wecallemjazzyfact/TinyTapeout-BGR-LDO/docs/analog-specs.md

---
title: Analog Specs :: Quicker, easier and cheaper to make your own chip!
source: https://tinytapeout.com/specs/analog/
snapshot: 2026-07-10
---

[Tiny Tapeout](/) > [Tech specs](/specs/) > Analog Specs

# Analog Specs

## PDK

Tiny Tapeout shuttles use the sky130A, ihp-sg13g2, and gfmcu180D open source PDKs. Make sure you simulate with the correct PDK for your shuttle.

## Analog pins

The analog pins are labeled `ua[0]` through `ua[5]` (ua stands for “user analog”). The number of pins that will actually be connected to pads depends on the number of analog pins that you defined in the `pinout` section in info.yaml (and paid for).

For example, if you purchased two analog pins, only `ua[0]` and `ua[1]` will be connected to the pads. The remaining pins will **not be connected**.

You must use the pins in order, starting from 0.

Even though there are 8 pins in the templates, you can only use the first 6.

If you end up with pins which are not being driven and are floating, please either connect them to GND or use
[`conb`](https://skywater-pdk.readthedocs.io/en/main/contents/libraries/sky130_fd_sc_hd/cells/conb/README.html) cells -
see our guide on [laying out standard cells with Magic](/guides/laying-standard-cells-with-magic/).

## Specifications and limitations - sky130A

The path between the analog pads and your project (the ua pins) is expected to have the following properties:

* Resistance: < 500 ohm
* Capacitance: < 5 pf
* Max current: 4 mA

You are not allowed to use the **metal 5** layer in your design, as it’s used by Tiny Tapeout’s power grid.

## Pin locations

The pin locations must match one of the [Tiny Tapeout templates](https://github.com/TinyTapeout/tt-support-tools/tree/tt10/def/analog). The templates are available in DEF format, which is compatible with the [Magic VLSI layout tool](http://opencircuitdesign.com/magic/).

The templates include all the eight analog pins, but only the pins that you paid for will be connected to the pads. In addition, the templates also include all the [standard digital pins](/specs/gpio/).

**Important**: Do not leave any floating digital output pins in your design. Connect any unused `uo_out`, `uio_out` and `uio_oe` pins to GND.

## Area - sky130A

* 1x2 tiles = 160x225um
* 2x2 tiles = 334x225um

Note that these are approximate. 3.3v designs are slightly narrower as an additional power FET is required. Make sure to use our templates linked above.

## Power pins

The following power pins are available:

* VGND: Ground rail
* VDPWR: 1.8V digital core voltage
* VAPWR: 3.3V analog supply rail (optional, requires a different template)
* A draw of around 20mA from the power supply will result in a 0.1V drop through the PDN.

Power pins need to be vertical stripes on met4 layer and must adhere to the following rules:

1. Start within the bottom 10 µm of the module and extend at least to the top 10 µm of the module.
2. Minimum width of 1.2 um.
3. Projects utilizing the 3.3V rail MUST use the `tt_analog_*_3v3.def` templates and set `uses_3v3: true` in `info.yaml`.
4. Multiple power pins of each type can be used with varying dimensions as long as the above constraints are met.
5. The actual metal area can be larger or have a different shape, but the area defined as a pin must comply with these constraints.

## Pricing - sky130A

Projects with analog pins must be two tiles high. This means that the minimum price for the area of the project is 140€ (each tile is 70€).

In addition, there is a cost for each analog pin attributable to a given customer (rather than project) on a given shuttle. The price for analog pins is 40€ per pin for the first 2 pins you need on the Tiny Tapeout shuttle, and 100€ per pin for additional pins.

Example:

* You submit a design requiring 1x2 tiles and 2 analog pins. This costs you 220€ (140€ for the tiles, and 80€ for the analog pins).
* You then submit another design on the same shuttle, itself requiring 2x2 tiles and 3 analog pins. This would cost you 580€ (280€ for the tiles, and 300€ for the analog pins).
* i.e. as a customer you are using a total of **5** analog pins on the shuttle.

This price is only for including the design in the shuttle, and does not include the cost of the ASIC, PCB, or shipping.

For more information on pricing, check the [calculator](https://app.tinytapeout.com/calculator?tiles=2&pcbs=1&analog-pins=2).

---

# Instructions for creating and submitting an analog design

These instructions assume you are using the [Magic VLSI tool](http://opencircuitdesign.com/magic/), but you can do the same with Klayout or proprietary tools.

Make sure the version of Magic matches the PDK.

## Create the repository

Start your design from one of the following analog templates - make sure to select the appropriate template for the shuttle you’re targeting:

* [SKY](https://github.com/TinyTapeout/ttsky-analog-template)
* [IHP](https://github.com/TinyTapeout/ttihp-analog-template)

Click on the green “Use this template” button on the top of the page, and select “Create a new repository”.

## Decide on the size of your design

Tiny Tapeout provides templates for custom GDS submissions. These templates include all the required pins on the metal 4 layer. Do not change the pin sizes or positions.

Select your target shuttle below and download a template to use as a starting point for your design.

SKY
IHP

Download: [github.com/TinyTapeout/tt-support-tools/tree/main/tech/sky130A/def/analog](https://github.com/TinyTapeout/tt-support-tools/tree/main/tech/sky130A/def/analog)

The table below shows the available templates:

| Tile size | Filename | Available power supplies | |
| --- | --- | --- | --- |
| 1.8V (VDPWR) | 3.3V (VAPWR) |
| 1x2 | `tt_analog_1x2.def` | ✅ | ❌ |
| `tt_analog_1x2_3v3.def` | ✅ | ✅ |
| 2x2 | `tt_analog_2x2.def` | ✅ | ❌ |
| `tt_analog_2x2_3v3.def` | ✅ | ✅ |

Download: [github.com/TinyTapeout/tt-support-tools/tree/main/tech/ihp-sg13g2/def/analog](https://github.com/TinyTapeout/tt-support-tools/tree/main/tech/ihp-sg13g2/def/analog)

The table below shows the available templates:

| Tile size | Filename | Available power supplies | |
| --- | --- | --- | --- |
| 1.8V (VDPWR) | 3.3V (VAPWR) |
| 1x2 | `tt_analog_1x2.def` | ✅ | ❌ |
| 2x2 | `tt_analog_2x2.def` | ✅ | ❌ |

Larger tiles are not shown in these tables but may be available via the provided link. They follow the same
pattern as the ones mentioned above (i.e. a `_3v3` suffix denotes that VAPWR is available).

An analog project can either be 1x2 or 2x2 tiles large. If you require additional space, you will be
charged as if you had submitted multiple 1x2/2x2 projects separately. Read our [FAQ item](/faq/#what-is-an-analog-slot)
for more info.

## Edit the info.yaml file

It’s important that you are consistent with your naming. The name of the project must match the final GDS and LEF files.

Decide on a name for your module (top cell). The top level module name must start with ’tt\_um\_’, and it must be unique on the shuttle, so we suggest including your github username, e.g. tt\_um\_username\_amazing\_adc.

Edit the `info.yaml` files and the the following properties:

* `top_module` - the name of your top module
* `tiles` - should match your selected template size (1x2 or 2x2)
* `analog_pins` - the number of analog pins you use
* `pinout` - describe the function of each digital / analog pin you use, leave the others empty ("")
* Also fill in the title, author and description fields.

## Edit the verilog stub

This file is used to ‘blackbox’ your design when we integrate it into the Tiny Tapeout shuttle.

Edit `src/project.v` and replace `tt_um_example` with the actual name of your top module.

## Documentation

Edit `docs/info.md` and add a description of your project.

## Draw the rest of the owl

Use your preferred analog flow to design, simulate, layout, extract, LVS and post layout simulate.

A quick way to get started is to use this [tcl script](https://github.com/TinyTapeout/tt-support-tools/blob/tt10/def/analog/magic_init_project.tcl) to draw and label the power ports.

* Download the script
* Edit it to change the module name and configure the pin template and power stripes
* Start Magic and in the tcl command window, write `source magic_init_project.tcl`

## Resources

* Matt’s [Zero to ASIC analog course](https://zerotoasiccourse.com/analog)
* [Drawing an inverter with Magic by Ryan Ridley, Teo Ene, and James E. Stine](https://docs.google.com/document/d/1hSLKsz9xcEJgAMmYYer5cDwvPqas9_JGRUAgEORx1Yw/edit#heading=h.j6gtadx04fb6)
* [Magic cheatsheet by Harald Pretl](https://github.com/iic-jku/osic-multitool/blob/main/magic-cheatsheet/magic_cheatsheet.pdf)
* [Circuit designers etiquette by Harald Pretl](https://github.com/iic-jku/Circuit-Designers-Etiquette)
* [Xschem tutorial by Stefan Schippers (video)](https://www.youtube.com/watch?v=q3ZcpSkVVuc)
* [Analog tutorials by Carsten Wulff (video)](https://www.youtube.com/playlist?list=PLybHXZ9FyEhZfwQTKrLhm6ZZm4IDfGGla)
* [Analog design flow by Carsten Wulff](https://analogicus.com/rply_ex0_sky130nm/tutorial)
* [Analog tutorials by BMinch (video)](https://www.youtube.com/watch?v=iLY49tnKbz4)
* [Magic layout demonstration by Tim Edwards (video)](https://youtu.be/XvBpqKwzrFY?si=AyL0Wr3V4gb954yx)

## Export the GDS and LEF files

Save the resulting GDS file in the `gds` folder, and the LEF file in the `lef` folder. The file names must match your `top_module` property (e.g. `gds/tt_um_example.gds`).

If you use Magic to create your design, make sure to export the LEF file with the “-pinonly” option, e.g.:

```
lef write ../lef/tt_um_project_name.lef -pinonly
```

Export the GDS by running:

```
gds write ../gds/tt_um_project_name.gds
```

If you’re using Magic - do not flatten the .mag file, leave it hierarchical to avoid weird DRC issues.

## Submit your design

Go to [app.tinytapeout.com](https://app.tinytapeout.com) to submit your design.
