wecallemjazzyfact/TinyTapeout-BGR-LDO/designs/bgr_ldo/NOTES.md

# TinyTapeout 아날로그 (BGR + LDO) 제출 하드 제약 사항 및 프로젝트 고정 사양

이 문서는 TinyTapeout 아날로그 프로젝트 규격 문서 및 제출 템플릿에 명시된 하드웨어적/설정상 제약 규칙을 원문 그대로 인용하여 정리하고, 우리 BGR+LDO 프로젝트의 고정 설계 사양을 명시합니다.

---

## 📋 1. 아날로그 제출 하드 제약 사항 표 (원문 인용)

| 제약 사항 구분 | 공식 규격 및 규칙 내용 (원문 그대로 인용) | 출처 파일명 |
| :--- | :--- | :--- |
| **사용 가능 아날로그 핀 `ua[]` 개수 및 순서** | <ul><li>`Even though there are 8 pins in the templates, you can only use the first 6.`</li><li>`You must use the pins in order, starting from 0.`</li><li>`only ua[5:0] can be used`</li><li>`The number of pins that will actually be connected to pads depends on the number of analog pins that you defined in the pinout section in info.yaml (and paid for). For example, if you purchased two analog pins, only ua[0] and ua[1] will be connected to the pads. The remaining pins will not be connected.`</li><li>`If you end up with pins which are not being driven and are floating, please either connect them to GND or use conb cells`</li><li>`Resistance: < 500 ohm`</li><li>`Capacitance: < 5 pf`</li><li>`Max current: 4 mA`</li></ul> | `analog-specs.md`<br>`project.v` |
| **파워 핀 (VDD/VAPWR/VGND) 규칙** | <ul><li>`VGND: Ground rail`</li><li>`VDPWR: 1.8V digital core voltage`</li><li>`VAPWR: 3.3V analog supply rail (optional, requires a different template)`</li><li>`A draw of around 20mA from the power supply will result in a 0.1V drop through the PDN.`</li><li>`Power pins need to be vertical stripes on met4 layer and must adhere to the following rules:`<br>`1. Start within the bottom 10 µm of the module and extend at least to the top 10 µm of the module.`<br>`2. Minimum width of 1.2 um.`<br>`5. The actual metal area can be larger or have a different shape, but the area defined as a pin must comply with these constraints.`</li><li>**[누락 주의]** 원문 규격의 met4 3번, 4번 규칙이 현재 표 인용에서 누락되었으므로, 레이아웃 진입 전에 공식 원문 문서를 파악하여 전체 규칙(1~5번)을 재확보 및 검증해야 함.</li></ul> | `analog-specs.md` |
| **3.3V 레일 사용 조건** | <ul><li>`3. Projects utilizing the 3.3V rail MUST use the tt_analog_*_3v3.def templates and set uses_3v3: true in info.yaml.`</li><li>`uses_vapwr: false # Set to true if your project uses second analog power supply (VAPWR) in addition to 1.8V (VDPWR)`</li><li>**[잠정 결론]** `uses_vapwr: true`로 설정하고 `_3v3.def` 템플릿을 사용함. 공식 문서(`analog-specs.md`)의 `uses_3v3: true` 표기는 구버전 양식으로 추정됨.</li></ul> | `analog-specs.md`<br>`info.yaml` |
| **금지 메탈층 및 파워핀 메탈층** | <ul><li>금지 레이어: `You are not allowed to use the metal 5 layer in your design, as it’s used by Tiny Tapeout’s power grid.`</li><li>파워핀 레이어: `Power pins need to be vertical stripes on met4 layer`</li></ul> | `analog-specs.md` |
| **아날로그 타일 크기** | <ul><li>`An analog project can either be 1x2 or 2x2 tiles large.`</li><li>`Projects with analog pins must be two tiles high.`</li><li>`1x2 tiles = 160x225um`</li><li>`2x2 tiles = 334x225um`</li><li>`3.3v designs are slightly narrower as an additional power FET is required. Make sure to use our templates linked above.`</li><li>**[설계 메모]** 3.3V 전원 사용 시 power FET 레이아웃으로 인해 1x2 타일 가용폭이 $160\,\text{µm}$보다 좁아집니다. 만약 1x2 타일에 아날로그 회로가 전부 올라가지 않는 경우, 2x2 타일 크기 ($334\times225\,\text{µm}$) 사용을 고려해야 합니다.</li></ul> | `analog-specs.md` |
| **디지털 핀 규칙 및 플로팅 방지** | <ul><li>디지털 포트 구성: `input wire [7:0] ui_in`, `output wire [7:0] uo_out`, `input wire [7:0] uio_in`, `output wire [7:0] uio_out`, `output wire [7:0] uio_oe`</li><li>디지털 핀 제약: `Drive strength (source/sink) | 4 mA`, `Maximum output frequency | 33 MHz`, `Maximum input frequency | 66 MHz`, `IO supply voltage * | 1.71V - 5.5V` (`* The demo board provides 3.3V IO supply voltage. The input pins are not 5V tolerant.`)</li><li>플로팅 방지 규칙: `Important: Do not leave any floating digital output pins in your design. Connect any unused uo_out, uio_out and uio_oe pins to GND.`</li></ul> | `analog-specs.md`<br>`project.v`<br>`gpio.md` |
| **info.yaml 필수 키 및 주석 의미** | <ul><li>`title: "" # Project title`</li><li>`author: "" # Your name`</li><li>`description: "" # One line description of what your project does`</li><li>`language: "Analog" # other examples include Verilog, Amaranth, VHDL, etc`</li><li>`clock_hz: 0 # Clock frequency in Hz (or 0 if not applicable)`</li><li>`tiles: "1x2" # Valid values for analog projects: 1x2, 2x2`</li><li>`analog_pins: 2 # Valid values: 0 to 6`</li><li>`uses_vapwr: false # Set to true if your project uses second analog power supply (VAPWR) in addition to 1.8V (VDPWR)`</li><li>`top_module: "tt_um_example" # Your top module name must start with "tt_um_". Make it unique by including your github username:`</li><li>`source_files: # List your project's source files here. Source files must be in ./src and you must list each source file separately, one per line:`</li><li>`pinout: # The pinout of your project. Leave unused pins blank. DO NOT delete or add any pins.`</li><li>`yaml_version: 6 # Do not change!`</li></ul> | `info.yaml` |

---

## 🎯 2. 우리 프로젝트 고정 사양 (Project Specifications)

우리 BGR + LDO 통합 아날로그 IP 프로젝트의 고정 하드웨어 설계 명세입니다.

### 2.1. 1단계/2단계 공정 산포 대응 전략 (2-Stage Variation Mitigation)
* **1차 대응 (Layout Matching):** Common-centroid 매칭 배치, Dummy 소자 가드, Guard-ring 분리 및 웰 격리를 통해 기생 성분 및 레이아웃 불일치를 근본적으로 최소화하는 것을 우선으로 함.
* **2차 대응 (Digital Trimming):** 공정 코너 산포($ss/ff$) 및 오차 증폭기의 정적 입력 오프셋(Input Offset)으로 인한 출력 편차를 제거하기 위해 디지털 트림 회로를 내장함.
* **제어 방식:** 3.3V 아날로그 블록의 면적과 패드 제한을 고려하여 외부 디지털 입력 핀(`ui_in`)을 사용하되, 입력단에 Level Shifter를 추가 장착하여 아날로그 전용 핀 소모를 방지하고 제어함.

### 2.2. BGR (Bandgap Reference)
* **목표 기준 전압 ($V_{ref}$):** $1.2\,\text{V}$ 고정.
* **BGR 코어 정합 저항비:** $R_2 = 2 \cdot R_1$ 준수.
* **최소 동작 전원 전압 ($V_{min}$ 실측):** tt/27 $2.190\,\text{V}$ / ss−40 $2.380\,\text{V}$ / ff125 $2.050\,\text{V}$ ($V_{ref}$ 95% 유지 하한). 내림($3.3 \rightarrow 1.5\,\text{V}$) 및 올림($1.5 \rightarrow 3.3\,\text{V}$) 스윕이 100% 동일하여 히스테리시스 창 없음 (DC 영역에 축퇴 함정 두 안정해 공존 구간 미존재 증명). 최악 코너(ss/−40) 기준 $VAPWR = 3.0\,\text{V}$ 대비 마진 **`+620 mV`** 확보.

#### BGR 설계 목표 스펙
| 스펙 | 목표 | 근거/비고 |
| :--- | :--- | :--- |
| $V_{ref}$ | $1.2\,\text{V}$ | LDO 분압 $R_2=2R_1$ (→ $1.8\,\text{V}$)과 일관 |
| TC ($-40\sim125^\circ\text{C}$) | $< 50\,\text{ppm}/^\circ\text{C}$ (전 코너) | tt: 7.5 ppm/°C, ss: 8.6 ppm/°C, ff: 9.0 ppm/°C (전 코너 균일화 완료) |
| Line regulation | $< 0.5\,\%\text{/V}$ | 0.0834 %/V (실측치, VAPWR 3.0~3.6V) |
| PSRR @DC | $< -40\,\text{dB}$ | cascode + 후단 LDO |
| $I_Q$ (BGR only) | $< 60\,\text{µA}$ | 59.71 µA @tt/27 (실측치, 탭 제외 코어 기준) [1] |
| Startup time | $< \text{수 µs}$, 확정 기동 | 축퇴점 회피 ($V_{min}$ tt 2.190V / ss-40 2.380V) |
| Area (BGR only) | $\le 3000\,\text{µm}^2$ | 1x2에 여유 (미스매치 감축을 위한 면적 4배 스케일링 반영) [2] |

`[1] 개정 사유: TC 최적화 분석 결과 브랜치당 ~10µA의 바이어스 전류가 요구됨에 따라 코어2+출력1+bias1 분기 합산 55µA 소모에, Line Reg 개선을 위한 cascode bias 신규 분기(+1.2µA) 및 core 면적 스케일링에 따른 기생 증가(+3.53µA)가 추가되어 총 59.71µA가 소모됨 (소비전력 197.0µW @3.3V). IB_EA 탭 전류 2.564 µA는 EA 계정으로 이관되며 BGR 블록의 물리 총소모 전류는 62.27 µA.`
`[2] 개정 사유: 몬테카를로 분석 결과 로컬 미스매치(MM)의 분산 기여도가 91.5%로 지배적임을 판명하고, Pelgrom 법칙에 근거해 핵심 트랜지스터(XM_top*, XM3/XM4)들의 면적을 4배(W, L 각각 2배씩) 확장하여 약 +960 µm² 면적이 추가 가산됨.`

#### BGR 설계 결정 사항
* **검증 조건:** 27°C 단일 온도 분석에 그치지 않고, **$-40 / 27 / 125^\circ\text{C} \times \text{코너(ss/tt/ff)}$** 조합 전체로 검증 수행.
* **소자 선택 (Devices):** BGR 코어 mirror는 저전압 고이득 매칭을 위해 **1.8V 소자(`nfet_01v8` / `pfet_01v8_lvt`)**를 사용하고, 3.3V(`VAPWR`)가 직접 인가되는 노드만 thick-oxide인 **`_g5v0d10v5`** 소자 사용.
* **Mirror 설계:** 고정밀 정합 및 미러 계수 안정성을 위해 **$V_{ov} \approx 120\sim150\,\text{mV}$ (저속/고정밀)**, **$L = 0.5\sim1.0\,\text{µm}$**로 설정하여 출력 저항($r_o$) 및 정합성을 개선하고, $W$는 pygmid(gm/Id 툴)를 사용해 역산하여 설계.
* **저항 소자:** 온도 보상 및 정밀도 정합을 위해 BGR 내부 저항($R_1$, $R_6$, $R_7$, $R_L$)은 모두 **`sky130_fd_pr__res_high_po`** 소자로 통일.
* **PNP BJT:** **`pnp_05v5_W0p68L0p68`** 사용. $Q_1 (m=1)$ / $Q_2 (m=8)$ 구조로 배치하며 에미터가 위쪽 노드이고 베이스와 컬렉터는 `VGND`에 접지.
* **참고 문헌/교재:** Razavi (기본 이론 및 원리) + Baker Ch. 20 (구현 및 레이아웃 매칭 기법)

### 2.2.1. BGR TRIM 극성 및 소프트웨어 코드 반전 폐기 (LDO top 하드웨어 반전)
★ **소프트웨어 코드 반전 지시 취소** (REPLY_LDO_TO_BGR_STARTUP_CLAMP §5).
LDO top 에 인버터 4쌍(thin-ox nfet W2/L0.15 + pfet W4/L0.15, VDPWR 급전)이 들어가 하드웨어로 반전합니다. 소프트웨어에서 추가 반전 금지 — 이중 반전 시 ui_in=0000 이 다시 최대 전압이 되어 위험합니다.

* **사유**: TT 멀티플렉서 기본값이 ui_in=0 이고, BGR 극성상 code0 = V_out 최대라 트림 전 기본 상태가 정상상태로 1.95V 초과(ff/27 1.994V). 과도가 아니라 지속 상태이므로 소프트웨어 규약으로 방어 불가 → 하드웨어 반전 채택.
* **확정 매핑** (LDO top 기준, 직관과 일치):
  * ui_in[3:0] = 0000 → gr_core TRIM = 1111 → {out}$ 최소 (1.671 V, 안전 기본값)
  * ui_in[3:0] = 1111 → gr_core TRIM = 0000 → {out}$ 최대 (1.929 V)
  * $
ightarrow$ ui_in 값이 커질수록 {out}$ 증가. 측정 스크립트는 ui_in 0→15 단조 증가 확인.
* **BGR 내부 극성 불변**: gr_core 는 TRIM=1 → 세그먼트 단락 → $ 감소 → {out}$ 감소.

### 2.3. LDO (Low-Dropout Regulator)
* **입력 전압 ($V_{in}$ / $VAPWR$):** $3.3\,\text{V}$ (3.3V analog supply rail).
* **출력 전압 ($V_{out}$):** $1.8\,\text{V}$ 고정.
* **LDO 트림 불요 판정 근거:**
  * BGR $V_{ref}$의 3-sigma 산포($\pm 7.1\%$)가 전체 오프셋을 지배하며, 폐루프 게인 $1.5$를 거쳐 $V_{out}$으로 그대로 전달되므로 BGR의 5-bit 트림이 $V_{ref}$와 $V_{out}$을 동시에 보정합니다.
  * LDO 고유 오차(분압 저항 미스매치 ~$\pm 0.5\%$, EA 정적 오프셋 ~$\pm 1\%$)는 BGR 트림 후 잔여 오차($\pm 0.24\%$)와 RSS 합산 시 약 $\pm 1.2\%$ 수준으로 통상 $\pm 2.0\%$ 스펙 범위에 여유 있게 수용됩니다.
  * 만약 향후 LDO 전용 독립 트림이 요구되더라도, `uio[1:7]` 7개 디지털 IO 핀이 미사용 예비 상태로 보존되어 있어 하드웨어적 유연성을 확보했습니다.
* **최대 부하 전류 ($I_{load, max}$):** $4\,\text{mA}$ (하드웨어 제약 및 패드 와이어 한계 준수).
* **소모 전류 ($I_Q$, LDO 자체):** $\le 10\,\mu\text{A}$ 목표.

#### LDO 설계 목표 스펙 및 물리적 근거

| 파라미터 | 목표 스펙 | 설계 근거 / 비고 |
| :--- | :---: | :--- |
| **Dropout 전압 ($V_{drop}$)** | $\le 200\,\text{mV}$ | 실구동 조건은 $V_{SD} = 1.5\,\text{V}$로 충분한 Saturation 마진 확보 가능. |
| **Line Regulation** | $\le 2.0\,\text{mV/V}$ | $VAPWR = 3.0\text{V} \sim 3.6\text{V}$ 스윕 기준. EA의 높은 DC Gain으로 억제. |
| **Load Regulation** | $\le 2.0\,\text{mV/mA}$ | $I_{load} = 0 \sim 4\text{mA}$ 기준. 전체 전압 변동 $\Delta V_{out} \le 8\,\text{mV}$ 목표. |
| **PSRR @DC / 1kHz / 100kHz** | $\le -60\,\text{dB} / -50\,\text{dB} / -30\,\text{dB}$ | BGR 출력을 1차 필터링하고 EA 루프 이득 및 Compensation 대역 설계로 제거. |
| **위상 마진 (Phase Margin)** | $\ge 60^\circ$ | 무부하($I_{load}=0$)부터 최대 부하($4\,\text{mA}$) 전 구간 루프 안정성 보장. |
| **Transient Response** | Overshoot/Undershoot $\le 100\,\text{mV}$ | $0 \leftrightarrow 4\,\text{mA}$ Step (엣지 $100\,\text{ns}$), $C_L = 100\,\text{pF}$ 및 복구 시간 $< 5\,\mu\text{s}$. |

#### 2.3.1. Pass Device (PMOS) 사이징 및 기생 커패시턴스 분석
* **소자 종류:** Thick-oxide PMOS (`pfet_g5v0d10v5`)
* **사이징 확정:** **`W = 400 µm / L = 0.5 µm`** (Aspect Ratio $W/L = 800$, Multiplier $M = 20$, Finger $W_f = 20\,\mu\text{m}$)
* **물리적 계산 검증:**
  * Saturation 전류 수식: $I_D = \frac{1}{2} \mu_p C_{ox} \frac{W}{L} V_{ov}^2$
  * $\mu_p C_{ox} \approx 30\,\mu\text{A/V}^2$ 대입 시 $I_{load} = 4\,\text{mA}$ 구동에 필요한 Overdrive 전압:
    $$4000\,\mu\text{A} = \frac{1}{2} \times 30\,\mu\text{A/V}^2 \times 800 \times V_{ov}^2 \implies V_{ov} \approx \mathbf{0.577 V}$$
  * 따라서 최대 부하 시 필요한 게이트 바이어스 전압은 $V_G = V_{APWR} - |V_{thp}| - V_{ov} \approx 3.3 - 0.9 - 0.58 = \mathbf{1.82 V}$로, 3.3V 구동 오차 증폭기의 전압 출력 스윙 범위 내에 여유롭게 들어옵니다.
* **게이트 입력 커패시턴스 ($C_{gg}$) 추정:**
  * 산화막 커패시턴스 $C_{ox} \approx 2.3\,\text{fF/\mu m}^2$ (Gate oxide $t_{ox} \approx 15\,\text{nm}$)
  * 채널 면적 $A_g = W \times L = 400 \times 0.5 = 200\,\mu\text{m}^2$
  * 게이트 커패시턴스: $C_{gg, body} = A_g \times C_{ox} \approx 460\,\text{fF}$
  * 기생 오버랩 및 배선 커패시턴스 합산 시 실효 부하 커패시턴스 **$C_{gg, total} \approx \mathbf{0.5\sim0.6\,\text{pF}}$** (EA의 지배적 출력 극점을 형성).

### 2.4. 오차 증폭기 (Error Amplifier - EA) 설계 방침
* **급전 전압:** $VAPWR$ ($3.3\,\text{V}$).
* **구조 제안:** **PMOS 입력 Folded-Cascode 증폭기**
* **입력 공통모드 범위(ICMR) 검증:**
  * $V_{ref} = 1.2076\,\text{V}$에서 입력 PMOS의 소스 노드 전위는 $V_S = V_G + V_{SG} \approx 1.2 + 0.9 + 0.2 = 2.3\,\text{V}$로 바이어스됩니다.
  * 테일 전류원(Tail current source)에 걸리는 전압은 $V_{APWR} - V_S = 3.3 - 2.3 = 1.0\,\text{V}$로, 테일 소자가 포화 영역에 머물기 위한 전압($V_{ov,tail} \approx 0.2\text{V}$) 대비 5배의 전압 헤드룸을 가집니다. 따라서 PMOS 입력단 설계는 지극히 타당합니다.
* **필요 DC 이득 ($A_{EA}$) 계산:**
  * 목표 Load Regulation 사양인 $\le 2\,\Omega$ ($8\text{mV}/4\text{mA}$) 충족을 위해 필요한 Closed-loop 출력 저항 유도:
    $$R_{out, cl} = \frac{R_{out, ol}}{1 + T} \approx \frac{r_{ds, pass}}{T} \le 2\,\Omega$$
  * Pass 소자의 출력 저항 $r_{ds, pass} \approx 2.5\,\text{k}\Omega$ ($I_D = 4\text{mA}, \lambda \approx 0.1\text{V}^{-1}$) 대입 시 필요한 최소 루프 이득:
    $$T \ge \frac{2500\,\Omega}{2\,\Omega} = 1250\ (\approx \mathbf{62\,\text{dB}})$$
  * 루프 이득 수식 $T = A_{EA} \times A_{pass} \times \beta$ 에서 $A_{pass} = g_{m,pass} r_{ds,pass} \approx 14\text{mS} \times 2.5\text{k}\Omega = 35$ ($31\,\text{dB}$), 피드백 계수 $\beta \approx 0.67$ 대입:
    $$A_{EA} = \frac{1250}{35 \times 0.67} \approx 53.4\ (\approx \mathbf{35.6\,\text{dB}})$$
  * Folded-cascode 토폴로지는 통상 **$60\sim80\,\text{dB}$**의 이득을 제공하므로 스펙 마진을 매우 넉넉하게 만족합니다.

### 2.5. 안정도 및 주파수 보상 사전 분석 (Stability & Compensation)
* **극점 (Poles) 이동 분석 ($C_{load} = 100\,\text{pF}$ 기준):**
  1. **무부하 상태 ($I_{load} \rightarrow 0$):** 피드백 전류 $5\,\mu\text{A}$만 흐를 때, $r_{ds,pass} \approx 2\,\text{M}\Omega$.
     * 출력 저항 $R_{out} \approx 2\,\text{M}\Omega \parallel 360\,\text{k}\Omega \approx 305\,\text{k}\Omega$.
     * 출력 극점 $p_{out, noload} = \frac{1}{2\pi R_{out} C_{load}} \approx \mathbf{5.2\,\text{kHz}}$
  2. **최대 부하 상태 ($I_{load} = 4\,\text{mA}$):** 부하 저항 $R_{load} = 450\,\Omega$.
     * 출력 저항 $R_{out} \approx 450\,\Omega \parallel 2.5\,\text{k}\Omega \approx 380\,\Omega$.
     * 출력 극점 $p_{out, fullload} = \frac{1}{2\pi R_{out} C_{load}} \approx \mathbf{4.19\,\text{MHz}}$ (부하 변동에 의해 극점이 **800배 이상 이동**).
  3. **EA 출력 극점:** $p_{EA} = \frac{1}{2\pi R_{out,EA} C_{gg,pass}} \approx \mathbf{16\,\text{kHz}}$ ($R_{out,EA} \approx 20\,\text{M}\Omega, C_{gg} \approx 0.5\text{pF}$).
* **주파수 보상망 제안 (밀러 보상):**
  * 두 극점($p_{out}, p_{EA}$)이 모두 저주파 대역에 인접해 있어 무보상 시 발진이 불가피합니다.
  * Pass 소자의 게이트-드레인 사이에 밀러 커패시터 $C_c$ 및 우반평면 영점(RHP Zero) 제거용 직렬 영점 저항 $R_z$를 삽입합니다.
  * **밀러 캡 크기 ($C_c$):** **`Cc = 12.8 pF`** (대역폭 확보 및 상온 안정성 마진 극대화).
  * **영점 저항 ($R_z$):** 가벼운 부하 조건에서의 위상 지연을 방지하기 위해 $R_z \approx 1/g_{m,pass} \approx 1\sim5\,\text{k}\Omega$ 수준의 가변 또는 고정 Poly 저항을 배치하여 LHP(Left-Half-Plane)로 영점을 이동 및 보상합니다.

### 2.6. 제어 및 모니터링 인터페이스 (PG / EN)
* **EN (LDO Enable 신호):** 외부 디지털 핀 `ui_in[]`을 사용하여 컨트롤. (Level Shifter를 경유하여 3.3V EA 구동부 EN 게이트 전달)
* **PG (Power Good 신호):** LDO 출력이 안정 영역에 도달했음을 알리는 디지털 핀 `uo_out[]`을 통해 전송.

---

## 🛠️ 3. Verification & Layout Lessons Learned (레이아웃 및 검증 교훈)

### 3.1 레이아웃 크기 및 경계 (Boundary) 제약
* **물리적 크기 제약 (3.3V Analog):** 
  * TinyTapeout의 precheck (KLayout Checks 및 Pin check)를 통과하려면 GDS 레이아웃 경계가 DEF 템플릿의 정확한 다이 영역 크기와 일치해야 합니다.
  * 3.3V 아날로그 1x2 타일의 경우, 파워 트랜지스터(Power FET) 배치 공간으로 인해 폭이 다소 좁아져 **정확히 가로 $145.36\,\text{µm}$ (145360 DEF units), 세로 $225.76\,\text{µm}$ (225760 DEF units)** 크기로 맞춰야 합니다.
  * 따라서 레이아웃을 시작할 때 반드시 `tt_analog_1x2_3v3.def` 파일을 Magic으로 읽어(`def read tt_analog_1x2_3v3.def`) 경계(Boundary), Met4 파워 스트라이프 및 핀 위치 프레임을 생성하고 그 내부에서 레이아웃을 수행해야 합니다.

### 3.2 컨테이너 기반 LVS/DRC 검증 실행법
컨테이너 내에서 JKU 제공 레이아웃 검증 도구(`iic-drc.sh`, `iic-lvs.sh`) 및 TinyTapeout `precheck.py`를 실행할 때는, 환경 변수(`$PDK`, `$PDKPATH`)와 실행 파일 경로가 꼬이지 않도록 **반드시 로그인 쉘(`bash -l -c`) 옵션**과 함께 아래의 포맷으로 명령어를 전달해야 합니다.

* **TinyTapeout Precheck 실행 명령어:**
  `precheck.py`는 내부에서 `magic_drc.tcl` 등의 상대 경로 파일을 호출하므로 반드시 `tt/precheck` 폴더로 이동한 후 실행해야 하며, GDS 경로는 절대 경로를 사용하는 것이 안전합니다.
  ```bash
  docker exec -i iic-osic-tools_xvnc_uid_1000 bash -l -c "cd /foss/designs/tt-analog/repos/ttsky-analog-template/tt/precheck && export PDK=sky130A && python3 precheck.py --gds /foss/designs/tt-analog/repos/ttsky-analog-template/gds/tt_um_example.gds --tech sky130A"
  ```

* **JKU DRC (`iic-drc.sh`) 실행 명령어:**
  Magic과 KLayout DRC를 동시에 가동합니다.
  ```bash
  docker exec -i iic-osic-tools_xvnc_uid_1000 bash -l -c "export PDK=sky130A && export PDKPATH=/foss/pdks/sky130A && iic-drc.sh -b -w /foss/designs/designs/bgr_ldo/work /foss/designs/designs/bgr_ldo/layout/tt_um_bgr_ldo.gds"
  ```

* **JKU LVS (`iic-lvs.sh`) 실행 명령어:**
  xschem 회로도(`.sch` 또는 사전 추출된 `.spice`)와 layout GDS를 대조하여 핀 정합성을 확인합니다.
  ```bash
  docker exec -i iic-osic-tools_xvnc_uid_1000 bash -l -c "export PDK=sky130A && export PDKPATH=/foss/pdks/sky130A && iic-lvs.sh -w /foss/designs/designs/bgr_ldo/work -s /foss/designs/designs/bgr_ldo/src/tt_um_bgr_ldo.sch -l /foss/designs/designs/bgr_ldo/layout/tt_um_bgr_ldo.gds -c tt_um_bgr_ldo"
  ```

---

### 3.3 레이아웃 인계 (LVS 결과 및 더미 최종값)

* **LVS 결과**: **Circuits match uniquely** (44/44 소자, 32/32 넷)
* **더미 저항 최종 L (magic 추출값 반영)**:
  * XXDUM_RA1, XXDUM_RA2 : **L=31.49** (구 30.23)
  * XXDUM_RB1, XXDUM_RB2 : **L=58.41** (구 57.15)
* **정정 사유**: 더미는 X Repeat=2(굴곡 1개)인데 N=8 보정식을 쓴 초기값이라 굴곡 고정항 +1.26 µm 가 누락됐다. 실소자는 N=8 보정식이 이미 맞아 무관.
* **전기적 무영향 실측**: 정정 전후 V_ref/IB_EA/I_Q 6자리 불변.

## 📊 4. BGR PNP Core Simulation Results

BGR 설계의 핵심 요소인 BJT 코어 단일 소자의 $V_{BE}$ 전압 특성 및 $1:8$ 소자쌍의 $\Delta V_{BE}$ 전압 특성을 시뮬레이션으로 검증한 실측 결과 기록입니다.

### 4.1. Testbench 1: 단일 PNP $V_{BE}$ 특성 (`pnp_vbe`)
* **시뮬레이션 조건 (Simulation Setup):**
  * **대상 소자 (DUT):** `sky130_fd_pr__pnp_05v5_W0p68L0p68` ($m=1$)
  * **결선 형태:** 다이오드 연결 (Collector와 Base를 모두 `VGND`(= 전역 접지 `0`)에 연결, Emitter를 능동 노드로 활용)
  * **바이어스 공급:** 3.3V DC 전원원($V_1$)을 급전하여, 이상 전류원($I_0$)을 통해 Emitter 단자에 전류를 주입
  * **시뮬레이션 타입:** DC 전류 스윕 (`.dc I0 1u 10u 0.1u`) 및 온도 고정 ($27^\circ\text{C}$)
* **검증 및 측정 결과:**
  * **바이어스 동작점:** 브랜치당 설계 목표 바이어스 전류인 **$I_0 = 3.0\,\text{µA}$**에서 에미터-베이스 다이오드 전압 $V_{BE}$ 측정
  * **측정 전압 ($vbe\_val$):** **$774.05\,\text{mV}$** ($0.774052\,\text{V}$)
* **물리적 의미:**
  * 본 설계의 CTAT(Complementary to Absolute Temperature) 브랜치의 기준 $V_{BE}$ 기저 동작 수준을 정의합니다.

### 4.2. Testbench 2: $1:8$ 매칭 $\Delta V_{BE}$ 특성 (`delta_vbe`)
* **시뮬레이션 조건 (Simulation Setup):**
  * **대상 소자 (DUT):** 
    * `QA` ($m=1$): `pnp_05v5_W0p68L0p68`
    * `QB` ($m=8$): `pnp_05v5_W0p68L0p68`
  * **바이어스 공급:** 각 BJT의 에미터에 독립적인 동일 스펙의 이상 전류원($I_0 = 3\,\text{µA}$, $I_1 = 3\,\text{µA}$)을 배치하여 정전류 공급
  * **시뮬레이션 타입:** 온도 스윕 (`.dc temp -40 125 5`)
  * **수식 정의:** $\Delta V_{BE} = V_{BE1} (m=1) - V_{BE8} (m=8)$
* **검증 및 측정 결과:**
  * **측정 전압 ($dvbe\_27$):** **$53.02\,\text{mV}$** ($5.30196 \times 10^{-2}\,\text{V}$) @ $27^\circ\text{C}$ ($300.15\,\text{K}$)
  * **이론 수식 대조:**
    $$\Delta V_{BE} = V_T \ln(N) = \frac{k T}{q} \ln(8)$$
    $T = 27^\circ\text{C}$ ($300.15\,\text{K}$) 조건 하에:
    $$\Delta V_{BE, \text{이론}} = 25.865\,\text{mV} \times \ln(8) \approx 25.865\,\text{mV} \times 2.07944 \approx 53.78\,\text{mV}$$
    * **오차율:** 실측 시뮬레이션 값($53.02\,\text{mV}$)은 이상 이론 수식 값($53.78\,\text{mV}$) 대비 **$-1.4\%$ 오차** 수준에서 매우 잘 부합합니다.
    * **실효 면적비 ($N_{eff}$):** 
      에미터 주변부 효과(periphery effects) 등으로 인해 실효적으로 결합된 면적비는 **$N_{eff} \approx 7.77$**로 수렴합니다. 따라서 향후 BGR 코어 저항 $R_1$ 계산 등 수식 계산 단계에서는 이론치 대신 **실측 시뮬레이션 값($53.02\,\text{mV}$)**을 사용합니다.
  * **온도 의존성 (PTAT 계수):**
    * 온도 스윕 결과 선형적으로 비례하여 상승하는 PTAT 특성을 보였으며, 시뮬레이션상의 실측 **PTAT 온도 계수는 $+0.176\,\text{mV}/^\circ\text{C}$**로 산출되었습니다. (이론 계수인 $\frac{k}{q}\ln(8) \approx 0.179\,\text{mV}/^\circ\text{C}$와 고도로 부합)

---

## 🛠️ 5. BGR Core TC Optimization Simulation (sim/bgr_core_tb.sch)

* **시뮬레이션 파일:** [sim/bgr_core_tb.sch](file:///c:/Users/aa/Desktop/school/TinyTapeout/designs/bgr_ldo/sim/bgr_core_tb.sch)
* **목표:** PTAT 전류 분지와 CTAT 전류 분지의 합전류($I_{total}$) 온도 계수(TC)의 최소점을 찾아 최적의 온도 보상 저항값($R_6 = R_7$) 확정

### 5.1. 테스트벤치 회로 구성
1. **BGR 코어 코어 루프:**
   * PNP 코어 구성 ($QA (m=1)$ / $QB (m=8)$). Emitter를 위로, Base/Collector를 `VGND`에 접지.
   * $R_1$ 저항 (두 Emitter 노드 사이에 직렬 브릿지로 결선, 값 $17.7\,\text{k}\Omega$ 고정).
   * $R_6, R_7$ 저항 (이상적 SPICE 저항 소자 `res.sym` 사용, 값은 파라미터 `{R7_val}`로 정의).
2. **전류 매칭:**
   * 두 브랜치에 이상적인 독립 전류원 $I_0 = 3\,\text{µA}$, $I_1 = 3\,\text{µA}$를 공급하여 각 브랜치 전류를 강제 매칭함.

### 5.2. 측정 및 스윕 파라미터 조건
* **스윕 파라미터:** 저항 파라미터 $R_{val}$을 **$120\,\text{k}\Omega$ (`dc1`)부터 $240\,\text{k}\Omega$ (`dc7`)까지 $20\,\text{k}\Omega$ 간격**으로 스윕.
* **측정 타겟:** $I_{total} = I_{PTAT} + I_{CTAT} = I(R_1) + I(R_6)$ 
* **분석 종류:** 온도 스윕 (`.dc temp -40 125 5`) 연동 루프 시뮬레이션

### 5.3. 시뮬레이션 결과 및 최적 저항값 선정
* **파형 관찰 분석:**
  * 저항값($R_7$)이 증가할수록 CTAT 전류 성분($I_{CTAT} = \frac{V_{BE1}}{R_6}$)의 기여도가 작아집니다. 이에 따라 온도에 비례해 상승하는 PTAT 전류 성분이 전체 전류를 지배하게 되어, $I_{total}$ 파형이 강한 우상향(Positive Slope) 곡선으로 변하는 것을 확인했습니다 (`dc7` 방향).
  * **`dc1` ($R_6 = R_7 = 120\,\text{k}\Omega$) 결과:**
    * 스윕 범위($-40\sim125^\circ\text{C}$) 전체에서 $I_{total}$의 변화량이 단 **$20\,\text{nA}$** ($3.00\,\text{µA} \sim 3.02\,\text{µA}$)에 불과하여 **가장 평탄한 최적의 온도 보상 파형**을 나타내었습니다.
    * 이는 온도 계수(TC) **$\approx 40\,\text{ppm}/^\circ\text{C}$** 수준의 매우 우수한 성능입니다.
* **최적 설계 결정:**
  * BGR Core의 CTAT 저항값은 **$R_6 = R_7 = 120\,\text{k}\Omega$** 부근에서 최적의 TC 특성을 갖습니다.
  * **추가 정밀 튜닝:** 추후 완벽한 포물선 형태의 극점(turnaround point) 매칭을 위해 $100\,\text{k}\Omega \sim 130\,\text{k}\Omega$ 구간에 대해 미세 스윕(Fine Sweep)을 수행하여 더 세밀한 값을 결정할 수 있습니다.

---

## 🛠️ 6. Banba Current-Mode BGR Self-Bias Loop Setup & Verification

* **테스트벤치 파일:** [sim/bgr_core_tb.sch](file:///c:/Users/aa/Desktop/school/TinyTapeout/designs/bgr_ldo/sim/bgr_core_tb.sch)
* **목표:** 이상 전류원이나 외부 강제 소자 없이, 실제 밴드갭처럼 루프 피드백을 형성하여 자율 바이어스(Self-bias) 상태에서 동작 전압 및 전류 매칭을 검증.

### 6.1. 자율 바이어스 이상적 피드백 구성
1. **단방향 PMOS 거울 모사 (Behavioral B-Source):**
   * 양방향 전류 싱크가 가능한 VCCS 대신, 단방향 동작 수식을 갖는 B-source (`B1`, `B2`, `bsource.sym`)을 배치하여 역방향 전류 유입(Degenerate point 고착 원인)을 원천 차단함.
   * `FUNC = "10u * V(V_ctrl) * u(V(V_ctrl))"`
2. **에러 증폭기 피드백 (VCVS):**
   * VCVS (`E1`, `vcvs.sym`)의 증폭도(Gain)를 `1e5`로 상향하여 미세 오차 제거.
   * 입력단으로 `VBE1` 노드와 `net1` 노드의 차전압을 감지하여 출력으로 `V_ctrl` 노드 전압을 자율 조율하게 결선.
3. **스타트업 초기치 설정:**
   * 시뮬레이터가 0V degenerate state(축퇴해)에 수렴하는 현상을 방지하기 위해 `.nodeset v(vbe1)=0.75 v(net1)=0.75 v(v_ctrl)=1.0`을 복원.

### 6.2. 27°C 단일 동작점 (op) 시뮬레이션 결과 검증
* **전압 및 전류 측정 결과:**
  * $V(VBE1) = 777.16\,\text{mV}$ (QA 에미터 전압)
  * $V(net1) = 777.15\,\text{mV}$ (QB 에미터 위 노드 전압)
  * $\Delta V = V(VBE1) - V(net1) = \mathbf{7.64\,\text{µV}}$ (Virtually 0V, 완벽한 전압 매칭 확인)
  * $V(V\_ctrl) = 763.91\,\text{mV}$ ➜ 총 브랜치 공급 전류는 **$7.639\,\text{µA}$**
* **내부 분지 전류 계산:**
  * $I(R_6)$ CTAT 전류: $777.16\,\text{mV} / 180\,\text{k}\Omega \approx \mathbf{4.32\,\text{µA}}$
  * $I(R_1)$ PTAT 전류: $(777.15\,\text{mV} - V_{BE8}(718.36\,\text{mV})) / 17.7\,\text{k}\Omega \approx \mathbf{3.32\,\text{µA}}$
  * 합산 전류: $I_{total} = I(R_1) + I(R_6) \approx \mathbf{7.64\,\text{µA}}$
* **결론:** 합산 전류와 피드백이 공급하는 전류가 완벽히 $7.64\,\text{µA}$로 일치하며, 0V 축퇴 상태를 탈출하여 정상적인 Banba current-mode 활성 영역 동작점에 완벽히 수렴하였습니다.

### 6.3. 자율 바이어스 루프 미세 튜닝 (Fine Sweep) 결과
* **스윕 조건:** $110\,\text{k}\Omega \sim 130\,\text{k}\Omega$ 범위에서 $3\,\text{k}\Omega$ 간격으로 미세 스윕 수행.
* **측정 결과:**
  * **`dc5` ($R_6 = R_7 = 122\,\text{k}\Omega$):** 전체 온도 영역($-40\sim125^\circ\text{C}$)에 걸쳐 합산 전류 $I_{total} \approx 9.68\,\text{µA}$ 선상에서 가장 완벽한 수평(Zero-TC) 곡선 형성.
  * `dc1`~`dc4` ($110\text{k}\sim119\text{k}$): 약한 CTAT 성분(우하향 곡선) 잔존.
  * `dc6`~`dc7` ($125\text{k}\sim128\text{k}$): 약한 PTAT 성분(우상향 곡선) 발현.
* **최종 설계 타겟 확정:**
  * 이상적인 자율 바이어스 루프 상태에서의 최적의 $R_6, R_7$ 값은 **$122\,\text{k}\Omega$** 입니다.
  * **설계 실무 반영:** 실제 Active Cascode PMOS Mirror 소자(`pfet_01v8_lvt`)의 채널 길이 변조 효과 및 레이아웃 상의 **단위 저항(Unit Resistor, e.g. $20\,\text{k}\Omega$ 단위)** 정수배 정합 제약을 고려하여, 이상 소자 상태의 미세 스윕은 본 단계에서 성공적으로 마무리하고 해당 값을 Typical Baseline으로 확정합니다.

### 6.4. 확정 회로 상태 (Confirmed Circuit State)
Milestone 10 완료 시점 기준, 검증을 통과한 Startup 회로, BGR 코어 및 IB_EA 탭의 확정 소자 사양입니다.

* **BGR 코어 핵심 능동 소자 (미스매치 억제를 위한 4배 스케일링):**
  * `XM_top1/2/5` (PMOS 전류 거울): `pfet_g5v0d10v5` $W = 20.0\,\mu\text{m} / L = 4.0\,\mu\text{m}$ ($mult = 4$)
  * `XM3/XM4` (NMOS 등화쌍): `nfet_g5v0d10v5` $W = 20.0\,\mu\text{m} / L = 4.0\,\mu\text{m}$ ($mult = 2$, 벌크: `VGND` 포트)
* **BGR 코어 Active Mirror Cascode 및 Bias 회로:**
  * 등화쌍 차폐 Cascode (`XM3c/XM4c`): `nfet_g5v0d10v5` $W = 10.0\,\mu\text{m} / L = 2.0\,\mu\text{m}$ ($mult = 2$, 벌크: `VGND` 포트)
  * Cascode Gate Bias 브랜치:
    * `XM_cn_mir` (상단 PMOS 미러): `pfet_g5v0d10v5` $W = 10.0\,\mu\text{m} / L = 2.0\,\mu\text{m}$ ($mult = 1$, 게이트: `V_gate_top`)
    * `XM_cn_d2/d1` (NMOS diode 2단): `nfet_g5v0d10v5` $W = 2.0\,\mu\text{m} / L = 2.0\,\mu\text{m}$ ($mult = 1$, **벌크: `VGND` 정정 완료**)
    * `R_cn` (GND 기준 저항): `res_high_po_0p69` $L = 91.5\,\mu\text{m}$ (실효 저항값 $\approx 45.7\,\text{k}\Omega$)
* **EA 바이어스 탭 소자 (`IB_EA`):**
  * `XXM_tap_top`: `pfet_g5v0d10v5` $W = 20.0\,\mu\text{m} / L = 4.0\,\mu\text{m}$ ($n_f=1, m=1$, 게이트: `V_gate_top`, 소스/벌크: `VAPWR`)
  * `XXM_tap_casc`: `pfet_g5v0d10v5` $W = 10.0\,\mu\text{m} / L = 2.0\,\mu\text{m}$ ($n_f=1, m=1$, 게이트: `V_bias_p`, 소스: `net_tap`, 벌크: `VAPWR`)
* **Startup 회로 (4소자 최종 사이징):**
  * PMOS 감지단 (`XM_su1a/b/c`): `pfet_g5v0d10v5` $W = 0.42\,\mu\text{m} / L = 20.0\,\mu\text{m}$ 3개 직렬 스택 (게이트: `V_bias_n`, 소스/벌크: `VAPWR`)
  * NMOS 풀다운 (`XM_pd`): `nfet_g5v0d10v5` $W = 12.0\,\mu\text{m} / L = 2.0\,\mu\text{m}$ 단일 소자 (게이트: `VBE1` — 감지점)
  * 기동 NMOS 스위치 (`XM_su_n1`): `nfet_g5v0d10v5` $W = 1.0\,\mu\text{m} / L = 2.0\,\mu\text{m}$ (게이트: `sense_out`)
  * 전류 제한 NMOS 다이오드 (`XM_su_n2`): `nfet_g5v0d10v5` $W = 1.0\,\mu\text{m} / L = 2.0\,\mu\text{m}$ (다이오드 결선)
* **스키매틱-레이아웃 이원화 설계 방침:**
  * **방침:** "스키매틱 = 단일 심볼(보정 L), 레이아웃 = 2.95k 유닛 (W0.69/L2.79) 어레이, LVS 는 저항값 매칭"
  * **보정 L 계산 수식:**
    * $W = 0.69\,\mu\text{m}$ 기준 ($R_{sheet} = 491.36\,\Omega/\mu\text{m}$, $R_{con} = 389.90\,\Omega$, $L_{unit} = 4.416\,\mu\text{m}$):
      $$L_{total} = N \times 4.416 + (2N - 2) \times 0.79351\,\text{[µm]}$$
    * **$R_1$** (PTAT, 6 유닛): $L_{total} = \mathbf{34.431\,\mu\text{m}}$ ($17.70\,\text{k}\Omega$)
    * **$R_6, R_7$** (CTAT, 41 유닛 - **N=41 최적화**): $L_{total} = \mathbf{244.537\,\mu\text{m}}$ ($120.95\,\text{k}\Omega$)
    * **$R_2$** (Output, 41 유닛): $L_{total} = \mathbf{244.537\,\mu\text{m}}$ ($120.95\,\text{k}\Omega$)
  * **스위치 단락 제약:** 직렬 트림 스택 단락 오차 1% 미만 조건 충족을 위해 스위치 $\frac{W}{L} \ge 860$ ($W = 430\,\mu\text{m} / L = 0.5\,\mu\text{m}$) 설계 적용.

### BGR MC 5회 종합 및 Pooled $\sigma$ 유지 근거

BGR MC 5회 실측 결과 (전부 $n=100$, MM+PR, tt/27°C):
- 면적 스케일링 후: $\sigma = 2.21\%$
- IB_EA 탭 추가 후: $\sigma = 2.38\%$
- 벌크 수정 후: $\sigma = 2.06\%$
- 트림 스위치 적용 후: $\sigma = 2.38\%$
- **R6/R7 2분할 후**: **$\sigma = 2.02\%$**

★ **분석 판정**: 다섯 회차 전부 동일 분포입니다. $n=100$에서 $\sigma$ 추정량의 표준오차가 $\pm 0.16\%p$이며 $2.02 \sim 2.38\%$는 그 표준오차 범위 안입니다. **분할이 $\sigma$를 개선한 것이 아닙니다** — 랜덤 미스매치는 총 면적에 의존하고, 분할은 면적 합을 바꾸지 않습니다. 분할이 개선하는 것은 계통 구배(공통중심 배치)뿐입니다.
$
ightarrow$ 설계 기준 **pooled $\sigma = 2.22\%$, $\pm 3\sigma = \pm 6.66\%$**를 유지합니다. 트림 창 $\pm 7.2\%$가 커버합니다.

### 6.5. 몬테카를로 분석 및 트림 사양 재검증 (Monte Carlo & Trim Spec)

| 회로 상태 | 측정 $N$ | $\sigma(V_{ref})$ | MC Mean ($V_{ref}$) | 비고 |
| :--- | :---: | :---: | :---: | :--- |
| **1. 면적 스케일링 직후** | $100$ | `2.21 %` | `1.19197 V` | $W\cdot L$ 4배 스케일업 반영 |
| **2. IB_EA 탭 추가 후** | $100$ | `2.38 %` | `1.19237 V` | $\sigma(IB\_EA) = 2.53\%$, $\text{corr} = +0.772$ |
| **3. 벌크 결선 수정 후** | $100$ | `2.06 %` | `1.19678 V` | `cn_d1/d2` 벌크 $\rightarrow$ `VGND` 정정 |
| **종합 통계 판정** | **Pooled** | **`2.22 %`** | **`1.1937 V`** | **$\pm 3\sigma = \pm 6.66\%$** |

* **통계 판정 각주**:
  * $N=100$에서 $\sigma$의 표준오차(SE)는 $\sigma \times 7.1\% \approx 0.16\%p$입니다. 3회 측정치($2.21\%, 2.38\%, 2.06\%$)는 평균 $2.22\%$ 주위 $\pm 0.16\%p$ ($1\,\text{SE}$) 이내에 위치하므로 통계적으로 동일한 분포이며, 탭 추가 및 벌크 정정 등의 회로 변경이 $\sigma$에 유의미한 변동을 주지 않았음(F-검정 기각 불가)을 입증했습니다. 따라서 설계 기준은 **pooled $\sigma = 2.22\%$ ($\pm 3\sigma = \pm 6.66\%$)**를 적용합니다.
  * MC Mean($1.1937\,\text{V}$)이 공칭 실측치($1.186591\,\text{V}$)보다 약 $+0.6\%$ 높게 형성되는 현상은 회로 비선형 응답에 따른 자율 표류로, 디지털 트림 튜닝 중심점은 공칭이 아닌 **MC Mean ($1.1937\,\text{V}$)**에 맞춰 정렬해야 합니다.

---

### 2.5. 폐기 수치 명시 (인용 금지 목록)

아래 항목들은 설계 검증 과정에서 폐기된 수치들이므로 향후 문서 작성 및 계산 시 인용을 엄금합니다.

1. **유닛 직렬 TC 탐색 결과 전체** (8:55 $7.0\,	ext{ppm/°C}$ / 10:69 $11.2\,	ext{ppm/°C}$ / 블록 $14.8\,	ext{ppm/°C}$ 등):
   - 유닛 셀 어레이 전제였으나 서펜타인 배치를 채택함에 따라 무효화됨.
2. **초기 직렬 시뮬레이션 $99 \sim 147\,	ext{ppm/°C}$**:
   - 노드 충돌 버그에 의한 실측 아티팩트이므로 절대 인용 금지.
3. **"유닛 실효 면적 $5.85\,\mu	ext{m}^2$"**:
   - 레이아웃 측 폐기 통보 (정정 실효 면적 $6.129\,\mu	ext{m}^2$).
4. **폴리 TC1 단독값 $+514\,	ext{ppm/°C}$**:
   - 컨택 헤드가 혼입된 실효값이었으므로, 헤드와 몸통을 분리한 **2성분 모델**(몸통 $545.3\,	ext{ppm/°C}$, 헤드 $120.6\,	ext{ppm/°C}$)로 대체됨.

## 📝 7. To-Do / Open Issues (확인필요 사항)

* [x] **[Step 2.7] 실저항 소자 교체 및 특성 재스윕:**
  * 실물 저항 교체 및 $N=41$ 최적화로 $6.1\,\text{ppm}/^\circ\text{C}$ 확보 완료.
* [x] **[Step 2.8] BGR 몬테카를로 재실행 및 트림 설계 확정:**
  * 면적 스케일업 및 IB_EA 탭 적용 후 몬테카를로 산포 재실측 완료 ($\sigma = 2.22\%$, $\pm 3\sigma = \pm 6.66\%$).
  * MC Mean $1.1937\,\text{V}$를 중심 코드에서 $1.200\,\text{V}$로 이동하기 위해 $R_2$ 중심치 = $41 \times (1.2 / 1.1937) = \mathbf{41.22\,\text{유닛}}$ 설정.
  * $\pm 3\sigma = \pm 6.66\%$ 커버 필요 범위 = $R_2$ $38.65 \sim 44.16\,\text{유닛}$ (전체 스팬 $5.51\,\text{유닛}$).
  * **★ 트림 사양 정정 확정 (저항 정정 모델 반영):**
    * $R_2$ 중심치 = **$116,308\,\Omega$** (MC mean $1.1937 \rightarrow 1.200\,\text{V}$ 보정), 스팬 $= \mathbf{15,492\,\Omega}$ ($\pm 6.66\% = \text{MC } 3\sigma$).
    * **5-bit 단순 분할**: $\text{LSB} = 15,492 / 31 = 499.7\,\Omega < \text{하한 } 525.70\,\Omega$ (2헤드 기생) $\rightarrow$ 구현 불가능 판정 유효 (정정 모델로도 4.9% 부족).
    * **4-bit 0p69 확정**: $\text{LSB} = 15,492 / 15 = 1032.8\,\Omega = \text{헤드 } 525.7 + \text{본체 } 507.1\,\Omega$ ($L=1.077\,\mu\text{m}$, 실측 $1032.94\,\Omega$ 확인).
      * $V_{ref}$ LSB $= 0.89\%$ ($10.6\,\text{mV}$), $V_{out}$ LSB $= 16.0\,\text{mV}$.
      * 전코드 $V_{out}$ 범위: $1.7306 \sim 1.8694\,\text{V}$, 트림 후 잔여 오차 $\pm 0.45\%$ ($V_{out} \pm 8.0\,\text{mV}$)로 $\pm 2.0\%$ 스펙 완벽 수용.
      * 헤드 비중 51% 우려 철회: 컨택 공정 변동 $\pm 5\%$ ($3\sigma$) $\rightarrow$ LSB $\pm 2.5\%$ $\rightarrow V_{ref}$ 오차 $0.022\%$로 무시 가능.
      * 광폭 폴리(`2p85`/`5p73`) 미사용: 메인 $R_2$와 TC·산포 특성이 달라 비율 제어가 악화되므로 단일 `0p69` 통일 확정.
  * **[신규 Open Item] 레이아웃 양자화 발산 (D12):**
    * 스키매틱 저항 치수($R_1 = 6.425\,\mu\text{m} / R_2 = 44.405\,\mu\text{m}$)가 정정 유닛($2605.5\,\Omega$) 기준 비정수임. 정수 체인 시 물리 저항비 $6.8333$ vs 스키매틱 $6.911 \rightarrow -1.12\%$ 편차 발생하여 TC 미검증 지점 이동.
    * 3가지 안(1안: 정수 체인 + N 재스윕, 2안: $R_2/R_6/R_7$ 3벌 + $R_1$ 단일, 3안: 유닛 재정의) 비교 후 트림 태스크에서 판정. 현 스키매틱 동결.

* [ ] **[Step 2.9] LDO 오차 증폭기(EA) 연동 및 보상망 설계:**
  * PMOS 입력 Folded-Cascode 증폭기 및 Miller 보상 커패시터($C_c = 2.72\,\text{pF}$), 영점 제거 저항($R_z$) 상세 설계.

---

## 🔌 8. Task 6 통합 인터페이스 (LDO와 동결 확정)

* **`bgr_core` 핀 포트 (8핀 확정):**
  * 포트 구성: `.subckt bgr_core VAPWR VREF_LOW IB_EA TRIM0 TRIM1 TRIM2 TRIM3 VGND`
  * ★ `VGND`가 맨 뒤로 이동함 (이전 임시 구성 `...VGND TRIM0...`에서 확정 포트로 변경).
  * 계층 심볼: `bgr/bgr_core.sym` (8핀), 신규 `bgr/trim_sw.sym` (13핀, `nfet_01v8` 4개).
  * 핀 매핑: `TRIM[3:0]` ↔ `ui_in[3:0]`, `ua[1]` = VDDC ($V_{out}=1.800\,\text{V}$) 트림 기준.
* **E6 게이트 클램프 회로 (C안 확정):**
  * LDO가 $V_{NB1}$ 전위($> \approx 0.9\,\text{V}$)를 자체 판정하여 thick-oxide 다이오드 2단으로 클램프 구현.
  * A안(`sense_out` 재사용) 기각 — 극성 반대, 판정 시점 이름 불일치, 고임피던스 문제.
  * `sense_out` 노드 개명 안 함 (정의 명시로 대체: startup kick enable, 미기동 시 HIGH).
* **`VREF_LOW` 순수 출력 노드 무섭동 보증:**
  * `XXM_bot5` 드레인 + `XR2`만 연결된 순수 출력 노드로 피드백 경로 없음 $\rightarrow$ $565.3\,\text{fF}$ 부하 인가 시에도 BGR 루프 안정도 영향 무.
  * 통합 사전 검증: LDO 실부하(nfet W10/L20 다이오드 + $565.3\,\text{fF}$) 인가 시 $V_{NB1} = 1.11196\,\text{V}$로 LDO 실측치($1.111965\,\text{V}$)와 6자리 일치. startup 및 $V_{alive}$ 불변.
* **$I_Q$ 전류 회계 통합 단권화:**
  * BGR 코어($59.71\,\mu\text{A}$, 탭 제외) + LDO EA($33.33\,\mu\text{A}$, 탭 1q 포함) + 분압기($46.06\,\mu\text{A}$) = **`139.10 µA`**.
  * Power-Good (PG) 1q 추가 시 `141.66 µA` (상한 $150\,\mu\text{A}$ 대비 마진 $8.34\,\mu\text{A}$).
  * *(주: $IB\_EA$ 탭 전류 $2.564\,\mu\text{A}$는 EA 다이오드로 흐르므로 EA 계정에 정산하며 중복 계상 없음).*
* **$V_{out}$ 출력 이원화 기준 정립:**
  * 트림 전: **`1.780 V (±5 mV)`** (통합 #1 정상 수렴 기준: $V_{ref} 1.18659\,\text{V} \times 1.5$).
  * 트림 후: **`1.800 V (±8 mV)`** (LSB $16.0\,\text{mV}$).
* **최상위 통합 (Top Ownership) 및 모델 정정 무결성:**
  * 최상위 칩 통합 소유권은 **LDO**가 담당.
  * 저항 모델 정정은 문서 장부상 교체이며 넷리스트는 기존 그대로 유효하므로 기존 통합 결과 무효화 없음.
* **Power-Good (PG) 모듈 구조:**
  * $VDPWR$ ($1.8\,\text{V}$) 전원 구동, 11유닛 탭 문턱전압 $1.6364\,\text{V}$, $V_{NB1}$ 미러 1q 바이어스.
  * E3 부하 슬루 제약 ($\ge 1\,\mu\text{s}$)이 PG 오검출을 전파 억제함.
* **Soft-Start 불채택:**
  * 인러시 전하량이 $54\,\text{pC}$에 불과하며, 출력 램프 하강/상승은 $V_{ref}$ 기동 시간이 구조적으로 제공함.
* **$C_{byp}$ 기동 상호작용 확인 완료:**
  * `VREF_LOW` 노드에 $C_{byp} = 2.045\,\text{pF}$ ($m=3$) 부하를 직접 연결해도 BGR staircase 기동 파형(`tt` / `ss-40`)이 골든 파형과 100% 일치하며 $V_{alive}$ 3점이 전혀 변하지 않음.
  * 기동 램프 지연 시간상수 $\tau = R_{out} C_{byp} \approx 121\,\text{k}\Omega \times 2.045\,\text{pF} = 248\,\text{ns}$는 BGR 기동 시간축($\mu\text{s}$ 대역) 대비 현저히 작아 기동 루프에 영향을 주지 않음을 확증함.
* **Task 6 통합 최종 실측 성과:**
  * 24개 통합 조건 (코너 $\times$ 온도 $\times$ 부하) 전 영역에서 최악 PM **`59.3°`** (`ll` / 125 °C / $I_{min}$), 최악 GM **`10.1 dB`** (`hh` / −40 °C / 2 mA) 달성.
  * 트림 전 출력 전압 $V_{out} = \mathbf{1.780\,\text{V}}$, 오차 증폭기 하단 바이어스 전위 $V_{NB1} = \mathbf{1.111989\,\text{V}}$로 정합 수렴 완료.

---

## 🎨 9. 트림 레이아웃 고려사항 (Magic 단계)

* **저항 그룹 배치:**
  * $R_1$ ($34.4\,\mu\text{m}$) + $R_6$ + $R_7$ ($244.5 \times 2\,\mu\text{m}$) + $R_2$ 5개 세그먼트를 하나의 서펜타인(serpentine) 어레이로 공통 중심(common-centroid) 배치.
  * $R_6 = R_7 = R_{2,total}$ 1:1:1 매칭이 곡률 보상을 유지하므로, 작은 세그먼트($b_0 \sim b_3$)를 저항 어레이 중앙에 배치하여 에칭 균일도를 확보.
* **미세 세그먼트 유닛 매칭:**
  * $b_0$ ($L = 1.27\,\mu\text{m}$)를 고정부 $XR2fix$ ($L = 229\,\mu\text{m}$)와 동일한 폭 및 방향 유닛의 일부로 그려야 공정 매칭이 유지됨.
* **트림 스위치 (`trim_sw`) 레이아웃:**
  * `trim_sw` (thin-ox)는 저항 어레이 바깥 별도 확산 영역에 배치하며, 공통 substrate tap은 `VGND`에 결합.
  * `n_b0` ~ `n_b3` 스위치 배선은 met1을 사용하여 최대한 짧게 직결 (기생 저항이 LSB 저항에 직접 가산되는 것 방지).
* **레이아웃 양자화 고려:**
  * 스키매틱 저항 치수($R_1 / R_2$ 6.4 / 44.4u)가 정수 유닛이 아님. 정수 체인 구현 시 비율 오차 $-1.12\%$ 발생으로 TC 재검증 필요. $R_2 : R_6 : R_7$ 3벌 동일 + $R_1$ 단일 방식 검토 (트림 창 재계산 필요).

---

## 🛠️ 10. PEX 직접 스윕 기법 (Direct PEX Parameter Sweep Technique)

레이아웃 파라미터를 바꿔 회로를 최적화할 때, 스키매틱 모델로 스윕하면 PEX 추출 후 최적점이 이동하여 레이아웃을 두 번 수정하게 되는 문제가 발생한다. PEX 넷리스트에서 해당 소자의 파라미터를 직접 스윕하면 이러한 재작업을 방지할 수 있다.

### 10.1. 전제 조건
Magic `ext2spice` 추출 시 PDK 소자가 서브회로 인스턴스로 유지되는 경우
(예: `X67 net1_t1 VBE8 VGND_t67 sky130_fd_pr__res_high_po_0p69 l=34.45`)
$\rightarrow$ 이 `l` 값만 변경하면 컨택 저항(Contact R), 배선 저항, 기생 용량(C)은 실제 추출된 수치 그대로 유지된다.

### 10.2. 실행 절차
1. **대상 소자 인스턴스 검색**: PEX 넷리스트에서 변경할 대상 소자를 식별 (`grep '^X.*모델명'`)
2. **PEX 사본 생성**: 해당 `l` / `w` 값만 치환한 PEX 넷리스트 사본을 N개 생성
3. **시뮬레이션 수행**: 각 사본에 래퍼(Wrapper)와 Testbench(TB)를 결합하여 시뮬레이션 실행
4. **★ 실측 검증**: 기존 PEX 결과가 원본 값에서 정확히 재현되는지 먼저 확인

### 10.3. 실적 (R1 TC 최적화 사례)
* **스키매틱 + 컨택 모델 예측**: $12.05\,\text{ppm}/^\circ\text{C}$ (PEX 실측 $10.9\,\text{ppm}$, 오차 $1.15\,\text{ppm}$)
* **PEX 직접 스윕**: 원본 값에서 $10.85\,\text{ppm}/^\circ\text{C}$로 PEX 실측을 정확히 재현.
* **최적점 확정**: $L=34.25\,\mu\text{m}$에서 최소점 $\mathbf{6.13\,\text{ppm}/^\circ\text{C}}$ 확정 $\rightarrow$ 레이아웃 재작업 **1회로 종료**.

### 10.4. 한계 및 고려 사항
* 소자 치수 변경에 따른 배선 길이의 미세 변화(수십 $\text{m}\Omega$)는 반영되지 않으나, 영향이 미미하여 무시 가능하다.
* 소자가 기본 저항(`R`)으로 완전 분해(Flatten)된 경우, 소자 몸통 성분만 선별하여 스케일링해야 하므로 가공 방식이 복잡해진다.

---

## 📐 11. 레이아웃 인계 규율 (LVS / 더미 / DRC / PEX)

### 11.1. LVS 골든 넷리스트 생성 규율
* **`mult=1` 자동 제거 필수**: xschem에서 "top level is a .subckt" 체크 후 추출 시, 아래 `sed` 명령을 실행하여 `mult=1` 속성을 전면 제거해야 한다:
  ```bash
  sed 's/\(res_high_po_[0-9]*p[0-9]* L=[0-9.]*\) mult=1/\1/g' bgr_core.spice > bgr_core_lvs.spice
  ```
  * **이유**: Netgen이 "No property mult found" property error를 낸다. xschem 심볼 템플릿에 `mult=1`이 고정되어 있어 인스턴스에서 삭제해도 재추출 시 복원됨.
  * ★ 넷리스트 재생성 시 반드시 `sed` 명령을 재실행할 것.
  * ★ TB(Testbench) 파일은 `.subckt` 체크 해제, 서브회로 셀 파일은 체크하여 목적에 맞게 추출.
  * ★ Netgen의 property cutoff 오차 허용 한계는 **1%**이다. 1% 미만의 치수 차이(예: $R_1$ $34.45\,\mu\text{m}$ vs $34.29\,\mu\text{m} = 0.46\%$ 차이)는 LVS를 그냥 통과하므로, **LVS 통과가 시뮬레이션 일치를 보장하지 않는다.** 스케매틱 변경 시 골든 넷리스트를 반드시 갱신해야 한다.

### 11.2. 더미 소자(Dummy Devices) 배치 규율
* **전위차 0 보장**: 더미 소자의 전 단자를 동일 전원/접지에 단락시켜 전위차를 0으로 만든다 ➔ 전류 소모 및 접합 용량 기여가 수학적으로 0임이 보장된다 (실측: 더미 추가 전후 $V_{ref}, I_Q, IB_{EA}$ 6자리 동일).
* **스키매틱 명시 목적**: 더미 개수를 정량 문서화하고, LVS에서 구조를 검증하며, PEX 추출 시의 넷리스트 불일치를 방지함.
* **규약**: `XDUM_` 접두사 사용 / 더미 저항은 양단을 `VGND`에 단락 (플로팅 엄금) / 개수가 많을 경우 `m=N` 단일 인스턴스로 작성 가능 (Netgen 병렬 자동 병합).

### 11.3. MOS `nf` (Fingers) 제약
* `nf >= 2` 배치는 물리적으로 불가능하다 (확산 스트립 폭 $0.23\,\mu\text{m} < \text{via1 } 0.26\,\mu\text{m}$, 게이트 컨택 이격 여유 $0.025\,\mu\text{m} < \text{met1.2 } 0.14\,\mu\text{m}$).
* **규율**: `m=N` 사양은 **`nf=1` 유닛 소자 N개를 개별로 배치**하는 방식을 적용하며, 스키매틱에서도 `nf=1, m=N` 형태를 엄격히 유지한다.

### 11.4. Magic DRC 모드 규율
* ★ 반드시 **`drc style drc(full)` + `drc euclidean on`** 모드로 검증한다.
* 기본 모드인 `drc(fast)`에서는 Latch-up(`LU.2`, `LU.3`), `diff/tap.18,20`, `rpm.1a` 등이 검출되지 않는다. TT 공식 Precheck는 KLayout FEOL 기준이며 예외 웨이버가 없다.
* *실측 사례*: `fast` 모드에서 clean 판정을 받았던 BGR 코어에서 `full` 모드 전환 후 `LU.2` 88건, `LU.3` 32건 등이 검출되어 전면 수정을 수행함.

### 11.5. PEX 추출 및 산출물 처리 주의 사항
1. **노드명 치환 시 저항/용량 값 필드 보호**: 점 노드 치환 스크립트 실행 시 저항/용량 값 필드를 절대 건드리면 안 된다 (`10079.4 -> 10079_4` 치환 시 회로 특성 전면 파괴).
   * *실측 사고*: $I_Q$가 정상의 3배($190.5\,\mu\text{A}$)로 튐. 검증 명령 `grep -cE '^[RC][0-9]+ [^ ]+ [^ ]+ [0-9]+_[0-9]'` 실행 결과가 0이어야 함.
2. **$I_Q$ 1차 관문 검증**: PEX 넷리스트 정상 여부의 가장 빠른 검증 지표는 소모 전류 $I_Q$이다. 스키매틱 대비 $\pm 10\%$ 범위를 벗어나면 PEX 넷리스트 구성을 의심해야 한다.
3. **★ 래퍼 포트 순서 수동/자동 대조**: PEX 재추출 시 `.subckt` 라인의 핀 순서가 변경될 수 있다. 순서가 어긋나도 ngspice 시뮬레이션은 에러 없이 오동작 결과만 낸다 (실측 사례: `IB_EA` 핀이 4번째에서 맨 뒤로 이동했는데 래퍼가 옛 순서를 유지하여 결선이 한 칸씩 밀림 ➔ $V_{ref}=1.112\,\text{V}$, $i(vload)=0$ 산출).
4. **Flatten 필수**: 계층(Hierarchical) 상태에서의 R+C 추출은 의미 있는 결과를 보장하지 않으므로 R+C 추출 시 `flatten` 작업이 필수적이다 (Magic 개발자 확인).
5. **Xschem 심볼 캐시 방지**: 하위 셀 수정 후 상위 디렉터리에서 스키매틱을 열면 이전 심볼이 로드될 수 있으므로, Xschem을 완전히 종료 후 재기동하거나 하위 셀 디렉터리에서 먼저 오픈한다.

---

## 🚫 12. 절대 인용 금지 목록 (Obsolete & Invalid Data Ledger)

아래 항목들은 과거 잘못된 전제, 노드 충돌 버그, 파싱 오류로 산출된 폐기 수치들이므로 **이후 문서 및 설계 판단 시 절대 인용을 금지**합니다.

1. **유닛 직렬 TC 탐색 결과 전체** (`8:55` 7.0 ppm, `10:69` 11.2 ppm, 블록 14.8 ppm 등): 유닛 셀 어레이 배치를 전제로 수행되었으나, 최종 레이아웃이 서펜타인(serpentine) 구조로 확정됨에 따라 전면 무효화됨.
2. **초기 직렬 시뮬레이션 TC 수치 ($99 \sim 147\,\text{ppm}/^\circ\text{C}$)**: 스파이스 연속행 파싱 실패에 따른 노드 충돌 버그 산물.
3. **손상된 PEX 시뮬레이션 결과** ($I_Q = 190.5\,\mu\text{A}$, $\text{TC} = 170.7\,\text{ppm}/^\circ\text{C}$, $V_{ref} = 1.219814\,\text{V}$): 점 노드 치환 스크립트가 저항/용량 값의 소수점까지 밑줄로 바꾼 버그의 결과.
4. **"유닛 실효 면적 $5.85\,\mu\text{m}^2$"**: 레이아웃 실측 폐기 통보 수치 (실측 정정치: $6.129\,\mu\text{m}^2$).
5. **폴리 TC1 단독값 $+514\,\text{ppm}/^\circ\text{C}$**: 헤드 저항 성분이 혼입된 실효값임. 2성분 모델($\text{TC}_{\text{body}}=545.3$, $\text{TC}_{\text{head}}=120.6$)로 대체함.
6. **코너 증분 1차 수식 ($l = N \cdot L + (N-1) \times 0.1927\,\mu\text{m}$)**: N에 따라 굴곡 증분의 부호가 변동함이 밝혀져 폐기함.
7. **해석적 배선 저항 예측값** (P1 27.24 Ω, P2 12.53 Ω 등): 폴리 컨택 저항($50.67\,\Omega$/단자)이 누락되어 과소평가된 수치임. PEX `extresist` 추출값이 정본임.
8. **BGR 면적 출처 불분명 언급** ("$60 \times 90 = 5,400\,\mu\text{m}^2$", "$\sim 4,300\,\mu\text{m}^2$"): 출처 미상의 수치임. Bottom-up 실측 견적치($6,600 \sim 7,400\,\mu\text{m}^2$)가 정본임.
9. **$R_1 = 34.45\,\mu\text{m}$ 시절 측정값 전체** ($\text{TC} = 10.85\,\text{ppm}/^\circ\text{C}$, $V_{ref} = 1.20471\,\text{V}$ 등): $L = 34.29\,\mu\text{m}$ PEX 최적화 수치($\text{TC} = 6.70\,\text{ppm}/^\circ\text{C}$, $V_{ref} = 1.20682\,\text{V}$)로 전면 대체됨.
