wecallemjazzyfact/TinyTapeout-BGR-LDO/designs/bgr_ldo/REFERENCE_NOTES.md

# REFERENCE_NOTES - Reference Project Analysis

This document summarizes the analysis of three reference TinyTapeout analog projects, highlighting their device selection, passive component sizes, and submission configurations.

---

## 1. Reference Projects Overview & Metadata

| Project / Author | Repository URL | Source Files |
| :--- | :--- | :--- |
| **Current-Mode Bandgap Reference**<br>Author: Christoph Weiser | [github.com/christoph-weiser/tt10-vref](https://github.com/christoph-weiser/tt10-vref) | - Layout: `gds/tt_um_cw_vref.gds`<br>- Verilog Top: `src/project.v`<br>- Configuration: `info.yaml` |
| **LDO BG IREF OSC**<br>Author: Lukas Baumann | [github.com/devstdin/tt08-ldo-bg-ref-osc](https://github.com/devstdin/tt08-ldo-bg-ref-osc) | - LDO: `tt08/ip/ldo/xschem/ldo.sch` / `ldoota.sch`<br>- BG Ref: `tt08/ip/vthref_tt/xschem/vthref.sch`<br>- Ring Osc: `tt08/ip/riosc/xschem/riosc.sch`<br>- Configuration: `info.yaml` |
| **Analog 8-bit 3.3V R2R DAC**<br>Author: Matt Venn | [github.com/mattvenn/tt08-analog-r2r-dac-3v3](https://github.com/mattvenn/tt08-analog-r2r-dac-3v3) | - R2R: `xschem/r2r.sch`<br>- Driver: `xschem/dac_drive.sch`<br>- Configuration: `info.yaml` |

---

## 2. Analysis Table: Device, Passives & Submission Configuration

| Project | 1) Device Selection (소자 선택) | 2) Passive Component Sizes (수동소자 규격) | 3) Submission & Pin Mapping (제출 및 핀 구성) |
| :--- | :--- | :--- | :--- |
| **tt_um_cw_vref**<br>*(Current-Mode BGR)* | <ul><li>**Thick-Oxide Devices:** Powered directly from `VAPWR` (3.3V). Extracted subcells include `sky130_fd_pr__pfet_g5v0d10v5` (models like `_2E4VHC`, `_KV9UWT`) and `sky130_fd_pr__nfet_g5v0d10v5` (model `_R9GJ5X`) for the analog core and level shifters.</li><li>**BJTs:** Uses the native `sky130_fd_pr__pnp_05v5_W0p68L0p68` BJT (0.68µm x 0.68µm emitter area) in the bandgap core.</li><li>**Control Logic:** Uses 1.8V standard cell digital gates (`sky130_fd_sc_hd` library like `nor2_2`, `buf_1`, etc.) for SPI control.</li></ul><br>*Source: `gds/tt_um_cw_vref.gds` (extracted)* | <ul><li>**Capacitors:** MIM Capacitors (`sky130_fd_pr__cap_mim_m3_1`) with dimensions `w=2000 l=2000` (in lambda units, corresponding to **$10\,\text{µm} \times 10\,\text{µm}$**).</li><li>**Resistors (Core):** `sky130_fd_pr__res_high_po_0p69` with `w=0.69µm` and length `l=3368` lambda (**$16.84\,\text{µm}$**).</li><li>**Resistors (Trim):** `sky130_fd_pr__res_xhigh_po_0p69` with `w=0.69µm` and length `l=618` lambda (**$3.09\,\text{µm}$**) used in `bg_trim_res` ladder.</li></ul><br>*Source: `gds/tt_um_cw_vref.gds` (extracted)* | <ul><li>**info.yaml Config:**</li><ul><li>`tiles: "2x2"`</li><li>`analog_pins: 3`</li><li>`uses_3v3: true`</li></ul><li>**Pin Mappings:**</li><ul><li>`ua[0]`: Buffered output voltage or reference current</li><li>`ua[1]`: External test input voltage</li><li>`ua[2]`: Testbuffer bias current (~5uA)</li><li>`ui[7:0]`: `trim 7` to `trim 0`</li><li>`uo[7:0]`: `muxout 0` to `muxout 7`</li><li>`uio[0]`: Select Vext or Vbg</li><li>`uio[1]`: Select Vbuf or Iout</li><li>`uio[2]`: Enable bandgap core</li><li>`uio[3:6]`: SPI interface (mosi, miso, cs, sclk)</li></ul></ul><br>*Source: `info.yaml`* |
| **tt_um_devstdin_LDO_OSC**<br>*(LDO BG IREF OSC)* | <ul><li>**LDO/OTA (`ldoota.sch`):** Powered from `VAPWR` (3.3V). Uses thick-oxide devices `pfet_g5v0d10v5` (e.g., `MMIRL3` with `W=10 L=2`) and `nfet_g5v0d10v5` (e.g., `MMIR1` with `W=20 L=2`).</li><li>**Bandgap Core (`vthref.sch`):** Uses thick-oxide `pfet_g5v0d10v5` and `nfet_g5v0d10v5` for high-voltage nodes, and standard 1.8V `nfet_01v8` for low-voltage nodes.</li><li>**BJTs:** Uses parasitic `diode_pd2nw_11v0` (p-diff to n-well diode, `area=1e+12` p-cells) in `vthref.sch`.</li><li>**Oscillator:** Uses 1.8V devices `nfet_01v8` and `pfet_01v8`.</li></ul><br>*Source: `tt08/ip/ldo/xschem/` / `tt08/ip/vthref_tt/xschem/`* | <ul><li>**Capacitors:** MIM Capacitor `C1` (`cap_mim_m3_1`) in the OTA has dimensions **$W=20\,\text{µm}$**, **$L=20\,\text{µm}$** with multiplier **$MF=16$** (16 capacitors in parallel).</li><li>**Resistors (LDO Feedback Divider):**</li><ul><li>`RT`: `res_xhigh_po_1p41` with **$W=1.41\,\text{µm}$**, **$L=40\,\text{µm}$**.</li><li>`RB`: `res_xhigh_po_1p41` with **$W=1.41\,\text{µm}$**, **$L=85\,\text{µm}$**.</li></ul><li>**Resistors (Bandgap):**</li><ul><li>`RSU`: `res_xhigh_po_0p69` with **$W=0.69\,\text{µm}$**, **$L=140\,\text{µm}$**.</li><li>`RREF1`: `res_xhigh_po_1p41` with **$W=1.41\,\text{µm}$**, **$L=40\,\text{µm}$**.</li></ul></ul><br>*Source: `tt08/ip/ldo/xschem/ldo.sch` / `ldoota.sch` / `vthref.sch`* | <ul><li>**info.yaml Config:**</li><ul><li>`tiles: "1x2"`</li><li>`analog_pins: 1`</li><li>`uses_3v3: true`</li></ul><li>**Pin Mappings:**</li><ul><li>`ua[0]`: `LDO_OUT`</li><li>`ui[0]`: `OSC_EN`</li><li>`ui[1]`: `OSC_RESET`</li><li>`uo[0]`: `OSC_OUT`</li></ul></ul><br>*Source: `info.yaml`* |
| **tt_um_mattvenn_r2r_dac_3v3**<br>*(Analog 8-bit DAC)* | <ul><li>**DAC Driver (`dac_drive.sch`):** Uses standard 1.8V devices (`pfet_01v8_hvt` and `nfet_01v8`) for input signal path, and thick-oxide devices (`pfet_g5v0d10v5` and `nfet_g5v0d10v5`) for the 3.3V output stage driver.</li><li>**Supply:** Dual supply; connected to `VDPWR` (1.8V) and `VAPWR` (3.3V).</li></ul><br>*Source: `xschem/dac_drive.sch`* | <ul><li>**Capacitors:** None used.</li><li>**Resistors:** Uses regular precision high-poly resistors `res_high_po_1p41` (not high-res poly). All resistors in the R2R ladder (`R2`-`R27`) have override dimensions of **$W=1.41\,\text{µm}$** and **$L=45\,\text{µm}$**.</li></ul><br>*Source: `xschem/r2r.sch` | <ul><li>**info.yaml Config:**</li><ul><li>`tiles: "1x2"`</li><li>`analog_pins: 1`</li><li>`uses_3v3: true`</li></ul><li>**Pin Mappings:**</li><ul><li>`ua[0]`: `DAC output`</li><li>`ui[7:0]`: `bit 0` to `bit 7` (digital DAC inputs)</li><li>`uo[0]`: `count zero`</li><li>`uio[0]`: `external data`</li><li>`uio[1]`: `load divider`</li></ul></ul><br>*Source: `info.yaml`* |
