wecallemjazzyfact/TinyTapeout-BGR-LDO/designs/bgr_ldo/ldo/BOOKKEEPING.md

# BOOKKEEPING.md — gm/Id 예측 ↔ 회로 실측 대조 기록

위치: `designs/bgr_ldo/ldo/BOOKKEEPING.md`
목적: **이중 기장법(double bookkeeping)** — LUT 손계산과 회로 시뮬을 매 단계 대조한
기록. 이 표가 "Spice Monkey가 아니라 체계적 설계였다"는 **유일한 증거**다.

> **기재 규칙**
> 1. 예측·실측·조건(코너/온도/바이어스/geometry/추출법)을 항상 **셋 다** 적는다.
> 2. 예측이 틀렸으면 **틀린 채로 남기고** 원인을 적는다. 지우지 않는다.
> 3. 조건 없는 수치는 기재하지 않는다.
> 4. 행 번호는 추가만 하고 재사용하지 않는다.

---

## 1. 대조표 (누적)

### 1.1 소자 단위 — LUT vs `.op`

| # | 항목 | LUT 예측 | 회로 실측 | 오차 | 조건 |
| :---: | :--- | ---: | ---: | ---: | :--- |
| 1 | `VNB1` 다이오드 $V_{GS}$ | 1.1121 V | **1.111965 V** | **0.14 mV** | nfet W10/L20, 2.564228 µA, tt/27 |
| 2 | $V_{th}$ nfet L=8 | 0.7932 | 0.7932713 | 4자리 일치 | tt/27, VSB≈0 |
| 3 | $V_{th}$ nfet L=20 | 0.7925 | 0.7924804 | 4자리 일치 | 동일 |
| 4 | $V_{th}$ pfet L=2 | 1.02434 | 1.024314 | 5자리 일치 | tt/27 (A3 앵커) |
| 5 | 미러비 M4/tap | 5.000 | **4.980** | −0.40% | L8 m2 : L20 m1 |
| 6 | tail $I_D$ | 10.253 µA | 9.921 | −3.3% | CLM (M3 $V_{SD}$ 0.306 vs 다이오드 1.244) |
| 7 | 폴딩 $I_D$ | 12.816 | 12.773 | −0.34% | |
| 8 | $g_m$(M1) | 94.2 µS | **90.25 µS** | −4.2% | #6의 전류 부족이 그대로 전파 |
| 23 | res_high_po_0p69 시트 | 491 Ω/µm (HANDOFF 문서) | 470.976 | −4.1% | tt/27, 3점 피팅 L=22.424/46.435/16.421, 1 V, 잔차 0.00 Ω |
| 24 | res_high_po_0p69 헤드(단자당) | 390 Ω (문서) | 262.85 | −32.6% | 동일. 2헤드 = 525.70 Ω |
| 25 | res_high_po_0p69 1유닛(L=4.416) | 2948 Ω (문서) | 2605.5 | −11.6% | 동일 |
| 26 | cap_mim_m3_1 30 pF | 30.000 pF | 29.98046 | −0.065% | tt/27, W=L=122.2846, AC 1 kHz |
| 27 | cap_mim_m3_1 2.72 pF | 2.720 pF | 2.714180 | −0.214% | tt/27, W=L=36.6887 |
| 28 | cap_mim_m3_1 유닛 | 681.82 fF | 678.9244 | −0.42% | tt/27, W=L=18.2745 (에지 바이어스 미보정 시) |
| 29 | C_gg(M1, m=24) | — | 565.3 fF | — | tt/27, 폐루프 동작점, .op cgg |
| 30 | pass g_m (I_min=46.06 µA) | — | 0.8224 mS | — | tt/27, 실소자 분압 5:10 |
| 31 | pass g_m (I_D=4.046 mA) | — | 16.236 mS | — | tt/27 |
| 48 | C_gs2 (M2, Vinn측 입력) | — | 357.9 fF | — | tt/27, .op [cgs]. M1=357.9(대칭). 전하보존 Cgs+Cgd+Cgb=565.3=Cgg 검산통과 |
| 49 | Vinn 노드 임피던스 @2.33MHz (no cap) | — | 163 kohm | — | tt/27, Iznode AC주입. Rout 121k보다 큼(M2 소스팔로워 부트스트랩) |
| 50 | Vinn 노드 임피던스 @2.33MHz (Cbyp 3u) | — | 31.2 kohm | — | tt/27. no cap 대비 5.2배 감소 |
| 51 | tail->Cgs2->Vinn 결합비 (no cap) | — | 0.49 | — | 고주파 점근. 신호 절반이 Vinn으로 결합 |
| 52 | tail->Cgs2->Vinn 결합비 (Cbyp 3u) | — | 0.149 | — | Cgs2/(Cgs2+Cbyp). -16.5 dB. PM 41->63 복구 근거 |
| 56 | RO 인버터 Isat (LUT) | nfet W0.42 + pfet W1, L=0.15 | 153.6 uA | tt/27 VGS=1.8 VDS=0.9 | LUT 조회. 실효 구동전류를 1.6배 과대평가함(행 57 참조) |
| 57 | RO 실효 구동전류 | 동일 | 95.07 uA | tt/27, 링 실측 역산 | I_avg=NCVf 로 역산. Isat 대비 0.61배 |
| 58 | RO 노드 용량 | 부하캡 4.27um + 고유 | 42.8 fF | tt/27, 실측 역산 | 설계 38.8 대비 +10%. 배선·접합 추정 과소 |
| 59 | 싱크 스위치 Ron (VDDC 버퍼) | nfet_01v8 W10 L0.15 m4 | 23.04 ohm | tt/27 VGS=1.78 VDS=45.4mV geometry명시 | secant. VDPWR판 22.88 대비 +0.7% |
| 62 | 클램프 PMOS ON 전류 | pfet_g5v0d10v5 W10 L2 m1, VSG=3.3 VSD=0.9 | 250.3 uA | tt/27, LUT(기준폭 10um) | startup 시 pass 게이트 구동 |
| 63 | 클램프 게이트 1.8V 시 전류 | 동일, VSG=1.5 | 21.67 uA | tt/27, LUT | EA pull-down 12.8 uA 대비 1.7배 -> 1.8V 직결 불가 근거 |
| 64 | inv1 관통 전류 | pfet_g5v0d10v5 W1 L20 / nfet W10 L2, VREF=1.194 | 0.9446 uA | tt/27, .op 실측 | I_Q 추가분 전부 |
| 65 | 클램프 OFF 누설 | pfet_g5v0d10v5 W10 L2, VSG=0 | 1.39e-17 A | tt/27, .op 실측 | 정상 동작 무간섭 |
| 66 | VREF_LOW 부하(클램프 게이트) | nfet W10L2 42.5 + pfet W1L20 41.9 fF | 84.4 fF | tt/27, LUT CGG | Cbyp 2045 fF 의 4.1% |
| 84 | RO 발진 주파수 (5단) | NAND1+INV4, 부하캡 5x(W=L=4.27), VDDC 1.79075 | 243.97 MHz | tt/27, ui_in=0111, tran 20p 3u, 2~3us 구간 | 11단 110.89 대비 x2.200 (이론 11/5=2.2) |
| 85 | RO 전류 (5단) | 동일 조건, i(VSENSE) 차분 (RO_EN 1.8 vs 0) | 96.60 uA | tt/27 | 11단 95.07 대비 +1.6% |
| 86 | 분주기 최고 동작 주파수 | dfxbp_1 x4 리플, VDPWR 1.8, 입력 엣지 90p | 356 MHz 통과 | ss/125 (최악 코너), ratio 2.0000 x4단 | TSPC 불필요 근거 |
| 87 | 표준셀 사용 레이어 | sky130_fd_sc_hd__dfxbp_1 .mag 전층 덤프 | locali/metal1/poly/diff/well/viali | met2·met3·met4 **0건** | div16을 MiM 뱅크 아래 배치 가능 |

### 1.2 증폭기 · 루프 — 예측 vs `.ac`

| # | 항목 | 예측 | 실측 | 오차 | 조건 |
| :---: | :--- | ---: | ---: | ---: | :--- |
| 9 | $A_{EA}$ | 71.3 dB | **72.05 dB** | +0.75 dB | tt/27, $C_L$=3.1 pF. gds ±10~20% 전제 안 |
| 10 | $R_{out,EA}$ | 39.2 MΩ | 44.2 MΩ | +13% | $A/g_m$ 역산 |
| 11 | UGF (EA 단독) | — | 4.522 MHz | — | 지배극 1128.5 Hz × $A$ 3990 = 4.52 ✓ |
| 12 | PM (단위이득) | — | 81.3° | — | ★ `vp()`는 **라디안** (−1.72327 = −98.7°) |
| 13 | 폴딩극 | 364 MHz | ≥ 281 MHz | — | 무부하 UGF에서 하한 |
| 32 | 루프 GM @2 mA (단일주입) | — | 21.7 dB | 무효 | tt/27, 직렬 전압주입. HF 아티팩트 위에서 읽음 |
| 33 | 루프 GM @2 mA (이중주입) | — | 10.5 dB | 정본 | tt/27, Middlebrook 이중주입 |
| 34 | 루프 T_dc @I_min (두 방법) | 95.21 dB | 95.11 dB | 0.10 dB | tt/27. 저주파는 두 방법 모두 유효 — 무결성 검증 |
| 35 | Z_out 피크 @I_min | — | 1160.44 Ω @ 3.91211 MHz | — | tt/27, 실소자, Iprobe 구동점 측정 |
| 36 | Z_out 피크 @2 mA | — | 170.310 Ω @ 35.1058 MHz | — | 동일 |

### 1.3 폐루프 DC

| # | 항목 | LUT 예측 | 실측 | 오차 | 조건 |
| :---: | :--- | ---: | ---: | ---: | :--- |
| 14 | $g_m$($I_{min}$) | 0.910 mS | **0.9022 mS** | −0.9% | m=40×W10 L0.5, $I_D$=50.87 µA, 이상 분압 4:8 |
| 15 | $g_m$(4 mA) | 16.25 mS | **16.243 mS** | **−0.04%** | $I_D$=4.0509 mA, 이상 분압 |
| 16 | $V_{out}$ | 1.800 V | 1.799811 | −0.01% | 이상 분압 1:2 |
| 17 | DC load reg | < 5 mV (스펙) | **0.119 mV** | 42배 여유 | 50.8 µA → 4.05 mA, 이상 분압 |

### 1.4 ★ 예측이 틀린 것 (원인 포함)

> **이 절의 행은 이동·삭제하지 않는다.** 틀린 예측이 방법론의 증거다.

| # | 항목 | 예측 | 실측 | 원인 |
| :---: | :--- | ---: | ---: | :--- |
| 18 | 루프 UGF | 5.3 MHz | **2.77 MHz** | **$\beta$=2/3 누락.** UGF=$\beta g_m/(2\pi C_c)$ |
| 19 | 드룹 @100 µA | 189 mV | **31.6 mV** | **$C_c$ 고속 피드포워드 클램프 미고려.** $C_c/(C_c{+}C_{gg})$=0.847가 $R_zC_c$=23 ns 만에 게이트로 결합 |
| 20 | $C_{gd}$(pass) | 2.3 fF | **80 fF** | **LUT 캡은 intrinsic 전용.** 오버랩 `cgdo`=0.194171 fF/µm 별도 가산 (D6) |
| 21 | 최악 코너 | `sf` (오버랩 +31.6%) | **`ss`** (GM 14.9) | 메커니즘은 맞으나 정량 영향 무시 수준 — $C_{gg}$ 49 fF 증가가 $C_c$ 2720 fF에 묻힘 |
| 22 | $C_{out}$ 코너 민감도 | cap_low가 최악 | 무의미 | 비MiM 분율 = $C_{db}$ 136 fF / 30 pF = **0.45%** (D7) |
| 37 | 분압 비 (4:8 유닛) | 2.00000 | 2.02000 | 합성-L 공식 오류. L=6.0028N−1.587 → 5.5322N−1.1162로 정정 |
| 38 | MiM 병렬 배수 | MF=N이 곱한다 | MF 무효, m=N이 곱함 | FET mult와 동일 함정. MF=1과 MF=4 모두 678.9244 fF |
| 39 | MiM 용량 공식 | C = 2.0WL + 0.19·2(W+L) | 에지 바이어스 0.040 µm 필요 | 두 치수에서 0.0399/0.0390으로 일치 추출. W_eff = W − 0.040 |
| 40 | MiM 최대 치수 | (미고려) | DRC capm.6 = 20 µm | 122.2846 µm 단일 플레이트는 6배 위반. **DRC를 소자 치수 계산에 선행시켜야 했다** |
| 41 | 비율계량의 적용 범위 | 온도·산포 모두 불변 | **공정 산포 한정** | 온도에서는 g_m/I_D ∝ 1/V_T 인자가 pass·EA에 동일하게 걸려 비에서 이미 상쇄. 판 A 9.11% = 판 B 9.11% |
| 42 | 최악 코너 (R/C) | — | 온도가 R/C 코너보다 2배 크다 | 온도 기여 PM 5.7°/GM 2.9 dB vs R/C 2.9°/0.5 dB |
| 43 | 넷리스트 동기화 | — | ea_fc_tb.spice가 stale | xschem에서 하위 셀 수정 후 상위 TB를 재넷리스트해야 반영. 추출은 ldo_core_tb.spice 기준으로 통일 |
| 53 | 기준경로극 영향 | Vinn 전방경로라 루프 밖 무해 | 루프 안 영향 (PM 21도 손실) | HANDOFF §2.2의 "무해" 서술 오류. 실제: tail->Cgs2->Vinn 용량결합이 차동입력 상쇄. 단독검증은 Vinn 이상전압원(임피던스0)이라 가려짐 |
| 54 | Cbyp 초기 가설 | Cbyp 새 극점이 위상 먹어 나빠짐 | 반대로 PM 개선 | Vref->Vinn 경로(극점 낮춤)를 신호경로로 혼동. 실제 신호는 tail->Cgs2 경로이며 Cbyp가 그 결합을 용량분배로 억제 |
| 55 | Ron 직렬성분 귀속 | secant 실측 - LUT(1/gds) 차이(6.01옴) 전부가 nrd/nrs 직렬성분 | 실제로는 직렬성분 3.3옴 + secant/tangent 원리적 괴리 2.7옴으로 분해됨 | BGR 회신(REPLY_BGR_RON_GEO) A/B 대조(geometry 생략/명시)로 순수 분리. 1/gds(접선)와 secant(할선)는 직렬저항 0이어도 다르다는 01_BGR_최종스펙 §6.3 기존 규율을 놓쳤던 것이 원인 |
| 60 | RO 주파수 예측 | Isat=153.6uA 기준 f=200MHz | 실측 110.89 MHz | Isat(포화 최대전류)이 실효 구동전류를 1.6배 과대평가. 전이 중 소자가 포화를 벗어나 삼극관 진입(alpha-power 보정 0.6~0.7). C도 +10% 과소추정. 두 오차 합성이 f=200x0.61/1.10=111 로 실측과 일치 |
| 61 | 분주기 방식 | 200MHz 전제로 첫 2단 TSPC 커스텀 필요 | 표준셀 DFF로 전 단 충분 | 실측 f_osc가 110.9 MHz로 낮아 표준셀이 여유롭게 받음. 커스텀 회로 1건 제거 |
| 67 | 기동 오버슈트 원인 | EA UGB(2.5MHz) 부족으로 루프가 못 따라감 | UGB 무관. VAPWR 도달 시점과 VREF 확립 시점의 타이밍 경쟁 | UGB 문제면 램프 속도와 무관해야 하는데 100us 램프에서 오버슈트가 사라짐(2.383 -> 1.794 V). VREF=0 동안은 EA가 증폭할 기준 자체가 없어 UGB를 올려도 무효 |
| 68 | 클램프 게이트 구동 방식 | VREF_LOW 를 클램프 게이트에 직결하면 기동 중 ON / 정상 시 OFF | 정상 시 VSG=2.1V로 계속 ON. peak 억제와 final 훼손이 동반(peak -128mV 시 final -82mV)되어 양립 불가 | 클램프는 전압 감지가 아니라 full-swing 디지털 신호로 구동해야 함. 인버터 2단으로 해결 |
| 69 | 클램프만으로 빠른 램프 대응 | 클램프가 VREF 감지형이므로 램프 속도 무관 | 10ns 램프에서 2.325V 실패. t=0에 n_cl1=0이면 inv2 pfet이 ON이라 CLAMP_GATE가 VAPWR 따라 올라가 클램프가 꺼진 상태로 출발 | inv1 약한 pfet(3.3uA)의 n_cl1 충전에 ~5ns 소요. XC_boost 50fF 용량결합으로 해결 |
| 88 | RO 단수 축소의 부하 영향 | 단수를 절반 이하로 줄이면 I_RO 도 크게 변할 것 | 1.6% 이내 불변 (95.07 -> 96.60 uA) | I_RO = N*C*V*f 이고 f ∝ 1/N 이므로 N 이 소거된다. 남은 1.6%는 탭 버퍼 몫 — 버퍼 노드 용량은 그대로인데 f 가 2.2배라 버퍼 전류가 그만큼 늘었다(계산 +0.7 uA, 실측 +1.5 uA로 같은 크기). 이는 RO 설계 초기 직교성 주장의 2차 실증이다(1차는 5 fF 추가 실험, 예측 0.998 vs 실측 0.99 uA) |
| 89 | 표준셀 DFF 의 속도 한계 | 244 MHz 이상은 표준셀 DFF 로 어렵고 TSPC 가 필요할 것 | ss/125 최악 코너에서 356 MHz 까지 ratio 2.0000 통과 | GHz 급이라면 TSPC 가 필요하나 여기는 MHz 대역이고 356 MHz 주기가 2.81 ns 로 dfxbp_1 의 clk-to-Q 가 충분히 들어온다. TSPC 설계·검증 비용을 쓰지 않는 것이 옳았다 |
| 90 | Trim0b~Trim3b 의 소비처 | bgr_core 포트 목록에 TRIM0~3 만 있고 Trim*b 가 없으므로 인버터 출력이 부유 노드일 것 | x_bgr 인스턴스 줄이 Trim0b~Trim3b 를 bgr_core 의 TRIM0~3 포트에 연결한다. 부유 아님 | 서브서킷 **포트 이름**과 **연결 넷 이름**은 별개다. `.subckt` 정의만 보고 판단하면 안 되고 인스턴스 줄의 위치 대응을 봐야 한다. 인버터를 뺐다면 극성이 뒤집혀 ui_in=0000 이 V_out 최대(ff 1.994 V, 정상상태 1.95 초과)가 됐을 것 |

---

## 2. 확정 파라미터

> 별도 표기가 없으면 **실소자**(폴리 저항 · MiM) + **폴리 기준 바이어스** 구성이다.

### 2.1 pass device

`sky130_fd_pr__pfet_g5v0d10v5`, **m=40 × W=10 µm, nf=1, L=0.5 µm**, 벌크 VAPWR

| 양 | 값 | 조건 |
| :--- | ---: | :--- |
| $g_m$ | **0.8224 mS** / 16.236 mS | tt/27, $I_D$ = 46.06 µA / 4.046 mA (실소자 5:10 분압) |
| $g_m$ (구 구성) | 0.9022 mS / 16.243 mS | tt/27, $I_D$ = 50.87 µA / 4.0509 mA (이상 4:8 분압) |
| $C_{gg}$ | 374 fF / 492 fF | intrinsic + 오버랩 155.3 fF |
| $C_{gd}$ | 80 fF | 대부분 오버랩 |
| $C_{db}$ | 136 fF | $V_r$=1.5 V, `ad`=116 µm² |
| dropout | 261 mV | 4.05 mA, $V_{EA}$ floor 0.5 V |

**W 상한을 정한 것은 dropout·누설·EA 천장이 아니라 $I_Q$였다** (m ≤ 60).

### 2.2 EA (PMOS 입력 folded cascode)

전부 `g5v0d10v5` thick-ox, nf=1, W=10 µm 유닛. **M1/M2 벌크 = `V_tail`** (바디효과 회피)

| 소자 | L [µm] | m | $g_m/I_D$ | 역할 |
| :--- | ---: | ---: | ---: | :--- |
| M1/M2 | 2 | **24** | 18.4 | 입력쌍 (짝수 m = 공통중심) |
| M3/M3c | 4 | 4 | 8.2 | tail + 캐스코드 |
| M4/M5 | **8** | **2** | 5.8 | 폴딩 싱크 (W/L 2.5 보존, ΔVth 0.7 mV) |
| M6/M7 | 1 | 1 | 14.9 | N 캐스코드 |
| M8/M9 | 1 | **4** | 16.0 | P 캐스코드 |
| M10/M11 | 2 | **4** | 11.8 | wide-swing 미러 |

**바이어스 3계통** (각 1q = 2.564228 µA): `VNB1`(nfet W10/L20 다이오드, `IB_EA` 직결) /
`VPB1` / `VNB2`. **VPB2 삭제** — rev2에서 VPB1과 9 mV 차로 합쳐짐.
캐스코드 바이어스는 VPB1 가지의 **폴리 저항 탭**으로 만든다(추가 전류 0):

| 저항 | 유닛 | L [µm] | 역할 |
| :--- | ---: | ---: | :--- |
| `XR_pb2` | 16 | **87.3990** | VPB1 → VPB2 (M8/M9 게이트) |
| `XR_pb1c` | 44 | **242.3006** | VPB2 → VPB1c (M3c 게이트) |
| `XR_nb2` | 55 | **303.1548** | VNB2 다이오드 소스 → VGND ($V_{fold}$ 결정) |

> $V_{drop} = I_{tap}R = (V_{bg}/R_{BGR})R = V_{bg}(R/R_{BGR})$ 이므로 폴리/폴리 비만
> 남아 절대 산포와 TC1이 소거된다. 캐스코드 바이어스를 저항으로 만든 것이 비율계량의 실례.

**`.op` 실측** (tt/27, ideal 2.564228 µA, $V_{EA}$ 2.156 V 강제):

| 노드 | V | | 포화 마진 $\lvert V_{DS}\rvert - v_{dsat}$ | mV |
| :--- | ---: | :--- | :--- | ---: |
| VPB1 | 2.055405 | | M3 | 95.4 |
| VPB2 | 1.948320 | | M4 | 138.2 |
| VPB1c | 1.653836 | | M6 | 1648.7 |
| VNB2 | 1.432049 | | M8 | 827.7 |
| `n_nb2` | 0.372526 | | **M10** | **77.0** |
| $V_{fold}$ | 0.402785 | | **천장** | **2.9855 V** (요구 2.80) |

$g_m$(M1) = **90.258 µS** (목표 90), 불평형 전류 2.65e−11 A, $A_{EA}$ = 72.05 dB,
출력창 [0.54, 3.01] V.

### 2.3 보상망 + 부하 (Task 4 확정, 실소자)

| 소자 | 값 | 구현 | 근거 |
| :--- | ---: | :--- | :--- |
| $C_c$ | 2.7273 pF | MiM W=L=18.3147 µm, **m=4** | GM이 하한 — 2.2 pF 이하는 중부하 GM < 5 dB |
| $C_{out}$ | 30.000 pF | MiM 동일 유닛, **m=44** | $I_Q$ 안에서 과도 만족하는 최소. 비 정확히 11.000 |
| $R_z$ | 3유닛 | `res_high_po_0p69` L = 15.4804 µm | 전 부하에서 GM이 정의되는 값 |
| 분압 | 5:10 유닛 | L = 26.5447 / 54.2057 µm | $I_Q$ (4:8이면 150.61 µA로 초과) |
| $C_{byp}$ | 2.045 pF | MiM 동일유닛 m=3, VREF_LOW-GND | 기준노드 AC임피던스 억제. NR/BYP 핀과 동일. 최적값(스윕) |
| $R_{snk}$ | 880.3 Ω | res_high_po_5p73, L=29.80, m=2 | 싱크 부하저항. 실측 설계값 일치 |
| $M_{snk}$ | Ron 22.88 Ω(실측) | nfet_01v8 W10 L0.15 m4 | secant, geometry명시. D21 앵커 |
| $R_{slew}$ | 295.0 kΩ | res_high_po_0p69, L=625.26 | 슬루 RC |
| $C_{slew}$ | 2.727 pF | MiM 동일유닛 m=4 (Cc와 동일구성) | 슬루 RC. tau=0.805us |
| $I_{div}$ | 46.06 µA | — | 최소부하 겸용 |
| $I_Q$ | **139.10 µA** | — | < 150 ✓ 마진 10.9 |

### Startup 클램프 (기동 오버슈트 방어)

| 소자 | 값 | 조건 |
| :--- | :--- | :--- |
| XM_i1n | nfet_g5v0d10v5 W=10 L=2 m=1 | inv1 pull-down, 게이트 VREF_LOW |
| XM_i1p | pfet_g5v0d10v5 W=1 L=20 m=1 | inv1 pull-up, 관통 0.9446 uA |
| XM_i2n | nfet_g5v0d10v5 W=1 L=1 m=1 | inv2 |
| XM_i2p | pfet_g5v0d10v5 W=3 L=1 m=1 | inv2 |
| XM_clamp | pfet_g5v0d10v5 W=10 L=2 m=1 | D=PASS_GATE S=VAPWR, ON 250.3 uA |
| XC_boost | cap_mim_m3_1 W=L=5 um (50 fF) | VAPWR-n_cl1 결합 |
| 릴리즈 시각 | 2.42 ~ 3.00 us (코너별) | VREF 확립에 자동 연동 |
| 트립점 | VREF 약 0.85 V | inv1 nfet Vth 근처 |

### TRIM 극성 반전 인버터

| 소자 | 값 | 조건 |
| :--- | :--- | :--- |
| XM_tin0~3 | nfet_01v8 W=2 L=0.15 m=1 | VDPWR 급전 |
| XM_tip0~3 | pfet_01v8 W=4 L=0.15 m=1 | 〃 |
| 결선 | ui_in[3:0] -> TRIM -> 인버터 -> Trim[3:0]b -> bgr_core | 반전은 top에서만 |

MiM 총계 갱신: 링 부하캡 포함 약 18,649 µm² + **XC_boost 25 µm²** = 약 **18,674 µm²**. (타일 대비 약 57%, 변화 미미)

### RO + 분주기 (5단)

| 항목 | 값 | 조건 |
| :--- | :--- | :--- |
| 구성 | NAND 1 + 인버터 4 = **5단** + 탭 버퍼 2 | ro_nand / ro_inv |
| 인버터 | nfet_01v8 W=0.42 L=0.15 / pfet_01v8 W=1 L=0.15 | m=1 |
| NAND | nfet W=1 L=0.15 x2 직렬 / pfet W=1 L=0.15 x2 병렬 | A=링 피드백(출력측), B=RO_EN(소스측) |
| 부하캡 | cap_mim_m3_1 W=L=**4.27** x **5** (전부 동일, 4.17 폐지) | 하판 VGND |
| $f_{osc}$ | **243.97 MHz** | tt/27, VDDC 1.79075 |
| $I_{RO}$ | **96.60 uA** | 〃 |
| 분주기 | dfxbp_1 x4 리플, VDPWR 급전 | ÷16 |
| DIV_OUT | **15.248 MHz** | 분주비 16.00 |

NAND 직렬 NMOS 순서 주의: 스위칭하는 링 노드가 출력측(XMN1), 정적인 RO_EN 이
소스측(XMN2). 반대면 매 사이클 중간 노드를 충방전해 지연이 늘고 불균일해진다.

**폐루프 실측** (실소자, 폴리 기준 바이어스, Middlebrook 이중주입, tt/27 °C)

| | $I_{min}$ | 0.5 mA | 2 mA | 4 mA |
| :--- | ---: | ---: | ---: | ---: |
| $T_{dc}$ [dB] | 95.11 | 101.34 | 100.37 | 98.66 |
| UGF [MHz] | 2.773 | 3.571 | 3.558 | 3.509 |
| PM [°] | **62.6** | 95.8 | 99.5 | 100.2 |
| GM [dB] | 22.4 | 11.6 | **10.5** | 10.6 |

**코너 × 온도 최악값**

| | 통합 (BGR+Cbyp) | 단독 (이상 Vref, 참고) | 요구 | 마진 |
| :--- | ---: | ---: | ---: | ---: |
| 최악 PM | **59.3°** (ll/125/Imin) | 58.3° | 45° | 14.3° |
| 최악 GM | **10.1 dB** (hh/−40/2mA) | 9.1 dB | 8 dB | 2.1 dB |

주석: 통합이 단독보다 개선 — Cbyp가 기준노드 안정화로 GM 최악점 여유까지 넓힘.
MOSFET 코너(tt/ss/ff/sf, 27 °C) 스프레드: PM 0.2°, GM 0.0 dB.

### 2.4 과도 (실소자, 폴리 기준 바이어스)

| 케이스 | 조건 | 결과 |
| :--- | :--- | ---: |
| 0→100 µA 스텝 (100 ns) | tt/27 | 드룹 **31.6 mV**, 오버슈트 32.1 mV |
| 0→100 µA 스텝 (100 ns) | `ll`/125 | 드룹 **40.6 mV** |
| 0→2 mA 스텝 (100 ns) | `hh`/−40 | 드룹 130.0 mV, **회복 중 오버슈트 0** |
| 2 mA release (100 ns) | `hh`/−40 | 1.9487 V (아슬 통과) |
| 2 mA release (100 ns) | tt/27 | **1.9713 V ✗** |
| 2 mA release (100 ns) | `ll`/125 | **2.0093 V ✗** |
| 2 mA release (1 µs) | `ll`/125 | 1.8652 V ✓ 마진 85 mV |
| 4 mA release (1 µs) | `ll`/125 | 1.8960 V ✓ 마진 54 mV |
| 4 mA release (1.5 µs) | `ll`/125 | 1.8768 V ✓ 마진 73 mV |

**$Z_{out}$ ↔ 과도 교량**: $Z_{peak}\times I_{step}$ = 116.0 mV(상한) → ×0.586(2차
스텝응답) → ×0.767(100 ns 엣지 sinc) = 52.1 mV vs 실측 31.6 mV. **경험적 인수 0.27**
(100 ns 엣지, 본 설계 한정). $Z_{out}$은 진단용, 스펙 판정은 과도가 정본.

**제약**: 부하 스위치 엣지 ≥ **1.5 µs 설계목표 / 1.0 µs 하드 하한**, **양방향**,
$I_{step}$ ≥ 1 mA인 싱크에 적용. 100 µA급(RO enable)은 제외.

**슬루 드라이버 검증(tt/27, ll/125)**: 엣지 1.85us 양방향(비대칭 0.69%), release Vmax 1.821/1.846V(마진 129/104mV), 인가 Vmin 1.719/1.705V (PG문턱 대비 여유 82.5/104mV), 로드레귤레이션 92uV@2mA, 폐루프AC 무간섭(PM 63.4/-0.1, GM 23.8/불변).

### EA (ea_fc) LVS — 통과

레이아웃 실측 vs 스키매틱 골든(ea_fc_lvs.spice), netgen sky130A_setup.tcl:

  Circuits match uniquely. 23/23 소자, 18/18 넷. Property error 0
  (mklvs.sh 적용 후. 미적용 시 매칭은 되나 W/L property error 동반).

MOS 101유닛(38 인스턴스, 더미 18 포함) + 저항 3, 레이아웃 실측 셀 개수와
7개 그룹 전부 일치 (pfet L2 62 / L4 12 / L1 10, nfet L8 6 / L1 4 / L20 4 / L4 3).

### Startup 검증 (클램프 + XC_boost + TRIM 반전)

전 코너 21점 (ui_in=0000 기본값, VAPWR 1 us 램프, .ic v(VDDC)=0 v(VREF_LOW)=0):
  peak 범위 1.758 ~ 1.861 V, 최악 ff/27 1.8605 (마진 89.5 mV), 1.95 초과 0/21.

정상 트림 조건 (DC ceiling 1.790 적용):
  ff/27 code13: final 1.7800, peak 1.8920 (마진 58.0 mV)
  ll/27 code9 : final 1.7807, peak 1.9249 (마진 25.1 mV) <- 최악

램프 무의존성 (ui_in=0000):
  1 ns: ll 1.8126 / ff 1.8597
  10 ns: ll 1.8124 / ff 1.8592
  100 ns: ll 1.8129 / ff 1.8599
  -> 램프 100배 변화에 편차 0.5 mV.

폐루프 AC 무간섭 (이중주입, tt/27, 무부하, code8):
  Tdc 95.09 dB(기준 95.1) / UGF 2.4887 MHz(2.50) / PM 63.42 deg(63.4) / GM 23.76 dB(23.8)
  -> VREF_LOW 부하 84.4 fF 추가에도 Cbyp 3유닛 최적점 유지.

XC_boost 정상동작 부작용 없음 (line transient VAPWR 3.0->3.6V, 100ns 엣지, tt/27):
  Cboost 없음 VDDC max 2.08771 / 50 fF 2.08772 / 98 fF 2.08774 (차이 0.01 mV)
  CLAMP_GATE 최저 3.00000 V, n_cl1 최고 6.77 mV -> 클램프 미동작 확인.

### 2.6 비율계량 (ratiometric biasing) — 적용 범위

같은 회로를 두 판으로 만들어 비교했다.
**판 A** = 이상 전류원 2.564228 µA 고정(대조군), **판 B** = 폴리 기준 전류원
(178유닛, L = 983.6154 µm, $I = V_{bg}/R_{poly}$). 판 B가 Task 6의 실제 구성이다.

**통합(실제 BGR 탭) 실측**: 트림 전 $g_{m,pass}/g_{m,EA}$ 스프레드 3.9% ($V_{ref}$가 ff에서 +4%로 $V_{out}$에 실림), 트림 후 ~0% (트림이 $V_{ref}$를 1.2 V로 고정 → 분자 소거 → 1.5×폴리비, $R_{poly}$는 `corner_factor` 공유로 소거). 거동원($F_{ref}$) 검증의 1.29%는 이상 $V_{bg}$ 고정 가정이라 트림 후 상태에 해당. 저항성분은 PDK 모델레벨(`corner_factor`)에서, 밴드갭 정확도성분은 트림이 소거 — 두 메커니즘 직교.

**① 공정(R/C 코너, 27 °C) — 작동한다**

$p_2/\text{UGF}$를 정하는 비 $g_{m,pass}/g_{m,EA}$:

| 판 | `ll` | `tt` | `hh` | 스프레드 |
| :--- | ---: | ---: | ---: | ---: |
| A | 10.53 | 9.12 | 8.13 | **29.60%** |
| **B** | 9.08 | 9.14 | 9.19 | **1.29%** (23배↓) |

추종 오차: `ll`/`tt`에서 $I_{div}$ ×1.1728 대 $g_{m,EA}$ ×1.1525 (**−0.2%**),
`hh`/`tt`에서 ×0.8785 대 ×0.8900 (**+0.0%**).

| 스프레드 | 판 A | 판 B | 감소 |
| :--- | :--- | :--- | :--- |
| GM @2 mA | 2.80 dB | **0.54** | 5.2배 |
| GM @4 mA | 2.86 | **0.44** | 6.5배 |
| PM @$I_{min}$ | 6.32° | **3.57** | 1.8배 |

최악값도 개선: GM 9.3 dB(판 A) → **10.3 dB**(판 B).

**② 온도(−40/27/125 °C) — 듣지 않는다**

| 스프레드 | 판 A | 판 B |
| :--- | :--- | :--- |
| PM @$I_{min}$ | 7.03° | 5.77 (1.2배) |
| PM @2 mA | 5.12° | **6.23 (악화)** |
| $g_{m,pass}/g_{m,EA}$ | **9.11%** | **9.11%** (동일) |

**원인**: $g_m = I_D(g_m/I_D)$이고 $(g_m/I_D) \approx 1/(nV_T)$는 절대온도 지배다.

| T | $V_T$ | $g_m/I_D$ (M1) |
| ---: | ---: | ---: |
| −40 °C | 20.091 mV | 20.18 |
| 27 | 25.865 | 17.60 |
| 125 | 34.310 | **14.46** |

이상 전류원인데도 $g_{m,EA}$가 ±20% 움직인다. 그런데 이 인자는 pass에도 동일하게
걸리므로 **비에서 이미 상쇄된다**: $g_{m,pass}/g_{m,EA} = I_{div}/I_{EA}$.
온도에서는 $R_{poly}$가 ±5%밖에 안 움직여 판 A조차 9.11%뿐이고, 판 B가 그것을 0으로
만들어도 PM은 거의 안 변한다.

**온도에서 실제로 움직이는 것은 $R_z$ 영점의 상대 위치다:**

| T | $R_z$ | $1/g_{m,pass}$ | 영점 $z$ | UGF | **$z$/UGF** |
| ---: | ---: | ---: | ---: | ---: | ---: |
| −40 | 7,548 Ω | 1,069 | 9.008 MHz | 3.318 | **2.71** |
| 27 | 7,817 | 1,261 | 8.903 | 2.773 | 3.21 |
| 125 | 8,211 | 1,628 | 8.866 | 2.160 | **4.10** |

$R_z$ 상승과 $1/g_m$ 상승이 상쇄되어 영점은 온도에 거의 불변인데 UGF만 54% 움직인다.
$z/\text{UGF} \propto 1/(g_{m,EA}R_z) \propto 1/(g_m/I_D) \propto T_{abs}$ — **남은 것은
절대온도 그 자체이며 비율계량으로는 잡을 수 없다.**

**③ 확정 서술** (문서 인용 시 이 문장을 쓴다)

> $I_{EA}/I_{div}$는 폴리/폴리 비라 **공정 산포에 불변**하며, 이것이
> $g_{m,pass}/g_{m,EA}$ 스프레드를 29.60% → 1.29%(23배)로, 중부하 GM 스프레드를
> 2.80 → 0.54 dB(5.2배)로 줄인다. **온도에는 적용되지 않는다** — 온도에서는
> $g_m/I_D \propto 1/V_T$ 인자가 pass·EA 양쪽에 동일하게 걸려 비에서 이미 상쇄되며,
> 잔여 PM 변동은 $R_z$ 영점이 UGF를 따라가지 못하는 데서 온다
> ($z/\text{UGF} \propto T_{abs}$, −40~125 °C에서 2.71 → 4.10).

**택하지 않은 대안**: $g_{m,EA}$를 온도 평탄하게 하려면 PTAT 전류가 필요하다
($g_m \propto I/V_T$이므로 $I \propto T$). BGR에 PTAT 가지가 있어 탭은 가능하지만,
그러면 $I_{EA}/I_{div}$ 비가 깨져 공정 산포 이득을 잃는다. **공정 대 온도의 교환**이며,
산포가 더 큰 축이므로 공정을 택했다.

### 2.7 측정 방법론 — 루프이득 (확정)

**Middlebrook 이중주입.** 궤환 루프의 한 점(분압 탭 ↔ EA 입력)에 0 V 전압원을 삽입해
DC는 닫아 둔 채, 전압과 전류를 각각 한 번씩 주입해 합성한다.

$$\frac{1}{1+T} = \frac{1}{1+T_v} + \frac{1}{1+T_i} \quad\Longleftrightarrow\quad T = \frac{T_vT_i-1}{T_v+T_i+2}$$

```
ntap ──[Vprb1 0V]── mid ──[Vprb2 0V]── nfb(EA 입력)
                      │
                    [Iprb]
                      │
                     GND
run 1: Vprb1 AC=1, Iprb AC=0 → T_v = -v(ntap)/v(nfb)
run 2: Vprb1 AC=0, Iprb AC=1 → T_i = -i(Vprb1)/i(Vprb2)
```

$Z_b/Z_f = k$일 때 $T_v = |A|+k$, $T_i = (1{+}|A|)/k$로 각각은 오염되지만 합성하면
정확히 $|A|/(1{+}k)$가 나온다($k$ 전 범위 오차 0, 수치 검증 완료).
Cadence `stb`(Tian/Kundert)와 같은 계열이며, Tian은 여기에 역방향 전달까지 포함한다.
전압원 극성이 반대여도 두 반전이 상쇄되어 식은 그대로 성립한다.

### netgen 단위 접미사 규약

xschem이 뽑은 넷리스트는 W/L에 단위 접미사가 없다(`L=2 W=10`). ngspice는
`.subckt` 스케일 규약으로 µm 해석하지만, netgen은 그 문맥이 없어 SI 기본
단위(미터)로 읽어 레이아웃 추출값과 10^6배 차이의 property error가 난다.

해결: LVS 골든 생성 시 W/L에 `u` 접미사를 강제한다(`L=2u W=10u`). 저항
`mult` 제거(§2.7 기존 규약)와 함께 `mklvs.sh`로 일괄 처리한다.

경로: `/foss/designs/designs/bgr_ldo/ldo/mklvs.sh`
사용: `./mklvs.sh <원본.spice> [출력.spice]`
처리: ① 저항 mult=N 제거, ② X[MRC] 인스턴스의 W/L에 u 접미사

실측 확인(ea_fc): 미적용 시 "Circuits match uniquely"에도 property error
동반, 적용 후 property error 0. 앞으로 넷리스트 재생성마다 mklvs.sh를
다시 실행할 것 — 잊으면 조용히 옛 파일로 LVS가 돈다(BGR 규약과 동일 함정).

**폐기된 방법 2건** (#43 참조):

| 방법 | 결함 | 유효 상한 |
| :--- | :--- | ---: |
| 직렬 전압주입 | $Z_b/Z_f = 2\pi f C_{gg}R_{div}$, 35.8 MHz에서 1 | ~10 MHz |
| 기준입력 주입 | 차동쌍 비대칭 (Vinp 경로만 미러극 48.8 MHz 경유) | ~10 MHz |

$Z_{out}$ 직접 측정(`Iprobe` 구동점)은 근사가 없어 **진단용으로 유효**하나 루프이득이 아니다.

#### 이중주입 프로브는 노드를 격리하지 않는다

Middlebrook 이중주입에서 삽입하는 0 V 전압원(`Vprb1`/`Vprb2`)은 **루프를
끊지도, 노드를 격리하지도 않는다.** 전압원은 양단 전압만 강제하고 전류는
자유롭게 통과시키므로, `net1`(분압탭) ― `net5` ― `net3`(Vinp)는 DC뿐 아니라
AC로도 전기적으로 동일한 노드다. 따라서 피드백 저항(`XRF1`/`XRF2`)이 Vinp에서
그대로 보인다.

**임피던스가 0이므로 소스 저항을 추가하지도 제거하지도 않는다.** 즉 프로브는
Vinp·Vinn의 소스 임피던스를, 따라서 그 노드의 극점 위치를 바꾸지 않는다.

### uic 와 파워업 모사의 구분

`uic`(전 노드 0 초기화)는 발산 회피용 트릭이며 파워업 모사가 아니다. 물리적으로
불가능한 초기상태(VAPWR도 0인데 3.3V가 걸린 것처럼 동작)를 만든다.

startup 검증의 세 방식과 각각의 의미:

| 방식 | 의미 | 우리 결과(클램프 전) |
| :--- | :--- | ---: |
| `uic` (0 시작) | 가장 가혹, 발산 안 하면 통과 | peak 2.393 V |
| VAPWR PWL 램프 + 캡만 `.ic 0` | 현실적 파워업 | peak 2.383 V (1 us) |
| `.op` 시작 | 정상 상태 확인 (켜지는 과정 아님) | peak 1.791 V (오버슈트 0) |

`.op` 시작에서 오버슈트가 0이었던 것은 "이미 켜져 있는 상태"를 본 것이므로
startup 검증이 아니다. **PWL 램프 + 캡 `.ic` 방식이 파워업 검증의 정본**이다.
그리고 램프 속도를 스윕해야 한다 — 우리 경우 임계가 10~30 us 사이에 있었고,
그 발견이 원인 규명(타이밍 경쟁)의 결정적 단서였다.

### 2.8 그림

| 파일 | 내용 |
| :--- | :--- |
| `ea_ac_bode.png` | EA 오픈루프 이득·위상 |
| `ea_ac_sgtrack.png` | supply-to-gate 추종 $v_{EA}/v_{VAPWR}$ (**PSRR 아님** — PMOS pass에서는 1에 가까울수록 좋다. 폐루프 PSRR은 Task 6) |
| `mb_bode_tt.png` | 폐루프 이득 (이중주입, 부하 4점) |
| `mb_bode_cbyp_sweep.png` | Cbyp 스윕 보드선도 (no cap ~ 15u) |
| `znode_vinn.png` | Vinn 노드 임피던스 no cap vs 3u |
| `tr_int_step.png` / `tr_int_rel.png` | 통합 과도 (BGR+Cbyp) |
| `mb_ratiometric.png` | 두 판의 코너별 위상마진 비교 |
| `tr_step.png` / `tr_rel.png` | 부하 스텝 / release 과도 |
| `slew_tr.txt` | 슬루 드라이버 게이트 엣지 및 release 파형 |
| `ro_tr.png` | 링 발진기 파형 (RO_EN / 링 내부 노드 / RO_OUT) |
| `top_startup_full.png` | 기동 과도 전체 (VDDC/VREF_LOW/VNB1/DIV_OUT, 60us) |
| `ro_div_zoom.png` | RO_OUT / DIV_OUT 확대 (통합, 15-16us) |

## 2.9 몬테카를로 (Task 9 선행분)

공통 조건: `tt`/27 °C, 무부하(`ui7`=0), `MC_MM_SWITCH=1` + `MC_PR_SWITCH=1`,
n=100, seed = i × 7919 (BGR `mc_loop.py` 패턴 재사용, 외부 python 루프).
설계 중 선행 실행분이며 **PEX 후 Task 9에서 재실행**한다.

### MC-A — LDO 자체 정확도 (기준을 이상 전압원으로 치환)

구성: `bgr_core` 제거, `Vref net6 0 1.2` + `I0 VAPWR VNB1 2.564238u` 이상원 대체.
목적: 트림이 BGR 오차를 제거한 뒤 **LDO에 남는 오차**만 분리 측정.

| 항목 | 평균 | σ | 3σ |
| :--- | ---: | ---: | ---: |
| $V_{out}$ | 1.798762 V | 6.735 mV | **20.21 mV (1.122%)** |
| $V_{os}$ (EA 입력환산) | −0.406 mV | 2.409 mV | 7.227 mV |
| 분압비 (ratio) | 1.499475 | 4.467e−3 | 1.340e−2 (0.893%) |

기여 분해 ($V_{out} = \text{ratio} \times (1.2 + V_{os})$):

| 성분 | 3σ 기여 |
| :--- | ---: |
| **분압비 미스매치** | **16.08 mV** |
| EA 오프셋 | 10.84 mV |
| RSS 합성 | 19.39 mV (직접 측정 20.21과 정합) |

**★ 지배항은 EA 오프셋이 아니라 분압 저항 미스매치다(1.48배).** 입력쌍은
$WL$ = 10×2×24 = 480 µm²로 충분히 크게 잡혀 있고, 오히려 분압기
(`res_high_po_0p69` 5:10유닛, 폭 0.69 µm 고정이라 면적이 작음)가 약점이다.

트림 양자화(4-bit, LSB 0.89% → ±LSB/2 = ±8.01 mV)와 RSS 합성 시 **±21.73 mV**,
스펙 ±2%(±36 mV) 대비 **마진 40% PASS**.

**→ 별도 오프셋 트림 회로 불채택 확정.**

### MC-B — 루프 안정도 (실제 BGR 유지)

구성: 통합 TB 그대로. 이중주입 AC(30 pts/dec, 10 Hz~500 MHz).
실제 BGR을 유지해야 하는 이유: (a) $R_{out}$ 121 kΩ이 $C_{byp}$ 결합 억제에
직접 관여하므로 이상원 치환 시 메커니즘이 사라져 PM이 낙관적으로 나온다,
(b) **IB_EA 미스매치는 트림이 제거하지 않으며** $g_{m,EA}$ → UGF에 그대로 실린다.

| 항목 | 평균 | σ | 3σ | 최악 | 요구 |
| :--- | ---: | ---: | ---: | ---: | ---: |
| $T_{dc}$ | 95.084 dB | 0.700 | 2.099 | 93.03 | — |
| UGF | 2.5017 MHz | 0.0703 | 0.2107 | 2.326 | — |
| **PM** | 63.450° | 0.551 | 1.654 | **61.23°** | 45° |
| **GM** | 23.723 dB | 0.213 | 0.638 | **23.25 dB** | 8 dB |

**100/100 전원 통과** (PM < 45° 0건, GM < 8 dB 0건).

**★ 공정 코너가 미스매치보다 26배 지배적이다.**

| | MC 3σ | 코너×온도 범위(24점) | 비 |
| :--- | ---: | ---: | ---: |
| PM | 1.654° | 43.5° | **26.3배** |
| GM | 0.638 dB | 17.1 dB | **26.8배** |

코너 최악(PM 59.3° @ll/125/Imin)에 MC 3σ를 얹어도 약 57.7°로 스펙의 1.28배다.
**안정도는 코너 검증으로 사실상 결정되며 MC는 확인 절차**라는 것이 이 결과의 함의다.

### MC-C — 트림 전 분포 (트림 범위 검증)

MC-B와 동일 실행에서 `.op` 항목을 함께 수집.

| 항목 | 평균 | 3σ | min | max |
| :--- | ---: | ---: | ---: | ---: |
| $V_{out}$ | 1.79530 V | 101.5 mV (5.64%) | 1.72605 | 1.88876 |
| $V_{ref}$ | 1.19646 V | 67.65 mV (5.64%) | 1.15086 | 1.25810 |
| 분압비 | 1.50052 | 1.490e−2 (0.993%) | 1.48632 | 1.51091 |

**$V_{out}$ 산포는 거의 전부 BGR에서 온다** — $V_{ref}$ 3σ 5.654% vs 분압비 0.993%,
RSS 5.741%로 실측 5.655%와 정합.

트림 배수 $k = 1.800/V_{out,\text{트림전}}$, 가용 범위 0.934~1.066(±6.6%):

| | 필요 $k$ | 하단 여유 | 상단 여유 |
| :--- | :--- | ---: | ---: |
| 실측 100샘플 | 0.9530 ~ 1.0428 | 2.03% | 2.17% |
| ±3σ 외삽 | 0.9490 ~ 1.0627 | 1.60% | **0.31%** |

**100/100 창 안**이나 ±3σ 외삽 시 상단 여유가 0.31%로 얇다. 원인은 분포 평균
(1.7953 V)이 창 중심(1.8079 V)보다 12.6 mV 아래라 위쪽 보정 수요가 크기 때문.
→ 트림 창 중심 재검토를 BGR에 요청함(§OPEN_ITEMS 참조).

**미해결 관찰**: $V_{ref}$ MC 평균 1.19646 V가 골든(tt/27) 1.186591 V보다
**+0.83%** 높다. 미스매치가 산포뿐 아니라 평균도 이동시킨 것으로 보이며,
BGR 자체 MC에서도 동일 이동이 있었는지 확인이 필요하다.

---

## 3. 미확정 (이게 닫혀야 문서화 완결)

| 항목 | 막는 것 | 상태 |
| :--- | :--- | :--- |
| ~~실소자 R·C 치환 검증~~ | — | **완료** (§2.3~2.5) |
| **Task 6 통합** — 실제 BGR 탭 | 비율계량 end-to-end. `Fref` 자리를 실제 탭으로 | 대기 |
| Task 5 — 기동 클램프, soft-start, 슬루 드라이버 | E6, E3 구현 | 대기 |
| MC — 루프 산포 | 탭 σ 2.6% → UGF ±2.6% (코너 168% 대비 미미할 것) | 대기 |
| D11 — 폴리 절대산포 $\sigma(R)$ | $R_z$ 영점 위치. **결정론적 파라미터는 확정**(#23·#24·#28), σ만 미측정 | 부분 해소 |
| 폐루프 PSRR | Task 6에서 측정 | 대기 |
| 레이아웃 → DRC/LVS → PEX | 최종. PEX는 UGF를 낮추므로 **GM에 유리, 125 °C PM에 불리** | 대기 |

---

## 4. 1차 PEX 실측 기록 (bgr_core 1차 R+C 추출 결과)

* **추출 조건**: `bgr_mos_pex_rc_safe.spice` (R+C, flatten, no coupling, Magic v8.3.678)
* **측정 조건**: tt/27, 트림 중앙코드 `0111` (Code 7)

| 항목 | PEX 실측치 | Schematic 대조치 | 비고 / 판정 |
| :--- | :--- | :--- | :--- |
| **$V_{ref}$** | `1.204760 V` | `1.205412 V` | 오차 $-0.652 \text{ mV}$ (폴리 컨택 $+1,115\,\Omega$이 시트저항 $-1.22\%$ 상쇄) |
| **TC (온도 계수)** | `10.9 ppm/°C` | — | 컨택 기생 성분이 $+2.6 \text{ ppm/°C}$ 기여 |
| **$IB_{EA}$** | `2.560077 µA` | `2.563374 µA` | 오차 $-0.0033 \mu\text{A}$ ($-0.128\%$) |
| **$I_Q$** | `62.054 µA` | `62.2545 µA` | 오차 $-0.201 \mu\text{A}$ ($-0.323\%$) |
| **트림 중앙 전압** | `1.79882 V` | — | 16개 코드 단조성(Monotonicity) 유지 |
| **트림 LSB** | `17.353 mV` | — | — |
| **DNL (tt/27)** | `0.0909` | — | 통과 ($<0.15$) |
| **DNL (ss/125)** | `0.0828` | — | 통과 ($<0.15$) |
| **DNL (ff/-40)** | `0.1152` | — | 통과 ($<0.15$) |
| **Startup 탈출** | 정상 탈출 | — | tt/27 및 ss/-40 최악 코너 정상 검증 |
| **PSRR / Noise** | 2차 PEX 지정 | — | `do coupling` 2차 PEX 추출에서 최종화 예정 |

---

## 5. MiM 물리 제약 및 $C_{out}$ 축소 장부 갱신 (PROMPT_ANTIGRAVITY_MIM_BUDGET)

### 5.1 §1.1 (소자 단위) 신규 행 추가

| # | 항목 | 수치 / 조건 | 비고 |
| :--- | :--- | :--- | :--- |
| **70** | MiM 유닛 용량 | cap_mim_m3_1 W=L=18.310 (684.43 fF) | carea 2.00 + cperi 0.19 모델, gencell 파라미터 실측 검산. 요청 18.3147 ➔ magic 0.005 격자 절사로 18.310 |
| **71** | MiM 유닛 셀 크기 | 20.470 × 18.710 = 382.99 µm² | magic .mag 실측. 순수 캡 면적 335.4 대비 +14.2% 오버헤드 |
| **72** | MiM 최소 셀간 간격 | 1.2 µm (피치 21.67 × 19.91) | magic drc, sky130A (6×7 배열 DRC 실증). 1.1 µm 실패, 지배 룰 `capm.11` (MiM-무관 metal3 1.34) |

### 5.2 §1.4 (틀린 예측) 신규 행 추가 — ★ 핵심

| # | 틀린 예측 | 실제 결과 및 원인 분석 |
| :--- | :--- | :--- |
| **73** | Cout 44유닛의 근거 (회로 요구로 결정된 최적값) | 실제로는 '타일에 넣을 수 있는 최대'였다. $dV = I/(2\pi UGF C_{out})$ 식은 $C_{out}$이 클수록 좋다고만 말하므로 값을 정하지 못한다. 면적 제약이 바뀌자 32유닛으로 축소했고, 하드 스펙이 전부 통과했을 뿐 아니라 PM·startup이 오히려 개선됨. 설계값에 '왜 이 값인가'의 답이 없으면 그것은 제약의 흔적이지 최적화 결과가 아니다. |
| **74** | Cout 축소의 영향 방향 (축소하면 startup 오버슈트가 커져 마진 25 mV가 깨질 것) | 반대로 13% 감소, 마진 25.1 ➔ 32.5 mV. startup peak는 부하 스텝 전하가 아니라 '클램프 해제 후 루프 정착 오버슈트'다. Miller 보상에서 $C_{out}$은 출력극 $p_2 = g_{m,pass}/(2\pi C_{out})$만 정하므로, 축소하면 $p_2$가 밖으로 밀려 PM이 개선되고 정착 오버슈트가 줄어든다. 전하 지배가 아니라 안정도 지배 항목이었다. |
| **75** | 부하 스텝 드룹 스케일링 ($dV \propto 1/C_{out}$ 이므로 Cout 27% 축소 시 드룹 1.375배) | 실측은 예측의 45% 수준. UGF가 2.4887 ➔ 2.6493 MHz (+6.5%)로 함께 올라 상쇄. 순수 Miller라면 UGF는 $C_c$만으로 정해져야 하는데 오른 것은 $p_2$가 UGF를 끌어내리고 있었다는 뜻 ($C_c : C_{out} = 1 : 8$로 극점 분리가 불완전). |
| **76** | release 오버슈트의 Cout 의존성 (Cout에 반비례) | 사실상 불변 (tt/27 +2.1 mV, ll/125 -0.5 mV). 슬루 제한 엣지 1.88 µs가 UGF 주기 377 ns보다 5배 느려 루프가 완전 추종. 오버슈트가 $C_{out}$ 전하가 아니라 루프 추종 오차로 결정됨. |

### 5.3 §2.3 (확정 파라미터) 캡·저항 갱신

| 항목 | 수치 | 조건 및 구조 | 비고 |
| :--- | :--- | :--- | :--- |
| **$C_{out}$** | **21.90 pF** | cap_mim_m3_1 W=L=18.310, MF=m=32 | 6×7 배열 중 32슬롯 |
| **$C_c$** | **2.738 pF** | 동일, MF=m=4 | 변경 없음 |
| **$C_{byp}$** | **2.053 pF** | 동일, MF=m=3 | 변경 없음 |
| **$C_{slew}$** | **1.369 pF** | 동일, MF=m=2 | 4 ➔ 2 축소 |
| **$R_{slew}$** | **590.0 kΩ** | res_high_po_0p69 L=1250.52 | 295.0 ➔ 590.0 kΩ, $\tau$ 보존 |
| **MiM 총량** | **42슬롯 = 28.75 pF** | 유닛 684.43 fF | 타일 수용 상한 정확히 충족 |

### 5.4 Cout 21.90 pF 재검증 (전 항목 통과)

* **DC (tt/27, 전 16코드 .op)**:
  * $V_{ref}(\text{ui}=1000) = 1.205412 \text{ V}$ — BGR 정본과 $0 \ \mu\text{V}$ 일치
  * $V_{out} = 1.670127 \sim 1.928812 \text{ V}$, LSB $17.25 \text{ mV}$, DNL $-0.002 \sim +0.010 \text{ LSB}$
  * 분압비 $1.50006$ (편차 13 ppm), VNB1 전 코드 $1.111935 \text{ V}$ 불변
  * 극성: `ui_in` 값 클수록 $V_{out}$ 큼 (top 인버터 반전 정상)
* **startup (VAPWR 1 µs 램프, .ic cap 0, ui=0111, 19/21 코너)**:
  * peak-final delta $88.8 \sim 127.5 \text{ mV}$ (최악 ll/125)
  * 트림 후(final 1.790) 예상 peak $1.9175 \text{ V}$, $1.95 \text{ V}$ 마진 **32.5 mV**
  * 이전 $C_{out}=30.11 \text{ pF}$ 대비 delta 평균 12% 감소 ($146.1 \rightarrow 127.5 \text{ mV}$)
* **부하 스텝 (이상 전류원 95 µA, 엣지 100 ns, ui=0111)**:
  * tt/27 : Vpre 1.79077 V, 드룹 31.4 mV, peak 1.82414 V, 마진 125.9 mV
  * ll/125 : Vpre 1.80368 V, 드룹 40.1 mV, peak 1.84515 V, 마진 104.8 mV
  * ll/27 : Vpre 1.79749 V, 드룹 25.5 mV, peak 1.82523 V, 마진 124.8 mV
  * ff/-40 : Vpre 1.86151 V, 드룹 21.6 mV, peak 1.88568 V, 마진 64.3 mV
* **release 오버슈트 (2.10 mA ➔ 50 µA, 슬루 제한, 하드 스펙)**:
  * tt/27 : Vpre 1.79077 V, Vmin 1.74229 V, Vmax 1.82314 V, 마진 126.9 mV
  * ll/125 : Vpre 1.80368 V, Vmin 1.73304 V, Vmax 1.84549 V, 마진 104.5 mV
* **폐루프 AC (이중주입)**:
  * tt/27 무부하 : Tdc 95.09 dB, UGF 2.6493 MHz, PM 70.18°, GM 20.98 dB
  * ll/125 무부하 : Tdc 88.21 dB, UGF 2.5310 MHz, PM 65.69°, GM 21.36 dB
  * tt/27 2.10 mA : Tdc 91.96 dB, UGF 2.8587 MHz, PM 97.37°, GM 11.66 dB
  * 최악 PM 65.69° (스펙 45°, 여유 46%) / 최악 GM 11.66 dB (스펙 8 dB, 여유 46%)
* **슬루 엣지 (tt/27)**: rise **1.880 µs** / fall **1.900 µs**, 비대칭 1.06%  
  (기존 295k × 2.727p: 1.869 / 1.839 µs) ➔ $\tau$ 보존 확인

### 5.5 §2.7 (측정 방법론) 항목 추가

RO on/off 부하 스텝을 검증할 때 실제 링을 켜고 tran을 돌리면 111 MHz 진동을 전부 계산해야 해서 시뮬레이션이 사실상 끝나지 않습니다 (1 µs당 111 사이클 × 미세 스텝).

링의 스위칭 디테일은 LDO 응답과 무관하므로 **TB에서 VDDC 포트에 이상 전류원 `Iload VDDC 0 PULSE(0 95u ...)`을 물리는 것**이 정확하고 50배 빠릅니다.

이때 엣지는 `ui_in` 슬루가 아니라 **링이 정상 진폭에 도달하는 시간**(주기 9 ns × 3~5 사이클 = 30~45 ns)으로 잡아야 합니다. 스펙의 100 ns는 여기에 여유를 둔 값입니다.

부수 규율: ngspice 로그가 바이너리로 판정되면 `grep -a`를 씁니다. 그렇지 않으면 `binary file matches`만 나오고 결과를 놓치게 됩니다.

---

## 6. 분압쌍 유닛 통일 및 싱크 m=2 버그 수정 장부 갱신 (PROMPT_ANTIGRAVITY_DIVIDER_SNK)

### 6.1 §1.1 (소자 단위) 신규 행 추가

| # | 항목 | 수치 / 조건 | 비고 |
| :--- | :--- | :--- | :--- |
| **77** | 분압 유닛 저항 | res_high_po_0p69 W=0.69 L=26.5298 (nx=8, u=3.350) | 13,021.2 ohm | tt/27, 레이아웃 선형근사 R=471.0L+525.7 | 분압쌍 3유닛의 1개 |
| **78** | 싱크 부하저항 (병렬 2) | res_high_po_5p73 W=5.73 L=29.80 x2 | 880.3 ohm | tt/27 .op 실측, VDDC 1.790678 n_snk 45.504mV | 단일 유닛 1760.7 ohm |
| **79** | 싱크 스위치 Ron | nfet_01v8 W10 L0.15 m4, VGS=1.79 VDS=45.5mV | 22.95 ohm | tt/27 .op secant, geometry명시 | 이전 세션 23.04와 정합 |
| **80** | 로드 레귤레이션 | 무부하 -> 1.982 mA (싱크 ON) | 92.0 uV | tt/27, ui_in=0111 | 이전 세션 92 uV @2mA 재현 |

### 6.2 §1.4 (틀린 예측) 신규 행 추가 — ★ 핵심

| # | 틀린 예측 | 실제 결과 및 원인 분석 |
| :--- | :--- | :--- |
| **81** | 저항 m=N 이 중첩 서브회로에서 동작 | ldo_core_withbgr_tb 에서 XR_snk m=2 가 880.3 ohm 으로 정상 측정됐으므로 ldo_top_tb 에서도 동작한다 | 미적용. R=1760.7 ohm(단일 유닛), 싱크 전류가 설계 2mA 가 아닌 1.004 mA 였다 | MOSFET 은 sky130 서브회로가 mult 를 내부 소자 m 으로 전달해 깊이 무관하게 동작(ea_fc 2단 깊이 m=24 정상). 저항 서브회로는 mult 를 쓰지 않아 ngspice X-인스턴스 m 에 의존하는데, 최상위(평탄)에서만 먹고 중첩 시 전파되지 않았다. netgen 이 저항 mult 만 인식 못 하는 것(BGR 규약 §2)과 같은 뿌리 |
| **82** | GM 최악 부하 조건 | 1 mA(11.66) 와 2 mA(12.86) 두 점만 보고 "GM 최악점이 최대 부하로 이동" 이라 판정 | 오독. 부하 스윕 결과 GM 은 부하가 걸리는 순간 21.87 -> 13.23 으로 떨어진 뒤 0.75~2.0 mA 구간에서 11.55~11.69 로 평탄. 최소는 1.5 mA 의 11.55 이나 변동 0.14 dB 로 무의미 | 두 점만으로 단조성을 추정하면 안 된다. 게다가 그 1 mA/2 mA 값 자체가 XR_snk m 버그로 잘못 측정된 것이었다(행 81) |
| **83** | 분압 유닛 통일의 효과 범위 | 유닛 통일은 구조적 정합만 개선하고 시뮬 분압비 40 ppm 은 없애지 못한다 | 40 ppm 이 정확히 사라져 1.500000 이 되었다 | 그 40 ppm 이 바로 컨택 헤드 보정 역산의 잔차였다. 유닛 통일로 R2 = 2R1 이 모델상 항등적으로 성립 |

### 6.3 §2.3 (확정 파라미터) — 저항 절 갱신

| 항목 | 수치 | 조건 및 구조 | 비고 |
| :--- | :--- | :--- | :--- |
| **$R_1$ (XRF1)** | **13,021.2 ohm** | res_high_po_0p69 L=26.5298 (u=3.350, nx=8) | 유닛 1개 |
| **$R_2$ (XRF2a+2b)** | **26,042.5 ohm** | 동일 유닛 직렬 2개 | 비율 2.0000 구조적 |
| **분압비** | **1.500000** | tt/27 .op 실측 | 이전 1.50006 |
| **$R_z$** | — | res_high_po_0p69 L=15.480 (u=15.480, nx=1) | |
| **$R_{snk}$** | **880.3 ohm** | res_high_po_5p73 L=29.80 (nx=1) **병렬 2개** | m=2 금지(행 81) |
| **$R_{slew}$** | **590.0 kohm** | res_high_po_0p69 L=625.2498 (u=78.190, nx=8) **직렬 2개** | tau 0.8078 us |

### 6.4 §2.4 (검증 결과) — 전 부하 AC & release & 분압/싱크 재검증

#### 전 부하 AC (이중주입, tt/27, Cout 21.90 pF, ui_in=0111)

이상 전류원 부하 스윕:

| 부하 | Tdc[dB] | UGF[MHz] | PM[deg] | GM[dB] |
| ---: | ---: | ---: | ---: | ---: |
| 0 | 95.09 | 2.6451 | **70.04** | 21.87 |
| 0.25 mA | 100.86 | 3.0616 | 93.61 | 13.23 |
| 0.5 | 101.35 | 3.0784 | 96.22 | 12.04 |
| 0.75 | 101.37 | 3.0798 | 97.23 | 11.69 |
| 1.0 | 101.24 | 3.0775 | 97.76 | 11.58 |
| 1.5 | 100.85 | 3.0694 | 98.32 | **11.55** |
| 2.0 | 100.40 | 3.0597 | 98.59 | 11.63 |

**최악 PM 70.04 deg (무부하, 스펙 45, 여유 56%)**
**최악 GM 11.55 dB (1.5 mA, 스펙 8, 여유 44%)**

PM 최악은 종전대로 무부하다. GM 은 부하가 걸리는 순간 21.87 -> 13.23 으로
떨어진 뒤 0.75~2.0 mA 구간에서 11.55~11.69 로 평탄하며, 최소점을 정밀 탐색할
실익이 없다.

#### ★ 부하 종류가 결과를 바꾼다 (같은 2 mA)

| 2 mA 부하 | Tdc | UGF | PM | GM |
| :--- | ---: | ---: | ---: | ---: |
| 실제 싱크 (880 ohm 저항) | **89.65** | 2.7454 | 97.58 | **12.86** |
| 이상 전류원 | **100.40** | 3.0597 | 98.59 | **11.63** |

Tdc 가 11 dB 차이난다. 이상 전류원은 출력 임피던스가 무한대라 Rout_ldo 를 낮추지
않지만, 저항 부하는 880 ohm 으로 병렬 부하해 루프 이득을 떨어뜨린다. 결과적으로
저항 부하는 GM 에 유리하고 이상원은 불리하다. **post-layout AC 는 두 부하 종류를
모두 포함해야 한다.**

#### release 오버슈트 (2.10 mA -> 50 uA, 슬루 제한, 하드 스펙)

| 코너 | Vpre | Vmin(인가) | 드룹 | Vmax(release) | 1.95 마진 |
| :--- | ---: | ---: | ---: | ---: | ---: |
| tt/27 | 1.79077 | 1.73529 | 55.5 mV | 1.83031 | 119.7 mV |
| ll/125 | 1.80400 | 1.72450 | 79.5 mV | **1.85464** | **95.4 mV** |

Cout 30.11 -> 21.90 pF 축소로 오버슈트가 +9 mV 늘었으나(1.846 -> 1.855) 마진
95.4 mV 로 통과. 드룹은 오히려 68.3 -> 55.5 mV 로 개선(UGF 상승 효과).

#### 분압 유닛 통일 (tt/27, ui_in=0111)

| 항목 | 이전 | 신규 |
| :--- | ---: | ---: |
| 분압비 | 1.50006 (40 ppm) | **1.500000 (0 ppm)** |
| V_out | 1.790769 | 1.790770 (+1 uV) |
| n_rfmid | — | FB_TAP/2 와 0.2 uV 일치 |
| EA 입력 오프셋 | — | 48.0 uV (기존 계통 47.6 과 정합) |

#### 싱크 (m 버그 수정 후, tt/27, ui_in=0111)

싱크 전류 1.9824 mA / R_snk 880.3 ohm / Ron 22.95 ohm / 로드 레귤레이션 92.0 uV
I_max = 분압 45.84 + RO 96.60 + 싱크 1982.4 = **2218.6 uA**

### 6.5 §2.7 (측정 방법론) 항목 추가

### 저항 m=N 은 중첩 서브회로에서 쓰지 말 것

ngspice X-인스턴스의 `m`은 최상위(평탄) 넷리스트에서만 저항에 적용되고, 다른
서브회로 안에 중첩되면 전파되지 않는다. MOSFET·캡은 sky130 서브회로가 `mult`를
내부 소자 파라미터로 전달하므로 깊이와 무관하게 동작한다.

**규율: 저항의 병렬·직렬 배수는 스키매틱에 개별 인스턴스로 명시한다.**
`XR_snk` 병렬 2개, `XR_slew` 직렬 2개, `XRF2` 직렬 2개가 모두 이 규율의 적용이다.
레이아웃도 유닛 단위로 그리므로 오히려 정합이 좋아진다.

검출법: 총 공급 전류 차분으로 검증한다. VAPWR 앞에 0 V 소스를 넣고
`i(VSENSE)`를 부하 on/off 로 재면 `[id]` 접근자 해석에 의존하지 않는다.
(`[id]` 는 이번 케이스에서 올바른 값을 냈으나, 접근자가 m 을 반영하는지는
소자·버전마다 다를 수 있다.)

### RO 5단 축소 검증 (tt/27, ui_in=0111)

| 항목 | 예측 | 실측 | 오차 |
| :--- | ---: | ---: | ---: |
| f_osc | 244.0 MHz | **243.97** | −0.01% |
| DIV_OUT | 15.25 MHz | **15.248** (분주비 16.00) | — |
| I_RO | 94 uA | **96.60** | +2.8% |

f 비 2.200 = 이론 11/5 정확히 일치. t_pd 불변 가정이 맞았고 NAND 지연 편차도
비율이 유지되었다.

**직교성 2차 실증**: 단수 11 -> 5 (절반 이하)에 I_RO 가 95.07 -> 96.60 uA 로
1.6% 이내 불변. 부하 스펙·과도 검증 전부 유효 유지.

### 분주기 고속 검증 (ss/125 최악 코너)

| 입력 | q1 | q2 | q3 | q4 | 판정 |
| ---: | ---: | ---: | ---: | ---: | :--- |
| 244 MHz | 122.00 | 61.00 | 30.50 | 15.25 | ratio 2.0000 x4 |
| **356 MHz** (ff 최악) | 178.00 | 89.00 | 44.50 | 22.25 | ratio 2.0000 x4 |

이 조건은 과보수적이다 — RO 356 MHz 는 ff 코너(빠른 소자)이고 DFF 는 ss/125
(느린 소자)인데, 같은 다이가 ff 이면서 ss 일 수 없다. 실여유는 이보다 크다.

### 표준셀 레이어 (배치 자유도)

`sky130_fd_sc_hd__dfxbp_1` .mag 전층 덤프:
  locali, metal1, poly, ndiff/pdiff, ndiffc/pdiffc, nwell/pwell, polycont, viali
  -> **met2 · met3 · met4 = 0건**

따라서 `div16_core`(DFF 4개)를 MiM 뱅크 아래에 겹쳐 배치할 수 있다(capm.11 무관).
`ro_inv`/`ro_nand` 도 gencell 소자 + met1 배선이라 같다. **RO 트랜지스터 전체가
뱅크 아래로 들어간다.** 제약이 남는 것은 MiM 부하캡뿐이다.
