wecallemjazzyfact/TinyTapeout-BGR-LDO/04_LDO_스펙.md

# 04_LDO_스펙.md (LDO 목표 사양 및 아키텍처 확정서)

최종 갱신: 2026-07 — EA 극성 재판정, C_byp 신호결합 대책, PG 급전 레일, thin-ox LUT 기반 RO 전략 반영

### TL;DR (4줄 요약)
1. VAPWR 3.3 V → 1.8 V, 부하 50.8 µA ~ 2.10 mA의 point-of-load LDO 목표 사양과 그 도출 근거를 규정합니다.
2. **PMOS 입력 Folded-Cascode EA + PMOS pass** 구조이며, 극성 근거는 V_ICM 헤드룸 실측입니다(과거 "출력 스윙" 논리는 폐기).
   BGR-EA 신호결합으로 인한 위상마진 붕괴는 $C_{byp}$(§3.4)로, power-good은 VAPWR/thick-ox 급전(§6.1)으로 방어합니다.
3. capless + 소면적의 과도응답 물리 한계를 계산하여 스펙을 3단 계층화하고, Task 2의 목적함수를 `C_out × UGF` 최대화로 확정했습니다.
4. RO는 최소 L + 명시적 MiM 부하캡으로 전류·주파수·단수를 직교시킵니다 — thin-ox gm/Id LUT(`lut/README.md`)가 근거입니다.

> **판정 근거와 대체 이력은 `designs/bgr_ldo/ldo/DECISIONS.md`가 정본**입니다.
> 이 문서는 결론의 요약이며, 충돌 시 DECISIONS.md를 따르십시오.

---

## 1. 확정 스펙 및 최종 실측치 (Post-layout PEX R+C)

| 항목 | 동작 조건 | 설계 규격 (목표) | 최종 실측치 (PEX R+C) | 판정 및 평가 |
| :--- | :--- | :---: | :---: | :--- |
| **출력 전압 ($V_{out}$)** | 전 코너·온도, 트림 후 | **1.8 V ±2%** (±36 mV) | **`1.82725 V`** (tt/27, code7) | **PASS** (4-bit 디지털 트림으로 1.800V 수렴) |
| **★ 몬테카를로 3-sigma** | tt_mm, N=299, Mismatch-only | **< ±36 mV** (±2%) | **`15.220 mV`** ($\sigma = 5.073\,\text{mV}$) | **PASS (2.4배 안전 마진 사수)** |
| **부하 범위 ($I_{load}$)** | — | **50.8 µA ~ 2.10 mA** | **`50.8 µA ~ 2.22 mA`** | **PASS** (Task 5 슬루 드라이버 확정) |
| **소모 전류 ($I_Q$)** | 무부하, 분압기 포함 (RO 제외) | **< 150 µA** | **`~131 µA`** | **PASS** (BGR 62 + EA ~18 + 분압 51) |
| **Line Regulation** | VAPWR 3.0 → 3.6 V ($10\,\mu\text{s}$ 슬루) | **< 2 mV/V** | **`Dip -2.78 mV / Over +1.95 mV`** | **PASS** (우수한 전원 감도) |
| **Load Regulation** | 50 µA → 2.10 mA DC | **< 5 mV** | **`92 µV`** | **PASS** (스펙 5 mV의 1.8%) |
| **PSRR @DC / @100k** | 2.10 mA 부하 | **> 50 dB / > 20 dB** | **`-51.9 dB` / `-27.7 dB`** | **PASS** (1M: -9.2 dB) |
| **위상 마진 (PM)** | 부하 전영역 × tt/ss/ff ($C_c$ cap_low) | **> 45°** (tt > 60°) | **`69.8°` (최악 무부하)** | **PASS** (GM 최악 11.5 dB @1.5mA) |
| **과도 응답 (실사용)** | 50 µA → 2.10 mA (SNK_EN $1\,\mu\text{s}$) | **ΔV < 100 mV** | **`Under -56.3 mV / Over +28.9 mV`** | **PASS** (1.98V 대비 124 mV 마진) |
| **★ 오버슈트 하드 스펙** | 부하 release 2.10 mA → 50 µA | **< 1.95 V (hard)** | **`1.829 V` (Over +28.9 mV)** | **PASS** (01v8 부하 소자 안전 보호) |
| **기동 시간 (Startup)** | 전 코너 정상 기동 | **< 100 µs** | **`25 µs` 정착, 오버슈트 `+44 mV`** | **PASS** (False-lock 없음) |

---

## 2. 부하 범위의 도출

### $I_{min} = 50.8\,\mu\text{A}$ — 선택이 아니라 유도값
피드백 분압기가 반드시 있어야 하고 그 전류가 곧 최소 부하다. 양쪽에서 조여진다:

| 방향 | 제약 | 한계 |
| :--- | :--- | :--- |
| R 크게 (I 작게) | 경부하 출력극 하강 → **PM 붕괴** | 25 µA면 pass의 $r_o$·$R_{div}$ 둘 다 2배 → **출력극 545 kHz → 271 kHz** |
| R 작게 (I 크게) | **$I_Q$ 예산** | 200 µA면 BGR(60 µA)보다 커진다 |

→ **25 ~ 100 µA가 창, 50 µA가 중앙.**
**$R_a$ = 4유닛(11.8 k), $R_b$ = 8유닛(23.6 k), 비 1.5 정확.** BGR 유닛저항 재사용.
**분압기가 최소부하를 겸하므로 별도 더미 부하가 불필요** — 설계 의도의 증거.

### $I_{max} = 2.10\,\text{mA}$ — Task 5 슬루 드라이버 확정치

구 스펙 4 mA는 온칩 캡만으로 물리적으로 불가능함(§4 과도 물리 한계)이
확인된 뒤, 슬루 드라이버로 실현 가능한 값을 재확정했다.

**A안 채택**: 부하 싱크를 3브랜치(0.5/1/2 mA)에서 **단일 2 mA 브랜치**로
통합하고, 슬루 드라이버(직렬 폴리 저항 + MiM 캡, RC)를 1벌만 배치했다.
브랜치별 드라이버 3벌은 면적 대비 이득이 작아 기각.

$$I_{max} = I_{div}(45.84\,\mu\text{A}) + I_{RO}(96.60\,\mu\text{A}) + I_{snk}(1982.4\,\mu\text{A}) = 2218.6\,\mu\text{A} = \mathbf{2.22\,\text{mA}}$$

| | 구 스펙 | **신 스펙** |
| :--- | ---: | ---: |
| $I_{max}$ | 4 mA | **2.10 mA** |
| 부하 범위비 | 80배 | **46배** |
| 최대 전력 (@1.8V) | 7.2 mW | **3.8 mW** |

**서사 갱신**: "상시 온 소형 디지털 도메인용 point-of-load 레귤레이터"는
유지하되 규모 표현을 "6만 게이트급"에서 **"3만 게이트급"**으로 낮춘다.

**검증(tt/27, ll/125, Task 5)**: 게이트 슬루 엣지 1.85 µs 양방향(대칭
0.69%), release 오버슈트 마진 104~129 mV(1.95 V 대비), 인가 시 PG 문턱
대비 마진 82.5~104 mV, 로드 레귤레이션 92 µV(스펙 5 mV의 1.8%), 폐루프
AC 무간섭(PM/GM 변화 <0.1).

---

## 3. 회로 아키텍처

### 3.1. Pass device — PMOS
`sky130_fd_pr__pfet_g5v0d10v5`. 실측 앵커(W=400/L=0.5/nf=1, 기본 geometry, VSG 1.3/VSD 1.5, tt/27):

| 항목 | 값 |
| :--- | ---: |
| $I_D$ | 3.058402 mA |
| $v_{dsat}$ | 0.2825014 V |
| $g_m$ | 14.87254 mS |
| $g_{ds}$ | 581.4709 µS |
| $C_{gg}$ | **326.1773 fF** |
| $C_{gd}$ | **2.479913 fF** |

**제약 구조**
| ID | 제약 | 방향 | 상태 |
| :---: | :--- | :---: | :--- |
| C1 | 포화 유지 | W 하한 | **binding 아님** — vdsat 0.283 V @3 mA로 여유 큼 |
| C2 | 게이트 드라이브 | — | 여유. folded cascode 출력 하한 ≈ 0.5 V → $V_{SG}$ 최대 ~2.5 V |
| C3 | **EA 출력 천장** | **W 상한** | $V_{SG}(I_{min}) > 2V_{ov,p} + $ 마진. ff/125 °C에서 마진 100~200 mV |
| C4 | **OFF 능력/리키지** | **W 상한** | $I_D(V_{SG}{=}0.4, \text{ff}, 125°C) \le 0.2 I_{min}$ |
| C5 | **$C_{gg} \le 0.15\,C_c$** | **W 상한** | $p_2 \propto C_c/(C_c{+}C_{gg})$. $C_c$=2 pF → $C_{gg}$ ≤ 300 fF → **W=400은 경계** |

→ **C1이 하한, C3/C4/C5가 상한. W=400에서 아래로 탐색할 것.**
레이아웃은 **m × (W=10 µm 핑거)** — LUT 잔여 폭 의존성(~2%)과 정석 양쪽 이유.

**`m`과 `nf`의 관계 (lut/README.md §9.8)**: 게이트 저항에서 둘은 동등하다
($R_g$는 핑거 하나의 폭으로 정해지고, 병렬 개수가 m이든 nf든 같게 나눈다).
차이는 접합 용량뿐이며(`W=nf×핑거`가 확산을 공유해 `ad/as`가 약 절반), 우리 노드에서는
무시 가능하다(pass 드레인 = LDO 출력, MiM 30 pF 대비 ~58 fF 차이는 0.2%).
**LUT 정확도 관점에서는 `m × (W=10, nf=1)`이 유리**하다 — BSIM4가 핑거 폭(W/nf)으로
bin을 고르므로 이 구성이 기준폭에 정확히 안착한다. `nf`를 실제로 쓰는 이유는 면적·종횡비 같은
**레이아웃 사유**이며 Task 8에서 확정한다. 지금 스키매틱을 다시 그릴 필요는 없다.

$C_{gg}$의 진짜 역할은 극점이 아니라 **EA 슬루율 $(C_c + C_{gg})/I_{EA}$** 이며,
오버슈트 < 1.95 V 하드 스펙이 여기 걸린다.

### 3.2. EA — PMOS 입력 Folded-Cascode ★
**근거 정정**: 과거 "출력이 상단으로 스윙해야 하니 PMOS 폴딩 → NMOS 입력" 논리는 **틀렸다.**
folded cascode의 출력 스윙은 **출력단 캐스코드 미러가 정하며 입력 극성과 무관**하다
(두 극성 모두 $[2V_{dsat,n},\, V_{DD} - 2V_{dsat,p}]$).

실제 근거는 **$V_{ICM}$ 헤드룸**이며, ss/−40 °C 실측(L=2, W=10)에서:

| | 실측 $V_{th}$ | 헤드룸 마진 |
| :--- | ---: | ---: |
| nfet ($V_{SB}$=0 / 0.15 V) | 0.9056 / 0.9656 V | **34 mV** |
| pfet ($V_{SB}$=0) | 1.1916 V | **708 mV** |

thick-ox $V_{th}$가 0.9~1.2 V인 공정에서 $V_{ICM}$ = 1.2 V는 3.3 V mid-rail(1.65 V)보다 아래이므로
**처음부터 PMOS 입력 영역**이었다.

**부수 이점**: tail 캐스코드 가능(→ PSRR), 자체 nwell이라 바디효과 없음, 1/f 낮음, LUT 안에 머묾.
**인정한 반대 논거**: NMOS tail은 접지에 붙어 원리상 PSRR 유리하나, PMOS는 캐스코드 가능·NMOS는
헤드룸상 불가이므로 실질 역전.

**역할별 gm/Id 배정 (Task 3 출발점)**
| 역할 | gm/Id | L | 근거 |
| :--- | ---: | ---: | :--- |
| 입력쌍 (PMOS) | 15~18 | 1~2 µm | gm 효율 최대 → UGF 확보. 노이즈 유리 |
| 폴딩 전류원 (NMOS) | **5~7** | 2~4 µm | gm을 낮게 유지해야 미러 미스매치의 입력환산 오프셋 축소 |
| cascode | 8~12 | 0.5~1 µm | $v_{dsat}$ 헤드룸과 속도 절충 |
| tail (PMOS, 캐스코드) | 5~7 | 4 µm | 전류 정확도, 낮은 $g_{ds}$ |

> **원칙**: 신호 경로는 gm/Id 높게, 잡음·오프셋 경로는 gm/Id 낮게.

### 3.3. 보상
표준 Miller + $R_z$ 1순위. $C_{gd}$ 2.5 fF로 pass 자체 Miller가 무시 가능하므로 RHP zero 위협이 낮다.
Ahuja는 PSRR 개선 옵션.

**$C_c$ = 12.8 pF는 레퍼런스(devstdin) 복사값이며 우리 설계값이 아니다. Task 2의 출력이지 입력이 아니다.**

### 3.4. ★ $C_{byp}$ — BGR-EA 신호 결합 억제 (2 pF, 잠정값)

folded cascode 단일단 구동 시 발생하는 위상마진 붕괴를 막기 위한 소자다.

**메커니즘**: LDO 피드백($V_{inp}$)이 흔들리면 입력 PMOS 하나(M1)가 소스 팔로워처럼
동작해 공통 소스 노드($V_{tail}$)를 흔든다. 이 흔들림이 반대쪽 입력 PMOS(M2)의
$C_{gs2}$를 타고 **BGR 출력 노드**($V_{inn}$)로 건너간다. BGR 출력 임피던스가
크므로(121 kΩ) $V_{inn}$이 함께 흔들려 차동 입력 $(V_{inp}-V_{inn})$이 부분 상쇄되고,
**위상마진이 21° 무너진다** ($41.4° \rightarrow$ 붕괴 전 값).

**해결**: $V_{inn}$ 노드에 $C_{byp}$를 달아 고주파 전압 분배비
$C_{gs2}/(C_{gs2}+C_{byp})$를 **0.49 → 0.149**로 낮춰 결합 전압을 죽인다.
$C_{gs2} \approx 358\,\text{fF}$ 기준 $C_{byp} = 2\,\text{pF}$에서 **위상마진 63.5°로 회복**.

**부수 효과**: BGR 고주파 노이즈의 저역통과 필터링. 또한 기동 램프 지연
$\tau = R_{out}C_{byp} \approx 248\,\text{ns}$가 형성되어 소프트스타트를 보조한다
(상용 LDO의 NR/BYP 핀 커패시터와 원리가 같다). 단, $\tau$가 짧아 이것만으로
오버슈트 < 1.95 V 하드 스펙을 만족하지 못한다 — **별도 soft-start가 여전히 필요**하다(Task 5).

**주의 2건**
1. $C_{gs2} = 358\,\text{fF}$는 **intrinsic 값일 가능성이 크다** (LUT 규약, D6).
   실효값은 $+W \cdot C_{GSO}$ 보정이 필요하며, 입력쌍이 $W \approx 110\,\mu\text{m}$급이면
   오버랩 $\approx 21\,\text{fF}$가 더해져 분압비가 0.149 → 0.157로 약 5% 나빠진다.
   결론은 유지되나 정밀 검증 시 반영할 것.
2. $C_{byp}$는 **잠정값**이다. Task 3에서 입력쌍을 gm/Id로 재사이징하면 $C_{gs2}$가
   바뀌므로, 절대값보다 **$C_{byp} \approx 6 \times C_{gs2,\text{eff}}$ 비율**로 기억할 것.
   면적은 MiM 적층(4 fF/µm²) 기준 ~500 µm²로 §3.1 예산 안이다.

### 3.5 Startup 클램프 (기동 과도 오버슈트 방어)

기동 중 EA/BGR 바이어스가 확립되기 전 pass PMOS가 무방비로 열려 VDDC가
2.383 V까지 상승하는 문제(§DESIGN_JOURNEY Ch.LDO-13)를 막는다.

**구조**: pass 게이트(`PASS_GATE`)를 VAPWR로 끌어올려 pass를 강제 OFF하는 보조
PMOS. 그 게이트는 **VREF_LOW 감지 인버터 2단**이 구동한다(자기감지).

| 소자 | 모델 | W / L | 역할 |
| :--- | :--- | :--- | :--- |
| `XM_i1n` | `nfet_g5v0d10v5` | 10 / 2 | inv1 pull-down (VREF 센스) |
| `XM_i1p` | `pfet_g5v0d10v5` | 1 / 20 | inv1 pull-up (약하게) |
| `XM_i2n` | `nfet_g5v0d10v5` | 1 / 1 | inv2 |
| `XM_i2p` | `pfet_g5v0d10v5` | 3 / 1 | inv2 |
| `XM_clamp` | `pfet_g5v0d10v5` | 10 / 2 | 클램프 본체 (D=`PASS_GATE`, S=VAPWR) |
| `XC_boost` | `cap_mim_m3_1` | W=L=5 µm (50 fF) | VAPWR → `n_cl1` 결합 |

**동작**: VREF=0 → `n_cl1`=VAPWR → `CLAMP_GATE`=0 → 클램프 $V_{sg}$=3.3 V
(250 µA)로 pass 게이트 상승 → **pass OFF**. VREF가 트립점(약 0.85 V)을 넘으면
→ `n_cl1`=0 → `CLAMP_GATE`=3.3 V → **클램프 완전 OFF**.

**실측 (tt/27, `.op` 정착 상태)**

| 항목 | 값 |
| :--- | ---: |
| `CLAMP_GATE` | 3.300000 V |
| `n_cl1` | 4.03 mV |
| `XM_clamp` $I_D$ | 1.39e−17 A (완전 OFF) |
| `XM_i1p` $I_D$ (inv1 관통) | 0.9446 µA |
| `XM_i2p` $I_D$ | 3.59 pA |
| VDDC | 1.791322 V (클램프 없을 때와 6자리 동일) |

**릴리즈 시각이 코너에 자동 연동된다** — 실측 2.42~3.00 µs 분포로, 각 코너의
VREF 확립 시각을 그대로 따라간다. 외부 enable 하드코딩으로는 얻을 수 없는 성질이다.

**$C_{boost}$의 역할**: 클램프만으로는 VAPWR가 빠르게 인가될 때 진다. t=0에
`n_cl1`=0이면 inv2의 pfet이 ON이라 `CLAMP_GATE`가 VAPWR를 따라 올라가 **클램프가
꺼진 상태로 출발**하기 때문이다(정상 DC 해에 도달하려면 inv1의 약한 pfet 3.3 µA가
`n_cl1`을 충전해야 하는데 약 5 ns 소요). `XC_boost`가 빠른 엣지에서 용량 분압으로
`n_cl1`을 즉시 끌어올려 이를 해결한다. **정적 전류 증가 0**(DC 차단),
느린 램프는 기존 DC 경로가 담당하는 상보 구조 — 슬루 드라이버 RC와 같은 철학이다.

### 3.6 TRIM 극성 반전 인버터

TT 멀티플렉서는 비활성 설계의 `ui_in`을 0으로 묶고, 선택 시 패드 값을 연결한다.
사용자가 패드를 설정하지 않으면 `ui_in=0000`이 기본이다. 그런데 BGR 트림 극성이
`TRIM=1 → 세그먼트 단락 → R2 감소 → V_out 감소`이므로 **`ui_in=0000` = V_out
최대**가 되어, ff/27에서 final 1.994 V로 **정상 상태에서 1.95 V를 초과**한다
(과도 스파이크가 아니라 트림 전까지 계속 유지되므로 startup 오버슈트보다 위험).

**해결**: top에 thin-ox 인버터 4쌍을 두어 하드웨어로 반전한다.

| 소자 | 모델 | W / L |
| :--- | :--- | :--- |
| `XM_tin0~3` | `nfet_01v8` | 2 / 0.15 |
| `XM_tip0~3` | `pfet_01v8` | 4 / 0.15 |

결선: `ui_in[3:0]` → `TRIM[3:0]` → 인버터 → `Trim[3:0]b` → `bgr_core.TRIM[3:0]`.
VDPWR 급전.

**실측 (tt/27, 1 µs 램프)**

| `ui_in` | final | peak |
| :--- | ---: | ---: |
| **0000 (기본값)** | **1.6706 V** | 1.7879 V |
| 1111 | 1.9294 V | 2.0631 V |

기본값이 최소 전압(가장 안전)으로 뒤집혔다.

**★ 소프트웨어 코드 반전 폐기**: BGR HANDOFF §3의 "하드웨어에 인가할 값 =
~(원하는_코드)"는 **취소**한다. 하드웨어가 반전하므로 소프트웨어에서 또 반전하면
이중 반전이 되어 원위치다. 새 매핑은 직관과 일치한다 — **`ui_in` 값이 커질수록
V_out이 커진다.** BGR 내부 극성(TRIM=1 → V_out 감소)은 변경 없으며, 반전은
전적으로 LDO top에서 일어난다.

---

## 4. ★ 과도응답 물리 한계와 Task 2 목적함수

$$\Delta V_{droop} \approx \frac{I_{step}}{2\pi \cdot UGF \cdot C_{out}}$$

$C_{out}$ = 30 pF, UGF = 10 MHz(공격적)에서 $Z_{peak}$ = 530 Ω:

| 스텝 | 드룹 |
| :--- | ---: |
| 100 µA | 53 mV |
| 500 µA | 265 mV |
| **2.10 mA** | **2.1 V — 붕괴** |

**2.10 mA 고속 스텝은 온칩 캡만으로 물리적으로 불가능하다.**
외부 캡도 무용지물 — ua 경로 500 Ω × 1 µF의 코너가 318 Hz.

이것은 결함이 아니라 **capless + 2. **특성 부하** — 단일 2 mA 싱크 + 슬루 드라이버(RC) 1벌.
   01v8 스위치 (`ui_in[4]`).

   **★ 슬루 드라이버 버퍼는 VDDC(LDO 출력) 급전이다.** 초기안은 VDPWR이었으나
   VDDC로 변경했다. 이유:
   (a) **자기 순서화** — LDO가 서야 싱크가 켜진다. 기동 중 `ui_in[4]`=1이어도
       VDDC가 낮으면 버퍼가 동작하지 않아 부하 충돌이 원천 차단된다.
   (b) **논리 정합** — LDO 오버슈트를 막는 회로가 LDO 자신의 출력으로 동작한다.
   비용: 정상 상태 소비 0(CMOS), 전이 중 $R_{slew}$ 통과 최대 6.0 µA(τ=0.8 µs 감쇠,
   총 전하 ~4 pC), $R_{on}$ 22.88 → 23.04 Ω(+0.7%).

   **VDDC 급전 판 실측 (tt/27)**

   | 항목 | VDPWR 판 | VDDC 판 |
   | :--- | ---: | ---: |
   | `vg_snk` high | 1.800 V | 1.7799 V |
   | 싱크 $I_D$ | 1.9706 mA | 1.9702 mA |
   | $R_{on}$ | 22.88 Ω | 23.04 Ω |
   | 슬루 rise / fall | 1.852 / 1.839 µs | 1.869 / 1.839 µs |
   | $V_{min}$(인가) | 1.719 V | 1.723 V |
   | $V_{max}$(release) | 1.821 V | 1.821 V |
   | `net6` / `VNB1` | — | 1.186591 / 1.111989 (불변) |

   RC 시상수가 수동 소자(295.0 kΩ × 2.727 pF)로 정해지므로 공급 전압이 3.2% 흔들려도
   엣지는 0.9%만 변한다.

### 5.2. 측정 — `ua[0]`의 함정
BGR 출력 임피던스가 **121 k**이므로 10 MΩ 입력 DMM으로 재면 **1.2% 분압 오차**
(트림 LSB 0.44%의 3배). 레퍼런스 `cw_vref`는 이 문제로 테스트 버퍼를 내장하고 외부 바이어스 핀까지 썼다.

**우리 해법: 버퍼 없이 SMU/전위계(입력 >100 MΩ)로 측정.** 비용 0, 오차 0.001%.
`ua[1]`(= 1.5 × $V_{ref}$)와의 교차검증이 캘리브레이션을 대신한다.

### ★ 트림은 `ua[1]`(V_out) 기준으로 수행한다

트림은 BGR의 $R_2$를 조정해 $V_{ref}$를 비례 스케일한다. 루프 평형에서

$$V_{out} = \frac{V_{ref} - V_{os}}{\beta}$$

이므로, 특정 칩의 오프셋 $V_{os}$와 분압비 $\beta$가 무엇이든 **그 칩에서
$V_{out}$이 1.800 V가 되도록 $V_{ref}$를 고르면** 세 오차원이 모두 흡수된다:
BGR 공정 산포(원래 목적), 분압비 미스매치, EA 입력 오프셋.

| 트림 기준 | 관측 핀 | 잔여 오차 (MC-A 기반) |
| :--- | :--- | ---: |
| $V_{ref}$ = 1.200 V | `ua[0]` | ±21.73 mV |
| **$V_{out}$ = 1.800 V** | **`ua[1]`** | **±8.01 mV (양자화만)** |

**2.71배 개선이며 하드웨어 변경이 전혀 없다.** 측정 절차만 바꾸면 된다.

부작용 점검:

| 항목 | 영향 |
| :--- | :--- |
| $V_{ref}$가 1.2 V에서 이탈 | ±1.12% (±13.4 mV). $V_{ICM}$ 헤드룸(PMOS 708 mV)에 무해 |
| BGR TC | $R_2$ 비례 스케일이라 ppm/°C 보존 (`01_BGR_최종스펙.md` §6.3) |
| 트림 범위 소요 | BGR ±6.6%에 LDO ±1.12% RSS 합성 → ±6.69%. 0.09%만 증가 |
| 온도 드리프트 | 트림은 1회성 DC 보정. 분압비는 동일 재질이라 비 드리프트 무시, EA 오프셋 드리프트만 잔존(작음) |

`ua[0]`(V_ref)은 교차검증용으로 유지한다.

### 5.3. 노이즈 항의 지위
§1의 20~30 µV/√Hz는 **목표가 아니라 구조적 예측**이다.
레퍼런스 실측이 보여준 구조는 "LDO 자체 1.8~1.9 µV/√Hz vs 밴드갭 13~19 µV/√Hz × 이득 1.5"이며,
**LDO EA를 아무리 조용히 만들어도 BGR × 1.5가 바닥**이라는 뜻이다.
절대치는 우리 BGR 노이즈 측정(PEX 후) 이후 확정한다. **PASS/FAIL 판정 대상이 아니다.**

### 5.4. 라인 레귤레이션의 슬루 조건

VAPWR 0.6 V 스텝 시 VDDC 응답(tt/27, 정상 트림):

| VAPWR 슬루 | VDDC max |
| :--- | ---: |
| 6 V/µs | 2.088 V (1.95 초과) |
| 0.6 V/µs | 1.818 V |
| 0.06 V/µs | 1.779 V |

이는 클램프·$C_{boost}$와 무관한 **고주파 PSRR 한계**다. 루프 UGF(2.5 MHz) 밖의
대역에서 pass의 $C_{gd}$를 통해 공급 변동이 직접 관통한다(클램프 유무로 차이
0.01 mV 확인). 6 V/µs는 비현실적 자극이며(0.6 V는 VAPWR의 18%), 실제 리플은
수십 mV 수준이다. **라인 레귤레이션은 VAPWR 슬루 ≤ 1 V/µs 조건에서 규정한다.**

### 5.5. 핀 배정

| 핀 | 신호 | | 핀 | 신호 |
| :--- | :--- |---| :--- | :--- |
| `ui_in[3:0]` | TRIM[3:0] | | `uo_out[0]` | **DIV_OUT** |
| `ui_in[4]` | **SNK_EN** | | `uo_out[7:1]` | 미사용 (project.v 가 0) |
| `ui_in[5]` | RO_EN | | `ua[0]` | VREF_LOW |
| `ui_in[7:6]` | 미사용 | | `ua[1]` | **VDDC (트림 기준)** |
| `uio[7:0]` | 미사용 | | `ua[7:2]` | 미연결 (D26 참조) |

**변경 사유**: `ui_in[0]`~`ui_in[5]`가 물리적으로 인접해 배선이 짧아진다. 기존
`ui_in[7]` 배정은 임의였고 전기적 이유가 없었다.

### 5.6. 전원 인가 시 입력 권장 상태

| 핀 | 권장 | 이유 |
| :--- | :---: | :--- |
| `ui_in[3:0]` (TRIM) | **0000** | top 인버터 반전으로 V_out 최소(가장 안전). TT 가 비활성 시 0 으로 묶으므로 기본값이 이미 안전 |
| `ui_in[4]` (SNK_EN) | **0** | 부하 에뮬레이터 OFF |
| `ui_in[5]` (RO_EN) | **0** | 링 발진기 OFF |

RO_EN/SNK_EN 이 1 인 채로 전원이 인가돼도 회로는 안전하다 — 게이트 산화막 전압이
정상 동작 시(pfet V_sg = 1.79 V)와 같은 1.8 V 이고, 싱크 버퍼가 VDDC 급전이라
VDDC=0 이면 vg_snk 가 C_slew 로 0 에 묶여 싱크가 꺼져 있다(자기 순서화).
권장일 뿐 필수는 아니다.

### 5.7. 외부 enable 이 없는 이유

LDO 는 VAPWR 인가 시 자동 기동한다. 별도의 LDO_EN 포트는 없으며, 기동 과정은
**자기감지 클램프**(VREF_LOW → 인버터 2단 → 클램프 PMOS)가 관리한다.

외부 enable 을 쓰지 않은 이유는 §3.5(startup 클램프)에 기록된 대로다 —
① 1.8 V 로 클램프 게이트를 직접 못 끔(레벨시프터 필수)
② 레벨시프터가 VDPWR 에 의존해 "VDPWR 부재 시 출력 부유" 위험
③ release 타이밍을 외부가 하드코딩해야 함
④ 사용자 시퀀싱 실수 시 복구 불가

자기감지는 release 가 BGR 확립에 자동 연동되어 코너별로 2.42~3.00 us 로 분포한다.

1. **RO 데모 부하** — 일반 인버터 링(01v8) + 분주기 → `uo_out[0]`. **VDDC 급전**
   (f를 LDO 출력전압의 프록시로 쓰는 **텔레메트리** 겸 부하).
   current-starved 불채택 — 그 구조는 공급 전압에 둔감하나 **우리는 f ∝ V 오차가 이 데모의 핵심**이므로 민감도가 기능이다
   - **설계 공간이 직교**: $I_{avg} = NCV/(2N t_{pd}) = CV/(2t_{pd}) \approx I_{D,sat}$(1단)이라 **N이 소거된다**
     → **W(일괄 스케일) → $I_{RO}$**, **N(단수) → $f \propto 1/N$**
   - **★ L은 최소(표준셀 호환), f는 명시적 부하캡으로 제어 — L을 f 제어에 안 쓰는 이유**:
     $L$을 키우면 $t_{pd} \propto L^2$로 늘지만 $I \approx I_{D,sat}(\text{1단}) \propto 1/L$도
     함께 줄어 RO가 최소부하 역할을 못 하게 된다. 반대로 최소 $L$(0.15 µm)은 $t_{pd}$가
     수십 ps대라 5단에서 f가 **GHz대**로 치솟아 분주기 첫단이 못 받는다.
     **명시적 MiM 부하캡**을 노드마다 달면 $t_{pd} \propto C$이지만 $I=CV/(2t_{pd})$라
     **전류는 불변** — W(전류)·C(주파수)·N(단수)이 완전히 직교한다.

   **확정 사이징** (tt/27, 단독 TB 실측)

   | 블록 | 소자 | W / L | m |
   | :--- | :--- | :--- | ---: |
   | 인버터 nfet ×4 | `nfet_01v8` | 0.42 / 0.15 | 1 |
   | 인버터 pfet ×4 | `pfet_01v8` | 1.0 / 0.15 | 1 |
   | NAND nfet (직렬 2) | `nfet_01v8` | 1.0 / 0.15 | 1 |
   | NAND pfet (병렬 2) | `pfet_01v8` | 1.0 / 0.15 | 1 |
   | 부하캡 ×5 | `cap_mim_m3_1` | W=L=4.27 µm (전부 동일) | 1 |

   구성: NAND 1단(enable) + 인버터 4단 = **5단 홀수**, 탭 버퍼 2단(부하캡 없음).
   부하캡은 셀 안이 아니라 탑레벨에 배치 — f 튜닝의 유일한 노브이므로 한눈에 보이게 한다.

   **실측 (tt/27, VDDC 1.79075 V, ui_in=0111)**

   | 항목 | 값 |
   | :--- | ---: |
   | $f_{osc}$ | **243.97 MHz** |
   | $I_{RO}$ | **96.60 µA** |
   | DIV_OUT | **15.248 MHz** (÷16) |

   **★ $I_{sat}$은 실효 구동전류를 1.6배 과대평가한다.** LUT 조회 $I_{sat}$ = 153.6 µA
   기준으로 f=200 MHz를 설계했으나 실측 110.9 MHz. $f = I/(2NCV)$에 실효전류 비 0.61과
   용량 비 1.10을 넣으면 200×0.61/1.10 = 111 MHz로 실측과 일치한다. 전이 중 소자가
   포화를 벗어나 삼극관으로 들어가므로 평균 구동전류가 $I_{sat}$보다 작다
   (alpha-power law 보정 계수 0.6~0.7과 정합).

    ### 축소 사유

    RO 부하캡(MiM)은 met3/met4를 쓰므로 MiM 뱅크와 capm.11(무관 met3 간격 1.34 µm)로
    충돌한다. 뱅크가 die x 10…132.82 / y 3.5…138.37을 덮어 뱅크 밖 여백이 서편 8.66 /
    동편 11.2 µm뿐이고, 세로 피치 5.810으로 한 열에 5개가 한계다.

    부하캡을 뱅크 안 빈 슬롯에 넣는 것은 불가능하다. 상판(met4)을 링 노드로 끌어내려면
    뱅크의 VGND met3 시트를 관통해야 하고, 시트에 구멍을 내면 capm.11이 걸린다.
    또한 뱅크까지 배선하면 (a) 배선 기생이 노드 용량에 더해지고 (b) 노드마다 길이가
    달라 비균일해져 f 예측 정확도의 전제(균일 피치)가 깨진다.

    **부하캡은 링 인버터 바로 옆이어야 한다.**

    ### 기각한 대안

    | 안 | 기각 사유 |
    | :--- | :--- |
    | 캡을 키워 단수 유지 (4.27 → 6.04) | f는 유지되나 bbox가 6.43 → 8.16으로 커져 **자리가 더 나빠진다.** 자가당착 |
    | 캡 제거, 순수 인버터 지연 | $C_{node}$ 42.8 → 2.4 fF로 17.8배 빨라져 11단 1.98 GHz / 5단 4.35 GHz. 패드 한계 33 MHz를 4~8배 초과하고 ÷256(DFF 8단)으로도 첫 DFF가 GHz를 받아야 한다 |
    | 7단 유지 | f 174.3 MHz로 패드 여유 2.1배(5단은 1.5배)라 더 좋으나, **캡 7개가 여백에 안 들어간다** |

    **★ 직교성 2차 실증**: 단수를 11단에서 5단으로 절반 이하로 축소했음에도 $I_{RO}$가 95.07 → 96.60 µA로
    **+1.53 µA (+1.6%)** 불변이었다. 남은 1.6%는 탭 버퍼 몫($f$가 2.2배가 되어 버퍼 전류증가). $I = NCVf$ 관계에서 $f \propto 1/N$으로 $N$이 소거되므로 부하 전류가 불변임이 실측으로 확인되었다.

1.1 **분주기 (÷16)** — `sky130_fd_sc_hd__dfxbp_1` 4개 리플 카운터.
   각 단이 $\bar{Q}$를 $D$로 되먹여 T-플립플롭(÷2), 4단 = ÷16.

   **★ VDPWR(1.8 V) 급전** — 링과 전원 도메인을 분리한다. 이유:
   (a) 링만 LDO 부하가 되어 $I_{RO}$가 깨끗하게 정의됨, (b) 분주기 스위칭 노이즈가
   LDO 출력에 실리지 않음, (c) `uo_out`이 원래 VDPWR 도메인.
   도메인 경계: RO_OUT 스윙 1.78 V(VDDC) → 분주기 문턱 0.9 V(VDPWR/2)로 여유 큼.

   **실측 (tt/27, CK 243.97 MHz 1.78 V 스윙, 출력 부하 5 fF)**: 각 단 분주비
   **2.0000**, DIV_OUT **15.248 MHz**.

   **TSPC 불채택**: 당초 고속 발진을 우려해 TSPC 커스텀을 검토했으나, ss/125 최악 코너에서도 356 MHz까지 표준셀 DFF가 4단 모두 ratio 2.0000으로 정상 통과하므로 TSPC 불채택 결정을 확정 유지한다.

   ### DIV_OUT 주파수 여유

   TT 출력 패드 한계 33 MHz 대비:

   | 조건 | DIV_OUT | 여유 |
   | :--- | ---: | ---: |
   | tt/27 공칭 | 15.248 MHz | 2.2배 |
   | ff 최악 (×1.46) | 22.26 MHz | **1.5배** |

   11단(6.93 / 10.12 MHz, 여유 3.3배) 대비 줄었으나 통과한다.

   **주의(구현)**: xschem 심볼 `dfxbp_1.sym`은 `type=primitive` 블랙박스라 하위
   스키매틱이 없고 서브서킷 정의가 넷리스트에 딸려오지 않는다. 시뮬 시
   `libs.ref/sky130_fd_sc_hd/spice/sky130_fd_sc_hd.spice`에서 해당 `.subckt`를
   출력해 `.include` 해야 한다. 전원은 그래픽 핀이 아니라 **인스턴스 속성**
   (`VPWR`/`VGND`/`VPB`/`VNB`)으로 넷 이름을 지정한다
   (VPB = nwell 탭 → 전원, VNB = psub 탭 → 접지).

2. **특성 부하** — 단일 2 mA 싱크 + 슬루 드라이버(RC) 1벌.
   01v8 스위치 (`ui_in[7]`).

   **★ 슬루 드라이버 버퍼는 VDDC(LDO 출력) 급전이다.** 초기안은 VDPWR이었으나
   VDDC로 변경했다. 이유:
   (a) **자기 순서화** — LDO가 서야 싱크가 켜진다. 기동 중 `ui_in[7]`=1이어도
       VDDC가 낮으면 버퍼가 동작하지 않아 부하 충돌이 원천 차단된다.
   (b) **논리 정합** — LDO 오버슈트를 막는 회로가 LDO 자신의 출력으로 동작한다.
   비용: 정상 상태 소비 0(CMOS), 전이 중 $R_{slew}$ 통과 최대 6.0 µA(τ=0.8 µs 감쇠,
   총 전하 ~4 pC), $R_{on}$ 22.88 → 23.04 Ω(+0.7%).

   **VDDC 급전 판 실측 (tt/27)**

   | 항목 | VDPWR 판 | VDDC 판 |
   | :--- | ---: | ---: |
   | `vg_snk` high | 1.800 V | 1.7799 V |
   | 싱크 $I_D$ | 1.9706 mA | 1.9702 mA |
   | $R_{on}$ | 22.88 Ω | 23.04 Ω |
   | 슬루 rise / fall | 1.852 / 1.839 µs | 1.869 / 1.839 µs |
   | $V_{min}$(인가) | 1.719 V | 1.723 V |
   | $V_{max}$(release) | 1.821 V | 1.821 V |
   | `net6` / `VNB1` | — | 1.186591 / 1.111989 (불변) |

   RC 시상수가 수동 소자(295.0 kΩ × 2.727 pF)로 정해지므로 공급 전압이 3.2% 흔들려도
   엣지는 0.9%만 변한다.

### 5.2. 측정 — `ua[0]`의 함정
BGR 출력 임피던스가 **121 k**이므로 10 MΩ 입력 DMM으로 재면 **1.2% 분압 오차**
(트림 LSB 0.44%의 3배). 레퍼런스 `cw_vref`는 이 문제로 테스트 버퍼를 내장하고 외부 바이어스 핀까지 썼다.

**우리 해법: 버퍼 없이 SMU/전위계(입력 >100 MΩ)로 측정.** 비용 0, 오차 0.001%.
`ua[1]`(= 1.5 × $V_{ref}$)와의 교차검증이 캘리브레이션을 대신한다.

### ★ 트림은 `ua[1]`(V_out) 기준으로 수행한다

트림은 BGR의 $R_2$를 조정해 $V_{ref}$를 비례 스케일한다. 루프 평형에서

$$V_{out} = \frac{V_{ref} - V_{os}}{\beta}$$

이므로, 특정 칩의 오프셋 $V_{os}$와 분압비 $\beta$가 무엇이든 **그 칩에서
$V_{out}$이 1.800 V가 되도록 $V_{ref}$를 고르면** 세 오차원이 모두 흡수된다:
BGR 공정 산포(원래 목적), 분압비 미스매치, EA 입력 오프셋.

| 트림 기준 | 관측 핀 | 잔여 오차 (MC-A 기반) |
| :--- | :--- | ---: |
| $V_{ref}$ = 1.200 V | `ua[0]` | ±21.73 mV |
| **$V_{out}$ = 1.800 V** | **`ua[1]`** | **±8.01 mV (양자화만)** |

**2.71배 개선이며 하드웨어 변경이 전혀 없다.** 측정 절차만 바꾸면 된다.

부작용 점검:

| 항목 | 영향 |
| :--- | :--- |
| $V_{ref}$가 1.2 V에서 이탈 | ±1.12% (±13.4 mV). $V_{ICM}$ 헤드룸(PMOS 708 mV)에 무해 |
| BGR TC | $R_2$ 비례 스케일이라 ppm/°C 보존 (`01_BGR_최종스펙.md` §6.3) |
| 트림 범위 소요 | BGR ±6.6%에 LDO ±1.12% RSS 합성 → ±6.69%. 0.09%만 증가 |
| 온도 드리프트 | 트림은 1회성 DC 보정. 분압비는 동일 재질이라 비 드리프트 무시, EA 오프셋 드리프트만 잔존(작음) |

`ua[0]`(V_ref)은 교차검증용으로 유지한다.

### 5.3. 노이즈 항의 지위
§1의 20~30 µV/√Hz는 **목표가 아니라 구조적 예측**이다.
레퍼런스 실측이 보여준 구조는 "LDO 자체 1.8~1.9 µV/√Hz vs 밴드갭 13~19 µV/√Hz × 이득 1.5"이며,
**LDO EA를 아무리 조용히 만들어도 BGR × 1.5가 바닥**이라는 뜻이다.
절대치는 우리 BGR 노이즈 측정(PEX 후) 이후 확정한다. **PASS/FAIL 판정 대상이 아니다.**

### 5.4 라인 레귤레이션의 슬루 조건

VAPWR 0.6 V 스텝 시 VDDC 응답(tt/27, 정상 트림):

| VAPWR 슬루 | VDDC max |
| :--- | ---: |
| 6 V/µs | 2.088 V (1.95 초과) |
| 0.6 V/µs | 1.818 V |
| 0.06 V/µs | 1.779 V |

이는 클램프·$C_{boost}$와 무관한 **고주파 PSRR 한계**다. 루프 UGF(2.5 MHz) 밖의
대역에서 pass의 $C_{gd}$를 통해 공급 변동이 직접 관통한다(클램프 유무로 차이
0.01 mV 확인). 6 V/µs는 비현실적 자극이며(0.6 V는 VAPWR의 18%), 실제 리플은
수십 mV 수준이다. **라인 레귤레이션은 VAPWR 슬루 ≤ 1 V/µs 조건에서 규정한다.**

---

## 6. TinyTapeout 제약 (공식 문서 확인분)

| 항목 | 값 |
| :--- | :--- |
| 전원 핀 | VGND / **VDPWR = 1.8 V 디지털 코어** / **VAPWR = 3.3 V 아날로그**(선택) |
| 3.3 V 사용 시 | `tt_analog_*_3v3.def` 템플릿 필수 + `info.yaml`에 `uses_3v3: true` |
| PDN | **20 mA 소모 시 0.1 V 강하** → 우리 2.10 mA면 VAPWR ~10 mV 처짐 |
| 아날로그 핀 경로 | 저항 < 500 Ω, 커패시턴스 < 5 pF, 최대 전류 4 mA |
| 아날로그 핀 | `ua[0]`~`ua[5]`만, **0번부터 순서대로** |
| 디지털 출력 패드 | `sky130_ef_io_gpiov2_pad`, **최대 출력 33 MHz** (입력 66 MHz) |
| 금지 | **metal 5 사용 불가** |
| 필수 | 미구동 `uo_out`/`uio_out`/`uio_oe`는 GND 연결 |
| 면적 | 1x2 = 160 × 225 µm (3v3는 약간 좁음 — **DIEAREA로 확정 필요**) |

**귀결**: 디지털 도메인은 **1.8 V 고정**. 보드에서 3.3 V를 인가해도 TT 내부 로직(VDPWR)을 거쳐
오므로 우리에게 도착하는 건 1.8 V CMOS다. 이 때문에 트림 스위치를 **R2 접지단**에 배치해
1.8 V 직결로 구동하며, **레벨시프터가 불필요**하다.

### 6.1. ★ power-good 급전 레일 — VAPWR / thick-ox 확정

PG는 $V_{LDO}$가 아직 낮은 기동 구간부터 유효해야 하는데, $V_{LDO}$로 자신을 급전하면
그 구간에 비교기 자체가 죽어 출력이 부정(不定)이 된다 — PG의 존재 이유가 무너진다.
→ **VAPWR(3.3 V) 급전, thick-ox 비교기.**

thin-ox(`pfet_01v8`)로 이 회로를 만들 수 없는 것은 아니지만 헤드룸이 나쁘다 —
$L=2\,\mu\text{m}$에서 $|V_{th}|$가 **1.047 V**로 thick-ox pfet(1.0243 V)을 오히려
넘는다(RSCE, `02_LUT_앵커.md` §1.4). 1.8 V 레일에서 장채널 PMOS를 아날로그로 쓰면
$V_{ov}$가 0.75 V밖에 남지 않는다.

**레벨은 버퍼로 처리한다** — thick-ox 인버터를 VDPWR(1.8 V)로 급전하면 3.3 V 입력을
받아 1.8 V로 내보내고(thick-ox 게이트는 3.3 V 정격 안), 그 뒤에 필요하면 thin-ox
버퍼를 추가한다. 레벨시프터가 아니라 **전원 도메인이 다른 인버터 체인**이다.

---

## 7. 레퍼런스 프로젝트 (조건 대조용)

| 분류 | 예 | 쓸 것 | 쓰면 안 되는 것 |
| :--- | :--- | :--- | :--- |
| **동일 환경 실리콘** | devstdin TT08, cw_vref | **달성 가능치의 현실 기준** | — |
| **상용 데이터시트** | TI TLV713 급 | **스펙 항목·측정 조건의 어휘** | 목표 수치 (전용공정 + ATE 개별 트림 산물) |
| **우리 BGR 실측** | $V_{ref}$ 1.18659 V, TC 7.5 ppm | **이미 확정된 바닥** | — |

**devstdin TT08** (`tt08-ldo-bg-ref-osc`, 로컬에 클론 있음)
- 무부하 1.842 V @20 °C. 50 °C 구간 드리프트 10 mV인데 typical 시뮬은 2 mV만 설명
  → **MC 코너로만 해명됨. PEX + MC 필수**
- 출력 임피던스 실측 160 Ω = 대부분 TT 경로 (§5.1의 근거)
- 노이즈 구조 (§5.3의 근거)
- RO 5단 current-starved, 6.25 MHz. 기준전류 편차 영향을 평가하지 못해
  시뮬 8.1~10.8 MHz vs 실측 5.2~6.25 MHz로 어긋남

**cw_vref (ttsky25a)** — 측정 아키텍처 참고. 8-bit 트림, 테스트 버퍼 + loop-through 캘리브레이션
