wecallemjazzyfact/TinyTapeout-BGR-LDO/docs/zta-analog-course.md

---
title: Zero to ASIC Analog Course | Zero to ASIC Course
source: https://www.zerotoasiccourse.com/analog/
snapshot: 2026-07-10
---

## Analog ticket options

|  | Silicon | Boron | Arsenic |
| --- | --- | --- | --- |
|  | [Buy for $699](https://buy.stripe.com/6oU14m4HP3uVa6q2ad4gg0t) | [Buy for $1099](https://buy.stripe.com/cNi7sK8Y5ghHbaueWZ4gg0s) | [POA](/arsenic-details) |
| Guaranteed ASIC manufacture **[â](#asic-def)** | â
 160x225 um, 2 analog pins | â
 334x225 um, 4 analog pins | â |
| Access to 3.5 hours recorded video content & 11 labs | â | â | â |
| Access to updates of the course material | â | â | â |
| Recorded solution videos | â | â | â |
| Access to discord community server | â | â | â |
| Access to weekly community call | â | â | â |
| Access to twice monthly call with analog expert Prof. Harald Pretl. | â | â | â |
| Access to the material for the lifetime of the course **[â](#course-life)** | â | â | â |
| Personal onboarding and introduction | â | â | â |
| Your ASIC mounted on a PCB breakout board | $150 + Postage | â | â |
| 1 to 1 office hours support with Matt | â | 2 hours | 4 hours |
| 1 to 1 office hours support with Harald | â | â | 2 hours |
| Application to ChipIgnite - design can be closed source | â | â | â |
| Team access **[â](#team-access)** | â | â | â |
|  | [Buy for $699](https://buy.stripe.com/6oU14m4HP3uVa6q2ad4gg0t) | [Buy for $1099](https://buy.stripe.com/cNi7sK8Y5ghHbaueWZ4gg0s) | [POA](/arsenic-details) |

* Check your email for onboarding information after your purchase.
* Receipt provided upon purchase for deducting as a business expense.
* [Contact me](/contact-form) if your business has any special requirements.
* Secure payment handling by Stripe.
* Not ready? [Join the mailing list to receive updates and promotional discount codes](/newsletter).
* Are the pricing options too expensive? Apply for a ticket grant **[â](#grant)**

## What do people say about the course?

> The fastest way I know to get 'behind the scenes' and learn how analog ASIC design and implementation really works. This was one of the most educational three months I've ever had.
>   
>   
> Bruce MacKinnon (analog course)

> A great course to really learn about Analog ASICs and electronics in general, great material and support community.
>   
>   
> Diego Satizabal (analog course)

> After a long wait, I finally got the chance to take the Zero to ASIC Analog Course, and itâs fantastic! The comprehensive curriculum covers everything from schematic capture to GDS file generation, offering a deep understanding of the entire design process, along with plenty of debugging opportunities. I highly recommend that every Analog Design Engineer acquire these skills to become a full-stack developer in this complex yet fascinating field.
>   
>   
> Vishal Bingi (analog course)

## Course Overview

* Read the [full course syllabus](/analog_course_content).
* We will concentrate on analog circuit layout and tapeout.
* **Circuit design is not covered in the course - you can use one of our examples or bring your own schematic.**
* A virtual machine is available or you can install the tools manually.
* The course is continually updated for the latest tooling and PDK.

### Format

* 11 hands-on projects, supported with text guides and over 6 hours of videos.
* Support via:
  + Recorded solutions videos.
  + Discord community server.
  + Twice Monthly analog specific call. Harald is currently joining once per month.
  + 1 to 1 office hours with Matt: access to expert help on the Boron and Arsenic level tickets.
* Asynchronous - do in your own time.
* Guaranteed ASIC manufacture with [TinyTapeout](https://www.tinytapeout.com) ([specs](https://tinytapeout.com/specs/analog/)).
* High resolution set of digital images of the decapped ASIC - see [FAQ](#asic-def).
* Access to the course materials for the lifetime of the course.
* Course completion certificate.

### Prerequisites

* Basic Linux command line experience, Git & Make is helpful.
* Some programming experience helpful.
* Apple Silicon Mac users will need to use the Docker instead of the Virtual Machine. The videos were made with the VM so there are some differences.

[Back to top](#tickets)

---

## FAQ

#### Can I get a refund?

I’m so confident you will love the course, if for any reason you are unhappy you can ask for a refund within 30 days of purchase.

[Back to top](#tickets)

#### Will my design definitely get manufactured?

Yes! We are now using [TinyTapeout](https://www.tinytapeout.com) to guarantee ASIC manufacture.

* Silicon ticket includes [2 free tiles](https://tinytapeout.com/faq/#how-big-can-my-design-be) and 2 analog pins. PCB mounted chip is currently $150 extra.
* Boron ticket includes 4 free tiles, 4 analog pins, and 1 PCB mounted chip.

[Back to top](#tickets)

#### How big can I make my custom project?

Your project area starts at 160 x 225 um. You can pay extra for more space.

[Back to top](#tickets)

#### How long does the whole course take to complete?

It depends on your existing level of experience and how deep you want to go on your own project. Most people can complete the course in 8 weeks, committing about 4 hours per week.
Then you will need some amount of time to prepare your own project.

[Back to top](#tickets)

#### Is there a time limit to complete the course?

You can take as long as you want with the course materials. Office hours expire 3 months after you onboard.

[Back to top](#tickets)

#### When do I need to submit my final design?

See [TinyTapeout](https://www.tinytapeout.com) for the next shuttle closing date.

[Back to top](#tickets)

#### Is there a cheaper option?

We have a grant that provides a Silicon-level ticket option for the Zero to ASIC analog course for those unable to afford the course at full price. Apply [here](https://forms.gle/Gvire7wkN15jhMPj8).

[Back to top](#tickets)

#### What is the life of the course?

For as long as I’m running this course.

[Back to top](#tickets)

#### What is team access?

Take the course with your colleagues. You will work through the course material as a group and submit a single design between you. Weekly sync calls will keep you on track to complete the course.

[Back to top](#tickets)

#### Anything else?

[Send your questions here!](/contact-form)

[Back to top](#tickets)

Related

* [Full Analog Course Content](/analog_course_content/)
* [My analog microelectronics journey](/post/my_analog_journey/)
* [Newsletter](/newsletter/)
* [Resources](/resources/)
* [Zero to ASIC Digital Course](/digital/)
* [About Matt Venn](/matt_venn/)
* [Full Digital Course Content](/digital_course_content/)
* [Tiny Tapeout 9](/post/tinytapeout09/)
* [Tiny Tapeout Goes Analog!](/post/tinytapeout_goes_analog/)
* [Analog Philosophy with Carsten Wulff](/post/carsten_wulff_interview/)
* [Tiny Tapeout 2 Silicon Is Alive!](/post/tt02-silicon-is-alive/)
* [Tiny Tapeout 4](/post/tinytapeout04/)
* [Analog with Digital Standard Cells](/post/analog_with_digital/)
* [GlobalFoundries 180nm Fab](/post/gf180fab/)
* [Submit Tiny Tapeout Projects to an MPW](/post/tinyuserproject/)
