wecallemjazzyfact/TinyTapeout-BGR-LDO/designs/bgr_ldo/BGR_LAYOUT_CATALOG.md

# BGR 레이아웃 소자 카탈로그

**대상 셀**: `designs/bgr_ldo/layout/bgr_core/bgr_mos.mag`  
**작성 시점**: 컬럼 1 코어 배선 완료 / 컬럼 2 저항 배치·부분 배선 완료 / 컬럼 3 미배치

---

## 0. ★ 좌표 규율 (최우선)

**셀 중심은 반드시 magic 실측으로 확인한다.**

```tcl
select clear
select cell <인스턴스명>
box
```

- `.mag`의 `transform` 값은 파일·시점에 따라 ÷100 / ÷200 해석이 갈려 **판독 착오가 반복 발생**했다.
- **DRC 에러 마커(`error_p` 등)가 bbox를 부풀린다.** 마커 있는 셀은 중심 오프셋이 실제 확산 기준보다 크다. 마커는 셀 단독 DRC 실행 시 재생성되므로 배치 완료 후 일괄 삭제한다.
- **실제 사고**: 행 B(`3XTGEW`)의 중심을 마커 없는 값(LL+1.47)으로 계산해 배선한 결과, riser가 게이트 스트랩과 정확히 맞닿아 **13개 소자 전부 G-S 단락**. DRC는 침묵(touching = 병합).

---

## 1. MOS 셀

| 셀 해시 | 모델 | W/L | bbox (µm) | 마커 | 중심 = LL + | 용도 |
| :--- | :--- | :--- | ---: | :---: | :--- | :--- |
| `9KY2DD` | pfet_g5v0d10v5 | 20 / 4 | 5.24 × 21.00 | O | (2.620, 10.500) | 행 A: top1/2/5, tap_top |
| `3XTGEW` | pfet_g5v0d10v5 | 10 / 2 | 3.24 × 11.00 | O | (1.620, 5.500) | 행 B: bot1/2/5, tap_casc / bias_mir, cn_mir |
| `FV4ZM9` | nfet_g5v0d10v5 | 20 / 4 | 4.58 × 20.88 | X | (2.290, 10.440) | 행 C: XM3, XM4 |
| `YKUQM3` | nfet_g5v0d10v5 | 10 / 2 | 2.58 × 10.88 | X | (1.290, 5.440) | 행 D: XM3c, XM4c / bias_n1, bias_n2 |
| `AVQM49` | pfet_g5v0d10v5 | 10 / 4 | 5.24 × 11.00 | O | (2.620, 5.500) | XM_bias |
| `LESTS2` | pfet_g5v0d10v5 | 0.42 / 20 | 21.24 × 1.42 | O | (10.620, 0.710) | su1a, su1b, su1c |
| `HZW5KE` | nfet_g5v0d10v5 | 2 / 2 | 2.58 × 2.88 | X | (1.290, 1.440) | cn_d1, cn_d2 |
| `K9TBKL` | nfet_g5v0d10v5 | 1 / 2 | 2.58 × 1.88 | X | (1.290, 0.940) | su_n1 |
| `4H6C7W` | nfet_g5v0d10v5 | 1 / 20 | 20.58 × 1.88 | X | (10.290, 0.940) | su_n2 |
| `BHYBL9` | nfet_g5v0d10v5 | 12 / 2 | 2.58 × 12.88 | X | (1.290, 6.440) | pd |
| `G5UXWG` | nfet_01v8 | 10 / 0.15, **nf=22** | 10.85 × 10.88 | O | (5.425, 5.440) | trim_sw ×4 |

전 셀 **가드링 해제, M=1**. nwell·탭·레일은 상위(`bgr_mos`)에서 일괄 배치.

### 셀 치수 법칙 (마커 포함 기준)
- pfet_g5v0d10v5: 폭 = L + 1.24, 높이 = W + 1.00
- nfet_g5v0d10v5 (마커 없음): 폭 = L + 0.58, 높이 = W + 0.88

### `m` vs `nf`
trim_sw는 넷리스트 `m=22`를 **`nf=22`로 레이아웃**한다.
- 근거: `04_LDO_스펙.md` — 게이트 저항 관점에서 `m`과 `nf`는 동등, 차이는 접합 용량뿐(`nf`가 확산 공유로 ad/as 약 절반)
- 스위치는 R_on(≤5 Ω)만 스펙이므로 확산 용량 감소는 이득
- 면적: `m=22` 968 µm² → `nf=22` **517 µm²**
- LVS: magic이 핑거를 개별 소자로 추출, netgen 병렬 병합으로 `m=22`와 동치

---

## 2. 저항 셀 (`sky130_fd_pr__res_high_po_0p69`, W=0.69 고정)

전 셀 **snake(서펜타인), 가드링 해제**. 기판 타이는 상위의 p-tap 링이 담당.

| 셀 해시 | N | L_col | bbox (µm) | 용도 | 스키매틱 L |
| :--- | ---: | ---: | ---: | :--- | ---: |
| `3MESU3` | 8 | 15.250 | 8.88 × 17.93 | R6a, R6b, R7a, R7b | 121.73 |
| `Y74LVQ` | 8 | 4.340 | 8.88 × 7.02 | R1 | 34.45 |
| `YJEXGM` | 8 | 28.710 | 8.88 × 31.39 | R2fix | 229.41 |
| `G8MLLQ` | 7 | — | 7.71 × 18.27 | XR_cn | 91.205 |
| `F6JLQ4` | 1 | — | 0.69 × 5.43 | 트림 b0 | 1.27 |
| `T8D7K5` | 1 | — | 0.69 × 7.81 | 트림 b1 | 3.65 |
| `QCK2SQ` | 1 | — | 0.69 × 12.58 | 트림 b2 | 8.42 |
| `5VVEC7` | 1 | — | 0.69 × 22.12 | 트림 b3 | 17.96 |
| **`GHYW6X`** | 2 | 15.250 | **1.86 × 17.93** | **더미** (매칭 행 양끝) | — |
| **`UKBC2Q`** | 2 | 28.710 | **1.86 × 31.39** | **더미** (R2fix 양옆) | — |

### 서펜타인 기하 모델 (실측)
- `l_ext = 8·L_col − 0.27` (N=8)
- 높이: 짝수 N → `L_col + 2.68` / 홀수 N → `L_col + 5.36` (**N=2에서도 검증됨**)
- 폭: N=8 → 8.88, N=2 → 1.86 (컬럼 피치 1.17, 폭 0.69, 컬럼 간 갭 0.48)
- 단자: 중심 ±(폭/2 − 0.345), y = LL + 0.175. met1 패드 0.59 폭 × 2.045 높이

### ★ 변경 금지
- **분할 수**(R6/R7만 2분할, R2fix 통짜) — 헤드 TC 2성분 모델. 쪼개면 TC 이동
- **N=8 통일** — 코너 개수 비가 깨짐. 길이는 `L_col`로만 조절

### 더미 규격 근거
- 폭은 줄여도 되나(N=2), **높이는 실소자와 반드시 동일**. 짧으면 가장자리 컬럼의 위아래 환경이 달라져 한 컬럼 안에서 W_eff가 y에 따라 변한다
- N=1(직선)이 아니라 N=2인 이유: N=1은 높이가 `L+4.16`이라 실소자와 어긋난다
- 어레이 전체가 **1.17 균일 격자**가 되도록 배치 (피치 9.36 = 8.88 + 0.48)

---

## 3. PNP

| 셀 | 크기 | 포트 | 비고 |
| :--- | ---: | :--- | :--- |
| `sky130_fd_pr__rf_pnp_05v5_W0p68L0p68` | 3.98 × 3.98 | Base, Collector, Emitter | PDK read-only, 내부 `pnp_05v5`로 추출 |

- **Emitter**: 셀 중심에 met1 패드 0.83 × 0.83 (viali 포함) → via1 바로 얹기 가능
- **Base**: `nsubdiffcont` 12개 링 (rel x 1.065–2.915), **li1 레벨까지만** → locali 바 + viali 직접 생성 필요
- **Collector**: psub 링, 기판 → 자동 VGND
- 배치: 5×5, 피치 4.60, QA = 중앙(i=j=2), QB = 3×3 테두리 8개, 더미 16개

---

## 4. 현재 인스턴스 배치 (2026-08 시점)

### 컬럼 1 — 코어 (x −0.80 … 64.30)
| 행 | 셀 | 개수 | LL x | LL y | 피치 |
| :--- | :--- | ---: | ---: | ---: | ---: |
| A | `9KY2DD` | 13 | 0.00 + 4.88i | 56.26 | 4.88 |
| B | `3XTGEW` | 13 | 13.00 + 2.88i | 40.76 | 2.88 |
| D | `YKUQM3` | 4 | 13.97 + 2.88i | 23.88 | 2.88 |
| C | `FV4ZM9` | 4 | 9.94 + 4.88i | 0.00 | 4.88 |

**13슬롯 공통중심 배정** (슬롯 6 = tap, d = slot − 6):

| 소자 | 슬롯 | Σd | Σd² |
| :--- | :--- | ---: | ---: |
| top1 / bot1 | 0, 5, 8, 11 | 0 | 66 |
| top2 / bot2 | 2, 3, 7, 12 | 0 | 62 |
| top5 / bot5 | 1, 4, 9, 10 | 0 | 54 |
| tap | 6 | 0 | 0 |

1차 구배 완전 상쇄. 핵심 쌍(1↔2) Σd² 차이 4 = 13슬롯 최소(총 182가 3으로 안 나눠짐).

### 컬럼 2 (x 67.00 … 118.00)
- PNP 5×5: LL (67.0 + 4.6i, 0.0 + 4.6j), QA = `_12` 중심 (78.19, 11.19)
- 매칭 행 y 40.00, 피치 9.36: 더미(67.00) / R6b(69.34) / R7a(78.70) / R1(88.06, y 45.455) / R7b(97.42) / R6a(106.78) / 더미(116.14) — **R6·R7·R1 중심 92.50 일치**
- 남쪽 저항 y 3.00: XR_cn(91.00) / 더미(99.66) / R2fix(102.00) / 더미(111.36) / b0(113.70) / b1(114.87) / b2(116.04) / b3(117.21)

### 컬럼 3 — 미배치
소요 면적 **1072 µm²** / 가용 2071 µm² = **52%** (trim_sw `nf=22` 기준)

---

## 5. 층 규율

| 층 | 용도 |
| :--- | :--- |
| li1 | 셀 내부, p-tap/n-tap 링 |
| met1 | 세로 스텁, riser, 전원 레일, 링 |
| met2 | 행별 가로 스트랩 |
| met3 | 행 간·블록 간 간선 |
| met4 | C_out MiM 상판 (LDO) |
| **met5** | **TT 금지** |

**BGR은 MiM 뱅크 위 배치 금지** (met2/met3 사용).

---

## 6. 주요 DRC 룰 (µm)

| 룰 | 값 | 대상 |
| :--- | ---: | :--- |
| `poly.9` | 0.48 | 정밀 저항·헤드 ↔ 모든 확산 |
| `diff/tap.15a` | 0.30 | MV 확산 간격 (**touching_ok** — 맞닿으면 병합·단락, DRC 침묵) |
| `diff/tap.17` | 0.33 | nwell ⊃ mvpdiff |
| `diff/tap.19` | 0.33 | nwell ⊃ n-tap |
| `diff/tap.24` | 0.43 | nwell ↔ mvndiff |
| `diff/tap.11` | 0.13 | p-tap ↔ nwell |
| `diff/tap.3` | 0.27 | MV 확산 ↔ 탭 |
| `licon.7` | 0.12 | p-tap ⊃ 컨택 |
| `li.5` | 0.08 | li ⊃ 확산 컨택 |
| `li.1` / `li.c1` | 0.17 / 0.14 | li 최소 폭 |
| `mcon.2` | 0.19 | mcon 간격 |
| `met1.1` / `met1.2` | 0.14 / 0.14 | met1 폭 / 간격 |
| `met1.4` | 0.03 | met1 ⊃ li 컨택 |
| `met2.1` / `met2.2` | 0.14 / 0.14 | met2 폭 / 간격 |
| `met2.5` | 0.03 | met2 ⊃ via1 |
| `met3.1` / `met3.2` | 0.30 / 0.30 | met3 폭 / 간격 |
| `met3.4` | 0.025 | met3 ⊃ via2 |
| `via.1a` | 0.26 | via1 최소 |
| `via2.1a` | **0.28** | via2 최소 (via1과 다름) |

### p-tap 링 표준 구조 (3중)
| 층 | 밴드 폭 | 인셋 |
| :--- | ---: | ---: |
| `psubdiff` + `locali` + `metal1` | 0.70 | 0 |
| `psubdiffcont` | 0.46 | 0.12 |
| `viali` | 0.38 | 0.16 |

저항 어레이와는 `poly.9` 여유 **0.50**.

---

## 7. magic 함정 (실증)

1. **`erase <층>`은 contact type의 해당 성분과 인접 도형을 깎는다.** via1의 met1 성분 파괴, li 스텁 절단, 링 met1 0.02 부족 등 반복 발생. **erase 후 반드시 재검산·재도포.**
2. **`select area` + `delete`는 박스에 걸친 도형을 통째로 삭제**한다 (met3 L자 소실 사례).
3. **같은 넷이어도 애매하게 떨어지면 `met1.2` 위반.** 붙이거나 0.14 이상 띄우거나 둘 중 하나.
4. **넷 카운트만 세면 단락을 놓친다.** 추출 검증은 반드시 **4포트 전부 출력**해서 확인. (G가 S와 같은 넷인데 카운트만 보고 통과 판정한 사고 2회)
5. `label`은 점 박스 + 단일 층 위에서만. 중복 시 `_uq0` 접미어 발생.
6. gencell: 가드링 끄면 nwell·탭 소멸(상위에서 일괄), 해시명은 파라미터별 발급·재생성 시 변경.
7. `drc catchup`이 실제 검사를 실행. `drc find` + `box`로 에러 위치 순회.
8. 서펜타인 추출 시 `Device has multiple lengths` 경고는 무해(LVS는 W/L 비교). 단 **PEX 저항값은 이 환산으로 결정**되므로 post-layout 확인 필요.
9. magic tech의 xhrpoly 시트저항 **319.8** vs ngspice 정본 **325.0** (+1.22%) — LVS 무해, PEX 주의.

---

## 8. 검증 절차 (매 단계)

```tcl
save bgr_mos
extract all
ext2spice lvs
ext2spice -o chk_XX.spice
```

```bash
docker exec iic-osic-tools_xvnc_uid_1000 python3 -c "
import re
s=re.sub(r'\n\+\s*',' ',open('.../chk_XX.spice').read())
for n in ('넷이름들',): print(n, len(re.findall(r'\b'+n+r'\b',s)))
# 소자별 4포트 전부 출력
"
```

**DRC**: `drc check` → `drc catchup` → `drc count` → `drc why` → (에러 시) `drc find` + `box`
