wecallemjazzyfact/TinyTapeout-BGR-LDO/designs/bgr_ldo/docs/00_인계_통합.md

# BGR + LDO 인계 및 통합 문서 (00_인계_통합.md)

## 5. 레이아웃 및 물리 예산 명세

### 5.1 MiM 용량 및 예산 현황

| 항목 | 명세 및 예산 수치 |
| :--- | :--- |
| **MiM 총량** | **42슬롯 = 28.75 pF** ($C_{out}$ 32 + $C_c$ 4 + $C_{byp}$ 3 + $C_{slew}$ 2 + RO 1) |
| **MiM 면적** | 유닛 382.99 µm², 피치 21.67 × 19.91 (간격 1.2). 단층 2.0 fF/µm² (**적층 불가**) |

---

## 6. Task 진행 현황

| Task | 항목 명칭 | 내용 및 상태 | 현황 |
| :---: | :--- | :--- | :---: |
| **8** | 레이아웃 | BGR 코어 LVS/PEX 완료, **EA LVS 통과**, top 조립 중 | **진행중** |
