wecallemjazzyfact/TinyTapeout-BGR-LDO/designs/bgr_ldo/docs/LDO_LAYOUT_HANDOFF_02.md

# LDO_LAYOUT_HANDOFF_02.md

> `BGR_LAYOUT_HANDOFF.md` 후속. EA LVS 통과 이후 ~ 분압쌍 배치 완료까지.
> 절 번호는 기존 문서와 겹치지 않게 **§20번대**를 씁니다.

---

## §20. 진행 상태 요약

| 블록 | 상태 | 검증 |
| :--- | :--- | :--- |
| `bgr_mos` | **동결** | LVS 44/44, md5 `9fe80cbeeae23c18e25852206f20f8c1` |
| `ea_fc` | **LVS 통과** | Circuits match uniquely, 23/23 소자, 18/18 넷, property error 0 |
| pass FET (m=40) | 배선 완료 | `VAPWR` 219 / `VDDC` 40 / `PASS_GATE` 49, 익명 0 |
| `PASS_GATE` | 완료 | EA 출력 ↔ pass 게이트 44 |
| 분압쌍 `XRF1/2a/2b` | 완료 | `FB_TAP` ↔ `Vinp` 병합 (26), 루프 폐로 |
| 포켓 저항 3종 | 완료 | |
| **미배치** | 싱크 · 클램프 · `XRz` · `XR_slew` · RO · div16 · 트림버퍼 · MiM 53 · 전원 스트라이프 | |

**제어 루프가 닫혔습니다**: `VDDC → 분압 → Vinp → EA → PASS_GATE → pass → VDDC`

### 백업 파일

| 파일 | 시점 |
| :--- | :--- |
| `ldo_top_BIAS_OK.mag` | EA 바이어스 체인 완료 |
| `ldo_top_PASS_OK.mag` | pass 배선 완료 |
| `ldo_top_PASSGATE_OK.mag` | `PASS_GATE` 완료 |
| `ldo_top_XRF_OK.mag` | 분압쌍 배선 완료 |
| `ldo_top_LOOP_OK.mag` | **루프 폐로 (최신)** |

---

## §21. 셀 레지스트리

전부 **Guard Ring 해제**, MOS는 `nf=1 m=1 topc 1 botc 0`.
경로: `/foss/designs/designs/bgr_ldo/layout/ldo_top/` (`JS995W`만 `bgr_core/`).

### §21.1 MOS

| 해시 | 모델 | W | L | bbox | 용도 |
| :--- | :--- | ---: | ---: | :--- | :--- |
| `CULUTY` | pfet_g5v0d10v5 | 10 | 2 | 3.240 × 10.830 | 입력쌍 · P2a · `XM_clamp` |
| `QP729Q` | pfet_g5v0d10v5 | 10 | 4 | 5.240 × 10.830 | P1 |
| `PNMSAN` | pfet_g5v0d10v5 | 10 | 1 | 2.240 × 10.830 | P2b |
| `J26WJZ` | pfet_g5v0d10v5 | 10 | **0.5** | 1.740 × 10.830 | **pass** |
| `DBV2UA` | pfet_g5v0d10v5 | 1 | 20 | **21.240 × 1.830** | `XM_i1p` |
| `6CZMK9` | pfet_g5v0d10v5 | 3 | 1 | 2.240 × 3.830 | `XM_i2p` |
| `AXJJLT` | nfet_g5v0d10v5 | 10 | 8 | 8.580 × 10.570 | N1a |
| `G57DVP` | nfet_g5v0d10v5 | 10 | 20 | 20.580 × 10.570 | N2a |
| `NGNRL8` | nfet_g5v0d10v5 | 10 | 4 | 4.580 × 10.570 | N2b |
| `S5GSPQ` | nfet_g5v0d10v5 | 10 | 1 | 1.580 × 10.570 | N1b |
| `CXMEAH` | nfet_g5v0d10v5 | 1 | 1 | 1.580 × 1.570 | `XM_i2n` |
| `DYMEX7` | nfet_g5v0d10v5 | 10 | 2 | 2.580 × 10.570 | `XM_i1n` |
| `W5ZMD6` | **pfet_01v8** | 1 | 0.15 | 1.090 × 1.810 | RO inv/nand |
| `BTK2EE` | pfet_01v8 | 2 | 0.15 | 1.090 × 2.810 | `XM_p1/p2` |
| `CJPTEX` | pfet_01v8 | 4 | 0.15 | 1.090 × 4.810 | 트림 `XM_tip0~3` |
| `7QQFQW` | **nfet_01v8** | 1 | 0.15 | 0.730 × 1.570 | `XM_n1/n2` · RO nand |
| `AGPWC8` | nfet_01v8 | **0.42** | 0.15 | 0.730 × 0.990 | RO inv `XMN` |
| `QW2JRF` | nfet_01v8 | 2 | 0.15 | 0.730 × 2.570 | 트림 `XM_tin0~3` |
| `JS995W` | nfet_01v8 | 10 | 0.15 | 0.730 × 10.570 | `XM_snk` · **BGR trim_sw 공용** |

### §21.2 저항

| 해시 | 모델 | nx | Length | bbox | `L_eff` | 용도 |
| :--- | :--- | ---: | ---: | :--- | ---: | :--- |
| `H7SSCY` | 0p69 | 8 | 37.930 | 8.880 × 40.610 | 303.1698 | `XR_nb2` |
| `TFAEBJ` | 0p69 | 8 | 30.320 | 8.880 × 33.000 | 242.2898 | `XR_pb1c` |
| `SMLRMS` | 0p69 | 8 | 10.960 | 8.880 × 13.640 | 87.4098 | `XR_pb2` |
| `YNR8BH` | 0p69 | 8 | **3.350** | 8.880 × 6.030 | **26.5298** | `XRF1`·`XRF2a`·`XRF2b` |
| `LQLJUM` | 0p69 | 8 | 78.190 | 8.880 × 80.870 | **625.2498** | `XR_slew1/2` |
| `78RWE9` | 0p69 | **1** | 15.480 | **0.690 × 19.640** | 15.480 | `XRz` |
| `EVKW5H` | 5p73 | **1** | 29.800 | **5.730 × 33.960** | 29.800 | `XR_snk1/2` |

### §21.3 표준셀

| 셀 | 개수 | 비고 |
| :--- | ---: | :--- |
| `sky130_fd_sc_hd__dfxbp_1` | 4 | div16. `getcell`로 직접 배치, 높이 2.72 고정, `VPWR`/`VGND`/`VPB`/`VNB` 4핀 |

### §21.4 ★ 셀 파일 관리 규율 — 이번 세션 사고

`gencell` 스크립트 실행 시 **작업 디렉터리 밖에도 사본이 생겼습니다**. 프로젝트 루트에 생긴 9개는 `error_p` 층이 빠지고 `checkpaint`(편집 중 임시 층)가 들어간 **불량본**이었습니다.

> **셀 생성 후 반드시 `find`로 사본 위치를 확인하고, `layout/ldo_top/` 밖의 것은 삭제한다.**
> 동명 셀이 여러 디렉터리에 있으면 magic이 현재 디렉터리 것을 먼저 잡아 **다른 블록의 소자가 바뀐다.**

`JS995W`는 BGR과 공용이므로 **`bgr_core/` 것을 정본**으로 두고 `ldo_top/` 사본은 삭제했습니다.

---

## §22. 기하식 정본

### §22.1 MOS — `01v8` 신규 확정

| 항목 | `nfet_01v8` | `nfet_g5v0d10v5` | `pfet_01v8` | `pfet_g5v0d10v5` |
| :--- | :--- | :--- | :--- | :--- |
| bbox | (L+0.58) × (W+0.57) | **동일** | **(L+0.94) × (W+0.81)** | (L+1.24) × (W+0.83) |
| 확산 폭 | L+0.58 | L+0.58 | L+0.58 | L+0.58 |
| D met1 (LL 기준) | 0.030…0.260 | **동일** | **0.210…0.440** | 0.360…0.590 |
| S met1 | L+0.320…L+0.550 | **동일** | **L+0.500…L+0.730** | L+0.650…L+0.880 |
| met1 스트립 폭 | 0.230 | 0.230 | 0.230 | 0.230 |
| nwell | 없음 | 없음 | = bbox | LL+0.150…L+1.090 |
| nwell 감쌈 | — | — | **0.180 (LV)** | 0.330 (MV) |
| 층 이름 | `ndiff`/`nmos` | `mvndiff`/`mvnmos` | `pdiff`/`pmos` | `mvpdiff`/`mvpmos` |

**nfet은 01v8과 g5v0d10v5가 완전히 동일**합니다. pfet만 nwell 감쌈(0.18 vs 0.33) 차이로 x가 0.30 좁습니다.

> **주의**: "같은 generator를 공유하므로 수식이 유효하다"는 추론은 근거가 약합니다. 위 값은 `W5ZMD6`·`7QQFQW` 2점 실측 후 나머지 9종으로 교차검증한 것입니다.

### §22.2 저항 — nx=1 신규 확정

| 항목 | **nx = 1** | nx = 8 |
| :--- | :--- | :--- |
| 폭 | **W** | 8.880 (W=0.69) |
| 높이 | **L + 4.160** | $u$ + 2.680 |
| 단자 위치 | **상·하** 양단 | **양쪽 하단** |
| 단자 높이 | 2.160 | 2.105 |
| `L_eff` | **$u$** (보정 없음) | $8u - 7 \times 0.0386$ |

검산: `XRz` 15.480 + 4.160 = 19.640 ✔ / `XR_snk` 29.800 + 4.160 = 33.960 ✔

**nx=1은 굴곡이 없으므로 보정 계수가 존재하지 않습니다.** `res_high_po_5p73`의 굴곡 계수 확인이 불요했던 이유입니다. nx>1이 필요해지면 **N별 2점 실측을 선행**해야 합니다(§4.4).

### §22.3 nwell 간격

| 조합 | 룰 | 값 |
| :--- | :--- | ---: |
| lvnwell ↔ lvnwell (동일 전위) | `nwell.1` | 0.84 |
| lvnwell ↔ lvnwell (다른 전위) | `nwell.2a` | 1.27 |
| **lvnwell ↔ mvnwell** | **`nwell.8`** | **2.00** |
| mvnwell ↔ mvnwell | `nwell.8` | 2.00 |

`pfet_01v8`(VDDC 웰)과 pass·EA(VAPWR 웰) 사이는 **2.0**입니다. LV pfet을 한 웰에 모으면 이 keepout을 한 번만 내면 됩니다.

---

## §23. 좌표 정본

현좌표 = die − (1.88, 146.56).

### §23.1 pass FET

| 항목 | 값 |
| :--- | :--- |
| 셀 | `J26WJZ` × 44 (실소자 40 + 더미 4) |
| 슬롯 i LL_x | 101.500 + 1.380i (i = 0…21) |
| **행1** | LL_y −92.000, **`upsidedown`** (게이트 아래) |
| **행2** | LL_y −106.000, 정방향 (게이트 위) |
| 미러 | 홀수 슬롯 `sideways` (양 행 공통) |
| 경계 | 짝수 = S\|S = VAPWR 11 / 홀수 = D\|D = VDDC 10 (행별) |

**★ 행1을 뒤집은 이유**: 두 행 모두 정방향이면 게이트 스트랩이 n-tap·VDDC 레일 방향과 충돌해 via 자리가 없습니다. 스트랩 met1 높이가 **0.230**이라 via1(0.26)이 직접 안 들어가고, 좌우 D/S와 0.050씩이라 확장도 불가합니다.

| 요소 | 좌표 |
| :--- | :--- |
| 행1 확산 / D·S | y −91.500 … −81.500 |
| 행1 게이트 스트랩 | y −91.925 … −91.695 |
| **`PASS_GATE` met1 판** | x **102.140 … 131.580**, y **−95.390 … −91.780** |
| 행2 게이트 스트랩 | y −95.475 … −95.245 |
| 행2 확산 / D·S | y −105.670 … −95.670 |
| 브리지 (경계 i) | x LL+1.150…LL+1.970, 행1 y −90.500…−82.500 / 행2 y −104.670…−96.670 |
| riser (경계 i) | x LL+1.240…LL+1.880 (게이트 스트랩과 0.140 확보) |
| nwell | x 101.400…132.320, y −107.400 … −79.900 |
| 상단 n-tap | x 101.730…131.990, y −80.900…−80.300 |
| 하단 n-tap | x 101.730…131.990, y −107.000…−106.400 |
| VAPWR 세로 ×4 (폭 3.0) | x 102.5/111.5/120.0/128.5 …+3.0, y −80.400…−71.200 |
| VDDC 상단 레일 | met2 x 101.500…135.060, y −80.100…−78.540 |
| VDDC 하단 레일 | met2 x 101.500…135.060, y −109.300…−107.740 |
| VDDC 상하 연결 세로 | met2 x 133.500…135.060, y −108.500…−79.300 |
| 더미 D–S 타이 | 행1 y −81.900…−81.500 / 행2 y −106.070…−105.670 |

**게이트 판 이격**: 위·아래 D/S 스트립과 각 **0.195**. 광폭 met1(3.005 초과) 판정으로 `met1.3b` 0.28을 적용해 −95.390…−91.780으로 축소했습니다.

**전기 특성** (met1 0.125 Ω/□ typical, 2.1 mA)

| 경로 | 저항 | 강하 |
| :--- | ---: | ---: |
| VAPWR 세로 4개 병렬 (폭 3.0 × 4, 길이 9.2) | 0.096 Ω | 0.20 mV |
| VDDC 레일 (폭 1.56, 길이 30.7, 상하 병렬) | 1.23 Ω | 2.6 mV |

### §23.2 `PASS_GATE` 경로

| 구간 | 층 | 좌표 |
| :--- | :--- | :--- |
| `V_EA` 트랙 동측 연장 | met2 | x 122.750…133.060, y −68.800…−68.400 |
| 세로 | met2 | x 132.660…133.060, y −76.860…−68.400 |
| via1 | | x 132.730…132.990, y −76.720…−76.460 |
| **met1 세로** | met1 | x 132.560…133.160, y −93.900…−76.390 |
| 가로 → 게이트 판 | met1 | x 131.580…133.160, y −93.900…−93.500 |

met1 하나가 `VNB2` 가로(−77.4)와 VDDC 레일(−80.1)을 **층 분리로 한 번에** 넘습니다. via **1개**.

> 초안에서는 장벽마다 via로 met2를 오갔는데, 연속된 met1 구간을 못 본 것이었습니다. **장벽이 전부 met2면 met1으로 직행**이 원칙입니다.

### §23.3 분압쌍

| 슬롯 | 소자 | LL | 좌단자 | 우단자 |
| ---: | :--- | :--- | :--- | :--- |
| 1 | `XRF2a` | (104.000, −118.000) | **VGND** 104.050…104.640 | **n_rfmid** 112.240…112.830 |
| 2 | `XRF1` | (114.000, −118.000) | **VDDC** 114.050…114.640 | **FB_TAP** 122.240…122.830 |
| 3 | `XRF2b` | (124.000, −118.000) | **FB_TAP** 124.050…124.640 | **n_rfmid** 132.240…132.830 |

y −118.000…−111.970, 단자 y −117.970…−115.865. 슬롯 간극 1.120.

**공통중심**: A(슬롯2) 중심 118.440 = B 중심 (108.440+128.440)/2 = **118.440** ✔

| 넷 | 배선 |
| :--- | :--- |
| `FB_TAP` 점퍼 | met1 x 122.240…124.640, y −117.900…−116.000 |
| `n_rfmid` | met1 가로 y −118.800…−118.400 (x 112.240…132.830) + riser ×2 |
| `VDDC` | met2 세로 x 114.100…114.590, y −109.300…−116.400 + via1 |
| `VGND` | met1 가로 y −119.600…−119.200 → 세로 x 100.700…101.100 → p-tap B |

### §23.4 `FB_TAP` → `Vinp`

| 구간 | 층 | 좌표 |
| :--- | :--- | :--- |
| via1 (점퍼 → met2) | | x 123.100…123.420, y −117.700…−117.380 |
| 세로1 | met2 | x 123.000…123.520, y −117.800…−116.700 |
| 가로1 | met2 | y −117.100…−116.700, x 123.000…138.700 |
| **동편 세로** | met2 | x **138.300…138.700**, y −117.100…−53.200 |
| 가로2 (서측) | met2 | y −53.700…−53.300, x 74.500…75.220 |
| U1 (`VPB2` 남하) | met1 | x 74.560…76.450, y −53.770…−53.230 + via ×2 |
| 가로2 (중간) | met2 | x 75.910…137.360 |
| U2 (`nb2_isrc` 남하) | met1 | x 136.960…138.520, y −53.770…−53.230 + via ×2 |
| 가로2 (동측) | met2 | x 138.040…138.700 |

**y −53.700…−53.300 선정 근거**: 위 `nb2_isrc` 동진(−52.980)과 0.320, 아래 `VPB2` 가로(−53.970)와 0.270. `Vinp` 레일(−53.400…−53.000)과 면적 겹침으로 병합.

**동편 x 138.3~138.7**: `nb2_isrc` 남하(137.500…137.900)와 0.400, BGR 존 동단(143.400)까지 자유. **met2 장벽 0개**.

---

## §24. 넷 카운트 정본 (`ldo_top` 현재)

| 넷 | 개수 | 내역 |
| :--- | ---: | :--- |
| `VAPWR` | 219 | EA 127 + pass (B 44 + S 44 + 더미 D 4) |
| `VGND` | 297 | 293 + `XRF2a` T1 + 저항 3종 VSUBS |
| `VDDC` | 41 | pass D 40 + `XRF1` 1 |
| `PASS_GATE` | 49 | XM7 D 1 + XM9 D 4 + pass G 44 |
| `Vinp` | **26** | 입력쌍 24 + `XRF1` + `XRF2b` (= `FB_TAP` 병합) |
| `n_rfmid` | 2 | `XRF2a` + `XRF2b` |
| `Vinn` | 24 | |
| `V_tail` | 116 | |
| `net1`~`net5` | 12/35/35/12/12 | **전부 EA 내부 넷** |
| `X` | 13 | P2a 게이트 8 + XM8 D 4 + XM6 D 1 |
| `VPB1` | 8 | |
| `VPB1c` | 6 | |
| `VPB2` | 10 | P2b 게이트 8 + 저항 2 |
| `VNB1` | 7 | |
| `VNB2` | 5 | |
| `n_nb2` | 2 | |

**익명(2단자 이상) 0, `_uq` none, FLOATING 0**

### §24.1 노드명 대응

회로 측이 `ldo_top_forsimul`의 익명 노드를 라벨로 바꿨습니다.

| 이전 | 신규 | 레이아웃 영향 |
| :--- | :--- | :--- |
| `net1` | `n_comp` | 미배치 (Rz–Cc 중간) |
| `net2` | `n_snk` | 미배치 |
| `net3` | **`FB_TAP`** | **배선 완료** |
| `net4` | `n_prb` | 프로브 (레이아웃 없음) |

**`ea_fc` 내부의 `net1`~`net5`는 그대로**입니다. `ldo_top`에 찍은 그 라벨들은 전부 EA 내부 넷이며 계층 안에 묻힙니다.

**라벨 우선순위**: `ldo_top` 레벨 이름이 정본입니다. `V_EA` → `PASS_GATE`, `Vinp` → `FB_TAP`으로 통일하며 EA 쪽 라벨은 지웠습니다. `ea_fc.mag` 사본에는 포트가 그대로 남아 EA 단독 LVS가 유효합니다.

---

## §25. 이번 세션에서 확립된 규율

### §25.1 ★ `erase metal1`은 `viali`·`via1`을 함께 지운다

via 타일은 met1을 **포함**하므로 met1만 지우려 해도 via가 사라집니다. 그 뒤 met1만 재도포하면 **접속이 끊긴 채 DRC는 통과**합니다.

> pass 상단 n-tap에서 발생. 증상은 `VAPWR` 219 → 151, nwell이 익명 노드로 분리.
> **탭·via 근처에서 met1을 지운 뒤에는 반드시 via 층까지 복원을 확인한다.**

### §25.2 ★ `erase`는 라벨도 지운다

`erase metal2`가 그 층에 붙은 라벨을 함께 제거합니다. `VNB1`·`VNB2`·`n_nb2`·`VPB1c`가 이 경로로 소실됐습니다.

> **erase 전에 그 박스 안에 라벨이 있는지 확인하고, 시공 후 재부착한다.**

### §25.3 ★ erase 박스는 통과 도형까지 본다

인접 도형만 보고 **박스가 관통하는 도형**을 놓치는 사고가 반복됐습니다. `net3` 트랙에 구멍, `VPB1` 레인 절단, 더미 타이 소실이 전부 이 유형입니다.

> **erase 명령 전에 박스 좌표로 교집합 검사를 돌리고 결과를 첨부한다.**

### §25.4 ★ 저항 배수는 개별 인스턴스로 명시

ngspice에서 **저항의 `m`은 서브회로 경계를 못 넘습니다**. MOSFET은 sky130 서브회로가 `mult`를 내부 `m`으로 전달하지만 저항은 그 경로가 없습니다.

> `XR_snk`가 `mult=2 m=2`인데 **단일 유닛으로 동작**해 싱크 전류가 설계의 절반(1.004 mA)이었습니다. 회로 측이 명시적 병렬 2개로 수정 후 1.9824 mA로 정상화.
> BGR의 "netgen이 저항 `mult`를 인식 못 함"과 같은 뿌리입니다.

### §25.5 ★ 골든 넷리스트 단위 접미사

netgen은 접미사가 없으면 숫자를 그대로 비교합니다. `ext2spice`는 항상 SI(미터)로 뽑으므로 **10⁶배 property error**가 납니다.

> 증상: delta=200%, circuit1이 `1e-06` 계열, circuit2가 정수
> 조치: `mklvs.sh` 적용 (`mult` 제거 + W/L `u` 접미사)
> 경로: `/foss/designs/designs/bgr_ldo/ldo/mklvs.sh <원본> [출력]`

### §25.6 ★ 매칭 쌍은 유닛 기반

`XRF1`/`XRF2`가 길이가 달라 인터디지트가 불가능했습니다. 동일 유닛 3개로 바꾸자 **분압비 40 ppm 오차가 완전히 소거**됐습니다.

$$\frac{R_2}{R_1} = \frac{2(R_{poly} + R_{head})}{R_{poly} + R_{head}} = 2.0000 \quad \text{(유닛 길이와 무관)}$$

그 40 ppm이 컨택 헤드 보정 역산의 잔차였고, 유닛 통일로 $R_2 = 2R_1$이 모델상 항등이 됩니다.

> 회로 Q4 회신: 분압비 3σ 0.893%가 $V_{out}$ 지배항(16.08 mV)이며 **랜덤 미스매치라 유닛 통일로는 안 줄어듭니다.** 다만 국소 산포는 거리에 따라 상관되므로 **밀집 배치가 유리**합니다.

### §25.7 검증 오탐 유형 (반복 확인됨)

| 유형 | 증상 | 판별 |
| :--- | :--- | :--- |
| via1/viali 단일 타일 | 확인점이 via 안이면 met1/met2 rect 없음 | **확인점을 via 바깥 인접점으로** |
| p-tap/n-tap 3분할 | `viali` 대역에 met1 없음 | 탭 상·하단에서 확인 |
| 병합된 rect | 브리지+연장이 하나로 합쳐져 경계 변동 | 덤프로 실제 rect 확인 |

---

## §26. 남은 작업

### §26.1 미배치 소자

| 그룹 | 소자 | 셀 | 개수 |
| :--- | :--- | :--- | ---: |
| 싱크 | `XM_snk` (m=4) | `JS995W` | 4 |
| | `XM_p1`·`XM_p2` | `BTK2EE` | 2 |
| | `XM_n1`·`XM_n2` | `7QQFQW` | 2 |
| | `XR_snk1/2` | `EVKW5H` | 2 |
| 클램프 | `XM_i1p` | `DBV2UA` | 1 |
| | `XM_i1n` | `DYMEX7` | 1 |
| | `XM_i2p` | `6CZMK9` | 1 |
| | `XM_i2n` | `CXMEAH` | 1 |
| | `XM_clamp` | `CULUTY` | 1 |
| 보상 | `XRz` | `78RWE9` | 1 |
| 슬루 | `XR_slew1/2` | `LQLJUM` | 2 |
| RO | `ro_inv` ×12 | `W5ZMD6` + `AGPWC8` | 24 |
| | `ro_nand` ×1 | `W5ZMD6` ×2 + `7QQFQW` ×2 | 4 |
| div16 | `dfxbp_1` ×4 | 표준셀 | 4 |
| 트림버퍼 | `XM_tip0~3` | `CJPTEX` | 4 |
| | `XM_tin0~3` | `QW2JRF` | 4 |
| MiM | `XCout` 32 · `XCc` 4 · `XCbyp` 3 · `XC_slew` 2 · RO 11 · `XC_boost` 1 | | 53 |

### §26.2 C 대역 면적

| 구역 | 범위 | 면적 |
| :--- | :--- | ---: |
| C1 (서편) | x −1.8…100.0, y −110.0…−146.56 | 3,726 |
| C2 (동편) | x 101.5…143.4, y −119.8…−146.56 | 1,123 |
| **계** | | **4,849** |

| 블록 | 추정 면적 |
| :--- | ---: |
| `XR_slew` ×2 (눕힘 80.87 × 8.88) | **1,520** |
| `XR_snk` ×2 | 425 |
| 클램프 5소자 (`XM_i1p` 21.24 지배) | ~300 |
| div16 | ~130 |
| RO 13게이트 + 싱크 6 + 트림 8 | ~400 |
| `XRz` | 14 |
| **계** | **~2,790 (58%)** |

**RO 단수 축소 불요.** 지배 항목이 `XR_slew`이고 01v8 소자는 전부 작습니다.

### §26.3 플로어플랜 미결 사항

| # | 사항 | 상충 |
| ---: | :--- | :--- |
| 1 | **LV pfet 웰 통합** | `nwell.8` 2.0을 한 번만 내려면 싱크·RO·트림버퍼 pfet_01v8을 한 웰에 모아야 함 |
| 2 | **RO 격리** | 발진기(110.89 MHz)라 노이즈원. 1과 상충 |
| 3 | `XM_i1p` 21.24 | 클램프 배치의 지배 항목 |
| 4 | 캡 뱅크 x 시작점 | met4 전원 스트라이프 3줄과 `met4.2` 간격 |
| 5 | ua 핀 인출 | ua[0] `VREF_LOW` x 134.740 / ua[1] `VDDC` x 115.420, met3 패치 + via3 필요, `capm.8` keepout |

### §26.4 LVS 준비

| 항목 | 상태 |
| :--- | :--- |
| 골든 | `/foss/designs/designs/bgr_ldo/ldo/ldo_top_lvs.spice` (프로브 없는 버전) |
| 후처리 | `mklvs.sh`만으로 충분 (`mklvs_top.sh` 불요) |
| 동기화 검증 | `chksync.sh <시뮬본> <LVS본>` |
| 소자 수 변화 누계 | EA 더미 +14, `XR_slew` +1, 분압 +1, `XR_snk` +1 = **+17** |

### §26.5 post-layout AC 요구 조건

회로 측 정정본입니다. **세 조건 모두** 포함해야 합니다.

| # | 조건 | 근거 |
| :---: | :--- | :--- |
| (a) | 무부하 | PM 최악 70.04° |
| (b) | 이상 전류원 0.75~2.0 mA | GM 최악 11.55 dB |
| (c) | 실제 싱크 2 mA | 실칩 조건, $T_{dc}$가 (b)보다 11 dB 낮음 |

> 이전 통보 "GM 최악점이 최대 부하로 이동"은 철회됐습니다. 두 점만 보고 단조성을 추정한 것이었고, 그 두 점 자체가 `XR_snk` 버그로 잘못 측정된 값이었습니다.

---

## §27. 회로 검증 최종 상태 (참고)

| 항목 | 결과 | 스펙 | 여유 |
| :--- | ---: | ---: | ---: |
| 분압비 | **1.500000** (40 ppm 소거) | — | — |
| startup peak | 1.9175 | 1.95 | 32.5 mV |
| release peak (ll/125, 2 mA) | 1.85464 | 1.95 | 95.4 mV |
| PM 최악 (무부하) | 70.04° | 45° | 56% |
| GM 최악 (1.5 mA 이상원) | 11.55 dB | 8 dB | 44% |
| 로드 레귤레이션 | 92.0 µV @1.982 mA | 5 mV | 98% |
| 슬루 엣지 | 1.880 / 1.900 µs | > 1.0 µs | — |
| $I_Q$ / $I_{max}$ | 139.64 / 2123.3 µA | 150 µA | 10.4 µA |

**전 항목 통과.** 회로 설계·검증 종료이며 이후 변경은 PEX가 요구할 때만 발생합니다.
