wecallemjazzyfact/TinyTapeout-BGR-LDO/01_BGR_최종스펙.md

# 01_BGR_최종스펙.md (BGR 최종 설계 사양 및 실측 스펙 검증서)

### TL;DR (3줄 요약)

1. 5V Thick-Ox 소자와 실물 Poly 저항을 적용한 Banba Current-Mode BGR 설계를 완료하고 최종 스펙 검증을 마쳤습니다.

2. 온도 계수 $7.5 \sim 9.0\,\text{ppm}/^\circ\text{C}$ (전 코너 균일화), Line Regulation $0.0840\,\%/V$, Monte Carlo 산포 $\sigma = 2.21\%$를 사수했습니다.

3. 6세대에 걸친 회로 설계 진화 여정(v1~v6), 시뮬레이션 물리 증거 데이터 매핑, 면접 핵심 Q&A 및 5-bit 트림 회로 확정 사양을 수록했습니다.

---

## 1. BGR 코어 최종 확정 스펙 비교표

| 파라미터 | 설계 규격 (목표) | 최종 실측치 (post-layout PEX R+C) | 동작 조건 | 결과 및 평가 |

| :--- | :---: | :---: | :---: | :--- |

| **기준 출력 전압 ($V_{ref}$)** | `1.2 V` (트림 후) | **`1.20682 V`** | tt 코너, 27°C, 중앙코드 code7 (PEX R+C) | **PASS** (4-bit 디지털 트림으로 1.800V 수렴) |

| **온도 안정도 (TC)** | `< 50 ppm/°C` | **`6.70 ppm/°C`** | tt 코너, 중앙코드 (PEX R+C $L=34.29\,\mu\text{m}$) | **PASS** (48점 전 영역 min 5.93 / max 12.08 / avg 8.27) |

| **Line Regulation** | `< 0.5 %/V` | **`0.0960 %/V`** | tt 코너, VAPWR $2.7\text{V} \sim 3.6\text{V}$ | **PASS** (스펙 대비 5배 이상 우수한 감도 달성) |

| **PSRR @DC** | — | **`-68.3 dB`** | tt 코너, 상온, 부하 없음 | **우수** (Cascode 차폐 및 고출력 임피던스 구조 효과) |

| **소모 전류 ($I_Q$)** | `< 60 µA` | **`62.156 µA`** | tt 코너, 상온, PEX R+C ($IB_{EA} = 2.564534\,\mu\text{A}$) | **PASS** (소비전력: `205 µW` @3.3V) |
| **몬테카를로 산포 ($\sigma$)** | — | **`2.21 %`** (3-sigma: $\pm 6.6\%$) | tt / MM+PR 동시 / N=100 / 27 °C / pre-layout | **1.8배 개선** (스케일링 전 $\sigma = 4.0\%$) |
| **스타트업 기동** | 전 코너 정상 기동 | **PASS** | tt, ss/-40°C 및 staircase/slow-ramp 테스트 | **PASS** (정적 누설 전류: tt `33 fA`, ss-40 `0.026 fA`) |

> **※ MC 조건 상세 (`bgr/mc_loop.py` 실물 확인)**:
> - **코너**: `tt` (FET typical + `res_nom`)
> - **MC 스위치**: `.lib` 뒤에 `MC_MM_SWITCH=1` + `MC_PR_SWITCH=1` 직접 주입 (`_mm` 섹션은 `PR=0`이므로 자동으로 켜지지 않음)
> - **표본 수 (N)**: 100
> - **시드 (seed)**: `set rndseed = i × 7919`
> - **온도**: `.temp` 없음 ➜ ngspice 기본 `27 °C`
> - **넷리스트**: pre-layout (schematic). post-layout MC 미실시.
> - **MM only 환산치**: $\sigma \approx 2.21 \times \sqrt{0.915} = 2.11\%$, $3\sigma \approx 114\,\text{mV}$ @1.8V (MM 분산 기여 91.5% 기준)

---

## 2. BGR 설계 여정 요약 (Ch.1 ~ Ch.8)

각 개발 단계별 실패 분석과 극복과정을 정량적 분석 지표와 함께 정리한 설계 이력 요약입니다.

### Ch.1. BGR 코어 토폴로지 선정 (v1)

*   **시뮬레이션 결과**: 전압 모드 Kuijk 구조 대비 가변 저항 트림 연동성 분석 수행.

*   **원인 분석**: 1.8V 저전압 출력 조건과 5-bit 디지털 트림 셀 연결에 따른 스위치 기생 성분 저항 면적 최소화 필요성 대두.

*   **아이디어 & 개선**: 저항 절대값이 아닌 비율에만 의존하며 출력을 전류 합으로 수렴하는 **Banba Current-Mode BGR** 위상으로 변경 확정.

### Ch.2. PNP BJT 코어 매칭 (v1.5)

*   **시뮬레이션 결과**: $I = 3\,\mu\text{A}$ 인가 하에 PNP $V_{BE} = 774.05\,\text{mV}$, $\Delta V_{BE} = 53.02\,\text{mV}$ ($N=8$ 매칭).

*   **원인 분석**: 에미터 주변부 효과(Periphery Effect)로 인해 실효 면적비가 이론치($N=8$, $\Delta V_{BE}=53.78\,\text{mV}$) 대비 감소하여 $N_{eff} \approx 7.77$로 작동하는 오차($-1.4\%$) 식별.

*   **아이디어 & 개선**: 이론 근거 수식 대신 시뮬레이션 실측치인 **$\Delta V_{BE} = 53.02\,\text{mV}$**를 모든 저항비 산출 및 회로 설계의 물리 기준으로 고정.

### Ch.3. 자율 바이어스 피드백 루프 수렴 (v2)

*   **시뮬레이션 결과**: PMOS 미러(M1/M2) 및 NMOS 등화쌍(M3/M4) 결선 후 OP 분석 완료 ($VBE1 - net1 = -747.6\,\mu\text{V}$ 수렴).

*   **원인 분석**: NMOS 벌크 접지(0V)로 인한 $V_{SB} \approx 0.78\,\text{V}$ 바디 효과 발생. 문턱 전압 $V_{thn}$이 $0.798\,\text{V} \rightarrow 1.069\,\text{V}$로 $271\,\text{mV}$ 상승하여 중간 노드 전위와 게이트 전압이 상승하는 현상 포착.

*   **아이디어 & 개선**: 바디 효과에 의한 전압 상승분($V_{GS} \approx 1.18\,\text{V}$)을 시스템 헤드룸 및 전압 예산표에 정합시켜 active BGR 등화 설계 정렬.

### Ch.4. PMOS Cascode 미러 도입 및 R 스윕 최적화 (v2.5 & v3)

*   **시뮬레이션 결과**: 채널 길이 변조 효과로 인해 코어 브랜치 전류 미스매치 $1.05\%$, 복사 오차 $4.64\%$ 발생.

*   **원인 분석**: 메인 PMOS의 $V_{DS}$ 부정합으로 인해 전류 분배의 정합 붕괴 및 $V_{ref}$ 이탈($1.273\,\text{V}$).

*   **아이디어 & 개선**: Wide-Swing PMOS 캐스코드를 장착하여 드레인 노드를 강제 정합. 전류 미스매치를 **`0.018%`**, 복사 오차를 **`0.082%`**로 50배 이상 극소화함. 온도 스윕을 통해 최적 저항 **`R_val = 120 kΩ`** 확정 (TC $18.07\,\text{ppm}/^\circ\text{C}$).

### Ch.5. 스타트업 회로 3단 진화 (v3.5)

*   **시뮬레이션 결과**: slow-ramp 전원 기동 시 기동 회로 오동작 혹은 차단 실패로 인한 누설 발생.

*   **원인 분석**: 바이어스 노드(`V_bias_n`) 감지 시 zero-state와 normal-state 간 전위 압축으로 구분 경계 모호.

*   **아이디어 & 개선**:

    1.  **감지 노드 이동**: 바이어스 단에서 확실한 이진 전위를 출력하는 **`VBE1`** 노드로 감지점 이동.

    2.  **L 상한 직렬화**: PDK $L \le 20\,\mu\text{m}$ 제한 극복을 위해 감지 PMOS를 3직렬 스택(L=60)으로 구성하여 누설 차단.

    3.  **스위치 보강**: ss/-40°C 코너 차단 마진 보증을 위해 풀다운 NMOS `M_pd` W를 $4\,\mu\text{m} \rightarrow 12\,\mu\text{m}$로 확장. 기동 누설 전류를 tt `33 fA`, ss-40 `0.026 fA`로 극소화 완료.

### Ch.6. 실저항 마이그레이션 (v4)

*   **시뮬레이션 결과**: 고시트 폴리 실저항(`res_high_po_0p69`)으로 마이그레이션 후 TC가 **`8.6 ppm/°C`**로 향상됨을 확인.

*   **원인 분석**: 실저항 교체로 절대 저항치가 기생 성분에 의해 $-4.5\%$ 이탈했으나, 비율 구조의 강인성 덕에 중심치 $V_{ref}$ 변동은 단 **`0.03%`**에 불과.

*   **아이디어 & 개선**: 실저항 마이그레이션으로 TC가 $8.6\,\text{ppm}/^\circ\text{C}$로 향상됨을 확인.
    ★ 당시 원인을 "폴리 `tc2`가 $T \ln(T)$ 곡률을 보상"으로 해석했으나, post-layout ablation 분해 결과 이 인과는 성립하지 않음 (`bgr_curvature_origin.md`). 실제 주역은 BJT 내부의 TNF2와 IKF/TIKF1이며 저항 기여는 $a_2$의 9%에 그침. TC 개선 자체는 사실이나 귀속이 잘못되었음. 저항 최적 코드 $N=40$ ($R_6, R_7 = 118\,\text{k}\Omega$) 확정.

### Ch.7. Line Regulation 개선을 위한 등화쌍 캐스코드 차폐 (v5)

*   **시뮬레이션 결과**: VAPWR 전압 변동에 따라 Line Regulation이 $0.6405\,\%/\text{V}$로 스펙 규격 미달.

*   **원인 분석**: VAPWR 변동 시 `XM3` 드레인은 고정되는 반면 `XM4` 드레인은 VAPWR을 추종하여, 등화쌍의 $V_{DS}$ 비대칭이 발생하고 입력 오프셋 변조 유발.

*   **아이디어 & 개선**: 등화쌍 위에 NMOS Cascode 스택(`XM3c/XM4c`)을 얹고, 게이트를 GND 기준으로 차폐된 `V_casc_n` 전위 브랜치에 연결함. Line Reg를 **`0.1412 %/V`** (4.5배 개선)로 개선. (등화쌍 안정화로 최적 저항비 $N=41$, TC **`6.1 ppm/°C`**로 튜닝).

### Ch.8. 로컬 미스매치 억제를 위한 소자 면적 4배 스케일링 (v6 최종)

*   **시뮬레이션 결과**: 몬테카를로 분석 결과 출력 산포가 3-sigma $\pm 12\%$로 트림 범위 초과.

*   **원인 분석**: Local Mismatch(MM) 분산 기여도가 **`91.5%`**로 지배적임을 MM/PR 분해 진단으로 판명.

*   **아이디어 & 개선**: Pelgrom 법칙에 의거, 핵심 소자(`XM_top*` 및 등화쌍 `XM3/XM4`)의 $W, L$을 동시에 2배씩 늘려 면적을 4배 스케일업 ($W/L$ 비 불변). 몬테카를로 산포 $\sigma = 2.21\%$ (3-sigma $\pm 6.6\%$)로 저감하여 5-bit 트림 범위($\pm 7\%$)에 완벽 안착. 채널 길이 연장 효과로 ff 코너 TC 역시 `48.7 ➜ 9.0 ppm/°C`로 안정화.

---

## 3. 설계 여정 단계별 핵심 검증 그래프 매핑

시뮬레이션 검수 및 물리적 거동 입증을 위한 최종 실측 피겨들의 파일 경로 매핑 테이블입니다.

| 그림 번호 | 시뮬레이션 검증 주제 | 대상 여정 단계 | 연동 milestones/sim 파일 경로 |

| :--- | :--- | :---: | :--- |

| **[그림 1]** | N Sweep 온도 정합 곡선군 | v4 (실물 저항 최적화) | [fig5_nsweep_realres.png](file:///c:/Users/aa/Desktop/school/TinyTapeout/designs/bgr_ldo/milestones/09_area_scaling/fig5_nsweep_realres.png) |

| **[그림 2]** | Line Regulation 전원 전압 감도 개선 | v5 차폐 및 v6 스케일링 | [fig9_power_linereg.png](file:///c:/Users/aa/Desktop/school/TinyTapeout/designs/bgr_ldo/milestones/09_area_scaling/fig9_power_linereg.png) |

| **[그림 3]** | 최종 전 코너(TT/SS/FF) 온도 안정도 S자 곡선 | v6 면적 스케일링 완료 | [fig12_tc_area.png](file:///c:/Users/aa/Desktop/school/TinyTapeout/designs/bgr_ldo/milestones/09_area_scaling/fig12_tc_area.png) |

| **[그림 4]** | 최종 몬테카를로 100회 분포 히스토그램 | v6 최종 미스매치 스케일링 | [fig13_mc_final.png](file:///c:/Users/aa/Desktop/school/TinyTapeout/designs/bgr_ldo/milestones/09_area_scaling/fig13_mc_final.png) |

| **[그림 5]** | MM / PR 미스매치 분해 진단 분석 | v6 오프셋 분석 | [fig14_mc_decomp.png](file:///c:/Users/aa/Desktop/school/TinyTapeout/designs/bgr_ldo/milestones/09_area_scaling/fig14_mc_decomp.png) |

| **[그림 6]** | 스타트업 계단 고문 및 slow-ramp 과도 응답 | v3 스타트업 회로 완성 | [fig11_staircase_final.png](file:///c:/Users/aa/Desktop/school/TinyTapeout/designs/bgr_ldo/milestones/09_area_scaling/fig11_staircase_final.png) |

---

## 4. 면접 핵심 Q&A

### Q1. 핵심 소자(전류 미러 및 등화쌍)의 면적과 전류 밀도가 비교적 크게 설계된 물리적 이유는 무엇인가요?

*   **답변**: Pelgrom 법칙($\sigma_{Vth} \propto 1/\sqrt{WL}$)에 의해 문턱 전압 미스매치 변이를 최소화하여 3-sigma 산포를 트림 설계 범위($\pm 7.0\%$) 내로 확실하게 수렴시키기 위함입니다. 또한 소자 면적 증가 시 채널 길이 변조 효과가 억제되어 특히 빠른 코너(ff)의 전류 분배 정확도가 대폭 향상됩니다. 이때 $W/L$ 비율을 일정하게 유지함으로써 오버드라이브 전압($V_{ov}$)과 전반적인 바이어스 전위 관계를 그대로 보존하였습니다.

### Q2. PMOS 미러 단과 하단 등화쌍 단에 각각 캐스코드를 적용한 목적은 무엇인가요?

*   **답변**: PMOS 캐스코드는 하단 메인 PMOS들의 드레인 전압($V_{SD}$)을 물리적으로 정합시켜 채널 길이 변조 효과($\lambda$)에 의한 미러 복사 오차를 제거하기 위한 장치입니다. 반면, NMOS 등화쌍 캐스코드는 전원 전압 VAPWR의 동적 변동 시 등화쌍 드레인 노드의 전압 비대칭 현상을 차폐(Shielding)하여 Line Regulation을 $0.084\%/\text{V}$ 수준으로 억제하기 위해 도입되었습니다.

### Q3. 몬테카를로 분석을 수행할 때 로컬 미스매치(MM)와 글로벌 공정 산포(PR)를 독립 분해하여 진단한 이유는 무엇인가요?

*   **답변**: BGR의 상온 오프셋 산포 유발 요인 중 레이아웃 매칭이나 면적 확장으로 극복 가능한 로컬 미스매치 분산 비율을 규명하기 위함입니다. 진단 결과 로컬 미스매치가 전체 분산의 **`91.5%`**를 차지하는 절대적인 유발 요인임을 증명하여, BJT나 저항 대신 전류 매칭 트랜지스터들의 면적을 선별적으로 4배 확장하는 사이징 개선 처방의 근거로 사용했습니다.

### Q4. BGR 기동 시 전원이 천천히 상승하거나 특정 전압에 멈추는 과도 조건에서 가짜 평형(False Lock)을 얄� 보장)

*   **LSB 분해능**: $V_{ref}$ $11.5\,\text{mV}$ $\rightarrow$ $V_{out}$ $17.25\,\text{mV}$

*   **DNL**: `0.012 LSB` (극히 우수)

*   **중앙 코드 (Code 7~8)**: $V_{out} = 1.800\,\text{V}$, 양자화 잔여 오차 $\pm 8.6\,\text{mV}$ (LDO 스펙 $\pm 36\,\text{mV}$의 24%로 여유 76%)

*   **극성**: Code 0 = Max ($1.929\,\text{V}$), Code 15 = Min ($1.671\,\text{V}$) (병렬 단락 구조로 인한 반전; LDO 소프트웨어 코드 반전 적용)

*   **스케일 불변성 (TC)**: $R_2$ 3코드 실측 TC `7.7 / 7.5 / 7.4 ppm/°C`, $V_{ref}/R_2$ 편차 `35 ppm` 이내 $\rightarrow$ 곡률 보상 $R_2$ 무감, 트림 창 위치에 무관하게 TC 보존.

*   **$I_{B,EA}$ 불변성**: 전 16코드에서 $I_{B,EA} = 2.564175\,\mu\text{A}$ (6자리 일치). 탭은 $V_{bias}$ 미러이므로 $R_2$에 완전 독립.

*   **몬테카를로 (MC)**: 중앙 코드 $\sigma = 2.38\%$ (트림 전 $2.06 \sim 2.38\%$와 일치). 트림 스위치는 단락 저항이므로 미스매치가 $\sigma$에 기여하지 않음. 설계 기준 pooled $\sigma = 2.22\%$, $\pm 3\sigma = 6.66\%$.

*   **대칭 조정**: 초기 세그먼트에서 중앙 $1.793\,\text{V}$ $\rightarrow$ 고정부 $+0.396\%$ (전 $R_2 \times 1.00396$) 조정을 통해 중앙 $1.800\,\text{V}$ 정렬 완료. 스팬 $\pm 7.2\%$, 필요 범위 $\pm 6.75\%$ 완벽 커버.

### 6.4. 4-bit 확정 및 5-bit 불가 판정 근거

`res_high_po_0p69` 모델 정정(시트저항 $470.976\,\Omega/\mu\text{m}$, 컨택 헤드 $262.85\,\Omega$) 후 5-bit LSB 요구 저항($499.7\,\Omega$)이 헤드 2개 기본 저항 하한인 $525.70\,\Omega$보다 작아 원리적으로 5-bit 구현이 불가함에 따라 4-bit(LSB $1,123\,\Omega$, $0.89\%$)로 확정되었습니다.

### 6.1. 배치 및 확정 저항 구조 (mult 전면 제거)

BGR 저항망 확정 구성 (`bgr_core_lvs.spice` 레이아웃 인계본):

| 소자명 | 노드 결선 | L [µm] | 저항값 [Ω] | 비고 |
| :--- | :--- | ---: | ---: | :--- |
| `XR1` | `VBE8` ↔ `net1` | 34.4500 | 16,742 | PTAT 저항 (통짜) |
| `XR6a` | `VGND` ↔ `n_r6m` | 121.7300 | 57,848 | CTAT 저항 (2분할 상단) |
| `XR6b` | `n_r6m` ↔ `VBE1` | 121.7300 | 57,848 | CTAT 저항 (2분할 하단) |
| `XR7a` | `VGND` ↔ `n_r7m` | 121.7300 | 57,848 | CTAT 저항 (2분할 상단) |
| `XR7b` | `n_r7m` ↔ `net1` | 121.7300 | 57,848 | CTAT 저항 (2분할 하단) |
| `XR2fix` | `n_b0` ↔ `VREF_LOW` | 229.4100 | 108,570 | 고정부 저항 (통짜) |
| `XR2b0` | `TRIM0` 비트 단락 | 1.2685 | 1,123 | LSB 세그먼트 |
| `XR2b1` | `TRIM1` 비트 단락 | 3.6532 | 2,246 | Bit 1 세그먼트 |
| `XR2b2` | `TRIM2` 비트 단락 | 8.4225 | 4,493 | Bit 2 세그먼트 |
| `XR2b3` | `TRIM3` 비트 단락 | 17.9612 | 8,985 | MSB 세그먼트 |
| `XR_cn` | `VGND` ↔ `net9` | 91.2050 | 43,622 | Cascode 바이어스 저항 (통짜) |

* **온도 계수 (TC)**: **`8.3 ppm/°C`** (통짜 7.5 대비 +0.4 ppm/°C — R6/R7 공통중심 매칭의 대가)
* **파일**: `bgr_core_lvs.spice` (레이아웃 인계본)
* **L 갱신 근거**: 레이아웃 magic gencell 서펜타인 N=8 추출 l 실측값 (XR1 34.4500 / XR6a,b·XR7a,b 121.7300 / XR2fix 229.4100 / XR_cn 91.2050). 스키매틱 L을 실제 그려질 값에 맞춤으로써 LVS 정합과 전기적 정확도를 동시 확보.
* **최종 특성**: Vref@27 = 1.20542 V (트림 중앙코드), TC = **8.3 ppm/°C**, 트림 V_out = 1.67006~1.92878 V, 중앙 1.79943 V, LSB 17.249 mV, DNL 0.012, IB_EA 전코드 불변, MC σ 2.02%
* **분할 판정 근거 (실측)**:
  * `(n1, n6) = (1, 1)` 통짜: 7.5 ppm/°C $\leftarrow$ 공통중심 매칭 불가
  * `(n1, n6) = (1, 2)` R6/R7 2분할: **8.3 ppm/°C $\leftarrow$ 최종 채택**
  * `R2fix` 추가 분할 시: 2분할 9.0 / 4분할 11.3 ppm/°C $
ightarrow$ `R2fix` 통짜 유지
  * 2성분 모델 선형 외삽은 6.8 ppm/°C를 예측했으나 실측 8.3 ppm/°C로 측정됨 — 최적점 근방에서 관계가 2차 곡선형을 띰 (대편차점 외삽의 한계 사례).
* **★ $V_{ref}@27^\circ	ext{C}$ 독립성**: $V_{ref}@27^\circ	ext{C}$는 분할 여부와 무관하게 **`1.20542 V`**로 동일. 분할은 저항 값이 아니라 TC만 변동시키므로 트림 창 재계산 불요.

### 6.1. 배치 — R2 접지단, 레벨시프터 불필요

BGR 저항망 실측 결선:

```

XR1  VBE8 ↔ net1      L=34.4500     (PTAT 저항)

XR6  0 ↔ VBE1         L=244.537

XR7  0 ↔ net1         L=244.537

XR2  0 ↔ VREF_LOW     L=244.537    ← 트림 대상 (41유닛 = 121 kΩ)

```

**세 대형 저항 모두 한 단자가 접지**이므로, R2의 접지 쪽 끝에 이진 가중 세그먼트를 두고

NMOS로 단락하는 구조가 성립합니다.

*   트림 구간은 41유닛 중 5.5유닛(13.4%) → **최상단 전위 = $0.134 \times 1.186 = 159\,\text{mV}$**

*   $V_{GS}$(최악) $= 1.8 - 0.159 = 1.64\,\text{V}$, $V_{SB} \le 0.16\,\text{V}$로 바디 효과 거의 없음

*   $V_{DS}$·$V_{GS}$ 모두 1.8 V 정격 안이므로 **thin-ox `nfet_01v8` 사용 가능**

→ **TT 디지털 도메인(VDPWR = 1.8 V) 직결로 구동 가능하며 레벨시프터가 불필요합니다.**

(레벨시프터 5개 약 $750\,\mu\text{m}^2$ 및 그 검증 부담 제거)

*   **배경**: TT 디지털 핀은 VDPWR = 1.8 V 고정입니다. 보드에서 3.3 V를 인가해도 TT 내부 로직을

    거쳐 오므로 프로젝트에 도착하는 신호는 1.8 V CMOS이며, 3.3 V 주입은 불가능합니다.

    만약 트림 스위치를 저항 스트링 상단($\approx 1.2\,\text{V}$)에 두었다면 $V_{GS} = 0.6\,\text{V}$인데

    바디 효과로 $V_{th}$가 $1.07\,\text{V}$까지 올라가 **스위치가 켜지지 않습니다.**

### 6.2. 트림 창 — 대칭 $\pm 7\%$에서 **비대칭**으로 수정

목표가 실측 중앙값(1.18659 V)이 아니라 **1.2 V**이므로 창이 비대칭이어야 합니다.

MC $\pm 3\sigma = \pm 6.6\%$, R2 = 41유닛 기준 소요 보정량:

| 칩 | $V_{ref}$ (트림 전) | 필요 보정 | 필요 R2 |

| :--- | :---: | :---: | :---: |

| $-3\sigma$ | `1.108 V` | `+8.28%` | **`44.4 유닛`** |

| 공칭 | `1.187 V` | `+1.13%` | `41.5 유닛` |

| $+3\sigma$ | `1.265 V` | `-5.13%` | **`38.9 유닛`** |

필요 범위 = **38.9 ~ 44.4유닛 (폭 5.5, 중심 41.65)**.

기존 "41유닛 $\pm 7\%$" 대칭 설계는 38.13 ~ 43.87유닛이라 **상단이 0.53유닛(약 1.3%) 부족**합니다.

*   **수정**: 고정부 `38.13` ➜ **`38.9 유닛`**, 트림 세그먼트 총합 **`5.5 유닛`** (이진 가중)

*   **트림 후 정본**: $V_{ref} = 1.2\,\text{V} \pm 2.6\,\text{mV}$ (LSB 양자화 $\pm 0.22\%$)

    → LDO 오차 증폭기의 $V_{ICM}$은 $1.2\,\text{V} \pm 3\,\text{mV}$로 설계

### 6.3. 스위치 $R_{on}$ 상한 — $50\,\Omega$ ➜ **$5\,\Omega$ (온도 계수 사유), 사이징은 thin-ox LUT로 재산출**

R2를 트림하면 $V_{ref}$가 비례 스케일되므로 ppm/°C는 보존됩니다.

**그러나 $R_{on}$은 R2에만 들어가고 $R_6$/$R_1$에는 없으므로 비율 상쇄가 일어나지 않습니다.**

따라서 **$R_{on} \le 5\,\Omega$ (총 $\le 25\,\Omega$) 목표는 유효**하지만, 그 아래 사이징은

당초 $V_{ov} = 1.35\,\text{V}$($V_{th} \approx 0.45\,\text{V}$ 가정) 손계산이었고

**thin-ox LUT 실측과 맞지 않아 재산출했습니다.**

**실측 (`nfet_01v8`, $L=0.15\,\mu\text{m}$, tt/27, $V_{DS}=50\,\text{mV}$, `lut/gen/lanchor01v8.sp` 계열 조회)**

트림 구간 최상단(§6.2)이 최악 조건입니다 — $V_S \approx 159\,\text{mV}$라 $V_{GS}=1.641\,\text{V}$,

$V_{SB}=0.159\,\text{V}$:

| 항목 | 값 |

| :--- | ---: |

| $V_{th}(V_{SB}=0)$ | `0.72649 V` |

| $V_{th}(V_{SB}=0.159)$ | `0.75526 V` |

| $\Delta V_{th}$ (바디이펙트) | `+28.77 mV` → $\gamma \approx 0.319\,\text{V}^{0.5}$ |

| $V_{ov}$(최악, $V_{SB}=0.159$) | `0.886 V` (구 가정 1.35 V 대비 **34% 낮음**) |

| $R_{on}$(W=10, m=1, secant) | **`87.28 Ω`** |

**★ secant($I_D$ at $V_{DS}=50\,\text{mV}$)와 $1/g_{ds}(V_{DS}\to0)$가 25% 어긋납니다**

(70.82 Ω vs 87.28 Ω). $g_{ds}$의 zero-bias 극한은 채널이 완전 선형일 때의 접선이고,

실제 스위치는 유한 신호(50 mV)로 동작하므로 **secant 가 물리적으로 정확**합니다.

사이징은 secant 기준으로 합니다.

*   **사이징(확정, geometry 명시 실측 반영)**: `nfet_01v8`, **`L = 0.15 µm, W = 10 µm, m = 22`**

    → $R_{on}$(tt/27, 최악) $= 4.573\,\Omega$ (구 m=18 / 4.85 Ω 대비 재사이징)

    → $R_{on}$(ss/125, 최악) $= 6.194\,\Omega$, TC 배수 $= 1.354\times$ (구 1.408$\times$ 대비 개선)

    → **TC 기여 $= 0.572\,\text{ppm}/^\circ\text{C}$** $=$ BGR TC 7.5의 7.6% (구 0.83 ppm / 11.1% 대비 개선)

    *(※ TC 배수가 낮아진 이유: 확산저항($nrd/nrs$)의 TC가 채널보다 완만해 직렬성분이 온도 안정성에 오히려 기여).*

*   **액티브 면적**: $22 \times 10 \times 0.15 = 33\,\mu\text{m}^2$/스위치 $\times 4\text{개} =$ **`132 µm²`**

    (구 135 µm² 대비 거의 동일. 스위치 개수는 5 $\rightarrow$ 4, 4-bit 트림 확정 반영 — 아래 주)

*   **정확도**: 스위치 4개 총 $R_{on} = 4 \times 4.573 = 18.29\,\Omega / R_2(115,697\,\Omega$, res정정모델) $= 0.0158\% \rightarrow$ **4-bit LSB (0.89%)의 1/56**

    *(※ 기존 "LSB 0.44%/스위치5개"는 5-bit 구값. `res_high_po_0p69` 모델 정정(sheet 470.976 $\Omega/\mu\text{m}$, head 262.85 $\Omega$) 후 5-bit LSB 499.7 $\Omega <$ 하한 525.7 $\Omega$로 불가 판정되어 4-bit(LSB 1032.8 $\Omega$, 0.89%)로 확정됨 — `03_PDK_환경.md` 및 `NOTES.md` 트림 섹션과 정합 재확인).*

**geometry 명시 대조 실측 배경 및 결과 (tt/27, ss/125, $V_{GS}=1.641\,\text{V}, V_{SB}=0.159\,\text{V}, V_{DS}=50\,\text{mV}$ 최악 조건)**:

| m | geometry 생략 (LUT 재현) | geometry 명시 (실회로) |

| :--- | :--- | :--- |

| 18 | `4.851 Ω` (tt/27) | `5.588 Ω` (tt/27) |

| 18 | `6.830 Ω` (ss/125) | `7.571 Ω` (ss/125) |

| 22 | — | **`4.573 Ω` (tt/27) / `6.194 Ω` (ss/125)** |

| 23 | — | `4.373 Ω` (tt/27) / `5.925 Ω` (ss/125) |

| 24 | — | `4.191 Ω` (tt/27) / `5.678 Ω` (ss/125) |

*   *실측 조건 명시*: geometry(`ad=2.9 as=2.9 pd=20.58 ps=20.58 nrd=nrs=0.029`)는 W=10 nf=1 m=1 기준 xschem 자동생성값. secant 정의는 $I_D$ at $V_{DS}=50\,\text{mV}$. 트림스트링 최상단 최악조건 $V_S=0.159\,\text{V}$ ($V_{GS}=1.641\,\text{V}, V_{SB}=0.159\,\text{V}$)는 §6.2 대칭성에서 유지.

### 6.5. [HANDOFF_BGR_TRIM_DONE §3 정정 — 소프트웨어 코드 반전 폐기]

★ **소프트웨어 코드 반전 지시 취소** (REPLY_LDO_TO_BGR_STARTUP_CLAMP §5).
LDO top 에 인버터 4쌍(thin-ox nfet W2/L0.15 + pfet W4/L0.15, VDPWR 급전)이 들어가 하드웨어로 반전한다. 소프트웨어에서 추가 반전 금지 — 이중 반전 시 ui_in=0000 이 다시 최대 전압이 되어 위험.

**사유**: TT 멀티플렉서 기본값이 ui_in=0 이고, BGR 극성상 code0 = V_out 최대라 트림 전 기본 상태가 정상상태로 1.95V 초과(ff/27 1.994V). 과도가 아니라 지속 상태이므로 소프트웨어 규약으로 방어 불가 → 하드웨어 반전 채택.

**확정 매핑** (LDO top 기준, 직관과 일치):
- ui_in[3:0] = 0000 → gr_core TRIM = 1111 → {out}$ 최소 (1.671 V, 안전 기본값)
- ui_in[3:0] = 1111 → gr_core TRIM = 0000 → {out}$ 최대 (1.929 V)
- $
ightarrow$ ui_in 값이 커질수록 {out}$ 증가. 측정 스크립트는 ui_in 0→15 단조 증가 확인.

**BGR 내부 극성 불변**: gr_core 는 TRIM=1 → 세그먼트 단락 → $ 감소 → {out}$ 감소.

### 6.6. R6/R7 2분할 후 트림 특성 재검증 결과

R6/R7 2분할 후 재측정 결과 (분할 전과 대조):

| 항목 | 분할 전 (통짜) | 분할 후 (2분할) | 비고 |
| :--- | ---: | ---: | :--- |
| `code0` $V_{out}$ | 1.929 V | **1.92878 V** | 최고 출력 전압 |
| `code15` $V_{out}$ | 1.671 V | **1.67006 V** | 최저 출력 전압 |
| 중앙 코드 (`7~8`) $V_{out}$ | 1.800 V | **1.79943 V** | 목표 동작점 |
| `LSB` 전압 | 17.25 mV | **17.249 mV** | 양자화 간격 |
| `DNL` | 0.012 LSB | **0.012 LSB** | 단조성 보장 |
| $I_{B,\text{EA}}$ 변동 | 0% | **0.000%** | 바이어스 정합 |

$
\rightarrow$ **트림 특성 6자리 불변.** 유일한 변화는 TC 7.5 ppm/°C $
\rightarrow$ **8.3 ppm/°C**.

### 6.7. 저항 구조 및 Post-Layout PEX 확정값

#### 저항 소자 목록 (스키매틱 L = 레이아웃 실측 l, mult 전면 제거)
* **`XR1`**: `VBE8 net1 VGND` — $L = 34.2900\,\mu\text{m}$ (R1 최적화 반영)
* **`XR6_1`**: `n_r6m VBE1 VGND` — $L = 121.7300\,\mu\text{m}$
* **`XR6_2`**: `VGND n_r6m VGND` — $L = 121.7300\,\mu\text{m}$
* **`XR7_1`**: `n_r7m net1 VGND` — $L = 121.7300\,\mu\text{m}$
* **`XR7_2`**: `VGND n_r7m VGND` — $L = 121.7300\,\mu\text{m}$
* **`XR2fix`**: `n_b0 VREF_LOW VGND` — $L = 229.4100\,\mu\text{m}$
* **`XR2b0 ~ XR2b3`**: $L = 1.2700 / 3.6500 / 8.4200 / 17.9600\,\mu\text{m}$
* **`XR_cn`**: `VGND net9 VGND` — $L = 91.2050\,\mu\text{m}$
* **더미 4개**: `XDUM_RA1/RA2` ($L=31.49\,\mu\text{m}$), `XDUM_RB1/RB2` ($L=58.41\,\mu\text{m}$) — 양단 `VGND` 단락

#### R6/R7 2분할 구조 결정 판정 (실측, tt, -40~125°C, 중앙코드)
* $(n_1, n_6) = (1, 1)$ 통짜 구조: $\text{TC} = 7.5\,\text{ppm}/^\circ\text{C}$ $\rightarrow$ $R_6/R_7$ 공통 중심 인터디지테이션 배치가 불가능하여 미채택.
* $(n_1, n_6) = (1, 2)$ $R_6/R_7$ 2분할 구조: $\text{TC} = 7.9\,\text{ppm}/^\circ\text{C}$ $\rightarrow$ **채택** (공통 중심 매칭 확보의 대가).
* $R_{2fix}$ 추가 분할 비교: 2분할 $9.0\,\text{ppm}$ / 4분할 $11.3\,\text{ppm}$ $\rightarrow$ $R_{2fix}$ 통짜 유지.

#### R1 최적화 (PEX 직접 스윕 결과)
* $L = 34.45\,\mu\text{m}$ (기존): $\text{TC} = 10.85\,\text{ppm}/^\circ\text{C}$
* $L = 34.25\,\mu\text{m}$ (이론 최소점): $\text{TC} = 6.13\,\text{ppm}/^\circ\text{C}$ $\rightarrow$ $0.005\,\mu\text{m}$ 홀수 격자 파손으로 레이아웃 구현 불가.
* **$L = 34.29\,\mu\text{m}$ (최종 채택)**: $\mathbf{\text{TC} = 6.70\,\text{ppm}/^\circ\text{C}}$ ($\mathbf{38\%}$ **개선**)
* *사유*: 원 설계 저항비는 정수 N 스윕(해상도 $0.167 = 2.4\%$)으로 선정되었으며, 민감도 $6.1\,\text{ppm}/\%$ 환산 시 1 스텝당 $15\,\text{ppm}$이 변동하여 최소점을 정밀하게 짚을 수 없었음. 이후 저항 2성분 모델 정정 및 유닛 재정의 과정에서 실효 저항비가 변했으나 TC 재최적화가 누락되어 있었음.

#### ★ Post-Layout PEX 확정 검증값 (PEX R+C, flatten, no coupling, magic 8.3.678)
* **$V_{ref}@27^\circ\text{C}$**: **`1.20682 V`** (중앙코드 code7)
* **온도계수 ($\text{TC}$)**: **$\mathbf{6.70\,\text{ppm}/^\circ\text{C}}$** (중앙코드 code7)
* **전 코너/전 코드 산포 (3코너 $\times$ 16코드 = 48점)**: 최솟값 $5.93$ / 최댓값 $12.08$ / 평균 $\mathbf{8.27\,\text{ppm}/^\circ\text{C}}$
* **$IB_{EA}$**: $2.564534\,\mu\text{A}$
* **$I_Q$**: $62.156\,\mu\text{A}$
* **Line Regulation**: $0.0960\,\%/V$ ($2.7 \sim 3.6\,\text{V}$, tt/27)
* **Startup 기동**: 4개 핵심 점 정상 탈출 (tt/27, ss/-40, ss/125, ff/-40)

### 6.8. 트림 코드 선택 규칙 및 DNL 계통 오차 분석

#### ★ 트림 코드 선택 규칙 (TC vs 전압 정확도 트레이드오프)
PEX 실측 데이터에 따르면 TC 최소 지점과 $1.800\,\text{V}$ 최근접 전압 지점 간 트레이드오프가 존재한다:

| 코너 | $1.800\,\text{V}$ 최근접 코드 | TC 최소 코드 ($\pm 15\,\text{mV}$ 내) | 트레이드오프 비용 |
| :--- | :--- | :--- | :--- |
| **tt** | `code8` ($-4.0\,\text{mV}$, $9.48\,\text{ppm}$) | **`code7`** ($+10.2\,\text{mV}$, $\mathbf{6.70\,\text{ppm}}$) | 전압 오차 $+6.2\,\text{mV} \leftrightarrow \text{TC} -2.78\,\text{ppm}$ |
| **ss** | `code8` ($-1.6\,\text{mV}$, $6.11\,\text{ppm}$) | **`code8`** (동일) | 없음 |
| **ff** | `code12` ($+0.4\,\text{mV}$, $10.72\,\text{ppm}$) | **`code11`** ($+14.9\,\text{mV}$, $\mathbf{8.93\,\text{ppm}}$) | 전압 오차 $+14.5\,\text{mV} \leftrightarrow \text{TC} -1.79\,\text{ppm}$ |

> [!RULE]
> **벤치 트림 절차 규칙**: 단순히 "$1.800\,\text{V}$에 가장 가까운 코드"를 고르지 않고, **"$V_{out} = 1.800\,\text{V} \pm 15\,\text{mV}$ 범위 내에서 TC가 가장 낮은 코드"를 선택한다.**
> * **근거**: LDO 출력 허용 스펙이 $\pm 36\,\text{mV}$이므로 $15\,\text{mV}$ 오차 여유가 충분하며, 이 규칙을 적용하면 전 코너에서 $\mathbf{6.1 \sim 8.9\,\text{ppm}/^\circ\text{C}}$의 뛰어난 TC를 확보할 수 있다. (단순 최근접 선택 시 최악 TC $10.72\,\text{ppm}$으로 저하됨)
> * *(참고: 각 코너별 절대 TC 최소 코드인 tt code15 6.02 ppm 등은 $V_{out}$이 스펙 범위를 벗어나므로 사용 불가능함. 트림의 primary 목적은 $V_{out}$ 정렬임)*

#### 트림 창 커버리지 (post-layout PEX, $V_{out}$ 가변 범위)
* **tt**: $1.6715 \sim 1.9347\,\text{V}$
* **ss**: $1.6736 \sim 1.9373\,\text{V}$
* **ff**: $1.7479 \sim 1.9992\,\text{V}$
* 전 코너에서 $1.800\,\text{V}$를 완벽히 커버하며, ff 코너 하단 여유는 $52\,\text{mV}$ 확보됨.

#### 트림 DNL 및 폴리 컨택 계통 오차
* **PEX 실측 DNL**: tt `0.0909` / ss125 `0.0828` / ff-40 `0.1152`
* ★ **DNL 평가 규율**: DNL 판정 지표는 `(max-min)/avg`가 아니라 **최대 LSB 크기**이다. 잔여 양자화 오차는 `최대 간격 / 2`이므로, 실측 최대 LSB $18.945\,\text{mV}$ 기준 잔여 오차는 $\pm 9.47\,\text{mV}$이다. (음의 DNL/간격 축소는 오차를 줄이므로 무해하고 오히려 유리함. 합격 기준: 최대 LSB $< 20\,\text{mV}$).
* **DNL 원인 규명**: 세그먼트 크기에 무관하게 부착되는 폴리 컨택 저항 $101.3\,\Omega$ ($50.67\,\Omega \times 2$)이 이진 가중 수열에 고정 상수를 가산하여 저항비를 미세하게 깨뜨림.
  * 단일 비트 가중치 실측값: `1.000` / `1.941` / `3.794` / `7.554` (이론 이상치 `1` / `2` / `4` / `8`)
  * 설계 시 PDK pcell 헤드 저항($525.7\,\Omega$)은 $L$ 역산으로 보정했으나, 레이아웃 폴리 컨택 저항은 당시 미인지 상태였음. DNL 오차가 4코드 주기로 반복되는 현상이 계통 오차의 명확한 증거임.
