wecallemjazzyfact/TinyTapeout-BGR-LDO/docs/zta-terminology.md

---
title: Terminology | Zero to ASIC Course
source: https://zerotoasiccourse.com/terminology/
snapshot: 2026-07-10
---

I’ve collected all the ASIC jargon here and broken it down into easy to understand descriptions.

# [Antenna Report](https://www.zerotoasiccourse.com/terminology/antenna-report/)

# [ASIC](https://www.zerotoasiccourse.com/terminology/asic/)

# [CMOS](https://www.zerotoasiccourse.com/terminology/cmos/)

# [Corner](https://www.zerotoasiccourse.com/terminology/corner/)

# [Die](https://www.zerotoasiccourse.com/terminology/die/)

# [Doping](https://www.zerotoasiccourse.com/terminology/doping/)

# [DRC](https://www.zerotoasiccourse.com/terminology/drc/)

# [Floorplan](https://www.zerotoasiccourse.com/terminology/floorplan/)

# [Foundry](https://www.zerotoasiccourse.com/terminology/foundry/)

# [FPGA](https://www.zerotoasiccourse.com/terminology/fpga/)

# [GDSII](https://www.zerotoasiccourse.com/terminology/gds2/)

# [Harden](https://www.zerotoasiccourse.com/terminology/harden/)

# [HDL](https://www.zerotoasiccourse.com/terminology/hdl/)

# [IC](https://www.zerotoasiccourse.com/terminology/ic/)

# [LibreLane](https://www.zerotoasiccourse.com/terminology/librelane/)

# [LVS](https://www.zerotoasiccourse.com/terminology/lvs/)

# [Macro](https://www.zerotoasiccourse.com/terminology/macro/)

# [Magic](https://www.zerotoasiccourse.com/terminology/magic/)

# [Maskset](https://www.zerotoasiccourse.com/terminology/maskset/)

# [MOSFET](https://www.zerotoasiccourse.com/terminology/mosfet/)

# [MPW](https://www.zerotoasiccourse.com/terminology/mpw/)

# [Netlist](https://www.zerotoasiccourse.com/terminology/netlist/)

# [NMOS](https://www.zerotoasiccourse.com/terminology/nmos/)

# [Node](https://www.zerotoasiccourse.com/terminology/node/)

# [Padring](https://www.zerotoasiccourse.com/terminology/padring/)

# [PDK](https://www.zerotoasiccourse.com/terminology/pdk/)

# [PDN](https://www.zerotoasiccourse.com/terminology/pdn/)

# [PEX](https://www.zerotoasiccourse.com/terminology/pex/)

# [Photolithography](https://www.zerotoasiccourse.com/terminology/photolithography/)

# [Place and Route](https://www.zerotoasiccourse.com/terminology/place_and_route/)

# [RTL](https://www.zerotoasiccourse.com/terminology/rtl/)

# [Shuttle](https://www.zerotoasiccourse.com/terminology/shuttle/)

# [Simulation](https://www.zerotoasiccourse.com/terminology/simulation/)

# [SPICE](https://www.zerotoasiccourse.com/terminology/spice/)

# [STA](https://www.zerotoasiccourse.com/terminology/sta/)

# [Standard cell](https://www.zerotoasiccourse.com/terminology/standardcell/)

# [Synthesis](https://www.zerotoasiccourse.com/terminology/synthesis/)

# [Tapeout](https://www.zerotoasiccourse.com/terminology/tapeout/)

# [Verification](https://www.zerotoasiccourse.com/terminology/verification/)

# [VLSI](https://www.zerotoasiccourse.com/terminology/vlsi/)

# [Wafer](https://www.zerotoasiccourse.com/terminology/wafer/)

# [WLCSP](https://www.zerotoasiccourse.com/terminology/wlcsp/)
