wecallemjazzyfact/TinyTapeout-BGR-LDO/docs/making-asics.md

---
title: Making ASICs :: Quicker, easier and cheaper to make your own chip!
source: https://tinytapeout.com/making_asics/
snapshot: 2026-07-10
---

[Tiny Tapeout](/) > Making ASICs

# Making ASICs

You’ve used Wokwi or an HDL to make your digital design, but how do we go from there to an ASIC?

We use [OpenLane](https://www.zerotoasiccourse.com/terminology/openlane/), an open source tool that can convert a digital netlist in Verilog format to the [GDS](https://www.zerotoasiccourse.com/terminology/gds2/) files needed for ASIC manufacture.

To make things easier, we install the tools and run them on GitHub’s servers. As the designs are open source, we get free computing power.

In this video I explain how it works and take a look at OpenLane and the logs produced.

# Manufacturing ASICs

And if you want to know how those GDS files are turned into an actual microchip, you’ll enjoy this factory tour!
