wecallemjazzyfact/TinyTapeout-BGR-LDO/designs/bgr_ldo/docs/06_6BIT_POST_LAYOUT_VERIFICATION.md

# 6-bit post-layout 검증 결과 (2026-08-29)

조건: PEX R+C (`pex6_safe.spice`), tt/27°C, **code 28**, 소자 X 575 / R 6396 / C 75

---

## 0. 종합 판정 — 전 항목 PASS

| 항목 | 4-bit (08-12) | 6-bit | 판정 |
|---|---|---|---|
| **MC 3σ** | 15.220 mV | **10.251 mV** | **개선 (1.5배)** |
| **PM 최악** | 69.84° | **69.52°** | **PASS** (>45°) |
| **GM 최악** | 11.49 dB | **11.49 dB** | **PASS** (>10 dB) |
| **PSRR DC** | −51.9 dB | **−56.5 dB** | **개선 (+4.6 dB)** |
| **Load under/over (실사용)** | −56.3 / +28.9 mV | **−55.4 / +28.8 mV** | **동등** |
| **Line dip/over (실사용)** | −2.78 / +1.95 mV | **−2.49 / +1.95 mV** | **동등** |
| **Startup 오버슈트** | +44 mV | **+46.5 mV** | **동등** |

---

## 1. 루프이득 (이중주입 Middlebrook)

| 조건 | Tdc (dB) | UGF (MHz) | PM (deg) | GM (dB) | f180 (MHz) |
|---|---|---|---|---|---|
| **무부하** | 95.47 | 2.6645 | **69.52** | 21.00 | 18.86 |
| **이상원 1.5 mA** | 101.14 | 3.0975 | 97.59 | **11.49** | 36.13 |
| **온칩 싱크** | 88.99 | 2.8272 | 96.58 | 12.58 | 37.37 |

```text
PM 최악 69.52 deg  (스펙 >45°, 목표 60°)   PASS
GM 최악 11.49 dB   (스펙 >10 dB)          PASS
```

★ **08-12 미해결 C1 항목 해소**
- SNK 조건 Tdc가 $78.39\text{ dB} \rightarrow \mathbf{88.99\text{ dB}}$로 상승하여 pre-layout($89.65\text{ dB}$)에 근접.
- 4-bit 때의 $-11.26\text{ dB}$ 차이는 6-bit 정밀 레이아웃에서 재현되지 않고 정상화됨.

---

## 2. PSRR

| 주파수 | 무부하 | 이상원 1.5mA | 온칩싱크 | 4-bit |
|---|---|---|---|---|
| **DC (10 Hz)** | −56.52 dB | −56.47 dB | −56.49 dB | −51.9 dB |
| **1 kHz** | −56.20 dB | −56.15 dB | −56.18 dB | — |
| **100 kHz** | −27.68 dB | −27.63 dB | −27.74 dB | −27.7 dB |
| **1 MHz** | −8.67 dB | −9.10 dB | −9.24 dB | −9.2 dB |

> **분석**: DC에서 **+4.6 dB 개선**. 트림 저항 세분화로 분압단 임피던스가 낮아진 영향으로 분석됨.

---

## 3. 과도 응답 (Transient)

| 시험 | v0 | 극값 | 편차 | 4-bit 대조 |
|---|---|---|---|---|
| **Load 100ns (이상원)** | 1.80745 V | min 1.67148 / max 1.96754 V | −136.0 / +160.1 mV | −136.4 / +160 mV |
| **★ Load 1µs (SNK_EN, 실사용)** | 1.80745 V | min 1.75210 / max 1.83623 V | **−55.4 / +28.8 mV** | −56.3 / +28.9 mV |
| **Line 100ns** | 1.80014 V | dip 1.65820 / ovr 1.93261 V | −141.9 / +132.5 mV | −142 / +132 mV |
| **★ Line 10µs (실사용)** | 1.80019 V | dip 1.79770 / ovr 1.80214 V | **−2.49 / +1.95 mV** | −2.78 / +1.95 mV |

- `VDDC` 절대 최대 전압: **1.98 V**
- 실사용 최대 전압: **1.83623 V** $\rightarrow$ **마진 144 mV 확보**
- 100 ns 극단 조건(이상원)의 1.96754 V는 정격 밖 스트레스 시험이며 4-bit와 동등하게 안전 영역.

---

## 4. Startup (VAPWR/VDPWR 20 µs 램프, uic)

```text
VDDC      25µs: 1.80745 V   50µs: 1.80745 V   100µs: 1.80745 V   149µs: 1.80745 V
VREF_LOW  25µs: 1.20515 V   50µs: 1.20515 V   100µs: 1.20515 V   149µs: 1.20515 V
오버슈트   1.85391 V at 20 µs   (+46.5 mV)
```
- 25 µs 시점에 이미 완전 정착. Degenerate(영점 고착) 상태 없음.

---

## 5. Monte Carlo 분석 (Mismatch Only, tt_mm / 27°C)

| 단계 | 방법 | $\sigma$ | $3\sigma$ |
|---|---|---|---|
| **Stage 1** | code 28 고정 | 36.535 mV | — |
| **Stage 2** | 이진 code | 6.843 mV | 20.529 mV |
| **★ Stage 3** | **LUT rank** | **3.417 mV** | **10.251 mV** |

```text
- 표본: N = 294 (이탈 2건은 Stage 2 미수렴 전파 건이며 트림 로직 무관)
- 통계: Mean +0.510 mV, Min / Max: −5.299 mV / +12.221 mV
- 스펙(±36 mV) 대비 여유 3.51배, 위반 0건 (수율 100%)
- 사용 코드: code 15 ~ 41 (상하 여유 15코드 / 22코드 확보)
```

---

## 6. 코너 특성 (code 28 고정, 15점)

| Corner | −40°C | 27°C | 85°C | 드리프트 ($\Delta V$) | TC (ppm/°C) |
|---|---|---|---|---|---|
| **tt** | 1.798867 V | 1.800143 V | 1.798442 V | **1.701 mV** | **7.56** |
| **ss** | 1.800650 V | 1.802518 V | 1.801426 V | **1.868 mV** | **8.29** |
| **ff** | 1.868485 V | 1.869898 V | 1.867855 V | **2.043 mV** | **8.74** |
| **sf** | 1.793833 V | 1.794696 V | 1.792225 V | **2.471 mV** | **11.01** |
| **fs** | 1.806282 V | 1.802781 V | 1.801318 V | **4.964 mV** | **22.03** |

- 27°C 코너 간 이탈: **75.2 mV** $\rightarrow$ LSB 8.4 mV 기준 9코드면 보정 완료 (스팬 2043 mV 여유 압도적)
- `fs` TC 22 ppm/°C는 타 코너의 2~3배 수준이나 스펙 여유가 커서 양산/동작에 지장 없음.

---

## 7. 트림 코드 — ★ LUT 순서 필수 원칙

이진 code는 단조가 아님:
```text
code 31 = 011111  ->  1.774496 V
code 32 = 100000  ->  1.783678 V     (+9.18 mV 역전)
```
- **원인**: TRIM5(18,198 Ω) > 하위 5비트 합(17,886 Ω) = **312 Ω 초과**
- **해법**: 이진 code 대신 **전압 내림차순 rank**로 트림 이동:
```text
LUT 파일 : ldo/lut6.txt (rank code V, 63 엔트리)
알고리즘 : rank_new = rank_cur + round((V - 1.800) / 8.377mV)
```

---

## 8. 사용 파일 및 AC 이중주입 식

```text
PEX 파일   : layout/ldo_top/pex6_safe.spice        (동작점/과도/PSRR)
             layout/ldo_top/pex6_ac_tv.spice       (AC 전압주입)
             layout/ldo_top/pex6_ac_ti.spice       (AC 전류주입)
테스트 덱  : ldo/v6/*.sp
데이터     : layout/ldo_top/simdata/*_6b.txt
LUT        : ldo/lut6.txt
MC 결과    : ldo/mc/mc6_s3n_*.sp -> mc6_o3n_*.txt
```

### AC 이중주입(Middlebrook) 계산식
```text
Tv = -v(x1.FB_TAP)/v(x1.FB_TAP_PRB)      (tv 덱)
Ti = -i(v.x1.vprb1)/i(v.x1.vprb2)        (ti 덱: 전류비)
T  = (Tv*Ti - 1)/(Tv + Ti + 2)
```

---

## 9. 남은 작업 (Next Actions)

1. **GDS 제출본 갱신**: `ldo_top_fixed.gds` ➔ top shuttle 조립 및 `info.yaml` 반영
2. **TinyTapeout Precheck 재실행**
3. **데이터시트 반영**: LUT 트림 표, VGND IR Drop (21.3 mV), `fs` TC 특성 명시
