wecallemjazzyfact/TinyTapeout-BGR-LDO/designs/bgr_ldo/milestones/10_ibea_tap/RESULTS.md

# Milestone 10 — EA 바이어스 탭(IB_EA) 신설, 벌크 정정 및 bgr_core 계층 심볼화 검증 보고서

최종 갱신: 2026-07 — IB_EA 바이어스 탭 구현, 벌크 결선 4건 정정 및 bgr_core 계층 검증 완료 (Core Unperturbed)

---

## 1. 개요 및 스펙 요약

LDO 오차 증폭기(EA) 구동에 필요한 고정밀 바이어스 전류를 제공하기 위해, BGR 메인 PMOS 미러 상단에서 브랜치 전류($10.25294\,\mu\text{A}$)의 $1/4$ 스케일인 **$2.5632\,\mu\text{A}$ 공칭 복사 탭 단자(`IB_EA`)**를 신설하고 검증을 완료하였습니다.

| 파라미터 | 설계 목표 | 실측 측정치 | 측정 조건 및 비고 | 평가 |
| :--- | :---: | :---: | :--- | :---: |
| **기준 전압 ($V_{ref}$)** | `1.2 V` | **`1.186591 V`** | tt, 27°C, 트림 코드 중앙값 | **PASS** |
| **온도 계수 (TC)** | `< 50 ppm/°C` | **`7.5 / 8.6 / 9.0 ppm/°C`** | tt / ss / ff 코너 ($-40\sim125^\circ\text{C}$) | **PASS** |
| **Line Regulation** | `< 0.5 %/V` | **`0.0834 %/V`** | tt 코너, VAPWR $3.0\text{V} \sim 3.6\text{V}$ | **PASS** |
| **소모 전류 ($I_Q$, 코어)** | `< 60 µA` | **`59.71 µA`** | tt 코너, 27°C (탭 제외 코어) | **PASS** |
| **바이어스 출력 ($I_{B,EA}$)** | `2.5632 µA` | **`2.564228 µA`** | tt, 27°C, $VAPWR=3.3\text{V}$, $V(IB\_EA)=0.95\text{V}$ | **PASS** (+0.04% 정합) |
| **몬테카를로 산포 ($\sigma$)** | — | **`2.22 %` (pooled)** | 3회 $N=100$ 분산 평균 ($\pm 3\sigma = \pm 6.66\%$) | **우수** |
| **최소 동작 전원 ($V_{min}$)** | — | **`2.190 V / 2.380 V / 2.050 V`** | tt / ss−40 / ff125 ($V_{ref}$ 95% 유지 하한) | **PASS** (마진 $+620\,\text{mV}$) |

---

## 2. IB_EA 바이어스 탭 성능

* **구성 소자**: `XXM_tap_top` (`pfet_g5v0d10v5` W20/L4 m1) + `XXM_tap_casc` (`pfet_g5v0d10v5` W10/L2 m1)
* **Compliance 범위**: $\pm 1\%$ 유효 전류 유지 구간 **`0 ~ 3.00 V`**, 역산 출력 저항 $R_{out} \approx 820\,\text{M}\Omega$ ($\Delta I / \Delta V = 1.22\,\text{nA/V}$)
  * 실측점: $V=0.5\,\text{V} \rightarrow 2.5646\,\mu\text{A}$ / $1.5\,\text{V} \rightarrow 2.5637\,\mu\text{A}$ / $2.0\,\text{V} \rightarrow 2.5632\,\mu\text{A}$ / $2.5\,\text{V} \rightarrow 2.5626\,\mu\text{A}$ / $2.8\,\text{V} \rightarrow 2.5618\,\mu\text{A}$
* **동작점 마진**:
  * $net\_tap = 2.9948\,\text{V}$
  * `tap_top`: $V_{DS} = 0.3051\,\text{V} > v_{dsat} = 0.1583\,\text{V}$ (포화 영역 마진 $147\,\text{mV}$)
  * `tap_casc`: $V_{DS} = 2.0446\,\text{V} > v_{dsat} = 0.1502\,\text{V}$
* **온도 특성**: $-40^\circ\text{C} = 2.6376\,\mu\text{A}$ / $27^\circ\text{C} = 2.5669\,\mu\text{A}$ / $125^\circ\text{C} = 2.4156\,\mu\text{A}$ (변동폭 $8.65\%$, $\text{TC} = -524\,\text{ppm}/^\circ\text{C}$)
  * 최악 코너 ($ss / -40^\circ\text{C}$): $2.6823\,\mu\text{A}$ (tt/27 대비 $+4.6\%$)
* **몬테카를로 산포**: $\sigma = 2.63\%$ ($N=100$, MM+PR), mean $= 2.57023\,\mu\text{A}$, $\text{corr}(V_{ref}, IB\_EA) = +0.772$ (상관 $2.03\%$ + 독립 $1.67\%$)

---

## 3. 벌크 결선 정정 전후 비교

| 항목 | 정정 전 (Floating Bulk) | 정정 후 (`VGND` 접속) | 변동량 및 비고 |
| :--- | :---: | :---: | :--- |
| `XXM_cn_d1/d2` 벌크 | `net9` (부유 웰) | **`VGND`** | p-기판 바디 효과 정상화 |
| `XXM4 / XXM4c` 벌크 | 글로벌 `0` | **`VGND` 포트** | LVS 미스매치 방지 |
| $V_{casc\_n}$ 전압 | `2.4829 V` | **`2.6086 V`** | $+126\,\text{mV}$ (정상 바디 효과 반영) |
| $V_{mid1}$ 전압 | `1.9628 V` | **`1.9687 V`** | $+5.9\,\text{mV}$ |
| Line Regulation | `0.0840 %/V` | **`0.0834 %/V`** | 미세 개선 |
| $V_{ref}$ 전압 | `1.186591 V` | **`1.186591 V`** | 변동 없음 ($1\,\mu\text{V}$ 이내) |
| $V_{min}$ (3개 코너) | `2.190 / 2.380 / 2.050 V` | **`2.190 / 2.380 / 2.050 V`** | 변동 없음 ($\pm 0\,\text{mV}$) |

---

## 4. 계층 심볼 (`bgr_core`) 등가성 검증

`bgr_core_tb.sch` (플랫)와 `bgr_core_tb2.sch` (계층 심볼 `bgr_core.sch` 사용)의 OP 실측 비교:

| 노드 / 파라미터 | 플랫 TB 실측치 | 계층 TB 실측치 | 일치 여부 |
| :--- | :---: | :---: | :---: |
| $v(vref\_low)$ | `1.186591 V` | `1.186591 V` | **100% 일치** |
| $v(v\_casc\_n)$ | `2.608633 V` | `2.608633 V` | **100% 일치** |
| $v(v\_mid1)$ | `1.968699 V` | `1.968699 V` | **100% 일치** |
| `XM_top1` `@m[id]` | `1.025294e-05 A` | `1.025294e-05 A` | **100% 일치** |
| `tap` 복사 전류 | `2.564175 µA` | `2.564245 µA` | `70 pA` 차이 (부하 연결 방식 차이) |
| 총 물리 전류 ($-i(vsource)$) | `62.27277 µA` | `62.27285 µA` | **100% 일치** |

---

## 5. 저항 모델 정정 전후 비교 (3점 피팅 + in-circuit 검증)

* **정정 모델 파라미터**: `sheet` = **`470.976 Ω/µm`**, `head1` = **`262.85 Ω/단자`** (2헤드 기생 = **`525.70 Ω`**), 1유닛($L=4.416\,\mu\text{m}$) = **`2605.5 Ω`**.
* **합성 길이 공식**: $L_{\text{total}} = 5.5322 N - 1.1162 \quad [\mu\text{m}]$
* **전후 비교**:
  * 구 장부 수치: `491 Ω/µm`, `390 Ω/head`, `2948 Ω/unit` $\rightarrow$ 출처 소급 불가 무검증 수치였음.
  * BGR in-circuit 교차 검증: $V_{ref} / I_{branch} = 1.186591\,\text{V} / 10.25294\,\mu\text{A} = 115,732\,\Omega$ (신모델 $115,697\,\Omega$ 대비 오차 단 **$-0.03\%$**, 구장부 $120,948\,\Omega$ 대비 $-4.3\%$).
* **결론**: 문서 장부 표기 정정 진행 완료. 회로/넷리스트 및 시뮬레이션 결과는 PDK 실물 모델 기반이므로 기존 결과 무효화 없음.

---

## 6. 저항 코너 구조 (`corner_factor` 메커니즘)

* **폴리 시트 수식**: $\text{sw\_sky130\_fd\_pr\_\_res\_high\_po\_rs} = \{325.0 + \text{corner\_factor} \times 45.0\} + \text{GAUSS}(0, 0.035, 1)$
* **종속 구조**: `corner_factor`는 트랜지스터 코너(`tt`/`ss`/`ff`)에 종속된 전역 변수임 (`parameters_res_high.spice`).
* **실측 $R_{2,\text{eff}}$ ($27^\circ\text{C}$)**:
  * `ff` 코너: $122.18\,\text{k}\Omega$ ($\text{corner\_factor} > 0 \rightarrow$ **저항 High**)
  * `tt` 코너: $115.75\,\text{k}\Omega$
  * `ss` 코너: $113.93\,\text{k}\Omega$ ($\text{corner\_factor} < 0 \rightarrow$ **저항 Low**)
* **의미**: $I_{B,\text{EA}}$와 $I_{\text{div}}$가 동일 폴리 저항을 공유하므로 `corner_factor`가 비에서 완전 소거됨. **비율계량이 PDK 모델 수준에서 보증됨**을 실증.

---

## 7. IB_EA 9-코너 매트릭스 측정 결과

| corner_T | IB_EA (µA) | Vref (V) | R2eff (kΩ) |
| :--- | ---: | ---: | ---: |
| **ff / −40 °C** | 2.5810 | 1.23371 | 119.574 |
| **ff / 27 °C** | 2.5273 | 1.23433 | 122.179 |
| **ff / 125 °C** | 2.4008 | 1.23458 | 128.597 |
| **tt / −40 °C** | 2.6370 | 1.18589 | 112.466 |
| **tt / 27 °C** | 2.5648 | 1.18653 | 115.746 |
| **tt / 125 °C** | 2.4151 | 1.18632 | 122.803 |
| **ss / −40 °C** | 2.6823 | 1.18702 | 110.714 |
| **ss / 27 °C** | 2.6091 | 1.18806 | 113.927 |
| **ss / 125 °C** | 2.4592 | 1.18858 | 120.870 |

* **미러 오차**: 전 9점 $\le 0.08\%$
* **TC**: tt $-524\,\text{ppm}/^\circ\text{C}$ / ss $-518\,\text{ppm}/^\circ\text{C}$ / ff $-432\,\text{ppm}/^\circ\text{C}$

---

## 8. Task 6 통합 인터페이스 동결 사양

* **`bgr_core` 핀 (4핀)**: `VAPWR` / `VREF_LOW` / `IB_EA` / `VGND`
* **E6 게이트 클램프**: C안 확정 (LDO $V_{NB1} > \approx 0.9\,\text{V}$ 판정 thick-ox 다이오드 2단)
* **`VREF_LOW` 노드 무섭동**: LDO 실부하 인가 시 $V_{NB1} = 1.11196\,\text{V}$ (LDO 실측 $1.111965\,\text{V}$와 6자리 정합)
* **전체 전류 회계 정산**: BGR 코어(59.71) + LDO EA(33.33) + 분압기(46.06) = **`139.10 µA`** ($< 150\,\mu\text{A}$ 통과)
* **$V_{out}$ 기준 이원화**: 트림 전 `1.780 V` / 트림 후 `1.800 V` (LSB $16.0\,\text{mV}$)
* **Top Ownership**: LDO 담당
