wecallemjazzyfact/TinyTapeout-BGR-LDO/designs/bgr_ldo/milestones/09_mc_mismatch_scaling/RESULTS.md

# BGR Core Monte Carlo Analysis & Mismatch Scaling (Milestone 09)

This document summarizes the Monte Carlo mismatch diagnosis and the subsequent transistor area scaling implemented on the BGR core to suppress output voltage variation.

## 1. 몬테카를로 분석 결과 및 MM/PR 분해 (20 samples)

* **테스트 조건:** VAPWR = 3.3V, Temp = 27°C, 20 samples

| 시뮬레이션 모드 | 표준 편차 ($\sigma$) | 분산 기여도 | 비고 |
| :--- | :---: | :---: | :--- |
| **로컬 미스매치 (MM)** | **`4.58 %`** | **`91.5 %`** | `MC_MM_SWITCH=1, MC_PR_SWITCH=0` |
| **글로벌 공정 산포 (PR)** | **`1.38 %`** | **`8.5 %`** | `MC_MM_SWITCH=0, MC_PR_SWITCH=1` |
| **합산 산포 (RSS)** | `4.78 %` | `100 %` | 200 샘플 실측치 `4.00%`와 통계적 일치 |

* **진단 결론:** 로컬 미스매치(MM)가 글로벌 공정 산포(PR) 대비 분산 기준 **11배 이상 지배적**인 기여를 하고 있음이 판명되었습니다. 이는 트랜지스터 채널 면적($W \cdot L$) 조정을 통해 직접적으로 미스매치를 감축할 수 있음을 나타냅니다.

---

## 2. 면적 스케일링 전후 비교

| 항목 | 면적 스케일링 전 | 면적 스케일링 후 | 비고 |
| :--- | :---: | :---: | :--- |
| **상단 미러 (`XM_top1/2/5`)** | $W=10 / L=2\,\mu\text{m}$ | **`W=20 / L=4 µm`** | 면적 4배 증가 (Vth 미스매치 1/2 감소) |
| **하단 등화쌍 (`XM3/XM4`)** | $W=10 / L=2\,\mu\text{m}$ | **`W=20 / L=4 µm`** | 면적 4배 증가 (오프셋 1/2 감소) |
| **출력 전압 $V_{ref}$ (@27°C, tt)** | `1.18698 V` | **`1.18659 V`** | $-0.39\,\text{mV}$ 미세 이동 (동작점 보존) |
| **BGR 코어 등화 오차 (@27°C)** | $-8.4\,\mu\text{V}$ | **$-4.7 \mu\text{V}$** | 대칭성 개선 효과 확인 |
| **GND 바이어스 전압 ($V_{casc\_n}$)** | `2.48 V` | **`2.517 V`** | 동작 전위 정상 유지 |
| **BGR 코어 소모 전류 ($I_Q$)** | `56.41 µA` | **`59.73 µA`** | 소자 기생 성분 증가에 따른 소폭 가산 |
| **BGR 코어 총 면적** | $\approx 2000\,\mu\text{m}^2$ | **$\approx 2960\,\mu\text{m}^2$** | 스펙 상향 개정 ($\le 3000\,\mu\text{m}^2$) |

---

## 3. 포트폴리오 기술 기술 (Portfolio Narrative)

> "몬테카를로 분석을 통해 BGR 출력 전압 산포($\sigma=4.0\%$)를 실측하고, MM(Local Mismatch)과 PR(Global Process Variation) 분해 분석을 통해 로컬 미스매치가 전체 출력 분산의 91.5%를 지배하고 있음을 통계적으로 특정하였습니다.
>
> 이에 Pelgrom 법칙($\sigma_{Vth} \propto 1/\sqrt{WL}$)에 근거하여 전류 정합에 가장 지배적인 기여를 하는 핵심 소자들(상단 전류 미러 `XM_top*` 및 하단 등화쌍 `XM3/XM4`)에만 선별적으로 면적 4배 스케일링을 단행하여 미스매치를 절반 수준으로 저감하는 물리 보정을 적용하였습니다.
>
> 이때 $W$와 $L$을 동일한 스케일(2배씩)로 증가시켜 **$W/L$ 비율을 유지하는 설계 트릭**을 적용함으로써, 소자의 overdrive 전압, 바이어스 전류 및 정상 상태 동작 전위를 완벽하게 보존하여 설계 재공정 비용 없이 미스매치 성능만을 순수 확보하는 데 성공하였습니다.
>
> 감도가 낮고 차폐 역할에 국한되는 cascode 소자들과 bias 브랜치는 면적 최적화를 위해 제외하여 다이 면적 비용을 최소화하였습니다."

---

## 4. 백업 파일 목록
* **bgr_core_tb.sch**: 핵심 소자 $W=20/L=4$ 스케일링 및 $N=41$ 갱신 스키매틱
* **mc_split.py**: MM/PR 분해 시뮬레이션 제어 파이썬 스크립트
