wecallemjazzyfact/TinyTapeout-BGR-LDO/designs/bgr_ldo/LOGBOOK.md

# BGR & LDO Design Logbook

이 로그북은 TinyTapeout Analog BGR + LDO 프로젝트의 주요 설계 변경 사항, 시뮬레이션 시행착오, 그리고 핵심 의사결정 과정을 시간순으로 기록하는 엔지니어링 포트폴리오 자산입니다.

## [2026-07] 4-bit 트림 회로 구현·검증 완료
- **구조 및 구현**: $R_2$ 분할 (고정부 $108.6\,\text{k}\Omega$ + 4 이진 세그먼트 $1.1 / 2.2 / 4.5 / 9.0\,\text{k}\Omega$) + `trim_sw` (`nfet_01v8` $W=10, L=0.15, m=22 \times 4$) 병렬 단락 방식 확정.
- **실측 특성**: 16코드 완전 단조성 보장, DNL $0.012\,\text{LSB}$, $V_{out}$ 범위 $1.671 \sim 1.929\,\text{V}$, 중앙 코드 $1.800\,\text{V}$, 양자화 잔여 오차 $\pm 8.6\,\text{mV}$ ($V_{ref}$ LSB $11.5\,\text{mV} \rightarrow V_{out}$ LSB $17.25\,\text{mV}$).
- **3중 검증 통과**: 플랫 16코드 파일 스윕, 계층 3코드 6자리 수치 일치, 몬테카를로 중앙 코드 $\sigma = 2.38\%$ (트림 전 $2.06 \sim 2.38\%$와 정합).
- **불변성 검증**: $I_{B,EA}$ 바이어스 전류 전 코드 $2.564175\,\mu\text{A}$ (6자리 일치), $R_2$ 3코드 스케일 불변 TC $7.7 / 7.5 / 7.4\,\text{ppm}/^\circ\text{C}$ (편차 $35\,\text{ppm}$ 이내).
- **넷리스트 디버깅 이력**: 스위치 핀 배정 순서 오류(Drain/Gate/Source 순서 차이로 Gate에 저항 세그먼트 노드 할당)로 첫 시도에서 16개 코드 전 구간 동작 안 함(스위치 미동작) 현상 발생 $\rightarrow$ G를 `TRIM` 포트에 정상 연결하도록 정정하여 문제 완소.
- **대칭 정렬 조정**: 초기 세그먼트 설계 시 중앙치 $1.793\,\text{V}$ 수렴 $\rightarrow$ 고정부 저항 $+0.396\%$ (전체 $R_2 \times 1.00396$) 미세 정렬 조정을 적용하여 중앙 $1.800\,\text{V}$ 정렬 완료.

---

## [2026-07] 저항 모델 장부 오류 정정 (무검증 수치 3호)
- **경위**: LDO 단독 3점 피팅 실측치와 BGR in-circuit OP 데이터를 통해 저항 모델 정밀 검증 실시. BGR 골든 OP 나눗셈 $V_{ref} / I_{branch} = 1.186591\,\text{V} / 10.25294\,\mu\text{A} = 115,732\,\Omega$ (신모델 $115,697\,\Omega$ 대비 $-0.03\%$, 구장부 $120,948\,\Omega$ 대비 $-4.3\%$).
- **구값 출처**: 구 장부 수치(`491 Ω/µm`, `390 Ω/head`, `2948 Ω/unit`)는 출처 소급 불가한 무검증 수치였음.
- **영향**: 문서 장부값 정정만 진행 (회로·넷리스트 및 전기적 결과는 PDK 모델 직접 실행이므로 기존 시뮬레이션 영향 없음).
- **$V_{ref}$ $-1.1\%$ 인과 가설 기각**: 저항비 $R_2/R_1$이 $6.828 \rightarrow 6.911$ ($+1.13\%$)로 조정되면서 $V_{ref}$는 오히려 $+$ 방향으로 이동함. 공식 오류가 없었다면 $V_{ref}$는 $1.182\,\text{V}$로 목표치(1.2V)에서 더 떨어졌을 것임. 따라서 $1.18659\,\text{V}$ ($-1.1\%$) 수렴은 $N=41$ 온도 계수(TC) 최적점 선택에 따른 의도적 트레이드오프임.
- **교훈**: 저항 파라미터는 in-circuit $V/I$ 나눗셈을 통해 손쉽게 검증할 수 있었다 — 이후 저항 수치 기록 시 회로 실측 $V/I$ 검증값을 반드시 병기할 것.

---

## [2026-07-09] BGR 토폴로지 변경 결정
- **상황:** 초기 계획에서는 일반적인 Kuijk / Brokaw 위상(전압 모드 BGR, 저항이 BJT와 직렬)의 구현을 검토함.
- **결정:** **Banba 위상(전류 모드 BGR, 저항이 BJT와 병렬)**으로 설계 방향을 선회함.
- **근거:** 
  - 저전압(1.8V 출력 타겟) 동작에 유리하고 면적 효율이 높음.
  - 피드백 루프를 통해 전압 정합과 전류 정합을 독립적으로 관리할 수 있어 3-bit 디지털 저항 트림 연동에 유연함.
- **결과:** Banba 토폴로지를 프로젝트 기준 아날로그 BGR 코어로 확정.

## [2026-07-10] BJT 코어 매칭 설계 및 기본 소자 매개변수 확정
- **상황:** PNP 바이폴라 트랜지스터(BJT) 루프의 면적비 매칭 및 저항 소자 선정 단계.
- **결정:** 
  - 면적비(N)를 대칭 레이아웃 구현(Common-Centroid 및 Dummy 배치)에 최적인 **$N = 8$**로 확정.
  - BJT는 sky130 PDK의 **`pnp_05v5_W0p68L0p68`** 사용.
  - 저항은 공정 오차를 줄이기 위해 High-sheet-resistance 폴리 실리콘 소자인 **`res_high_po`**로 단일화.
- **결과:** 레이아웃 매칭 가이드라인 수립 및 시뮬레이션용 소자 템플릿 준비 완료.

## [2026-07-10] PNP 코어 기본 특성 및 $N_{eff}$ 에미터 주변부 효과 실측
- **상황:** PNP BJT 루프의 단일 branch 3µA 전류 조건 하에 $V_{BE}$ 및 $\Delta V_{BE}$ 기본 특성을 실측하고 이론치와 비교.
- **결과:** 
  - **$V_{BE} = 774.05\,\text{mV}$** (@ 3µA, 27°C, m=1)
  - **$\Delta V_{BE} = 53.02\,\text{mV}$** (@ 3µA, 27°C, 1:8)
  - **진단:** 이론치($V_T \ln(8) \approx 53.78\,\text{mV}$) 대비 **$-1.4\%$의 오차** 발견. 이는 에미터의 주변부 효과(Emitter Periphery Effects)에 따른 실효 면적비 감소 때문으로 분석됨 ($N_{eff} \approx 7.77$).
  - **해결:** 향후 BGR 브릿지 저항 $R_1$ 계산 등 수식 연산 시 이론치 대신 실측치 **$\Delta V_{BE} = 53.02\,\text{mV}$**를 물리 기준으로 삼기로 결정.

## [2026-07-11] [실패사례 1] 전류 강제형 테스트벤치 한계 직면
- **문제:** 초기 BGR Core 시뮬레이션 환경(`bgr_core_tb.sch`)에서 이상적인 독립 전류원($I_0 = I_1 = 3\,\text{µA}$)으로 양쪽 브랜치 전류를 완전히 묶어버림.
- **진단:** 각 분지 전류가 강제로 $3\,\text{µA}$에 못 박혀 있어, $R_6, R_7$ 저항값을 스윕해도 전체 branch 전류 변화가 전혀 포착되지 않고 온도 계수(TC) 최적점 튜닝이 무의미해짐.
- **해결:** 강제 전류원을 제거하고, 브랜치가 스스로 동작점 전류를 찾을 수 있도록 자율 바이어스(Self-bias) 방식의 이상적 피드백 루프로 테스트벤치 재설계 결정.

## [2026-07-11] [실패사례 2] Zero-State (0V 축퇴해) 고착 및 VCCS 역방향 전류 수렴
- **문제:** 강제 전류원을 제거하고 VCVS(증폭기) + VCCS(전류거울) 조합으로 피드백을 걸었으나, 시뮬레이션 전류가 여전히 BJT가 켜지지 않는 $1.0\,\text{µA} \sim 6.0\,\text{µA}$ 대역에 갇힘.
- **진단:** 
  - BJT가 켜지지 않아 루프 이득이 없는 상태에서도 대칭 저항에 의해 전압 평형이 이뤄져 $I=0$ (혹은 수 µA 대의 누설) degenerate point가 수학적으로 성립함.
  - 특히 SPICE의 이상적 VCCS는 역방향으로 전류를 빨아들일(Sink) 수 있어, 루프 전압이 뜨는 것을 억제해 축퇴점을 영속화함. 이는 실물 회로의 Startup 회로 결여를 시뮬레이션으로 증명한 셈임.
- **해결:**
  - VCCS를 단방향으로 흐르는 Behavioral B-source(`B1`, `B2`)로 대체하여 역전류 차단: `FUNC = "10u * V(V_ctrl) * u(V(V_ctrl))"`
  - 덱 상단에 `.nodeset v(vbe1)=0.75 v(net1)=0.75 v(v_ctrl)=1.0`를 복원하여 시뮬레이터가 정상 활성 상태로 초기 기동하도록 유도.

## [2026-07-11] 자율 바이어스 BGR 코어 동작점(op) 검증 완료
- **상황:** VCCS ➜ B-source 교체, VCVS Gain `1e5` 상향, `.nodeset` 설정 적용 후 27°C 단일 동작점 해석 검사 진행.
- **결과:**
  - $V(VBE1) = 777.16\,\text{mV}$, $V(net1) = 777.15\,\text{mV}$로 양 노드 전압차가 **단 $7.64\,\text{µV}$** 수준으로 정밀 잠금(Lock) 완료.
  - 바이어스 전압 $V(V\_ctrl) = 0.764\,\text{V}$ 수렴에 의거해 자율 공급 전류 **$7.639\,\text{µA}$** 획득.
  - 내부 전류 수식 검증 결과 $I_{CTAT} \approx 4.32\,\text{µA}$, $I_{PTAT} \approx 3.32\,\text{µA}$로 합산 전류가 공급 전류와 완벽 정합하여 active BGR 밸런스 검증에 완전히 통과함.

## [2026-07-12] 자율 바이어스 BGR 코어 미세 튜닝 및 최적 저항값 확정
- **상황:** $110\,\text{k}\Omega \sim 130\,\text{k}\Omega$ 범위에서 $3\,\text{k}\Omega$ 간격으로 미세 스윕(Fine Sweep)을 돌려 제로 온도 계수(Zero-TC) 포인트 실측.
- **결정:**
  - **`dc5` ($R_6 = R_7 = 122\,\text{k}\Omega$)**에서 전체 온도 영역($-40\sim125^\circ\text{C}$)에 걸쳐 $I_{total} \approx 9.68\,\text{µA}$로 완벽한 수평(Zero-TC) 곡선 형성 확인.
  - 실제 Active Current Mirror 장착 시 동작점 이동 및 레이아웃 상의 단위 저항(Unit Resistor) 매칭 제약을 고려하여, 더 이상의 이상 소자 미세 스윕은 생략하고 **$122\,\text{k}\Omega$ (Typical Target: $120\,\text{k}\Omega$)**을 Baseline으로 확정.
- **결과:** 이상 소자 기반 BGR Core 설계 목표 달성. 실물 트랜지스터(Cascode PMOS Mirror) 적용 단계로 진입.

## [2026-07-12] Step 1 실물 트랜지스터 자율 바이어스 회로 전환 및 OP 검증 완료
- **상황:** 이상 증폭기(E1) 및 B-source를 제거하고, 5V Thick-Ox 소자(`pfet_g5v0d10v5`, `nfet_g5v0d10v5`)를 사용하여 실물 Banba 자율 바이어스 루프(Step 1, 캐스코드 미장착)를 결선하고 DC 동작점(.op) 해석 수행.
- **동작 매커니즘 정립:**
  - **PMOS 미러(M1/M2):** 양 브랜치에 동일한 전류를 주입하는 **Current Forcing** 역할.
  - **NMOS 쌍(M3/M4):** 동일 전류 + 동일 $V_{GS}$ 조건 하에 두 소스 전위를 같게 묶는 **Voltage Equalizer** 역할 (Op-amp 가상 단락 대체).
- **결과 및 물리적 검증:**
  - **전압 예산(Headroom) 검증:** 
    - $V_{gate\_top} = 2.144\,\text{V}$로 PMOS 예측치($2.145\,\text{V}$)와 일치.
    - $V_{mid1} = 1.957\,\text{V}$로 예측치($1.69\,\text{V}$)보다 약 $267\,\text{mV}$ 상승.
    - **원인 분석 (Body Effect):** NMOS의 벌크가 접지(0V)되어 $V_{SB} \approx 0.78\,\text{V}$에 따른 강력한 바디 효과 발생. 이로 인해 NMOS 문턱 전압($V_{thn}$)이 $0.798\,\text{V} \rightarrow 1.069\,\text{V}$로 $271\,\text{mV}$ 증가하여 $V_{GS}$ 및 $V_{mid1}$이 함께 상승함.
  - **등화 품질 (Virtual Short):** $VBE1 - net1 = -747.6\,\text{µV}$로 서브 밀리볼트대 전압 등화 성공. 추가적인 NMOS 캐스코드 생략 설계의 타당성 입증.
  - **출력 및 거울 복사 오차:**
    - $VREF\_LOW = 1.273\,\text{V}$로 $1.2\,\text{V}$ 타겟 대비 높은 전압 수렴.
    - $I_{left} = 9.914\,\text{µA}$, $I_{right} = 9.811\,\text{µA}$로 **$1.05\%$의 브랜치 전류 mismatch** 발생.
    - $I(XM5) = 10.266\,\text{µA}$로 코어 대비 **$+4.64\%$의 복사 오차(Copying Error)** 발생. 이는 $V_{SD5}(2.03\,\text{V}) \ne V_{SD1}(1.16\,\text{V})$ 채널 길이 변조 효과($\lambda$)에 기인함.
- **향후 계획:** Step 2에서 PMOS 캐스코드 및 출력단 캐스코드를 장착하여 $V_{DS}$를 매칭하고 복사 오차($4.6\% \rightarrow <0.5\%$)를 억제할 계획.

## [2026-07-12] Step 2 PMOS Cascode 및 Wide-Swing Bias 검증 완료
- **상황:** M1/M2/M5 PMOS 미러에 각각 캐스코드 단(`XM_bot1/2/5`)을 추가하고, `XM_bias`($W/L=10/4, m=1$)를 바이어스 전류원($9.68\,\text{µA}$)으로 구동하여 Wide-Swing Cascode Mirror 구성 후 DC 동작 해석 수행.
- **결과 및 물리적 검증:**
  * **전류 매칭 성능 극대화:** 
    - 브랜치 전류 미스매치: $1.05\% \rightarrow \mathbf{0.018\%}$ (거의 완전히 제거됨)
    - M5 출력 복사 오차: $+4.64\% \rightarrow \mathbf{0.082\%}$ (56배 감소)
    - **원리:** 캐스코드가 하단 메인 PMOS들의 $V_{SD}$를 균등화하여 채널 길이 변조 효과($\lambda$)에 의한 오차를 완전히 차단함.
  * **등화 품질 개선 원리 분석:**
    - 전압 등화 오차($VBE1 - net1$): $-747.6\,\text{µV} \rightarrow \mathbf{-131.2\,\text{µV}}$
    - **원인 분석:** NMOS 자체의 성능 향상이 아니라, **상단 PMOS 캐스코드 장착을 통해 상류의 전류 불일치(1.05% ➜ 0.018%)가 제거되었기 때문임.** 양 브랜치에 공급되는 전류의 차이가 소멸되면서 NMOS 등화 장치가 담당해야 했던 전류 불균형 마진(Vgs 차이) 부담이 대폭 줄어들어 잔여 등화 오차가 서브 밀리볼트대 하단으로 크게 개선됨.
  * **메인 PMOS 포화 마진 확보:**
    - 캐스코드 PMOS의 벌크 효과($V_{SB} \approx 0.245\,\text{V}$)로 인해 문턱 전압 $|V_{thp}|$가 약 $+79\,\text{mV}$ 상승함.
    - 이로 인해 중간 PMOS 노드 전압이 추가로 하강하여, 상단 메인 PMOS들의 $V_{SD}$ 포화 마진이 예측치($176\,\text{mV}$)보다 높은 **$+95\,\text{mV}$** 수준으로 매우 안정적으로 확보됨.
  * **출력 전압 ($VREF\_LOW$):** 복사 오차 억제로 인해 **`1.2038 V`**로 설계 타겟(1.2V)에 거의 완벽히 수렴함.
- **향후 계획:** Step 3에서 온도 스윕 및 $R_6, R_7$ 저항의 미세 재스윕을 수행하여 실제 트랜지스터 미러 조건 하의 최적 제로-TC 포인트를 실측 및 확정할 예정.

## [2026-07-12] Step 2.5 바이어스 전류원 (I_bias) 실물화 및 자율 바이어스 피드백 검증
- **상황:** 이상 독립 전류원 `I_bias`를 제거하고, `V_gate_top` 노드로부터 미러링하는 실물 바이어스 체인(PMOS 미러 + NMOS diode + NMOS sink)을 구현하여 피드백 구동.
- **결과 및 물리적 검증:**
  * **전류 매칭 및 V_bias 정합:**
    - `XM_bias_mir`(m=4)가 `V_gate_top`에서 `~11.15µA`를 복사하여 `XM_bias_n1`(m=2) diode로 주입.
    - `XM_bias_n2`(m=2) sink 트랜지스터가 이를 1:1 비율로 복사하여 `XM_bias` diode로부터 `~11.24µA`를 GND 방향으로 끌어당김.
    - PMOS 및 NMOS의 드레인 전압 차이($V_{SD}$ 편차)로 인해 발생한 **bias 체인 λ 오차 +14%는 XM_bias diode 의 로그 민감도 덕에 V_bias 40mV 이동으로 흡수됨 — bias 는 정밀할 필요 없음**이 증명됨.
    - 결과적으로 바이어스 전압은 `1.784 V`로 정착하여 메인 PMOS의 포화 영역($V_{SD} \approx 320\,\text{mV} > v_{dsat} \approx 173\,\text{mV}$)을 안전하게 사수함.
  * **V_ref 및 온도 계수:**
    - V_ref (27°C) = `1.2167 V`
    - 온도 계수: **`TC = 17.8 ppm/°C`** ($-40\sim125^\circ\text{C}$ 전 구간 평탄도 유지)
    - 이상소자 개수: **`0개` (완전 실물 소자화 달성)**
- **향후 계획:** 루프 축퇴를 미연에 방지하여 Nodeset 의존성을 완벽히 탈피하기 위한 Startup 회로 설계(Step 2.6) 진행 예정.

## [2026-07-12] Step 2.6 Startup 회로 설계 및 사전 분석 정정
- **상황:** 전원 투입 시 혹은 글리치 발생 시 회로가 zero-state 축퇴해에 갇히는 것을 방지하기 위해 2단 능동 기동 회로(감지 PMOS `XM_su1` + NMOS 스위치 `XM_su_n1` + NMOS 다이오드 `XM_su_n2`) 설계 및 이론 계산 정정.
- **물리적 오차 및 계산 정정 기록:**
  * **중간 노드 평형 모순 정정:** 이전 분석의 `V_su_mid ≈ 2.13V` 서술과 `V_GS2 = 0.75V` 대입은 양립이 불가능한 오류였음. 실제 정상 상태에서는 `XM_su_n1`과 `XM_su_n2`가 직렬로 연결되어 자기일관(Self-Consistent) 평형 상태를 형성함. 즉, `XM_su_n2`가 subthreshold 경계에 앉아 `V_su_mid` 노드 전위는 문턱 전압 근처인 `~0.75V` 수준으로 결정되고, 남는 잔여 전압($2.13\text{V} - 0.75\text{V} = 1.38\text{V}$)은 스위치 `XM_su_n1`의 $V_{DS1}$이 흡수하여 차단 상태를 완성함.
  * **바디 이펙트 고려:** 기동 과도 상태에서 `XM_su_n1`에 걸리는 바디 이펙트($V_{SB} \approx V_{su\_mid}$)로 인해 문턱 전압 $V_{thn}$이 상승하지만, 게이트 구동 전압(`sense_out = 3.3V`) 마진이 워낙 충분하므로 기동(Kick) 강도에는 이상이 없음.
- **향후 계획:** 사용자가 xschem 스케메틱에 해당 결선을 반영하는 대로 시뮬레이션 및 규격(nodeset 주석 후 정상 기동, 잔류 전류 < 50nA, 램프 업 타임 등) 실측 검증 진행 예정.

## [2026-07-13] Step 2.6 Startup 회로 구조 B-1 및 PDK Binning 정정 기록
- **상황:** Startup 회로 차단 능력을 극대화하고 Latch-up 루프를 제거하기 위해 `XM_su_pd` 게이트를 `V_bias_n`에 물리는 B-1안 기반으로 회로 설계 진행.
- **PDK Binning 모델 해석 오류 정정:**
  * 이전 분석에서 PDK의 `lmax/wmax` 파라미터를 특정 이산(discrete) 소자 목록으로 오해했던 부분을 정정함. 
  * 실제 BSIM 모델 카드에서 `lmax/wmax` 및 `lmin/wmin`은 모델의 **구간(Interval) 경계값**을 의미함. 즉, 해당 구간 내부의 모든 치수는 연속적으로 사용 가능함.
  * 기존에 $L=30\,\mu\text{m}$에서 발생한 `no model available` 에러는 단지 최대 bin의 상한선인 **`20 µm`**를 초과했기 때문임. W 역시 특정 값만 가능한 것이 아니라 최솟값($0.42\,\mu\text{m}$) 이상 범위 내에서 임의로 사용 가능함.
- **최종 소자 사이징 확정:**
  * **`XM_su1` (PMOS 감지):** **`W = 0.42 µm / L = 20.0 µm`** (단일 소자 적용. $L$은 지원하는 최대 길이, $W$는 최소 너비를 채택하여 정적 전류를 극도 억제)
  * **`XM_pd` (NMOS 풀다운):** **`W = 4.0 µm / L = 2.0 µm`** (기존 유지)
  * **`XM_su_n1` / `XM_su_n2` (기동 스택):** **`W = 1.0 µm / L = 2.0 µm`** (기존 유지)
- **향후 계획:** 최종 결선 스케메틱 수정 완료 지시 시 TT 및 코너 시뮬레이션 실행 및 검증 예정.

## [2026-07-12] Step 3 온도 스윕 및 R6/R7 저항 미세 재스윕 (최적점 확정)
- **상황:** Step 2의 실물 트랜지스터 캐스코드 미러 상태에서 온도($-40\sim125^\circ\text{C}$) 스윕 및 $R_6=R_7$ ($R_{val}$) 저항을 $112\,\text{k}\Omega$부터 $132\,\text{k}\Omega$까지 $4\,\text{k}\Omega$ 단위로 스윕 수행.
- **결과 및 물리적 검증:**
  * **TC vs Resistor 스윕 결과 (주의: 이상 저항 기준):**
    - $112\,\text{k}\Omega$: $\text{TC} = 68.88\,\text{ppm}/^\circ\text{C}$ ($V_{ref,avg} = 1.2728\,\text{V}$)
    - $116\,\text{k}\Omega$: $\text{TC} = 29.64\,\text{ppm}/^\circ\text{C}$ ($V_{ref,avg} = 1.2441\,\text{V}$)
    - **`120 kΩ` (최적점):** **`TC = 18.07 ppm/°C`** ($V_{ref,avg} = 1.2172\,\text{V}$)
    - $124\,\text{k}\Omega$: $\text{TC} = 59.82\,\text{ppm}/^\circ\text{C}$ ($V_{ref,avg} = 1.1921\,\text{V}$)
    - $128\,\text{k}\Omega$: $\text{TC} = 100.60\,\text{ppm}/^\circ\text{C}$ ($V_{ref,avg} = 1.1685\,\text{V}$)
    - $132\,\text{k}\Omega$: $\text{TC} = 140.45\,\text{ppm}/^\circ\text{C}$ ($V_{ref,avg} = 1.1464\,\text{V}$)
  * **S자 곡선 (Curvature) 및 온도 의존성 원인 분석:**
    - 출력 $V_{ref}$의 S자 굴곡 성분은 **BJT $V_{BE}$의 $T \ln(T)$ 비선형 잔차**와 더불어 **NMOS 등화쌍의 온도의존적 오차**가 결합하여 발생한 것입니다.
    - NMOS 등화쌍은 온도가 상승함에 따라 드레인 노드의 전압 편차가 더 크게 확대되어, **약 `-3.5 µV/°C` 수준의 등화 온도 표류 오차**가 누적됩니다.
  * **최적점 이동 원인 분석:**
    - 이상 소자 상태의 최적 저항값은 $122\,\text{k}\Omega$ 이었으나, 실물 캐스코드 미러가 적용된 상태에서는 **`120 kΩ`**으로 약 **$-2\,\text{k}\Omega$ 이동**하였습니다.
    - 이는 실물 트랜지스터의 채널 길이 변조 효과의 극히 일부 잔여 성분 및 온도 상승에 따른 미러의 $V_{DS}$ 미세 변동이 CTAT/PTAT 전류 결합 비율에 복합적 영향을 준 결과입니다.
  * **최적 R ($120\,\text{k}\Omega$) 에서의 온도별 오차 매칭 성능:**
    - **$-40^\circ\text{C}$:** $V_{ref} = 1.2164\,\text{V}$ / 브랜치 미스매치: **`-0.013 %`** / M5 복사오차: **`+0.092 %`** / 등화오차: $67.71\,\text{µV}$
    - **$27^\circ\text{C}$:** $V_{ref} = 1.2170\,\text{V}$ / 브랜치 미스매치: **`+0.018 %`** / M5 복사오차: **`+0.080 %`** / 등화오차: $-130.49\,\text{µV}$
    - **$125^\circ\text{C}$:** $V_{ref} = 1.2207\,\text{V}$ / 브랜치 미스매치: **`+0.051 %`** / M5 복사오차: **`+0.082 %`** / 등화오차: $-503.26\,\text{µV}$
    - **결론:** 극단적인 온도 저온/고온 경계 조건에서도 브랜치 매칭은 $0.05\%$ 이내, 거울 복사는 $0.09\%$ 이내로 유지되어 캐스코드가 극도로 훌륭히 작동 중임이 검증되었습니다.
  * **수렴 안정성:** 전 온도 영역에서 수렴 실패 없이 완벽하게 수렴 완료.
- **향후 계획:** 셀프 바이어스 실물 소자화(Step 2.5)가 완료되어 바이어스 전류 및 평형점이 정상 안착됨에 따라, nodeset 의존성을 영구히 없애기 위한 Startup 회로 설계 및 검증(Step 2.6)을 진행함.

## [2026-07-13] Milestone 06: Startup 회로 검증 완료 — 3라운드 설계 여정
- **상황:** 스타트업 회로 설계 변경과 각 코너(TT, SS, FF) 및 전원 기동 시나리오별 과도 해석을 완료하고, 최종 동작점 및 정적 소모 전류 사양을 완벽하게 검증함.
- **Startup 회로 — 3라운드 설계 여정:**
  * **R1 (킥 상시 관통):** 최초 설계한 diode 차단 스택이 "저항 비율 싸움"에 극히 민감하여, 정상 동작 상태에서 킥 회로가 완전히 꺼지지 못하고 제3 동작점(9.23µA 관통, $V_{ref} = 2.91\,\text{V}$)에 정착하는 오동작 발생. 이를 방지하고자 비율 차단 방식을 "완전 스위치 오프" 구조로 변경(인버터 감지 + 킥 NMOS 게이팅).
  * **R2 (slow-ramp 가짜 평형):** 전원 전압 VAPWR을 1.5V에서 장시간 정차시키는 slow-ramp 시나리오에서, BJT가 꺼진 저전류 평형 상태($V_{BE1} = 0.459\,\text{V}$, $V_{ref} = 0.476\,\text{V}$)에 갇히는 가짜 평형 정착 문제 발생. 원인은 감지 노드로 선택한 `V_bias_n`이 zero-state와 normal-state 간에 로그적으로 압축되어(가짜 0.86V vs 진짜 0.92V) 구분 문턱이 성립되지 않았기 때문임. 이에 따라 감지 노드를 `VBE1`으로 이동시켜, "BJT의 완전한 turn-on 자체"를 킥 차단의 절대적 판정 조건으로 재설정함. 이를 통해 가짜 평형의 국소 안정성을 구조적으로 원천 제거함.
  * **R3 (은퇴 거부 ➔ 코너 마진):** 감지점 이동 후 `M_pd` 게이트에 $0.777\,\text{V}$가 가해져 오버드라이브가 극도로 부족($0.777 - V_{thn0} \approx 130\,\text{mV}$, subthreshold 경계)해져 인버터가 완전 반전되지 않는 문제 봉착. 이를 PMOS `XM_su1`을 3직렬(유효 $L=60$, 누설 전류 $\approx 0.2\,\text{µA}$)로 대폭 약화시켜 비교기 동작 기준을 강제로 하향 조절함으로써 TT 코너를 통과함. 그러나 SS/-40°C 코너에서 승부가 다시 뒤집혀(`M_pd` 복구 전류 $0.159\,\text{µA}$ vs `su1` 누설 $0.2\,\text{µA}$로 경쟁에서 져서 `sense_out` 누설이 383nA까지 치솟고 $V_{ref}$를 +90mV 오염시킴). 이를 해결하기 위해 `M_pd` 너비 W를 $4\,\mu\text{m} \rightarrow 12\,\mu\text{m}$로 확장하여 전 코너에서 확실한 차단 마진을 완전히 확보함. *(주석: 당시 이 미니스윕에서 측정된 절대 전류값(예: 12.97µA @VGS=0.92V)은 앵커 재실측 결과 동일 조건 실제값인 2.10µA 대비 약 6배 높았던 계통 오염으로 밝혀졌습니다. 다만 두 측정점의 비율(62배) 자체는 정확해 subthreshold 기울기 비교 논증은 유효했으며, M_pd 최종 사이징 W 4➔12 결정은 이 미니스윕이 아닌 ss/-40°C 과도 시뮬레이션 실패 분석 및 잔류 전류 실측을 통해 최종 결정되었으므로 BGR 코어 및 스타트업 설계 결론은 무사합니다.)*
- **교훈 및 설계 원칙:**
  1. 스타트업 검증은 정적 `.op` 해석만으로는 절대 불충분함. Slow-ramp 및 중간 전압 정차(Staircase) Transient 해석이 필수적임.
  2. 감지 노드는 로그 압축이 존재하지 않는 완벽한 이진성(binary-like) 신호인 `VBE1`을 선택하는 것이 옳음.
  3. TT 코너 통과는 마진이 0에 가까운 아슬아슬한 균형 상태일 수 있으므로, 코너 검증의 핵심은 "단순 통과 여부"가 아니라 "각 코너에서의 동작 마진 측정"임.
  4. PDK bin은 이산 목록이 아닌 범위이며, 소자별 단일 채널 상한선이 있음 (`pfet_g5v0d10v5` $L \le 20\,\mu\text{m}$). 따라서 그 이상의 super long-L은 복수 소자의 직렬 스택으로 설계 합성해야 함.
- **향후 계획:** 다음 단계인 실저항 교체(Step 2.7)를 준비하여 이상 저항들을 실제 고시트 poly 저항 소자(`res_high_po_0p69`)로 마이그레이션 및 스위칭 분석을 진행함.

## [2026-07-13] Milestone 07: 실저항 교체 및 N 스윕 온도 보상 최적화 완료
- **상황:** 회로 내 모든 이상 저항을 실물 고시트 Poly 저항(`sky130_fd_pr__res_high_po_0p69`)으로 교체 완료하고, 유닛 매칭 원칙을 적용한 후 CTAT 저항 유닛 수 $N$ 스윕을 통해 최적의 온도 안정도 및 출력 분산 특성을 확정함.
- **물리적 현상 및 설계 검증 기록:**
  * **이상 저항 ➔ 실저항 마이그레이션 및 정수배 매칭:**
    * $R_1$ 저항을 기준으로 하여 $R_u = 17.7\text{k}\Omega / 6 = 2.95\text{k}\Omega$ 단위를 설계의 근간으로 확정하고, $W=0.69\,\mu\text{m}$의 `res_high_po_0p69`를 채택.
    * 접촉 저항($R_{head} = 780\,\Omega$)의 비중을 **`26.4 %`** 수준으로 억제하여 공정 산포 면역력 강화.
  * **Banba 구조의 저항 절대값 오프셋 소거 검증:**
    * 실물 저항 교체 결과 저항의 절대값이 기생 성분으로 인해 손계산 이상 저항 대비 약 **`-4.5 %`** 이탈하여 구현됨.
    * 그러나 최종 출력 $V_{ref}$의 중심 전압 이동은 단 **`0.03 %`**에 불과함.
    * 이는 Banba current-mode BGR의 피드백이 저항의 절대값이 아니라 **저항 비율($R_2/R_1$, $R_2/R_6$)에 의해서만 결정**되는 고도의 대칭성 회로 구조이기 때문이며, 저항 절대값 제조 산포 오차가 자율 상쇄됨을 시뮬레이션을 통해 직접 확인 및 입증함.
  * **TC의 기생적 곡선 보상 (Cubic Curvature) 발견:**
    * 온도 계수가 이상 저항 적용 시 $17.8\,\text{ppm}/^\circ\text{C}$에서 실물 저항 교체 후 **`8.6 ppm/°C`** (tt 코너 기준)로 대폭 개선됨.
    * 원인 분석 결과, `res_high_po`의 2차 온도계수 `tc2 = +1.22 ppm/°C²`의 양의 곡률 성분이 BJT $V_{BE}$의 $T \ln(T)$ 음의 비선형 곡률을 상쇄시킴으로써, 3차 S자 형태의 평탄화된 Curvature가 형성된 것으로 판단됨.
  * **N 스윕 결과 최적점 확정:**
    * $N$ 스윕에 따른 온도 안정도: N=39(33.1) / N=40(8.6) / N=41(31.2) / N=42(62.1) / N=43(92.5) ppm/°C
    * 이를 통해 최적 온도 계수 지점으로 **`N = 40`** ($R_6, R_7 = 118.0\,\text{k}\Omega$)을 최종 낙점함.
  * **비대칭 코너 스프레드 식별:**
    * ss 코너($1.2086\text{V}$)와 tt 코너($1.2076\text{V}$)는 매우 조밀하게 정렬되었으나, ff 코너는 **`1.2576 V`**로 약 **`+50 mV (+4.1%)`** 튀는 비대칭 스프레드가 관측됨.
    * ff 코너의 경우 저항 바디의 감소와 BJT의 활성화로 인해 전류가 과하게 흘러 PTAT/CTAT 균형점이 일시 이탈하여 Curvature와 전압이 튀게 됨.
    * 이 현상은 레이아웃을 수정하여 잡을 수 없으므로, **3-bit 디지털 트림을 통해 ff 코너의 출력을 밑으로 끌어내리는 보정 사양**으로 극복해야 함을 최종 확인 및 도출함.
- **향후 계획:** 다음 단계인 출력 저항 트림 사양 상세 및 LDO 오차 증폭기 설계의 선행 과제로써, 라인 레귤레이션 스펙 검증 및 보완(Step 2.8)을 진행함.

## [2026-07-14] Milestone 08: NMOS Cascode 등화쌍 차폐 및 Line Regulation 개선 완료
- **상황:** 실물 저항 교체 후 BGR 코어의 Line Regulation 스펙 미달 문제를 발견하고, 등화쌍의 드레인 전압 비대칭성을 해결하기 위해 NMOS cascode 차폐 및 GND 기준 바이어스 회로를 도입하여 사양을 충족함.
- **물리적 원인 진단 및 해결 과정:**
  * **Line Regulation 오동작 식별 및 교훈:**
    * 실물 저항 교체 상태에서 Line Reg 실측치 `0.6405 %/V` (VAPWR 2.7~3.6V 구간에서 $V_{ref}$가 $8.1\,\text{mV}$ 변동)로 스펙 규격($<0.5\,\%/V$)을 미달함.
    * "후단 LDO가 리플을 커버한다"는 초기 오판을 수정함. LDO의 PSRR은 VAPWR의 동적 노이즈가 LDO 출력으로 유입되는 경로를 감쇄시킬 뿐, DC 기준 전압 자체($V_{ref}$)가 변동하면 LDO가 이를 그대로 비례 증폭하여 출력에 전사하므로 **"레퍼런스의 오염은 레퍼런스 단에서 근본적으로 억제해야 한다"**는 주요 교훈을 실증함.
  * **원인 규명 (등화쌍 드레인 비대칭):**
    * VAPWR 스위프 동안 `XM3` 드레인은 `V_mid1` ($1.96\text{V}$, 변동폭 $1.3\text{mV}$ 이내)로 고정되는 반면, `XM4` 드레인은 `V_gate_top`으로 VAPWR 전압을 1:1 추종함.
    * 이로 인해 두 소자의 $V_{DS}$ 차이가 VAPWR의 함수로 변하며, 채널 길이 변조 효과를 통해 등화 오차가 VAPWR 변동에 비례하여 발생($\pm 725\,\mu\text{V}$ 변동)하고 결과적으로 PTAT 전류 및 $V_{ref}$를 교란함을 파악함.
  * **시행착오 기록:**
    * **1차 시도 (실패):** `XM3/XM4` L을 $2\mu\text{m} \rightarrow 8\mu\text{m}$로 4배 키워 출력 저항 $r_o$를 높였으나, 등화 오차가 $590\,\mu\text{V}$로 단 **19%만 개선**되어 채널 람다($\lambda$) 변조보다 $V_{DS}$ 비대칭 구조 자체가 지배적 원인임을 규명함 (L=2 롤백).
    * **2차 시도 (실패):** `XM_bias_mir` L을 $2\mu\text{m} \rightarrow 4\mu\text{m}$로 늘려 바이어스 전류를 절반으로 감축시켰으나, Line Reg가 `1.75 %/V`로 극도로 악화됨. 바이어스 전류 감소로 인해 `V_bias` 전위가 비정상적으로 상승해 상단 PMOS의 마진을 파괴했기 때문임. (바이어스 분기 오차는 무해하나 전류 크기는 변경 불가함을 확인).
  * **최종 해법 (NMOS Cascode + GND 기준 바이어스 분기):**
    * 등화쌍 위에 NMOS Cascode 스택(`XM3c/XM4c`, W10/L2 m2)을 얹어 드레인을 완벽하게 차폐함.
    * cascode 게이트를 GND 기준으로 생성된 고정 전위 `V_casc_n`에 묶음으로써, 등화쌍의 드레인을 `V_casc_n - V_GS` 수준으로 단단히 묶어 VAPWR 의존성을 원천 소거함.
    * **신규 GND 기준 바이어스 브랜치:** `XM_cn_mir` (pfet, G=`V_gate_top`, m=1) $\rightarrow$ NMOS diode 2단스택 $\rightarrow$ `R_cn` (res_high_po_0p69, L=91.5µm) $\rightarrow$ GND 결선. VAPWR 900mV 스윕 동안 `V_casc_n` 변동폭이 단 **`+27.8 mV`** (3%)에 불과하여 설계 의도인 GND 레퍼런스 차폐 성능을 완벽히 증명함.
    * **미러 사이징 주의사항:** `XM_cn_mir`를 m=4로 두었을 때 미러 전류가 너무 커서 `V_casc_n`이 3.19V로 치솟고 VAPWR을 추종하던 버그를 m=1로 교정하여 **`2.48 V`**로 정상화함.
    * **결선 주의:** cascode 삽입 시 `XM3` 게이트를 cascode 아래(소스)가 아닌 cascode 위(`V_mid1`)에 결선해야 $VBE1$ 전위가 붕괴되는 현상을 방지할 수 있음을 실측하여 정정함.
- **N 재최적화 및 최종 결과:**
  * 등화쌍 대칭성 확보로 기생 오차가 제거되자 최적의 PTAT/CTAT 균형점이 미세 이동하여 $N$을 스윕함: N=38(90.4)/39(58.2)/40(27.8)/41(6.0)/42(35.2) ppm.
  * 최적점인 **`N = 41`** ($R_6, R_7 = 244.537\,\mu\text{m} = 120.95\,\text{k}\Omega$)을 확정하여 tt 코너 온도 안정도를 **`6.1 ppm/°C`**로 추가 개선함.
  * 최종 Line Reg는 **`0.1412 %/V`** (기존 대비 **4.5배 개선**)로 향상되어 목표 스펙을 여유롭게 달성함.
- **향후 계획:** 트림 설계를 위한 몬테카를로(MC) 시뮬레이션 진단 및 소자 면적 스케일링(Step 2.8)을 수행함.

## [2026-07-14] Milestone 09: 몬테카를로 오프셋 진단 및 소자 면적 4배 스케일링 완료
- **상황:** 몬테카를로 시뮬레이션 결과 기준 전압($V_{ref}$)의 3-sigma 산포가 $\pm 12\%$ ($\sigma = 4.0\%$)로 지나치게 넓은 상태를 식별함. 원인을 진단한 결과 로컬 미스매치(MM)가 지배적임을 밝혀내고, 핵심 능동 소자의 면적을 4배 스케일업하여 산포를 억제함.
- **오프셋 및 미스매치 원인 진단 과정:**
  * **TC 보정 불가능 문제 인식:**
    * 디지털 가변 저항 트림($R_2$)은 $V_{ref} = (R_2/R_6) \cdot V_{BE} + (R_2/R_1) \cdot \Delta V_{BE}$ 수식과 같이 PTAT와 CTAT의 두 항을 동시에 스케일링하는 "순수 게인 손잡이" 역할만 수행함.
    * 따라서 트림으로는 공정 편차에 따른 $V_{ref}$의 절대값(상온값)은 복원할 수 있으나, 미스매치에 의해 PTAT/CTAT 균형 자체가 흔들려 오염되는 온도 계수(TC, ppm) 성능은 보정할 수 없음. 즉, BGR 코어 자체의 미스매치 표준편차($\sigma$)를 물리적으로 축소하는 물리 설계가 선행되어야 함을 증명함.
  * **미스매치(MM) vs 공정 변이(PR) 분해 진단 (각 20 샘플):**
    * **로컬 미스매치 (MM, `MC_MM_SWITCH=1`):** $\sigma = \mathbf{4.58\%}$ (분산 기여율 **`91.5%`**)
    * **글로벌 공정 산포 (PR, `MC_PR_SWITCH=1`):** $\sigma = \mathbf{1.38\%}$ (분산 기여율 **`8.5%`**)
    * **합산 (RSS):** $4.78\%$ (실측 토탈 200 샘플 오프셋 $\sigma = 4.00\%$와 통계적 일치 확인).
    * **결론:** 로컬 미스매치가 글로벌 공정 산포 대비 분산 기준 11배 이상 지배적임을 확인하였으며, 이는 소자의 면적 조절을 통해 극적으로 해결 가능한 "면적 스케일링 문제"임을 판단함.
    * **공정 변이(PR)의 독립성 교훈:** 글로벌 공정 산포에 의한 영향이 $1.38\%$로 매우 작다는 사실은 Banba의 "전원 배제 저항 비율" 구조가 전체 공정 시프트를 효과적으로 억제하고 있음을 나타내며, 실물 저항 교체 시의 절대값 오차 무해성 원리가 몬테카를로 해석에서도 재입증됨.
  * **처방 및 지배 소자 면적 4배 스케일링:**
    * **스케일링 대상 및 근거:**
      * **`XM_top1/2/5` (상단 전류 미러):** $V_{th}$ 미스매치가 코어 브랜치 전류 복사비에 직접 오차를 유입시킴 $\rightarrow$ $W=10\mu\text{m} / L=2\mu\text{m} \rightarrow \mathbf{W=20\mu\text{m} / L=4\mu\text{m}}$ ($mult=4$ 유지).
      * **`XM3/XM4` (하단 등화쌍):** 소자의 입력 오프셋 전압이 밴드갭의 근간인 $\Delta V_{BE} \approx 54\,\text{mV}$에 직접 가산되므로 PTAT 전류를 가장 극심하게 교란함 $\rightarrow$ $W=10\mu\text{m} / L=2\mu\text{m} \rightarrow \mathbf{W=20\mu\text{m} / L=4\mu\text{m}}$ ($mult=2$ 유지).
      * **비대상 소자군:** cascode 차폐 소자들(`XM_bot*`, `XM3c/4c`) 및 bias 체인(`XM_bias*`, `XM_cn*`)은 전류 매칭 민감도가 극도로 낮으므로 면적 오버헤드를 막기 위해 스케일링 대상에서 제외함. PNP BJT 또한 매칭 개선 효율(면적 대비 $\sqrt{m}$)이 낮아 배제함.
    * **핵심 트릭 (W와 L의 동시 배수 확대):**
      * Pelgrom 법칙($\sigma_{Vth} \propto \frac{1}{\sqrt{WL}}$)에 의거하여 면적($W \cdot L$)을 4배로 키우면 미스매치 변동폭이 절반($1/2$)으로 감소함.
      * 이때 $W$와 $L$을 동일하게 2배씩 늘려 **$W/L$ 비를 불변으로 유지**하였기 때문에, 소자의 $V_{ov}$, 바이어스 전류 및 전체 정상 상태 동작점은 완벽히 유지되어 추가적인 코어 회로 재튜닝 비용이 전혀 발생하지 않음.
- **스케일링 후 동작점 및 성능 검증 (Before vs After 정량 비교):**
  * **정량 비교 결과:**
    * 몬테카를로 표준편차 ($\sigma$): 스케일링 전 `3.83 %` $\rightarrow$ 후 **`2.21 %`** (**1.73배 개선**, 3-sigma 산포 범위 `±11.5%`에서 **`±6.6%`**로 축소)
    * Typical 코너 TC (tt): `6.1 ppm` $\rightarrow$ **`7.5 ppm`** (미미한 대역 손실)
    * Slow 코너 TC (ss): `11.4 ppm` $\rightarrow$ **`8.6 ppm`** (추가 개선)
    * Fast 코너 TC (ff): `48.7 ppm` $\rightarrow$ **`9.0 ppm`** (**5.4배 개선**, 코너 편차 소멸)
    * Line Regulation: `0.1413 %/V` $\rightarrow$ **`0.0840 %/V`** (**1.7배 개선**)
    * 등화 오차 VAPWR 의존성: $-51.0\,\mu\text{V}$ $\rightarrow$ **$-32.6 \mu\text{V}$** (**1.6배 개선**)
    * 소모 전류 ($I_Q$): `56.4 µA` $\rightarrow$ **`59.7 µA`** ($+3.3\,\mu\text{A}$ 추가 소모)
  * **물리적 성과 해석:**
    1. **무작위 미스매치 감축:** MM/PR 분해에서 MM이 전체 분산의 91.5%를 지배함을 식별하여 면적 4배 증가 시 토탈 $\sigma$가 약 절반에 가깝게 줄어들 것으로 예측하였고, 실제 `3.83% ➔ 2.21%`로 개선됨을 확인해 통계적 유효성을 직접 검증함.
    2. **체계적 채널 길이 변조 효과 극복:** 채널 길이 $L$이 2배로 확장되면서 소자의 출력 저항 $r_o$가 2배로 향상됨. 특히 빠른 코너 특성으로 인해 $\lambda$ 변조에 의한 전류 거울 부정합이 극대화되었던 ff 코너의 온도 안정도가 `48.7 ppm/°C ➔ 9.0 ppm/°C`로 비약적으로 향상되었고, 전 코너 TC가 **`7.5 ~ 9.0 ppm/°C`** 대역으로 균일화되어 코너 간의 성능 격차를 완전히 소멸시킴.
- **트림(Trim) 설계 규격 최종 확정:**
  * **범위 및 해상도 사양:** 실측된 3-sigma 산포가 $\pm 6.6\%$이므로 이를 완벽하게 수렴하기 위해 최소 **`±7.0 %`**의 트림 범위를 설정함. 온도 안정도가 8 ppm/°C 내외인 초정밀 코어 설계에 격을 맞추기 위해 LSB 트림 해상도 또한 **`0.4% ~ 0.5%`** 대역으로 목표함.
  * **5-bit 디지털 트림 (`ui_in[4:0]`) 채택:** 32 스텝 구성으로 LSB 스텝 크기 **`0.44%`**, 전체 가변 범위 **`±7.0%`**를 확보함. (4-bit 기각 사유: LSB 스텝 크기 0.9% 적용 시 잔여 튜닝 오차가 최대 $\pm 0.45\%$에 달하여 8 ppm TC 설계 해상도와 불균형을 이룸).
  * **바이어스 중심점 및 고정 저항 재정합:** 실측 몬테카를로 중심치 `MC Mean = 1.19197V`가 목표 전압인 `1.200V`에 오도록 고정 저항 $R_2$의 baseline을 미세 보정하여, 중앙 코드인 `10000` (binary 16)에서 정확히 $1.20\text{V}$가 나오도록 정렬함 (기존 $R_2 = 41$ 유닛 $\rightarrow$ 약 **`41.3 유닛`** 등가 길이 보정).
- **향후 계획:** BGR 코어 및 트림 바이어스 사양 조율이 완료되었으므로, 다음 마일스톤인 LDO 오차 증폭기(EA) 및 패스 소자 사이징 등의 상세 설계를 본격적으로 착수함.

## [2026-07-18] gm/Id LUT 검증 앵커 확정 및 설계 이력 정정
- **상황:** gm/Id LUT 기반 사이징 설계를 착수하기에 앞서, LUT의 정확성을 보증할 수 있는 단독 소자 기준 검증 앵커를 실측하여 확정함. 아울러 기존 분석 데이터 중 근거 추적이 불가능하거나 계통 오차가 존재했던 부분을 정정하여 설계 이력의 무결성을 확보함.
- **폐기된 값과 정정 경위:**
  * **폐기:** 기존에 인용되던 "nfet_g5v0d10v5 Vth(VSB=0, tt) ≈ 0.647V" 값은 근거 추적이 불가능하고 ngspice 직접 출력이 아닌 미검증 수치로 판명되어 앵커로서 폐기함.
    - **실측 대체:** Vth(VSB=0) = 0.80193 V (조건: L=2µm, W=4µm, VGS=0.92V, VDS=1.0V, VSB=0.0V, tt/27°C). Vth는 바이어스 의존값이므로 7종 바이어스 조건과 함께 기록을 정정함.
  * **판명된 오염:**
    - 스타트업 회로 설계 단계에서 진행했던 구 `M_pd` 미니스윕의 절대 전류값(예: 12.97µA @VGS=0.92V)이 앵커 재실측 결과 동일 조건 실제값인 2.10µA 대비 약 6배 높게 측정된 계통 오차(testbench의 W 또는 m 설정 착오, 혹은 전류 경로에 타 소자 포함)가 존재했음을 발견함.
    - 두 측정점(0.208µA@0.777V, 12.97µA@0.92V)이 동일 비율로 이탈한 계통 오차였으므로 두 점의 비율(62배) 자체는 정확하여 subthreshold 기울기 및 기동 논증 자체는 유효함.
    - 또한 `M_pd` 최종 사이징(W 4 ➜ 12)은 이 미니스윕이 아니라 ss/-40°C 회로 과도 해석 실패 분석 및 계단 고문 실측(잔류 전류 33fA/0.026fA)에 의해 결정되었으므로 BGR 코어 및 스타트업 설계의 타당성과 최종 결론에는 아무런 영향이 없음을 확인함.
- **확정 앵커 세트:**
  * A1 (nfet): L=2µm, W=4µm, VGS=0.92V, VDS=1.0V, VSB=0.0V (vth=0.80193V, id=2.1011µA, gm=25.067µS, gds=48.953nS, vdsat=0.12209V)
  * A2 (nfet VSB=0.78): 동일 소자, VSB=0.78V (vth=1.07310V, id=16.035nA) ➜ 바디이펙트 검증용.
  * A3 (pfet): L=2µm, W=10µm, VSG=1.176V, VSD=1.0V, VSB=0.0V (vth=1.02434V, id=3.0009µA, gm=30.312µS, gds=172.18nS, vdsat=0.15956V)
- **chennakeshavadasa 리포 복권:**
  * 지난 추정("리포 W=2 가정 오류로 4.3배 불일치")을 철회함. 재조사 결과 리포의 vth(L=2)=0.774V는 고VDS DIBL 반영값으로 당사 실측 0.802V(VDS=1.0V)와 정합하며, 전류 차이 역시 이 28mV vth 차이로 설명됨. 4.3배 불일치는 당사 구 미니스윕의 6배 계통 오염이 진짜 원인이었음.
- **향후 계획:** 확정된 앵커를 검증에 활용하여 LUT 생성을 완료하고, LDO 설계를 착수함.

## [2026-07] EA 바이어스 탭(IB_EA) 신설
- **배경:** LDO EA 바이어스 마스터를 BGR 메인 미러의 1/4 브랜치 복사($2.5632\,\mu\text{A}$)로 확정함 (LDO 채팅 판정). 기각 대안: $V_{ref} \rightarrow \text{V-to-I}$ 서보 회로, 별도 constant-$g_m$ 셀 (둘 다 새 루프·기동·오프셋 검증 부담 추가됨). 미러 재사용은 단 소자 2개 추가로 완결됨.
- **선례:** BGR 넷리스트가 이미 동일 패턴 2회 사용 — `XXM_bias_mir` ($\rightarrow V_{bias\_n}$), `XXM_cn_mir` ($\rightarrow V_{casc\_n}$). 이번이 세 번째 복사 분기 적용임.
- **캐스코드 2가지 적용 사유:** (i) 수신단이 NMOS 다이오드($\approx 0.9 \sim 1.0\,\text{V}$)라 $V_{DS}$가 메인과 다르므로 $V_{DS}$ 정합으로 복사 오차 억제 (ii) $V_{gate\_top}$ 루프 노드를 출력 스위칭 노이즈로부터 차폐.
- **소자를 셀 내부에 두고 전류 핀만 내보낸 이유:** $V_{gate\_top}$은 BGR 피드백 루프의 핵심 노드라 핀으로 빼 칩을 가로지르면 RO(100 MHz급)·부하 스위칭이 결합해 전 미러 전류를 변조함 ($V_{ref}$ 리플 유발). 전류 핀 `IB_EA`는 수신단 임피던스가 $1/g_m$ (수 $\text{k}\Omega$)이라 노이즈 결합에 둔감함.
- **결과:** $I_{B,EA} = 2.564228\,\mu\text{A}$ ($+0.04\%$), compliance $0 \sim 3.00\,\text{V}$, $R_{out} \approx 820\,\text{M}\Omega$, $\text{TC} = -524\,\text{ppm}/^\circ\text{C}$, $\sigma = 2.63\%$. 코어 무섭동 (`XM_top1` @m[id] $1.025294\times 10^{-5}\,\text{A}$ 6자리 동일).

## [2026-07] 벌크 결선 오류 4건 정정
- **발견 경위:** 플랫 TB ➔ 계층 심볼 분리 작업 중 넷리스트 4번째 단자 점검 과정에서 발견. 등화쌍 cascode 수술 당시 $V_{casc\_n}$ bias 분기를 추가하며 유입된 것으로 추정됨.
- **내용:**
  * `XXM_cn_d1`, `XXM_cn_d2`: 벌크가 `net9` (자기 소스)로 부유 ➔ `VGND`로 수정. (nfet 벌크는 p-기판이므로 dnwell 없이 부유 웰은 물리적으로 불가능)
  * `XXM4`, `XXM4c`: 벌크가 글로벌 `0` ➔ `VGND` 포트로 수정 (LVS 미스매치 방지).
- **회로 영향:** $V_{casc\_n} = 2.4829 \rightarrow 2.6086\,\text{V}$ ($+126\,\text{mV}$, 바디 효과 정상 반영), $V_{mid1} = 1.9628 \rightarrow 1.9687\,\text{V}$, line reg $= 0.0840 \rightarrow 0.0834\,\%/\text{V}$.
- **★ 영향 없음이 확인된 항목과 그 이유:**
  * $V_{min}$ (tt $2.190$ / ss$-40$ $2.380$ / ff$125$ $2.050\,\text{V}$) 세 코너 $\pm 0\,\text{mV}$, $V_{alive}$ 전 램프율 $\pm 1\,\text{mV}$ 이내, $I_{B,EA}$ 3 pA, $V_{ref}$ 1 µV, TC $7.5\,\text{ppm}/^\circ\text{C}$ 동일.
  * 이유: VAPWR 하한을 정하는 임계 스택은 `VAPWR` ➔ PMOS cascode ➔ `V_mid1` 이고 `V_mid1` 은 `XM3` 의 $V_{GS}$가 전류로 고정하므로 $+6\,\text{mV}$만 이동함. $V_{casc\_n}$은 GND 기준 diode+저항 스택이라 VAPWR과 함께 오르내리며 고정 문턱을 만들지 않음 — 등화쌍 cascode 수술로 line reg를 잡은 것과 동일한 성질이 기동 특성에서도 작동함.
- **교훈:** 넷리스트 검수 시 D/G/S 뿐만 아니라 4번째 단자(벌크)를 반드시 확인한다.

## [2026-07] 계층 심볼화 (bgr_core)
- **작업:** `bgr_core_tb.sch` (플랫)에서 코어를 `bgr_core.sch`로 분리하고 심볼 생성.
- **핀 4개:** `.subckt bgr_core VAPWR VREF_LOW IB_EA VGND`
  * `*.iopin VAPWR`, `*.opin VREF_LOW`, `*.opin IB_EA`, `*.iopin VGND`
- **LVS 대비:** 서브회로 내부의 글로벌 `0` 참조를 전부 `VGND` 포트로 교체.
- **등가성 검증 (동일 op, 플랫 vs 계층):**
  * $v(vref\_low)$: `1.186591` = `1.186591`
  * $v(v\_casc\_n)$: `2.608633` = `2.608633`
  * $v(v\_mid1)$: `1.968699` = `1.968699`
  * `XM_top1` id: `1.025294e-05` = `1.025294e-05`
  * `tap` id: `2.564175` vs `2.564245 µA` (70 pA, 부하 방식 차이)
  * $-i(vsource)$: `62.27277` vs `62.27285 µA`
- **이원화 유지:** 플랫 TB(`bgr_core_tb.sch`)는 BGR 내부 검증 스크립트(`mc_loop_tap.py`, staircase, ramp) 재사용용, 계층 TB(`bgr_core_tb2.sch`)는 심볼/통합 검증용으로 병행 유지. 회로 변경 시 양쪽 스키매틱 모두 반영 필요.

## [2026-07] E6 리스크 관련 BGR 측 입력 데이터 산출
- **분석:** $V_{alive} / t_{alive}$ 표 (7점) 및 경계 램프율 ss/$-40 \approx 90\,\text{mV}/\mu\text{s}$, tt $\approx 117\,\text{mV}/\mu\text{s}$ 산출 완료.
- **★ 판정:** 게이트 노출은 최악 코너 전용이 아니라 전 코너 현상 (tt @$330\,\text{mV}/\mu\text{s}$에서도 $333\,\text{mV}$ 노출). 최악 노출 창 $1.47\,\mu\text{s}$ (ss/$-40$ @$330\,\text{mV}/\mu\text{s}$).
- **검출 주의사항:** TB의 이상 전압원 부하($0.95\,\text{V}$)가 램프 초기에 tap PMOS의 드레인-웰 접합을 순바이어스시켜 $t=0$에 $3.18\,\mu\text{A}$가 잡힘. "앞에서부터 90% 도달점"을 찾으면 index 0($VAPWR=0$)이 반환되므로 뒤에서부터 탐색해야 함. 실제 EA 수신단은 접지 기준 다이오드라 이 현상은 TB 전용임.

## [2026-07] 저항 모델 장부 오류 정정 (무검증 수치 3호)
- **경위:** LDO 단독 실측 3점 피팅(잔차 $0.00\,\Omega$, $470.976\,\Omega/\mu\text{m}$, $262.85\,\Omega/\text{head}$) + BGR in-circuit 결선 검증 $V_{ref} / I_{branch} = 1.186591 / 10.25294\,\mu\text{A} = 115,732\,\Omega$ (신모델 $115,697\,\Omega$ 대비 오차 $-0.03\%$, 구모델 $120,948\,\Omega$ 대비 $-4.3\%$)을 통해 저항 모델 장부 수치를 정정함.
- **구값 출처:** 과거 인용되던 구 장부값($2.95\,\text{k}\Omega/\text{unit}$)은 소급 불가능한 미검증 수치로 확인됨.
- **영향 범위:** 스키매틱 및 넷리스트는 100% 동일하며, 문서의 장부값만 교체됨 (전기적 결과 및 시뮬레이션 결과에 미치는 영향 Zero).
- **$V_{ref}$ 인과 가설 기각:** 구 저항 모델에 따른 전압 변화 가설은 변동 방향이 반대임이 확인되어 기각됨.
- **교훈:** "문서 수치는 in-circuit 나눗셈(V/I)으로도 검증 가능했다 — 이후 저항 관련 수치는 반드시 실측 병기".

## [2026-07] 레이아웃 양자화 이탈 분석 및 신규 open 사항 기록 (D12)
- **현상:** 스키매틱 저항 치수($L=6.425\,\mu\text{m} / 44.405\,\mu\text{m}$)가 유닛 정수배 비정수 수치임에 따라, 레이아웃 상 정수 유닛 체인 형성 시 저항비가 $-1.12\%$ 편차 발생.
- **대처 방안:** TC 영향 재검증 필요. 3가지 선택안(A: 스키매틱 유지 및 레이아웃 커스텀 / B: 정수 유닛 정렬 / C: 트림 튜닝 연동)을 비교한 뒤 트림 태스크에서 판정할 것. 현 스키매틱은 동결 유지함.

## [2026-07] D-016 트림 스위치 재사이징 (LDO 교차실측)
- **발견 경위:** LDO가 부하 싱크(`m=4`, geometry 명시)에서 LUT 대비 $R_{on}$ +16.7% 차이를 발견하여 통보함. BGR 측에서 D-016 트림 스위치 동일 소자(`nfet_01v8` W=10 L=0.15)로 geometry 생략/명시 직접 대조 실측을 진행함.
- **원인 분석:** `m=18` geometry 생략 실측치($4.851\,\Omega$)가 기존 LUT 산출값($4.85\,\Omega$)을 정확히 재현함에 따라, 차이가 순수 geometry($nrd/nrs$ 직렬 확산저항) 기여임을 증명함.
- **재사이징:** `m=18` $\rightarrow$ `m=22`로 확대 확정. geometry 명시 기준 $R_{on} = 4.573\,\Omega$ (tt/27, 최악), $6.194\,\Omega$ (ss/125, 최악)로 목표선($\le 5\,\Omega$) 충족.
- **TC 기여 개선:** TC 배수 $1.354\times$로 하락하여 TC 기여 $0.572\,\text{ppm}/^\circ\text{C}$ (BGR TC 7.5의 7.6%, 기존 $0.83\,\text{ppm}/^\circ\text{C}$ 대비 개선). 직렬 확산저항의 TC가 채널보다 완만하여 온도 안정성에 호재로 작용.
- **교훈:** "포화영역 회로검증(BGR 3소자)이 triode 스위치를 담보하지 않는다 — 동작영역별 검증 필요". `lut/README.md` §10.1 triode $R_{on}$ geometry 명시 `.op` 최종 확정 규율 신설로 연결됨.

## [2026-07] 폴리 저항 헤드 TC 발견 및 저항 구조 확정
- **발단:** 레이아웃 LVS 위해 저항을 유닛 직렬로 재작성하려다, 통짜 근사와 유닛 직렬의 TC 순위가 뒤집히는 것을 발견
- **오류 이력 2건 (rule 5 위반, 둘 다 측정 없는 단언):**
  1. "헤드 TC = 몸통 TC 이므로 상쇄" — parameters_res_high.spice 의 배수 구조만 보고 추론. TC 항 미확인.
  2. "비를 이루는 저항은 모두 같은 비율로 분할" — 비중의 '비율' 만 보고 절대 기여를 놓침. 실제로는 작은 저항이 6.9배 민감.
  → 단독 저항 6점 실측으로 판정. 2성분 모델 확립.
- **방향 오류:** 레이아웃이 유닛 셀 어레이로 그린다는 가정 하에 유닛 직렬 TC 를 수 라운드 최적화했으나, 서펜타인으로 그리면 헤드는 2개로 유지된다(넷리스트 소자 1개 = 헤드 2개). 해당 탐색 결과(7.0~14.8 ppm)는 전부 폐기.
- **확정:** R6/R7 2분할(공통중심), R1·R2fix 통짜, TC 7.9 ppm
- **교훈:** 레이아웃 구조가 전기 특성을 바꾸는 경우, 실제 구조와 동일한 넷리스트로 시뮬해야 한다. 그리고 어떤 구조로 그릴지를 먼저 확정해야 최적화가 의미를 갖는다.

## [2026-08] 1차 PEX 결과 (R+C extraction, magic 8.3.678)
* **상세 보고서 문서**: [bgr_core_pex1_report.md](file:///c:/Users/aa/Desktop/school/TinyTapeout/designs/bgr_ldo/layout/bgr_core/docs/bgr_core_pex1_report.md)
- **추출 조건:** `bgr_mos_pex_rc_safe.spice` (R+C, flatten, no coupling, magic 8.3.678 기준)

- **시뮬레이션 조건:** tt/27, 트림 중앙코드 `0111`
- **핵심 성능 실측치:**
  * $V_{ref}$: **`1.204760 V`** (schematic `1.205412 V` 대비 $-0.652 \text{ mV}$)
  * 온도 계수 (TC): **`10.9 ppm/°C`**
  * 바이어스 전류 ($IB_{EA}$): **`2.560077 µA`**
  * 소모 전류 ($I_Q$): **`62.054 µA`**
- **트림 및 DNL 성능:**
  * 16개 트림 코드 단조성(Monotonicity) 유지 확인 (중앙 코드 출력 $1.79882 \text{ V}$, LSB $= 17.353 \text{ mV}$)
  * DNL 측정치: tt/27 **`0.0909`** / ss/125 **`0.0828`** / ff/-40 **`0.1152`** (기준 $<0.15$ 전 코너 통과)
- **시동(Startup) 특성:** tt/27 및 ss/-40 최악 코너 정상 시동 및 정상 상태 탈출 확인.
- **$V_{ref}$ 변동 분석 ($V_{ref}$가 예상 $-14 \text{ mV}$ 대비 안 움직인 이유):**
  * 폴리 컨택 기생 저항 $+1,115\,\Omega$ 이 시트 저항 편차 $-1.22\%$를 상쇄함.
  * 컨택 기생 성분이 TC에 $+2.6 \text{ ppm/°C}$ 기여함.
- **향후 계획:** PSRR 및 노이즈(Noise) 특성은 2차 PEX (`do coupling` 모드)에서 최종 확정 예정.

## [2026-08] BGR 레이아웃 완료 — 헤드 TC 발견부터 PEX 검증까지
- **발단:** LVS를 위해 저항을 유닛 직렬로 재작성하려다 통짜 근사와 유닛 직렬의 TC 순위가 뒤집히는 현상을 발견함.
- **오류 이력 3건 (전부 rule 5 위반 — 실측 없는 단언 사고):**
  1. *"헤드 TC = 몸통 TC이므로 상쇄됨"* — `parameters_res_high.spice` 배수 구조만 보고 추론, TC 항 미확인 ➔ 6점 실측으로 반증 (321.3 ~ 543.4 ppm/°C 변동).
  2. *"비를 이루는 저항은 모두 같은 비율로 분할"* — 비중의 '비율'만 보고 절대 기여를 놓침. 실제로는 작은 저항($R_1$)이 6.9배 더 민감함.
  3. *방향 오류* — 레이아웃을 유닛 셀 어레이로 그린다는 가정 하에 유닛 직렬 TC를 수 라운드 최적화했으나, 서펜타인으로 그리면 헤드는 2개로 유지됨 (넷리스트 소자 1개 = 헤드 2개). 해당 유닛 직렬 탐색 결과는 전량 폐기.
- **확정 결과:** $R_6/R_7$ 2분할(공통 중심), $R_1 \cdot R_{2fix}$ 통짜, $R_1\ L = 34.29\,\mu\text{m}$, $\mathbf{\text{TC} = 6.70\,\text{ppm}/^\circ\text{C}}$ (post-layout PEX R+C 최종 확정).
- **핵심 교훈:**
  1. *"레이아웃 구조가 전기 특성을 바꾸는 경우, 실제 구조와 동일한 넷리스트로 시뮬레이션해야 한다. 어떤 구조로 그릴지를 먼저 확정해야 최적화가 의미를 갖는다."*
  2. *"단일 대편차점 감도로 최적점 근방을 외삽하면 틀린다 (감도 0.363 ➔ 예측 6.8 vs 실측 7.9). 코너 증분 0.1927이 N마다 부호까지 바뀐 것도 같은 유형."*
  3. *"PEX 넷리스트를 직접 스윕하면 모델 오차 없이 레이아웃 재작업을 1회로 줄인다."*
