wecallemjazzyfact/TinyTapeout-BGR-LDO/(commit log)

2026-07-11 Initial commit: Banba BGR Core testbench and milestone 01 verified
    [bgr.sch, bgr_core_tb.sch, delta_vbe.sch, pnp_vbe.sch]
2026-07-11 Optimize BGR core resistor to 122k in LOGBOOK
    [bgr_core_tb.sch]
2026-07-13 doc: complete Milestone 06 startup circuit verification
    [bgr_core_tb.sch, w1_tt_stair.csv, w2_ss40_stair.csv, w3_tt_ramp5u.csv, w4_tc_tt.csv, w5_tc_ss.csv, w6_tc_ff.csv]
2026-07-14 docs: BGR Core final specs & design journey (v1-v6) completion
    [bgr_core_tb.sch, f_lr.csv, f_tc_ff.csv, f_tc_ss.csv, f_tc_tt.csv, nc38.csv, nc39.csv, nc40.csv]
2026-07-17 refactor: restructure directories to separate BGR/LDO and set up project-wide LUT infrastructure
    [a_lr.csv, a_tc_ff.csv, a_tc_ss.csv, a_tc_tt.csv, after_lr.csv, after_tc_ff.csv, after_tc_ss.csv, after_tc_tt.csv]
2026-07-18 lut: 4D gm/Id LUT 검증 완료 (A1b/A2b/A3 격자앵커 + BGR 실회로 앵커 전 게이트 PASS)
    [sample_config_nfet.cfg, sample_config_pfet.cfg]
2026-07-18 docs: LDO 사양 확정 및 EA 극성 재판정(PMOS 입력), BGR 트림 사양 수정
2026-07-19 docs(open-items): D10 OPEN, E6 OPEN — BGR 탭 브랜치 실측 및 pass 게이트 부유 항목 표 정합화
2026-07-19 feat: add IB_EA bias tap for LDO EA (2.564 uA, core unperturbed)
    [bgr_core_tb.sch, bnd_r165.csv, bnd_r33.csv, bnd_r66.csv, ramp_fast_ss40.csv, ramp_slow_ss40.csv, stair24_ss40_24.csv, stair24_tt24.csv]
2026-07-20 feat: setup TinyTapeout ttsky26c shuttle submission template + IB_EA bias tap documentation and milestone 10
    [bgr_core.sch, bgr_core_tb.sch, bgr_core_tb2.sch, h_lr.csv, h_tc.csv, h_tc_ff.csv, h_tc_ss.csv, r2_s16.csv]
2026-07-21 docs(bookkeeping): §1.1 res/MiM 실측 23~31행 추가
2026-07-21 docs(bookkeeping): §1.2 이중주입 대조 32~36행 추가
2026-07-21 docs(bookkeeping): §1.4 정정 37~43행 추가 (비율계량 범위 축소 포함)
2026-07-21 docs(bookkeeping): §2.3 §2.4 실소자 실측으로 교체
2026-07-21 docs(journey): LDO부 신설 Ch.LDO-1~9
2026-07-21 docs(open-items): E3 CLOSED, A5 CLOSED, D11 부분 해소
2026-07-21 docs(open-items): E3 CLOSED, A5 CLOSED, D11 partial resolution — load slew constraint & MiM specs
2026-07-21 docs(spec): update 04_LDO_스펙 UGF beta correction, droop measurements, load slew constraint
2026-07-22 docs: res model correction (3rd unverified-value case) + corner matrix + Task6 interface freeze
    - res_high_po: 470.976 ohm/um, head 262.85, unit 2605.5 (3-way verified)
    - IB_EA 9-corner matrix (mirror err <0.08%, TC -524/-518/-432 ppm/C)
    - corner_factor structure: ff=Rhigh ss=Rlow (resistor tied to fet corner)
    - Task6 iface frozen: bgr_core 4-pin, clamp C-plan, Vout 1.780/1.800, IQ 139.10uA, VNB1 1.11196V verified against LDO
2026-07-23 feat(lut): thin-ox 01v8 gm/Id LUT 구축 (5D, W 이산축) + 트림 스위치 재사이징
    - lut/lookup.py v3: 4소자 지원. thin-ox는 W가 이산 5번째 축, 스케일 규칙 분기
    (thick-ox ×(W/10)×m, thin-ox ×m). LUTRangeError로 오용 방지.
    - thin-ox 5D 스윕(nfet_01v8/pfet_01v8, 486,180점) 생성 및 검증
    (앵커 78개 전부 통과, 최대오차 0.0050%). verify_gmid.py 회귀 EXIT=0 확인.
    - BGR 트림 스위치 R_on 사이징을 손계산(m=6)에서 thin-ox LUT 실측 기반
    (m=18, secant 기준)으로 재산출. TC 배수 실측(1.408x, 0.83ppm/°C) 확정.
    - C_byp(2pF, BGR-EA 신호결합 억제), power-good 급전 레일(VAPWR/thick-ox),
    RO L/C_load 전략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
2026-07-24 docs(open-items): E3 CLOSED, D21 CLOSED, E6 CLOSED — update load spec 4mA->2.10mA & slew driver docs
    - 04_LDO_스펙.md & 00_인계_통합.md: I_max 2.10mA, 46x ratio, 3.8mW, 30k gates
    - BOOKKEEPING.md: add row 55 (Ron secant/tangent breakdown), add slew driver components (R_snk, M_snk, R_slew, C_slew) & verification
    - OPEN_ITEMS.md: E3 CLOSED (slew driver), D21 CLOSED (thin-ox anchor), E6 CLOSED (fail-safe not needed)
    - D-016 trim switch resize m=18->22 & triode Ron geometry-explicit rule
2026-07-25 feat(trim): 4-bit reference trim (A6/E8 CLOSED, D22/E9 OPEN, BOOKKEEPING rows 56-61)
    - R2 split: fixed 108.6k + binary segs (1.1/2.2/4.5/9.0k), parallel-short
    - trim_sw: nfet_01v8 W10/L0.15 m22 x4 (D-016 sizing)
    - 16 codes monotonic, DNL 0.012, Vout 1.671-1.929V, center 1.800, +-8.6mV
    - IB_EA invariant, TC scale-invariant (35ppm), MC sigma 2.38% (unchanged)
    - port: bgr_core now 8-pin (VGND moved last), sym regenerated
    [bgr_core.sch, bgr_core_tb.sch, bgr_core_tb2.sch]
2026-08-12 chore: clean up repo for shuttle submission - retain minimal submission files only
    [a_lr.csv, a_tc_ff.csv, a_tc_ss.csv, a_tc_tt.csv, after_lr.csv, after_tc_ff.csv, after_tc_ss.csv, after_tc_tt.csv]
2026-08-14 fix: update top module name to tt_um_wecallemjazzyfact_bgr_ldo to resolve naming collision
    [bgr.sch, bgr_core.sch, bgr_core_tb.sch, bgr_core_tb2.sch, bgr_core_tb_onlyPCAS.sch, delta_vbe.sch, div16_core.sch, div16_tb.sch]
2026-08-29 feat: 6-bit trim expansion — layout, LVS, PEX, post-layout verification
    Trim 4-bit -> 6-bit (TRIM0..TRIM5)
    Layout
    - LDO: inverter 2 pairs added (CJPTEX_4/5, QW2JRF_4/5), ui[6]/ui[7] risers,
    outputs routed to BGR stubs at x34.5 (TRIM0) / x60.85 (TRIM5)
    - fix_rpm.py FIX list 12 -> 15 (BGR 6-bit resistors)
    - pinout: ui[6]=trim5(MSB), ui[7]=trim0(LSB)
    Verification (post-layout PEX R+C, tt/27C)
    - magic drc(full)+euclidean: rpm.1 15 (all covered by fix_rpm.py)
    - netgen LVS: Circuits match uniquely
    - KLayout feol/beol/offgrid: 0/0/0
    - TT precheck: PASS
    Results (vs 4-bit)
    - trim span 262 -> 2043 mV, LSB 16.4 -> 8.4 mV
    - MC 3sigma 15.220 -> 10.251 mV (margin 2.37x -> 3.51x, N=294)
    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
    [bgr_core.sch, bgr_core_tb2.sch, ldo_top.sch, ldo_top_forsimul.sch, ldo_top_tb.sch, trim_sw.sch]
2026-08-31 docs: 166-point TC sweep, ua[1] loading caveat, MC/TC plots
    - Temperature: replace 3-point interpolation with 1 °C DC sweep
    (125 → −40 °C, 166 pts/corner, forward+reverse cross-checked).
    typ 7.1–8.8 ppm/°C, worst 16.9 (fs). Drift ≤2.33 mV over 0–70 °C.
    fs shows a 2.7 mV step between −40 and −37 °C (slow-PMOS mirror);
    flat above −37 °C at 6.10 ppm/°C.
    - ua[1] (VREF_LOW) is unbuffered: 10 MΩ costs −20.9 mV on the output,
    5 MΩ costs −41.3 mV. Documented as debug-only; measure ua[0] and
    derive V_REF = V_DDC / 1.4936 instead.
    - Corrected measurement steps (previously advised probing ua[1] directly).
    - Added MC and TC plots.
2026-08-31 docs: 166-point TC sweep, ua[1] loading caveat, MC/TC plots
    - Temperature: 1 °C DC sweep (125 → −40 °C, 166 pts/corner, forward and
    reverse cross-checked) replaces the previous 3-point interpolation.
    fs steps 2.7 mV between −40 and −37 °C (slow-PMOS mirror losing drive);
    - ua[1] (VREF_LOW) is unbuffered: a 10 MΩ meter costs −20.9 mV at the
    output, 5 MΩ costs −41.3 mV. Marked debug-only; measure ua[0] and derive
    V_REF = V_DDC / 1.4936 instead.
    - Fixed measurement steps, which previously advised probing ua[1] directly.
    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
2026-08-31 docs: add start-up circuit requirements and verification record (07)
